brahianorrego/Talos-AI/04_VISOR_Y_MOTOR_GRAFICO/unreal/LICENCIAS.md

# Licencias de lo que se use en Unreal (el proyecto DronIA_Cancha NO está en el repositorio)

Todo contenido de Fab o de MetaHuman que se use se anota aquí con su licencia **leída en su ficha**, antes de usarlo.
Nada de eso se sube al repositorio público.

| Contenido | De dónde | Licencia (según su ficha) | Fecha |
|---|---|---|---|
| Formas básicas (cubo, cilindro, plano) | Motor Unreal 5.8 | Licencia del motor (EULA de Epic) | 2026-10-18 |
| Game Animation Sample Project | Fab (Epic Games) | _por anotar al bajarlo_ | |
| MetaHumans (ladrón y civil) | MetaHuman Creator de Unreal | _por anotar: términos de MetaHuman_ | |
| Roads 05 – Scanned Photogrammetry Materials (ScansMatter) | Fab | **CC BY 4.0** (dar crédito) | 2026-10-21 |
| Mobile Trees Pack 44 (Tree Master) | Fab | **CC BY 4.0** (dar crédito); respaldo, sin usar | 2026-10-21 |
| Megaplants: Black Alder y European Hornbeam, Uncut Grass (Quixel) | Fab / Megascans | Licencia estándar de Fab | 2026-10-21 |
| Pack Bonus Textures (Lord Enot Store), HighPoly Tree Model | Fab | por confirmar en la ficha; sin usar | 2026-10-21 |

Créditos listos para el documento: `docs/MATERIAL_PARA_DOCUMENTO/08_creditos_y_licencias_fab.md`.
