brahianorrego/Talos-AI/05_HARDWARE_Y_VARIANTES/VISTA_3D.html

# El pan-tilt de la variante H, casi real

Arrastra para girar, rueda para acercar, Mayús + arrastrar para mover. Las piezas impresas están diseñadas por nosotros (no se descargaron de ningún sitio) y aún no se han impreso. Los servos MG90D, la CSI IMX219 (medidas del dibujo oficial de Raspberry Pi) y el TF-Luna (ficha oficial) son ilustraciones: el cable flex dorado es solo una indicación. La base y su montaje en el dron dependen de medidas pendientes (ver piezas_3d/ESTADO_IMPRESION.md). El deslizador de cabeceo se detiene donde el pin de plástico choca con la ranura (−44° y +14°, regla dura 1) y el de giro donde la plataforma topa con los postes de la base (±89°).
