brahianorrego/Talos-AI/05_HARDWARE_Y_VARIANTES/COBERTURA.md

# Cobertura de las cámaras por variante

Análisis **geométrico** (sin simulación): qué ve cada variante a 3.30 m de altura, dónde queda ciega y qué pasa al mirar detrás de un panel de
2.25 m. Se regenera con `03_SIMULACION_RL\.venv\Scripts\python.exe analisis_cobertura.py` (lee los `config_sim/variante_*.json`). El campo
del IMX219 (62.2° × 48.8°) es **nominal, sin medir**; las alturas de cabeza (1.62 m) y torso (1.25 m) de una persona de 1.72 m son **estimadas**.

## Combinación de sensores a 1.7–2.6 m (21-oct; pedido de Brahian, `ORDENES_BRAHIAN_20OCT.md` §A y §E)

Dron a 1.7, 2.0, 2.6 y 3.30 m; persona de 1.72 m (torso a 1.25 m, estimado). Cámaras IMX219 62.2° × 48.8° (nominal); TF03 a −5° con haz de 0.5° (de memoria; alcance 30 m).

| Altura | Cámara del pan-tilt (tilt −45°): ciega bajo el dron hasta (suelo / torso) | CSI#2 **al piso**: huella en el suelo / a la altura del torso | CSI#2 **atrás −15°** (lado largo horizontal): ve el torso desde / el suelo desde | CSI#2 abajo-atrás −45°: torso entre / suelo entre | TF03 −5°: da en una persona de pie desde (cabeza / torso) y en un panel de 2.25 m desde |
|---|---|---|---|---|---|
| **1.7 m** | 0.64 m / 0.17 m | 2.1 × 1.5 m / 0.5 × 0.4 m | 0.55 m / 2.1 m | 0.1–1.8 m / 0.4–6.9 m | 0 m / 5.1 m · panel 0 m |
| **2.0 m** | 0.75 m / 0.28 m | 2.4 × 1.8 m / 0.9 × 0.7 m | 0.91 m / 2.4 m | 0.2–3.0 m / 0.5–8.1 m | 3.2 m / 8.6 m · panel 0 m |
| **2.6 m** | 0.98 m / 0.51 m | 3.1 × 2.4 m / 1.6 × 1.2 m | 1.6 m / 3.2 m | 0.3–5.5 m / 0.6–10.5 m | 10.1 m / 15.4 m · panel 4.0 m |
| **3.30 m** | 1.24 m / 0.77 m | 4.0 × 3.0 m / 2.5 × 1.9 m | 2.5 m / 4.0 m | 0.5–8.3 m / 0.8–13.3 m | 18.1 m / 23.4 m · panel 12 m |

- **Azimut:** el pan-tilt (±89° + 31.1°) cubre **240°** y deja **120°** atrás sin ver. Una CSI#2 **atrás** suma 62° y deja **57° ciegos** (dos cuñas de 29°, a ±150°); abajo-atrás o al piso no suman casi nada en azimut.
- **CSI#2 al piso sirve poco a esta altura:** a 2.0 m el torso solo cae en una huella de 0.9 × 0.7 m; solo protege lo que está justo debajo.
- **TF03 a −5° y 2.0 m no da en la persona hasta los 3.2 m** (antes el haz pasa sobre la cabeza); a 2.6 m, hasta los 10 m. Con paneles de 2.25 m **sí da** desde 0 m a 2.0 m. El frenado LiDAR (< 3 m) **no protege de personas** a 2.6 m: lo cubre la cámara y el árbitro.
- **TF-Luna** en el pan-tilt, siguiendo al ladrón a 4–6 m: con ropa clara (ρ≈0.5) ve hasta 6 m, **media** (ρ≈0.3) hasta 4.6 m, **oscura** (ρ≈0.1) solo hasta 2.7 m (interpolación mía sobre dos datos de hoja de datos). **No es fiable como única distancia**: la principal es la de la caja de YOLO + Kalman; el Luna confirma cuando hay retorno.

**Recomendación (una combinación):** **CSI#1 + TF-Luna en el pan-tilt; CSI#2 fija MIRANDO ATRÁS** (pitch −15°, lado largo horizontal, bajo la placa trasera); **TF03 frontal fijo a −5°**; volar a **2.0 m** de base (sube a 3.30 m solo con el ladrón cerca). Razones con números: cubre **302° de azimut** (contra 240°) con una cámara que a 2.0 m ve el torso desde 0.9 m; la del piso a 2.0 m ve 0.9 × 0.7 m y el pan-tilt ya cubre el suelo desde 0.75 m. El TF03 queda para paneles y obstáculos grandes (los ve desde 0 m a 2.0 m).
Posición provisional (sin medir) en `variante_H.json`: `CAM_TRASERA_ACTIVA`, `CAM_TRASERA_PITCH` (−15°), `CAM_TRASERA_AZIMUT` (180°), `CAM_TRASERA_PUERTO` (CAM1), `MONTAJE_CSI2_TRASERA_M` (−0.095, 0, −0.030 m); `CAM_PISO_ACTIVA` queda en `false`. **Riesgo:** una cámara que mira atrás ve patas, brazos y quizá hélices: probar el encuadre al montarla.

## Lo que dice, en sencillo (actualizado 2026-10-20, D-072)

**Hoy el dron es la variante G** (CSI fija a −5° + TF03 fijo, sin gimbal ni USB) **y la meta es la H** (pan-tilt con CSI + TF-Luna, TF03 fijo, segunda CSI al
piso). Las variantes A–F **quedaron descartadas** (usaban el gimbal o la USB) y se dejan solo como referencia.

**Actualización 2026-10-20 (pan libre):** la variante H mueve el **giro (pan) ±89°** y el cabeceo; el alabeo no existe. Cobertura horizontal y tiempo de apuntar:

| | **G (mínimo, fija)** | **H (plus, pan ±89°)** |
|---|---|---|
| Campo horizontal de la cámara (CSI) | 62.2° (nominal) | 62.2° |
| **Cobertura horizontal total** respecto a la nariz | ±31.1° = **62.2°** | ±(89 + 31.1)° = **±120.1° ≈ 240°** (queda ciega la parte de atrás, ≈ 120°) |
| Tiempo en apuntar a un objetivo a 90° de la nariz, **girando el dron** (`RATE_Y_MAX` = 120 °/s, `ATC_ACCEL_Y_MAX` = 180 °/s², de `control.py`) | ≈ 1.4 s (40° acelerando + 10° a velocidad + 40° frenando) | ≈ 1.4 s si solo gira el dron |
| Tiempo con **el pan** (servo ≈ 600 °/s, retardo 50–100 ms; est.) | — | **≈ 0.2–0.25 s**: unas 6 veces más rápido |

Lo que gana H al girar: puede **seguir a la persona sin girar el cuerpo del dron** (el dron puede seguir volando de frente o por su ruta) y **mirar de lado a los lados del panel** mientras avanza; el TF-Luna va con la cámara.
**Lo que no sabemos aún:** si las hélices, las antenas, las patas o la batería entran en el cuadro a pan grande (depende del montaje; ver `ESTADO_IMPRESION.md`), y el retardo real del servo. Con **pan 0° y tilt −5°** la cámara repite la orientación de G (el mínimo).

1. **G (hoy): anillo ciego.** Con la CSI fija a −5° (62.2° × 48.8° nominal), la cabeza de una persona de 1.72 m se ve **desde ~3.0 m** hacia afuera y el
   suelo **desde ~5.9 m**: una persona que se acerca a menos de 3 m sale del cuadro, y nada ve lo que hay debajo del dron.
2. **H (meta): sin anillo ciego.** La CSI en el pan-tilt baja hasta −45°: con el tilt libre ve la cabeza desde ~0.6 m hasta más de 15 m, y la segunda CSI al piso
   (−90°) cubre lo de justo debajo. Con el tilt fijo en −45° solo ve de 0 a 4.5 m: hay que ir cambiando el cabeceo según la distancia (para eso es el pan-tilt).
3. **Lo que sale del campo más ancho de la CSI** (62.2° × 48.8° contra 38.9° × 29.7° de la USB): se ve más de lado y más de arriba abajo, pero con menos
   píxeles por grado (el YOLO ve más chica a la persona lejana).
4. **Detrás del panel (2.25 m) desde 3.30 m:** de pie queda oculta de 2.4 a 3.0 m detrás, agachada de 4.4 a 5.5 m, gateando de 6.3 a 7.9 m (paneles a 4–5 m): lo
   decide la maniobra del dron, no las cámaras.

Las figuras `cobertura/cobertura_variante_G.png` y `_H.png` son las que importan; `_A` a `_F` son de las variantes descartadas.

Supuestos: dron a **3.3 m**; persona de pie de **1.72 m** (cabeza = centro a 1.62 m y torso = centro a 1.25 m: **estimados**); cámaras en el centro del dron; pitch táctico −45° donde el gimbal lo permite (A y B: −10°, el tope real de hoy); solo plano vertical (se ignora que el objetivo esté fuera del campo horizontal). Campos: USB HFOV 38.9° × VFOV 29.7° (medido); IMX219 62.2° × 48.8° (**nominal, sin medir**), con su lado largo a lo largo del vuelo.

### Tabla de cobertura vertical (distancias horizontales a las que alguna cámara ve el punto)

«Pitch fijo» = la cámara principal quieta en su pitch táctico. «Gimbal libre» = la cámara principal puede tomar cualquier pitch entre su tope bajo y +15° (lo que hace el seguimiento). La diferencia más importante entre variantes es **la distancia mínima**: con el tope bajo, A/B no ven la cabeza a menos de ~3.6 m y C-F sí desde ~1 m.

| Var. | Cámaras | Cabeza: pitch fijo | Cabeza: gimbal libre | Torso: gimbal libre | Suelo: ciego hasta |
|---|---|---|---|---|---|
| **A** | Principal USB (-10°) | 3.6–más de 15 m | 3.6–más de 15 m | 4.4–más de 15 m | 7.1 m |
| **B** | Principal USB (-10°) + Piso CSI (-90°) | 0.0–1.0 m; 3.6–más de 15 m | 0.0–1.0 m; 3.6–más de 15 m | 0.0–1.2 m; 4.4–más de 15 m | 0.0 m |
| **C** | Principal USB (-45°) + Piso CSI (-90°) | 0.0–2.9 m | 0.0–más de 15 m | 0.0–más de 15 m | 0.0 m |
| **D** | Principal USB (-45°) + Piso CSI (-90°) | 0.0–2.9 m | 0.0–más de 15 m | 0.0–más de 15 m | 0.0 m |
| **E** | Principal USB (-45°) + Piso CSI (-90°) | 0.0–2.9 m | 0.0–más de 15 m | 0.0–más de 15 m | 0.0 m |
| **F** | Principal USB (-45°) + Piso CSI (-90°) + Frontal ancha CSI (0°) | 0.0–2.9 m; 3.7–más de 15 m | 0.0–más de 15 m | 0.0–más de 15 m | 0.0 m |
| **G** | Principal CSI (-5°) | 3.0–más de 15 m | 3.0–más de 15 m | 3.6–más de 15 m | 5.9 m |
| **H** | Principal CSI (-45°) | 0.6–4.5 m | 0.6–más de 15 m | 0.8–más de 15 m | 1.2 m |

### Cámara al piso: huella a 3.30 m

- A la altura del suelo: ±1.99 m a lo largo del vuelo y ±1.50 m de lado (huella 3.98 × 2.99 m).
- A la altura del cabeza: ±1.01 m a lo largo del vuelo y ±0.76 m de lado (huella 2.03 × 1.52 m).
- A la altura del torso: ±1.24 m a lo largo del vuelo y ±0.93 m de lado (huella 2.47 × 1.86 m).

### Ancho lateral que ve la cámara principal (campo horizontal 38.9°)

- Pitch -45°, mirando al cabeza en el eje: distancia en línea recta 2.38 m → ancho 1.68 m.
- Pitch -45°, mirando al torso en el eje: distancia en línea recta 2.90 m → ancho 2.05 m.
- Pitch -10°, mirando al cabeza en el eje: distancia en línea recta 9.67 m → ancho 6.83 m.
- Pitch -10°, mirando al torso en el eje: distancia en línea recta 11.81 m → ancho 8.34 m.

### Mirar detrás de un panel de 2.25 m desde 3.30 m

Línea de vista desde la cámara que roza el borde de arriba del panel: hasta qué distancia DETRÁS del panel queda oculto cada punto.

| Postura (altura del punto) | Panel a 4 m | Panel a 5 m |
|---|---|---|
| De pie, cabeza (1.62 m) | 2.4 m | 3.0 m |
| De pie, torso (1.25 m) | 3.8 m | 4.8 m |
| Agachado (1.1 m) | 4.4 m | 5.5 m |
| Gateando (0.6 m) | 6.3 m | 7.9 m |

Para ver a alguien oculto hay que acercarse o subir; subir ya está permitido solo sin personas a menos de 8 m (altura segura 3.30 m).

## Panel de 2.25 m

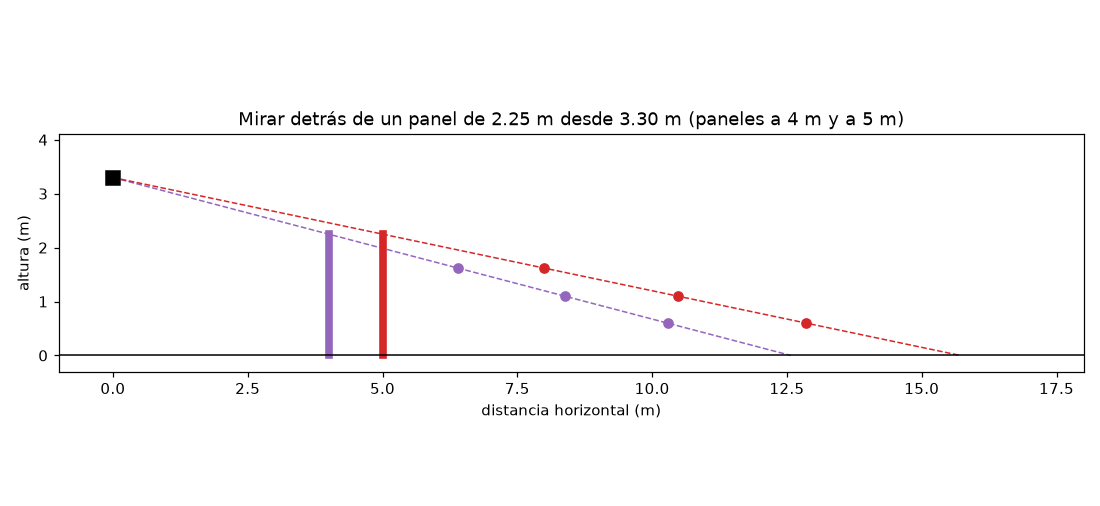
[picture p27: 05_HARDWARE_Y_VARIANTES/cobertura/panel_sombra.png]
Sombra del panel


## Figuras por variante

### Variante G

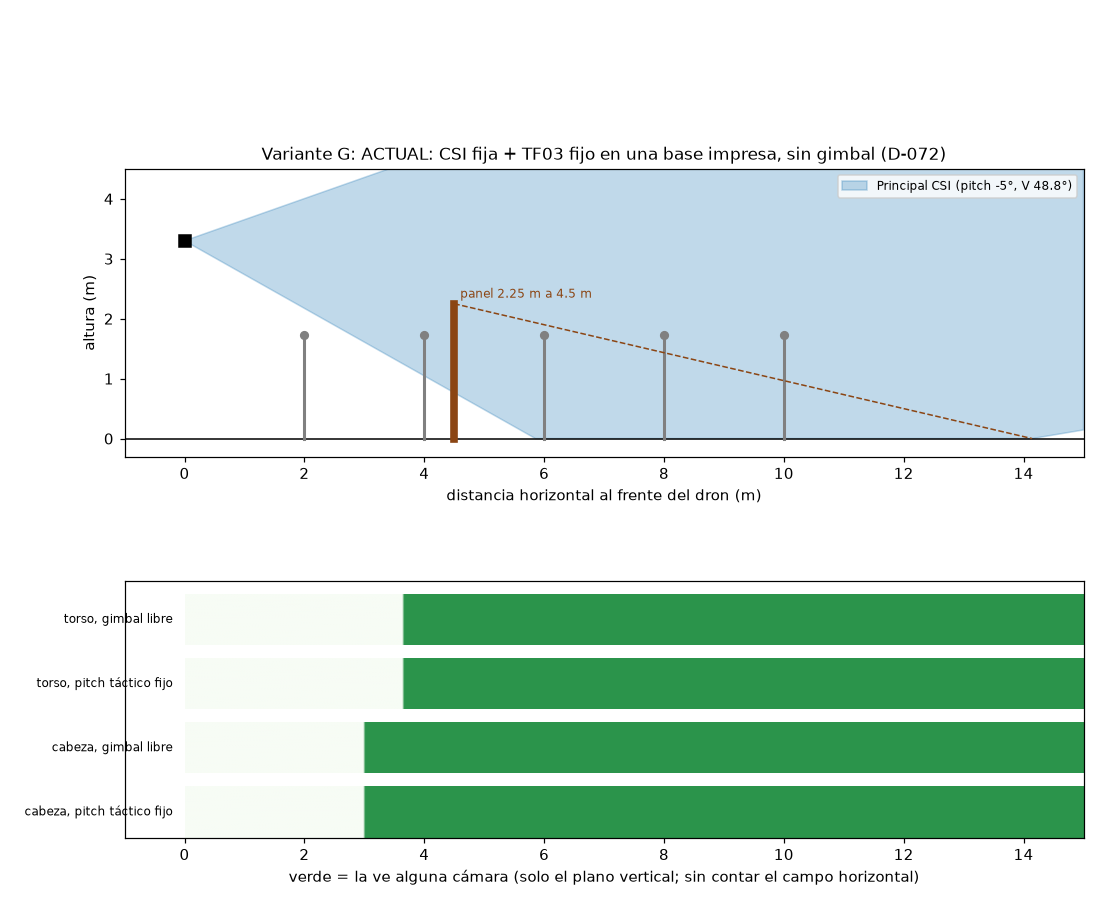
[picture p28: 05_HARDWARE_Y_VARIANTES/cobertura/cobertura_variante_G.png]
Variante G


### Variante H

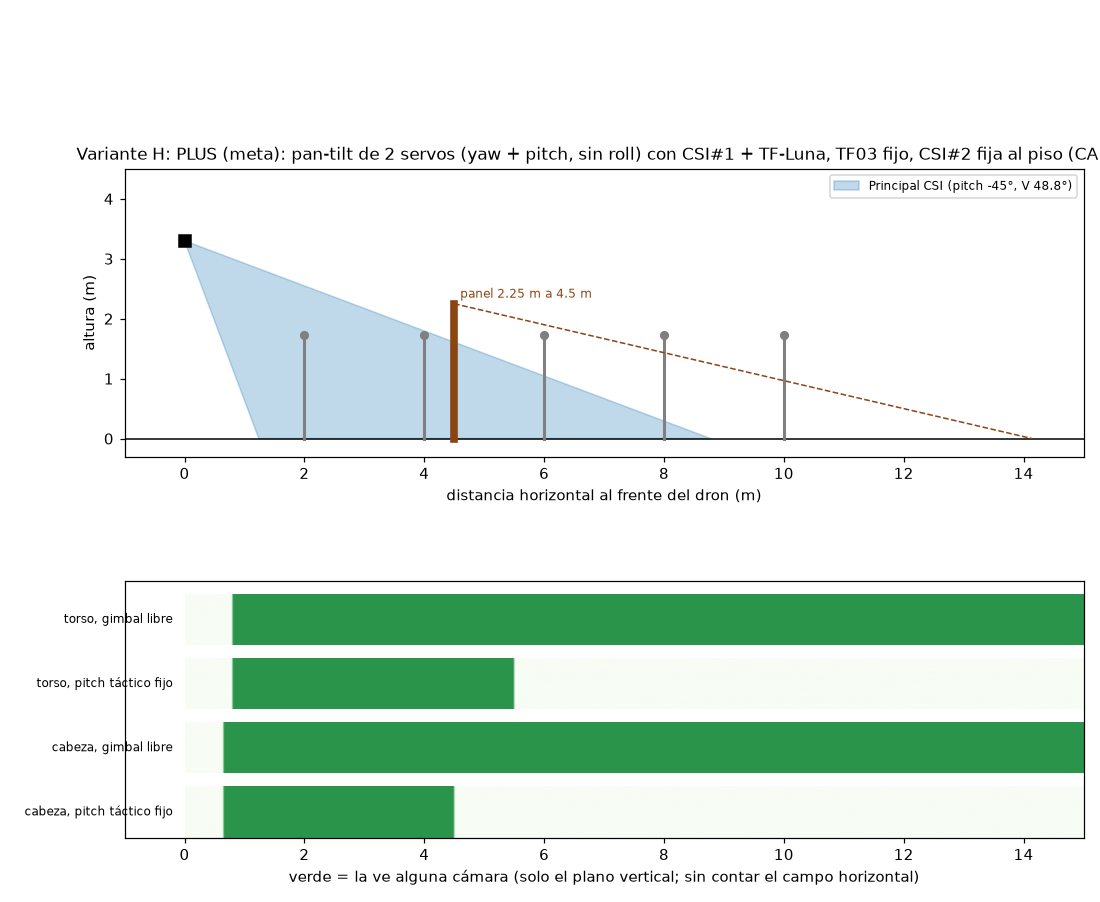
[picture p29: 05_HARDWARE_Y_VARIANTES/cobertura/cobertura_variante_H.png]
Variante H


### Variante A (descartada)

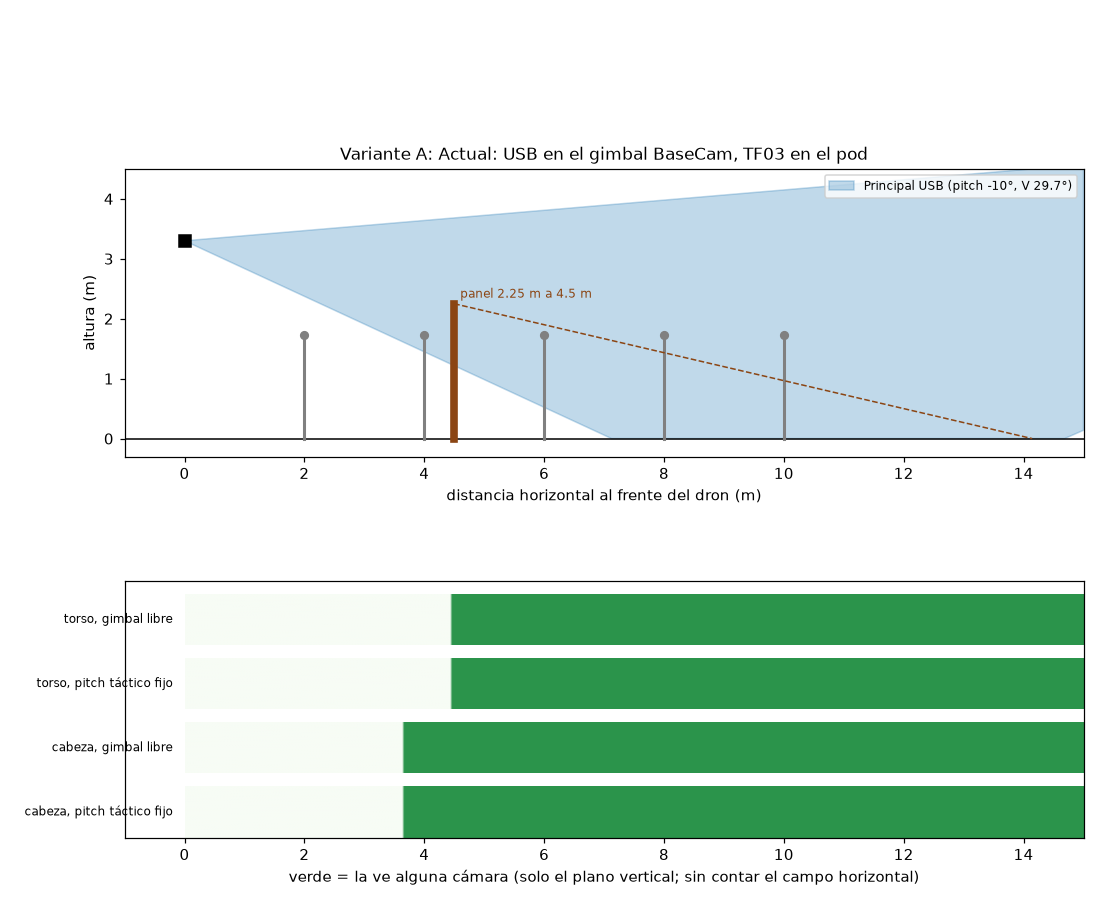
[picture p30: 05_HARDWARE_Y_VARIANTES/cobertura/cobertura_variante_A.png]
Variante A


### Variante B (descartada)

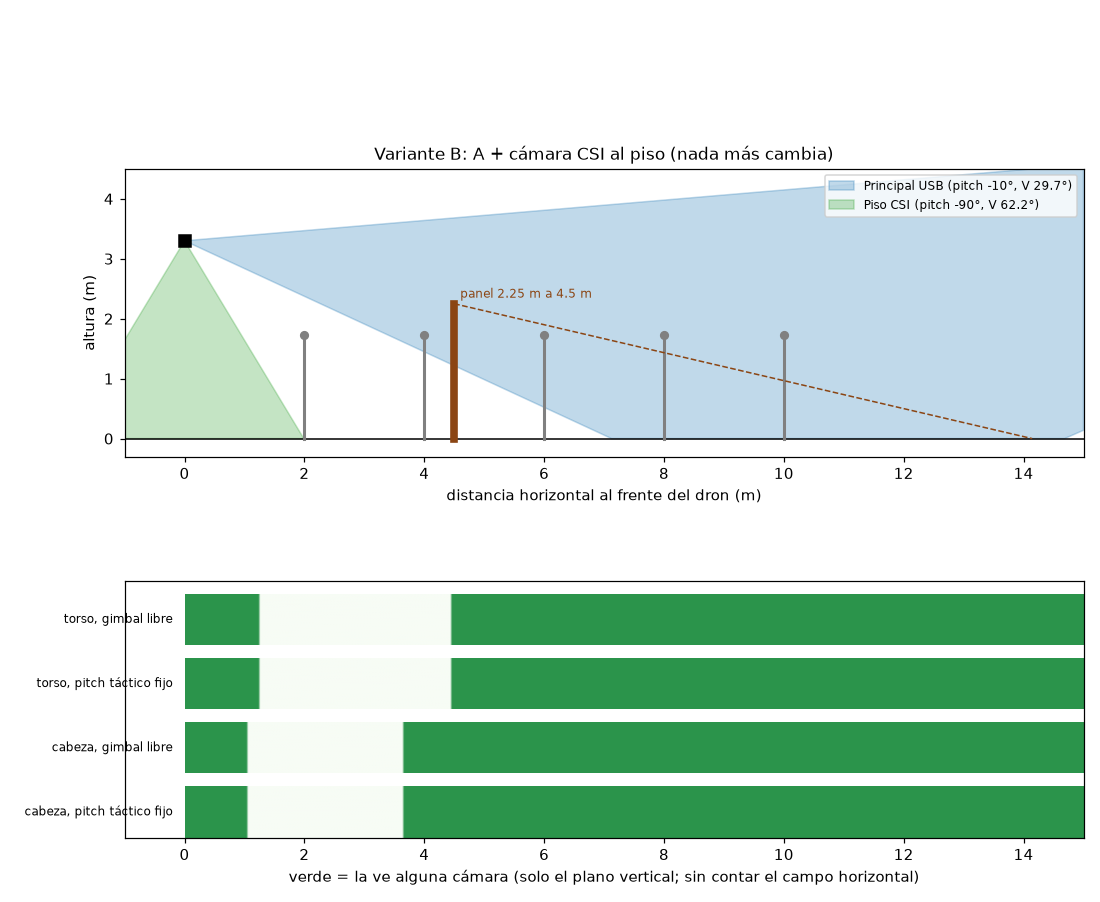
[picture p31: 05_HARDWARE_Y_VARIANTES/cobertura/cobertura_variante_B.png]
Variante B


### Variante C (descartada)

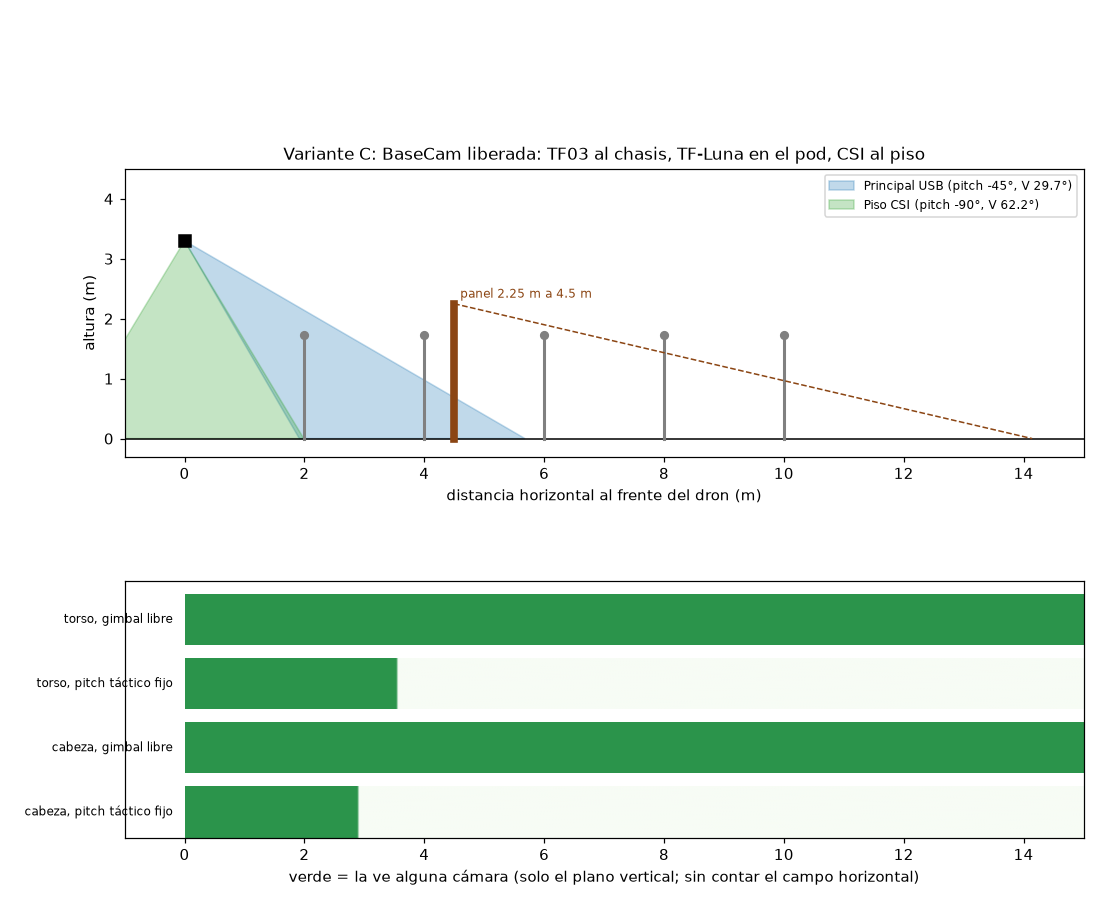
[picture p32: 05_HARDWARE_Y_VARIANTES/cobertura/cobertura_variante_C.png]
Variante C


### Variante D (descartada)

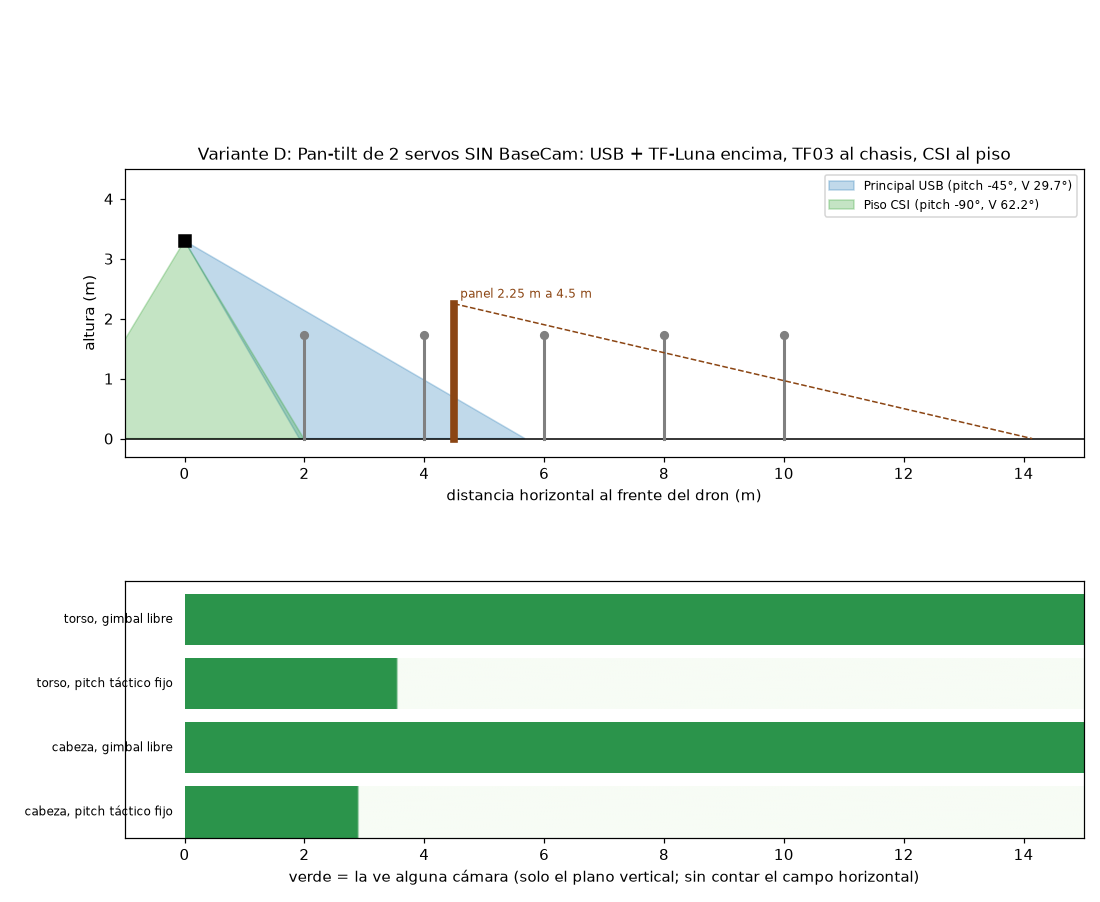
[picture p33: 05_HARDWARE_Y_VARIANTES/cobertura/cobertura_variante_D.png]
Variante D


### Variante E (descartada)

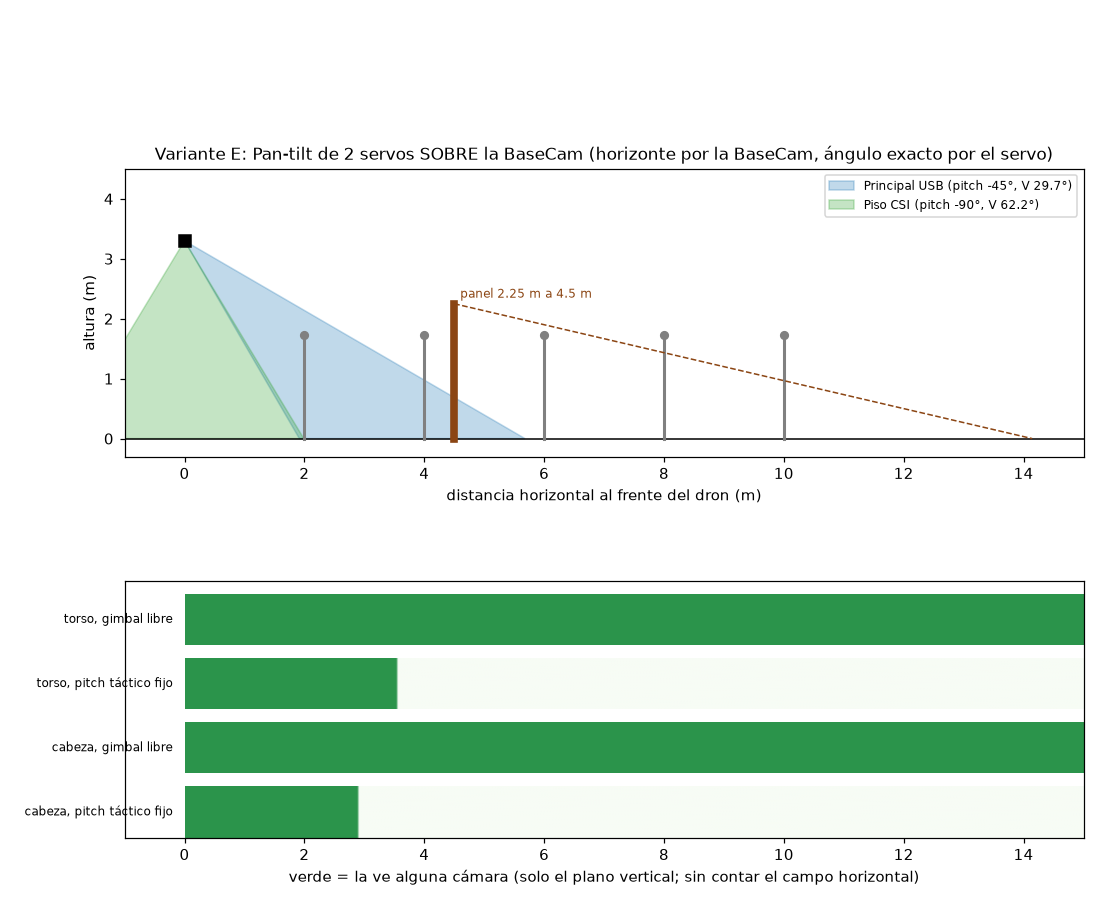
[picture p34: 05_HARDWARE_Y_VARIANTES/cobertura/cobertura_variante_E.png]
Variante E


### Variante F (descartada)

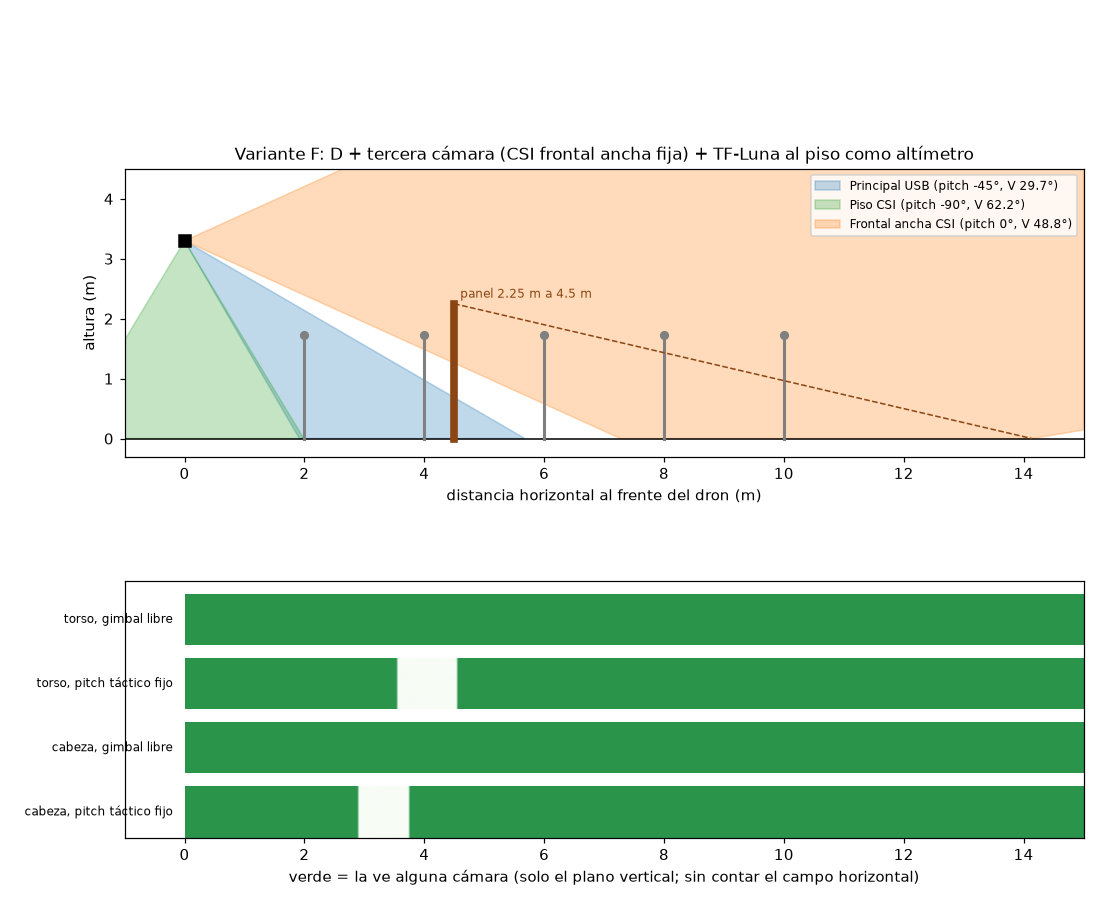
[picture p35: 05_HARDWARE_Y_VARIANTES/cobertura/cobertura_variante_F.png]
Variante F


## Lo que NO cubre este análisis

El campo horizontal, el desplazamiento de las cámaras respecto al centro del dron, el balanceo y el cabeceo del chasis, la oclusión por patas o hélices, el ruido y el desenfoque, ni el tiempo que tarda el pan-tilt en llegar al cabeceo (~600°/s el servo). Es el techo geométrico, no un resultado de vuelo.
