brahianorrego/Talos-AI/04_VISOR_Y_MOTOR_GRAFICO/_LEEME.md

# 04 · Visor y motor gráfico

**El visor que funciona hoy no está aquí:** es `03_SIMULACION_RL/index.html` (three.js) y se abre con
`03_SIMULACION_RL/ABRIR_VISOR.bat` en http://127.0.0.1:8765/. Se queda en la 03 porque lee
`salida/estado.json`, `salida/hitos/` y `minimo_tesis/replay/` por ruta relativa desde el mismo servidor.

| Qué | Dónde |
|---|---|
| **Plan del motor gráfico y de la interfaz de 3 modos** (Fase D1-D2) | `PLAN_MOTOR_GRAFICO.md` |
| Boceto de la estación de tierra | `boceto_interfaz.svg` (y `.png`) |
| Cuadros por segundo del visor V16 en el portátil, capturas y el script que mide | `mediciones/` |
| Visor V16 traído de las ramas `v16-visor` y `v16-simulacion` (en `main` desde el commit 3c38f66, aprobado por Brahian el 17-oct) | `v16/` (configuración `visor-v16` de `.claude/launch.json`, puerto 8766) |
| Visor vigente | `03_SIMULACION_RL/index.html` |
| Versiones anteriores (v4 a v19) | `_archivo_versiones/codigo/index_v*.html` |
| Visor de la cámara real (en la Jetson) | `02_JETSON_A_BORDO/visor_web.py` |
| Contrato de datos simulación → visor (`foto()`) | `docs/PLAN_V16_REALISMO.md` (fase A5) y `v16/docs/PROGRESO_V16.md` |

Para ver el V16 con la RTX: Chrome tiene que usar la gráfica NVIDIA (ver `PLAN_MOTOR_GRAFICO.md`, sección 2).

## Revisión de `v16/` para el repositorio público (2026-10-17)

Sin fotos de personas: las personas, el dron, los árboles y los escenarios se dibujan con código. No se carga nada de
internet (todo es local). Archivos que no son código:

| Archivo | Origen | Licencia |
|---|---|---|
| `recursos/three/` (three.js 0.185.1) | npm `three` | MIT (`recursos/three/LICENSE`) |
| `recursos/cielo/spruit_sunrise_1k.hdr`, `quarry_01_1k.hdr` | Poly Haven (Greg Zaal) | CC0 |
| `recursos/texturas/*.jpg` (12: concreto, pasto, tierra) | Generadas con ruido fractal por `herramientas/generar_texturas.py` | Propias (CC0) |
| `replays_prueba/*.json` | Repeticiones de prueba de la V16; llevan el nombre de Brahian como autor | Propias |

Fuente: `v16/simulacion/recursos/LICENCIAS.md`. El script que hizo las texturas está en `v16/simulacion/herramientas/generar_texturas.py`.

## Cancha V17 en el visor (D-057, 2026-10-17)

En `v16/`, escenario **"Vista previa · cancha V17, dos V de 90° (no entrenado)"** (`visor/previa.js`, `crearCancha`):
cancha de fútbol con líneas y arcos (90 × 60 m, **medidas por medir**), zona de IA de 30 × 30 m en el centro de la mitad
este (geocerca roja en la vista externa y en el mapa pequeño), dos V de 90° de paneles de exposición de 1.5 × 2.25 m (D-066; antes 1.0 × 2.0) con
bolsas de arena, vértices a 10 m (V1 abre al sur, V2 al norte) y árboles fuera de la cancha (≥ 10 m de la geocerca).
Escena de ejemplo: el ladrón agachado detrás de V1 se cambia a V2 y el civil cruza a 8 m. Fuente: `docs/PLAN_V17_REFUERZO.md`
§3.3 y D-051. Medido con la RTX: 144 cps y sin errores (`mediciones/medir_fps.mjs cancha`). Capturas:
`mediciones/capturas/v17_cancha_*.jpg`. Las fases de la misión (tránsito → CH7 → zona) y el estado "IA activada" esperan
los campos nuevos de `foto()` de la Simulación V17.

## Blender instalado (D-057, 2026-10-17)

- **Versión:** Blender 5.2.2 LTS (compilación d13f752e3b9c, 2026-09-15), Python 3.13.13 por dentro, importador FBX activo.
- **De dónde:** `download.blender.org/release/Blender5.2/blender-5.2.2-windows-x64.zip` (404 MB), versión portable
  (no pide administrador).
- **SHA256:** `3849d17a682cba006075aaa3f3597ecb5c9c30ec31035b2e092c53e40679b535`, igual al publicado en
  `blender-5.2.2.sha256` de la misma página.
- **Dónde quedó:** en la carpeta `Programas\Blender` del usuario (fuera del repositorio, 925 MB). Se abre con
  `blender.exe`; en consola: `blender.exe --background --version`.
- **Gráfica:** Cycles ve la RTX 3050 por OptiX y por CUDA (para renderizar el video con la tarjeta).

## Paquetes de Quaternius (CC0), bajados el 2026-10-17 con permiso de Brahian

Fuera del repositorio, en la carpeta `Programas\recursos_quaternius` del usuario (≈ 375 MB descomprimidos). Bajados de
la página oficial de cada paquete en `quaternius.itch.io` (versión gratis "Standard", sin cuenta). Cada uno trae su
licencia: **CC0 1.0** (dominio público). Se pueden usar y subir al repositorio, pero se dejan fuera por tamaño.

| Paquete | Qué trae (versión gratis) |
|---|---|
| Universal Base Characters | 2 cuerpos (hombre y mujer) con esqueleto de 65 huesos, 6 peinados, cejas; **sin ropa** (en ropa interior) |
| Universal Animation Library 1 | 43 animaciones: `Idle_Loop`, `Walk_Loop`, `Jog_Fwd_Loop`, `Sprint_Loop`, `Crouch_Idle_Loop`, `Crouch_Fwd_Loop`, `Jump_Start/Loop/Land`, `Roll`, `Interact`… |
| Universal Animation Library 2 | 43 más: `Idle_TalkingPhone_Loop`, `LayToIdle` (de acostado a de pie), `ClimbUp_1m`, `NinjaJump_*`, `Slide_*`, `Idle_FoldArms_Loop`, `Idle_Rail_Loop`… |
| Stylized Nature MegaKit | 68 modelos: árboles, arbustos, flores, piedras, pasto (glTF, FBX, OBJ) |

Todo usa el **mismo esqueleto**: las animaciones se ponen directo en los personajes (comprobado en Blender con
`blender/listar_anim.py`). Prueba de render con la RTX (Cycles + OptiX, 1280 × 720, 64 muestras, ~12 s en total):
`blender/prueba_render.py` → `mediciones/capturas/blender_prueba_quaternius.jpg`.

**Qué falta para las animaciones de la sección 4 de `PLAN_MOTOR_GRAFICO.md`:** gatear, recostarse contra el panel,
rendirse (manos arriba) y grabar con el celular no vienen en la versión gratis (hay parecidas: `LayToIdle`,
`Idle_Rail_Loop`, `Idle_TalkingPhone_Loop`); se arman con código sobre los mismos huesos. **Falta ropa:** sugerencia,
el paquete gratis CC0 "Ultimate Modular Characters" de Quaternius (personas vestidas); no se bajó porque no estaba en
lo autorizado.

### Personas vestidas: Ultimate Modular Characters (CC0, bajado el 2026-10-17 con permiso de Brahian)

- **De dónde:** carpeta pública de Google Drive que enlaza la página oficial `quaternius.com/packs/ultimatemodularcharacters.html`;
  licencia CC0 1.0 (`License.txt`). Se bajaron los 11 personajes en glTF (Adventurer, Beach, Casual_2, Casual_Hoodie,
  Farmer, King, Punk, Spacesuit, Suit, Swat, Worker; 35 MB) a `recursos_quaternius\ultimate-modular-characters\`.
- **Traen 24 animaciones propias** (Idle, Walk, Run, Roll, Wave, Interact…), pero **otro esqueleto** (62 huesos, piernas
  con IK) que no coincide con el de la Universal Animation Library (1 hueso en común).
- **Redirección:** `blender/redirigir_animaciones.py` pasa las animaciones de la librería a estos personajes (giro de cada
  hueso en el mundo × la diferencia entre las poses de referencia; IK apagado). Ya están pasadas **41**: 23 de la UAL1 en
  `recursos_quaternius\animaciones_UMC_UAL1.blend` y 18 de la UAL2 en `animaciones_UMC_UAL2.blend` (terminan en `_UMC`).
  Unos 10 s por librería.
- **Prueba:** `blender/prueba_vestidos.py` → `mediciones/capturas/blender_prueba_vestidos.jpg` (correr, agachado junto
  al panel, salto). Revisado a ojo en un cuadro; falta ver las animaciones en movimiento (pies que patinan, manos).

Nota: `descarga.zip` (15.9 MB), que apareció en la raíz del proyecto el 17-oct a las 9:04, era una copia repetida de la
Universal Animation Library [Standard]. La bajó el navegador interno cuando se probó el botón "Download" de itch.io. Se
movió a `recursos_quaternius\_duplicados\` (no se borró) y no entró a Git.

## V2 · Personas vestidas en el visor (2026-10-17)

- `v16/simulacion/visor/personas_gltf.js` (`FiguraGLTF`): misma interfaz que `Humano`, con los modelos y animaciones de
  `v16/simulacion/recursos/personas/` (4.4 MB, CC0; los exporta `blender/exportar_personas_glb.py`). El ladrón es
  `Casual_Hoodie`; los civiles, `Worker`, `Casual_2`, `Suit` y `Farmer` según su ID.
- Animación según la postura de `foto()`: de pie (quieto, caminar, trotar, correr, acelerando con la velocidad),
  agachado (quieto o avanzando), recostado (brazos cruzados), salto (impulso, aire, caída) y civil grabando (celular).
  **Gatear usa por ahora la marcha agachada** (no hay animación de gateo gratis).
- Para ver las figuras de antes (hechas con código): `http://127.0.0.1:8766/?personas=codigo`.
- Medido con la RTX en la cancha V17: 126 cps (con el render de Blender usando la misma tarjeta), sin errores; las cajas
  de YOLO se ajustan a las personas nuevas.

## V6 · Video de la cancha V17 en Blender (2026-10-17)

- `blender/video_cancha_v17.py` arma la escena (cancha, V de 90°, árboles, arbustos y matas de pasto de Quaternius,
  dron, ladrón y civil con la coreografía de la vista previa "cancha") y renderiza con Cycles en la RTX, cuadro por cuadro
  (si se corta, se relanza y sigue). `blender/unir_video.py` une los cuadros en MP4.
- Medido: ~28 s por cuadro a 1920 × 1080 con 32 muestras (el video completo de 80 s serían ~15 h). Se renderiza el
  tramo de 20 a 60 s a 1280 × 720 (~3-4 h), fuera del repositorio, en la carpeta `Videos\dron_ia` del usuario.

## V4 · Interfaz de 3 modos (2026-10-17)

Pestañas arriba a la derecha (o teclas **1**, **2** y **3**; la **I** abre y cierra ingeniería), y el modo elegido se
recuerda. Boceto: `boceto_interfaz.svg`. Capturas: `mediciones/capturas/v4_modo_*.jpg`.

| Modo | Qué muestra |
|---|---|
| **1 Dron** | Cámara del dron con YOLO, cámara al piso, espacio para la cámara USB (solo si la variante la lleva), **mapa de puntos del LiDAR** (impactos del TF03 en naranja y del TF-Luna en azul, acumulados; los viejos se apagan) y **órdenes de la Jetson**: quién manda, vx/vy/vz, giro, gimbal en grados y en PWM de AUX1, altura pedida, modo de ArduPilot y 10 s de historial (`visor/vista_dron.js`) |
| **2 Tierra** | La estación del operador, como antes: cámara grande con el clic de confirmación, vista externa, cámara al piso, mapa y telemetría |
| **3 Ingeniería** | Vista externa grande con el panel de estados, árbitro, personas, recompensa y bitácora |
| **clásico ↗** | Abre el visor de siempre (`03_SIMULACION_RL`, en el puerto 8765 con `ABRIR_VISOR.bat`) |

**Pendiente de la simulación:** las repeticiones no traen la nube de puntos ni las órdenes. La nube se arma acumulando
`lh`/`luna`, y las órdenes se **aproximan con la telemetría**, y así lo dice la pantalla. Cuando `foto()` traiga `cmd`
y `arb` (encargo a Simulación V17), `vista_dron.js` ya usa `cmd` sin más cambios. Medido con la RTX: 73-85 cps en la
partida `sim_v16_semilla3` a 4× (con el render de Blender en la misma tarjeta), sin errores.

## V3 · Árboles y pasto de verdad en el visor (2026-10-17)

- `v16/simulacion/visor/naturaleza.js`: los árboles hechos con código (misión, campo y cancha) se cambian por 4 árboles
  del "Stylized Nature MegaKit" de Quaternius (CC0) en las mismas posiciones, y se siembran 22 000 matas de pasto en
  60 × 60 m alrededor de la zona. Todo con instancias. Recursos: `v16/simulacion/recursos/naturaleza/` (2 MB).
- Para ver los árboles de antes: `?naturaleza=codigo`.
- **Medido con la RTX, sin tope de pantalla** (misión de prueba, 1540 × 788): alta 134 cps, media 184, baja 258; cancha
  V17 con tope: 128 cps. Meta ≥ 60: cumplida. Sin errores. Capturas: `mediciones/capturas/v3_*.jpg`.
- Se probó el arbusto `Bush_Common` y se quitó: su textura es de hojas rojas de otoño.
- Shortcut: los árboles nuevos no tapan a las personas en la prueba de visibilidad de la vista previa (sería muy lenta con
  hojas detalladas); si hiciera falta, usar cilindros simples para esa prueba.

## V5 · Simulación en vivo (2026-10-17)

- **Cómo verla:** doble clic en `ABRIR_EN_VIVO.bat` (abre la simulación, el visor y Chrome en `?r=vivo`). O a mano:
  `03_SIMULACION_RL\.venv\Scripts\python.exe 04_VISOR_Y_MOTOR_GRAFICO\en_vivo.py` y, en el visor, la repetición
  "Simulación en vivo".
- `en_vivo.py` corre una partida del entorno de `03_SIMULACION_RL` (solo lo importa, no lo cambia) a tiempo real y manda
  cada `foto()` al navegador apenas ocurre (Server-Sent Events, solo biblioteca estándar, puerto 8767). Al terminar
  una partida empieza otra con la semilla siguiente. Opciones: `--nivel` (por defecto el de la V17), `--semilla`,
  `--velocidad` y `--politica modelos/dron_politica.json` (si no, acción 0: deciden las reglas). Mientras no haya una
  política V17 entrenada, lo honesto es mostrar las reglas.
- En el visor (`datos.js` → `conectarVivo`, `principal.js`), la partida crece con cada cuadro y la imagen va un cuadro
  detrás del último. Probado: 126 cps con la RTX, sin errores; la pestaña "1 Dron" muestra `cmd` y `arb` reales.
  Captura: `mediciones/capturas/v5_en_vivo_dron.jpg`.

## Regla dura 4 en la pantalla (revisión del Arquitecto, punto 9; 2026-10-17)

Debajo de la caja de YOLO del candidato se lee quién decide: **"Esperando confirmación del operador"** (amarillo), **"¿Es
el sospechoso? clic aquí"** cuando la repetición espera el clic, y **"Confirmado por el operador"** (verde) después; si el
clic lo dio el operador simulado (modo automático o en vivo), dice **"(simulado)"**. La IA nunca aparece como quien
confirma. Captura: `mediciones/capturas/regla4_esperando_operador.jpg`.

## D-065 · El visor web vuelve al aspecto de la V16 (2026-10-17)

Brahian rechazó el aspecto de Quaternius. **Por defecto** el visor usa otra vez las personas, los árboles y el cielo de la
V16. Quaternius quedó como opción apagada, sin borrar nada: `?personas=quaternius` y `?naturaleza=quaternius`. El mundo
realista pasa a Unreal Engine 5 (`PLAN_UNREAL.md`).

## D-065 · Estación de tierra con paneles movibles (2026-10-17)

Es la interfaz que irá en la Jetson. **Se abre con `ABRIR_EN_VIVO.bat`**: arranca la simulación en vivo (8767), el
servidor de la estación (8768) y Chrome en http://127.0.0.1:8768/.

- **Base:** una copia del visor clásico (`03_SIMULACION_RL/index.html`, que no se tocó) en `estacion/index.html`, con
  todas sus pantallas: telemetría, estados de búsqueda, mapa SLAM, objetivo/tracker, decisión, árbitro, cámara FPV con
  HUD y YOLO, entrada de control, osciloscopio de entrenamiento, dominio táctico, estado, bitácora y reproductor.
- **Ventanas** (`estacion/ventanas.js` y `ventanas.css`): cada panel se mueve arrastrando su título, cambia de tamaño
  con la esquina de abajo a la derecha, se minimiza (–), se maximiza (□) y se cierra (×). Los cerrados se vuelven a abrir
  en **Paneles ▾**, que también tiene **Restablecer distribución**. La distribución se guarda en el navegador. La
  primera vez, los paneles que no caben en la pantalla arrancan minimizados.
- **Vistas** (botones arriba o teclas 1, 2 y 3): **Solo 3D** (el mundo y el reproductor), **Solo lo que ve el dron** (la
  cámara del dron con YOLO y su HUD en grande, sobre negro, como se verá en vuelo) y **Todo**.
- **En vivo:** la primera opción de la lista es "En vivo · en_vivo.py"; también se pueden ver las repeticiones del
  entrenamiento y del mínimo, como en el clásico (el servidor las lee de `03_SIMULACION_RL` sin tocarla).
- **Sin internet:** three.js 0.128, sus controles y las tipografías 3D están en `estacion/lib/` (MIT, ver `lib/LICENSE`).
  Se quitaron Google Fonts y Tailwind (usa las letras del sistema).
- Probado en Chrome con la RTX en vivo, sin errores. Capturas: ahora `mediciones/capturas/estacion_modo_*.jpg` (esta versión con ventanas fue reemplazada por los modos fijos).
- Textos: "estación de tierra · proyecto de grado" (el clásico decía "Tesis").

### Pedidos de Brahian para la estación (17-oct, noche)

1. **Solo la misión V17.** La lista tiene "En vivo · misión V17" y, de cada corrida `salida_v17_*` del entrenamiento, su
   última partida y sus hitos (el servidor las lista en `/corridas.json`, la más reciente primero). Se quitaron los
   niveles 0-4, la "misión completa" vieja, el mínimo y `salida/` de la V15. El osciloscopio de entrenamiento lee la
   corrida V17 más reciente. En la telemetría, "Currículo" y "Nivel" se cambiaron por "Fase de la misión".
2. **Paneles que se retraen, se minimizan y se guardan:** botón – o doble clic en el título; la distribución se recuerda.
3. **El mapa SLAM a la izquierda**, junto a la cámara y el control: arranca como recuadro sobre la vista del dron (abajo
   a la izquierda); la columna izquierda tiene la vista 3D y la entrada de control.
4. **Barra de arriba:** el nombre de Brahian una sola vez; **se quitó el "Dominio táctico" 32/68** (datos viejos de la
   V15) y en su lugar está el panel **"Custodia del ladrón"**: % del tiempo viéndolo en la partida, tiempo, racha actual
   y mejor racha.
5. **Cámaras cine, seguir, libre y cenital:** se conservan (en el reproductor).
6. **Vista principal intercambiable:** por defecto, **lo que ve el dron** en el centro, con el mapa SLAM superpuesto.
   El botón **⇱** de la cámara, del mapa o de la vista 3D la pone en la pantalla principal, y la que estaba ahí pasa a su
   recuadro. "Solo 3D" y "Solo lo que ve el dron" dejan la principal a pantalla completa.

Probado en Chrome con la RTX en vivo: 111-144 cps, sin errores. Capturas: reemplazadas por `estacion_modo_*.jpg` (modos fijos, abajo)

### Estación con modos fijos (pedido de Brahian, 17-oct, noche)

Brahian no quería ventanas sueltas ("puede empezar a cerrar pestañas y ya se cierran todas y qué hago"). Se cambiaron
`ventanas.js/css` por **`modos.js/css`**: cinco pantallas ya organizadas, con botones arriba (o teclas 1 a 5), que no se
pueden desordenar. Cada modo pone los paneles que necesita y guarda los demás; el modo elegido se recuerda.

| Modo | Qué se ve |
|---|---|
| **Cámara del dron** (por defecto) | La cámara con YOLO a pantalla completa; encima, en las esquinas de la imagen, la telemetría, la custodia del ladrón y el mapa SLAM |
| **Simulación 3D** | El mundo 3D con la cámara, el control y el mapa a la izquierda y el análisis a la derecha; **"Ocultar paneles"** deja solo la simulación y el reproductor |
| **Mapa** | El mapa SLAM grande e **interactivo**: rueda = acercar o alejar, arrastrar = mover, doble clic = centrar. La geocerca es la de la V17 (30 × 30 m) |
| **Ingeniería** | Estados de búsqueda, lógica de decisión, tracker, árbitro, custodia, telemetría y entrenamiento alrededor del 3D |
| **Vuelo real** | La pantalla del operador con el dron de verdad: cámara grande, **Conexión** (Jetson, Pixhawk, mando, batería; hoy dice "simulación"), telemetría, mando del piloto, árbitro y mapa |

- **Confirmación del operador:** cuando una repetición espera el clic (Operador · MANUAL), sale un aviso grande con el
  botón **"Confirmar sospechoso"**, que funciona en cualquier modo. Antes la pantalla parecía congelada.
- Capturas: `mediciones/capturas/estacion_modo_*.jpg`. Probado en vivo en Chrome con la RTX, sin errores.

## Unreal Engine 5.8 · fase 1 hecha (2026-10-18)

Unreal 5.8.3 instalado por Brahian. Claude creó el proyecto `DronIA_Cancha` (Blueprint, con Python, Sequencer, Movie Render
Queue, MetaHuman y Remote Control activados) sin abrir el editor, y escribió los scripts de `unreal/` (ver `unreal/_LEEME.md`):
la cancha con las V de 1.5 × 2.25 m, la conversión de cualquier repetición V17 en secuencia y el render a 1080p. Probado de
punta a punta: repetición → secuencia (721 cuadros) → 24 cuadros PNG → MP4. Captura: `mediciones/capturas/unreal_prueba_cuadro240.jpg`
(personas = cilindros, provisional). **A Brahian le quedan 4 pasos: `GUIA_BRAHIAN_UNREAL.md`.**

## El dron real en el modelo 3D (2026-10-18)

`modelo_dron/` tiene el dron de las fotos de Brahian (77 piezas, proporcionado, con sus medidas pendientes anotadas en
`modelo_dron/_LEEME.md`). Ya lo usan Unreal, el video de Blender y el visor V16. Pendiente: la estación de tierra.

## El campus de la universidad en un solo entorno (2026-10-18)

Pedido de Brahian con las fotos y mediciones de Google Earth (`08_EVIDENCIA_Y_DIAGRAMAS/privado/sitio_universidad/`, carpeta
privada): todo en un entorno, con la cancha de fútbol, la cancha cerrada y los alrededores, y una tecla para volar entre las dos.

- **Especificación única:** `entorno/entorno_u.py` → `entorno_u.json` (medidas, no fotos): cancha de fútbol de 67 × 102 m (6 822 m²,
  medida), cancha de tenis de 19.5 × 36 m (695 m², medida) y la múltiple, coliseo, laboratorio, parqueadero con 40 autos, 4 bloques
  de apartamentos al norte, 2 al este, 5 torres, vías, cercos de malla, un muro oscuro al este de la cancha, el motor de avión de
  la exhibición, 333 árboles y 8 cerros. El origen es el centro de la zona de IA (30 × 30 m, en la mitad norte de la cancha).
  **Las posiciones salen de las imágenes de satélite: son aproximaciones, por medir.**
- **Estación web** (`estacion/universidad.js`): lo construye con texturas dibujadas por código (césped con franjas de corte y
  líneas, ladrillo con ventanas, malla de cerco). **Tecla T** (o el botón "✈ Canchas (T)"): la cámara sube, cruza y baja entre la
  cancha de fútbol y las canchas cerradas en 7 s, y queda en cámara libre. Con `?entorno=arena` se ve la arena blanca de antes.
- **Pruebas** (`pruebas/test_entorno_u.py`): las áreas coinciden con Google Earth, la zona de IA cabe dentro de las líneas, ningún árbol
  a menos de 10 m de la zona (D-051) ni sobre canchas, edificios o la cancha, y las dos vistas del vuelo.
- Capturas: `mediciones/capturas/universidad_*.jpg`.
- **Qué falta:** mismo entorno en Unreal (`unreal/`, lee el mismo JSON), medir con cinta las canchas, y los detalles de los edificios
  reales (ventanas, colores, la cubierta del coliseo).

## Misión completa, vista del dron con tres cámaras y ruta de búsqueda (2026-10-19)

- **Misión completa de punta a punta** (`entorno/mision_completa.py` → `estacion/mision_completa.json`, fuera de Git; opción "Misión completa" del
  selector de la estación): despegue en el helipuerto del extremo sur de la cancha, **tránsito** con el piloto (3 m/s) y el mínimo vigilando,
  **activación** con el interruptor CH7 en la zona y **zona de IA** con una partida V17 completa (por omisión `salida_v17_2`; otra: pasar su
  ruta). En el tránsito hay un panel (el mínimo frena, sube a 3.30 m y el piloto lo pasa por arriba), un árbol (frena; el piloto lo rodea) y una
  persona que cruza (frena y espera); tras cada frenada el operador da REANUDAR. Las reglas y los números salen de
  `01_MINIMO_INDISPENSABLE/minimo_tesis/sistema.py` (solo lectura): es una versión cinemática y sin ruido de esa lógica, no una medida nueva.
  Letreros de fase en pantalla con las fichas "MÍNIMO" y "CH7". Pruebas: `pruebas/test_mision_completa.py`.
  En Unreal: `importar_repeticion.py ../estacion/mision_completa.json` (8 269 cuadros con maniquíes, árbol y helipuerto); los letreros salen de
  `estacion/mision_letreros.json` y se escriben sobre el video con `blender/unir_video.py <cuadros> <salida.mp4> 24 <letreros.json>`.
- **Vista del dron** (antes "Cámara del dron", tecla 1): tres cámaras como paneles que se encienden y se apagan (botones de arriba o las teclas
  U, F, G, L): USB principal (la de siempre), **CSI CAM1 frontal ancha** (0°, HFOV 62.2°) y **CSI CAM0 al piso** (−90°, HFOV 62.2°); es la variante
  F de `05_HARDWARE_Y_VARIANTES`; el HFOV de las IMX219 es nominal, sin medir. Las cajas de YOLO de las CSI son **simuladas** (persona dentro del
  campo, a menos de 30 m y sin panel en medio). Más el **LiDAR 360°**: mapa de puntos con el haz inclinado (−10° por omisión; se elige en el
  panel), calculado con la geometría de la escena; el TF03 real es de un solo haz, esto es lo que armaría uno que girara. Código: `estacion/camaras.js`.
- **Ruta de búsqueda de Brahian** (`docs/RUTA_BUSQUEDA_BRAHIAN.md`, D-071): `entorno/ruta_busqueda.py` la calcula sobre los paneles de la partida
  (entrada con giro de 360°, detrás de cada V a 4.5 m, cuadrado de 6.1 m, de frente a la boca con el vaivén de ±30°, a 3.30 m) y la estación la
  dibuja como línea, puntos de paso y abanico (botón "Ruta (R)"; los puntos se ponen verdes cuando el dron pasa a menos de 1.5 m); Unreal la dibuja
  igual (carpeta `Repeticion/Ruta`; `DRONIA_SIN_RUTA=1` la quita). Es el recorrido ideal que enseña el maestro B5: cuando Simulación grabe repeticiones
  con la ruta, se verá cómo la sigue. Pruebas: `pruebas/test_ruta_busqueda.py`.
- La estación normaliza la `fase` de la V17 (texto "zona") a los números 1 (piloto) y 2 (IA) que usa el visor.

## D-072 / D-073 · Dos drones: el mínimo (CSI fija) y el plus (pan-tilt) (2026-10-20)

- **Modelo 3D** (`modelo_dron/dron_real.py`): `minimo` (variante G: el dron de hoy, fotos 19 a 23: CSI fija arriba de la caja con su flex dorado en lazo, **TF03 fijo en el
  lado derecho** a la altura de las placas, estructura impresa volteada bajo el chasis sobre el frente de la batería), `plus` (variante H: **pan-tilt de 2 servos** con
  solo la CSI#1 y el TF-Luna encima, **CSI#2 fija al piso**, TF03 fijo donde está) y `gimbal` (el de antes, historia). `DRONIA_DRON=minimo|plus|gimbal` (Unreal: por omisión
  plus; Blender: minimo) o `?dron=` en la estación. **Las posiciones del pan-tilt, de la CSI del piso, del TF03 y de la batería (corrida 10 mm atrás) las lee `dron_real.py` de
  `05_HARDWARE_Y_VARIANTES/config_sim/variante_H.json` (campos `MONTAJE_*`, que Hardware marca PROVISIONALES: nadie ha medido el dron).** El **pan-tilt va ARRIBA por omisión** (opción 1 de Hardware, la recomendada: sobre la placa de arriba, delante de la caja de la Jetson, corrido 15 mm hacia adelante para no tocarla,
  con la plataforma "arriba" de `pan_tilt_servos.scad`); la opción 2, COLGADO bajo el chasis, se ve con `DRONIA_PAN_TILT=abajo` (Unreal y Blender) o `?pantilt=abajo` (estación). Rangos del plus: pan ±89°, tilt −44°…+14°.
- **Estación**: por omisión se ve el dron del **plus**; el botón "Dron: Plus / Mínimo" (arriba, junto a "Ruta") muestra el del mínimo. En el **tránsito** de la misión
  completa el pan-tilt está **parqueado en pan 0° / tilt −5°** (la cámara fija del mínimo; cartel "PARQUEADO 0° / −5° (TRÁNSITO)"); en la **zona de IA** la "Vista del dron" muestra
  la CSI#1 con "PAN ±x° · TILT ±y°" y la **CSI del piso**, y el modelo 3D mueve sus dos servos con la partida (`c.gmb` = tilt; `c.pan`, hoy 0: lo traerá `foto()` cuando Simulación
  implemente la H). En **Mínimo**: solo la CSI fija (HFOV 62.2° nominal, −5°) con el cartel "CÁMARA FIJA · SIN GIMBAL". Teclas P (principal), G (piso, solo plus) y L (LiDAR 360°).
  En Unreal, `importar_repeticion.py` mueve los actores `Dron_rep_pan` y `Dron_rep_tilt`. `?camara=gimbal` devuelve la cámara USB de antes.
  **Ojo:** la V17 todavía modela una cámara con gimbal y HFOV 38.9°; las cajas de YOLO de la principal siguen su campo angosto hasta que Simulación cambie el sensor.

## Estación del mínimo (21-oct)

`estacion/minimo.html` (+ `minimo.js`, `minimo.css`): la misma interfaz TALOS-AI (`operacion.css`) conectada a la **Jetson real** del mínimo: video MJPEG, LiDAR, YOLO, batería/Pixhawk, registro de eventos y el **control de tomas E0-E6** del panel de campo. El servidor de la estación (`estacion/servidor.py`) reenvía `/jetson/...` al panel de la Jetson (variable `DRONIA_JETSON`, por defecto `talos-jetson.local:8080`), así la página usa un solo origen. Se abre con `ABRIR_ESTACION_MINIMO.bat` (también hay una copia en el Escritorio). El panel de la Jetson (`http://talos-jetson.local:8080`) sigue funcionando igual y es el respaldo. Incluye mapa GPS (esquina, clic = grande; teselas con caché en `estacion/mapa/teselas`), inclinación, velocidades, GPS, sonido del portátil y un buscador de la Jetson en la red (`/jetson_buscar`). Los botones **Calibrar montaje** y **Alinear LiDAR** abren las páginas de la Jetson dentro de la estación (el servidor reenvía `/calibrar`, `/alinear`, `/video`, `/datos`, `/toma/...`).
