brahianorrego/Talos-AI/docs/DECISIONES.md

# Decisiones de diseño

Cada decisión lleva fecha, el motivo y las alternativas descartadas. Lo más reciente abajo.
Las marcadas **ABIERTA** esperan respuesta de Brahian.

| ID | Fecha | Decisión | Motivo / alternativas |
|---|---|---|---|
| D-001 | 10-05 | Yaw lo hace solo el dron; el gimbal tiene 2 ejes (roll estabiliza, pitch se comanda) | Motor de yaw desactivado. La entrada "ángulo de paneo" se reemplazó por el ángulo de la persona respecto a la nariz |
| D-002 | 10-06 | La cámara es USB, no MIPI-CSI | La CSI daba pantallas verdes y bloqueaba `nvargus-daemon` |
| D-003 | 10-07 | Pitch del gimbal por AUX1 de la Pixhawk con `DO_SET_SERVO` | Los pines PWM 32/33 de la Jetson no dieron señal. Descartado `MNT1_TYPE=1`: doble estabilización |
| D-004 | 10-07 | Enlace Jetson–Pixhawk por TELEM2 a 115200, sin 5 V | El USB retroalimentaba 5 V; a 460800 y 921600 la Pixhawk no entendía a la Jetson |
| D-005 | 10-07 | El proyecto es en exteriores (GPS, GUIDED) | Aclaración de Brahian. Se revirtió la configuración de interiores |
| D-006 | 10-07 | La IA #2 se entrena por refuerzo en simulación | Brahian no quiere etiquetar a mano; el RL no necesita etiquetas. Inspirado en Baker et al. 2020 |
| D-007 | 10-07 | El operador humano designa al sospechoso con un clic | YOLO solo detecta "persona"; ética y técnica. Nunca cambia de objetivo solo |
| D-008 | 10-07 | Árbitro de seguridad solo ante amenaza real (< 3 m o < 8 m acercándose) | Antes el dron se trababa 2.5 s esquivando a personas lejanas |
| D-009 | 10-07 | Misión en dos fases: piloto con bloqueo frontal, IA en la zona | Alcance aclarado por Brahian; el objetivo es mantener la vista, no solo salvar el dron |
| D-010 | 10-08 | Arquitectura híbrida: reglas deterministas + política PPO | Lo predecible y auditable va en reglas; la red decide solo con el objetivo fijado |
| D-011 | 10-08 | Mapa LiDAR propio, sin usar el plano del simulador | Para que la política dependa solo de lo que el dron real puede medir |
| D-012 | 10-08 | Autoría visible en el visor | Pedido de Brahian ("Fase de Autoría") |
| D-013 | 10-08 | Pasar a Stable-Baselines3 con transferencia desde la v9 | Congelar la capa inferior (lo aprendido en 300+ M pasos) y afinar lo nuevo |
| D-014 | 10-10 | Límite del gimbal ESTRICTO: -45°..+15° (el código se ajusta a la regla) | Brahian: la BaseCam física no pasa de -45° y forzarla quema los motores. Antes el código permitía -60° y se había documentado así; se revirtió el mismo día. Cambia `entorno.py` (MIN, NADIR, TACTICO) y `control.py`; copias previas en `*_v10.py` |
| D-015 | 10-10 | Búsqueda al perder el objetivo DETERMINISTA (`PERDIDA_IA = False`) en la rama `v11-hibrido` | Brahian: la meta de la rama es la máquina de estados determinista con SLAM para rodear muros. Verificado: con False se recorren PREDECIR, INVESTIGAR, ASOMO y VENTAJA_ALTURA. Los modelos de la V10 se entrenaron con IA y hay que reentrenarlos |
| D-016 | 10-10 | Los modelos `.zip`/`.pt` no van a Git | Pesan 1.1 GB; se respaldan en Google Drive o en un Release de GitHub |
| D-017 | 10-10 | La etiqueta se llama `v10-master-759M` | Brahian eligió el nombre que coincide con el estado real (759 M pasos); `350M` no lo reflejaba |
| D-018 | 10-10 | Ciclo de mejora con informes y dos agentes (`supervisor-rl`, `implementador`) y pruebas en `simulacion/tests/` | El supervisor diagnostica sin tocar código y propone máximo 3 cambios; Brahian aprueba; el implementador aplica con pruebas |
| D-019 | 10-10 | Respaldo de modelos: Release de GitHub con lo esencial (10 archivos, 12 MB) y copia completa en Google Drive | Release `v10-master-759M`: `ultimo.zip`, `base_v9.zip`, `ladron_congelado.pt` y un checkpoint cada 100 M. Los 761 checkpoints (1,1 GB) los copia Brahian a mano a Drive |
| D-020 | 10-10 | V12: fine-tuning ESTRICTO desde el checkpoint de 769.6 M de la V10: capa inferior del actor congelada entera; se afinan la capa táctica, la salida y el crítico (lr 1e-4) | Brahian: "la IA no debe reaprender a volar". La física (ArduPilot, gimbal) está en `control.py` y no es una red; la capa inferior es la lectura de sensores de 1 000+ M pasos. Descartado: congelar solo 36 columnas (V10) |
| D-021 | 10-10 | La multa de suavidad solo cobra los canales que comanda la red (cabeceo de un AVANZAR suyo, giro pedido por ella) | Diagnóstico V10 (C2): pagaba -19 por partida por el seguimiento automático. El jitter físico se sigue midiendo aparte (`info["du"]`) |
| D-022 | 10-10 | Bono de re-adquisición +8 y multa -8 por el mismo evento (objetivo oculto más de 1 s) | Brahian pidió un bono "masivo". Igual y opuesto para que perder a propósito no rinda; un parpadeo de menos de 1 s no se multa. Descartado: +8 con multa de -3 (se podía explotar) |
| D-023 | 10-10 | Reflejo de punto ciego: si el objetivo o su vector de escape cae a menos de d = h/tan(45°+VFOV/2)+1 m, retroceso con la velocidad del objetivo sumada; durante una evasión se suma al esquive | El gimbal no baja de -45° (D-014): debajo hay una zona que la cámara no ve. Límite conocido: no basta si el ladrón carga desde 3.5 m (escenario "debajo") |
| D-024 | 10-10 | Búsqueda determinista con memoria espacial: PÉRDIDA → FLANQUEO_PROFUNDO → GIRO_360 → SIGUIENTE_OBSTÁCULO → … → ALTURA_TÁCTICA → MISIÓN_PERDIDA (90 s), histéresis de 1 s y raycasting contra la nube del LiDAR | Pedido de Brahian; cumple la regla 3 (D-015). Reemplaza el final "agotado tras la altura" por el reloj de 90 s y otra ronda por los muros del mapa |
| D-025 | 10-10 | Visor: paneles "Búsqueda · estados" y "Mapa SLAM · LiDAR 1D"; la nube va en la clave `nube` de cada cuadro | La clave `lm` estaba repetida (nube y modo del ladrón) y la nube nunca llegaba al visor |
| D-026 | 10-10 | V13: currículo "Un Solo Muro" en el 30 % de las partidas, bajando al 10 % con el nivel | Pedido de Brahian (entrenamiento modular). El segundo panel se superpone al primero (no se manda fuera de la arena: el ladrón correría a esconderse a una esquina) |
| D-027 | 10-10 | **ABIERTA** · GIRO_360 a 3.0 m con el gimbal en -15° (pedido: 2.5 m y 0°) | Medido con la política V12: 2.5 m / 0° → alcanzado 48 % (dentro del salto del ladrón y de su ataque bajo 3 m; con la cámara horizontal no ve a nadie a menos de ~4 m). 3.0 m / 0° → el LiDAR pasa por encima de los muros de 2.6 m. 3.0 m / -15° → cumplida 67 %, alcanzado 18 %. Brahian puede volver al pedido con `Z_GIRO = 2.5`, `GIMBAL_GIRO = 0.0` |
| D-028 | 10-10 | Tope de guiñada `RATE_Y_MAX = 120°/s` en el autopiloto; el GIRO_360 va a 90°/s | Restricción real de la Pixhawk y desenfoque de YOLO; a 90°/s cada persona queda ~4 cuadros en el FOV |
| D-029 | 10-10 | Interrupción táctica: solo el ID designado interrumpe la búsqueda (sin esperar los 4 cuadros de ReID) | Pedido de Brahian. Los peatones nunca interrumpen: se respeta la regla 4 (humano en el lazo) |
| D-030 | 10-10 | Stand-off por FOV (b = 0.8 m detrás del muro, a = b/tan(HFOV/2 - 1°) = 2.4 m) y detección parcial con el 15 % del bounding box | Pedido de Brahian. Con detección parcial el desempeño no bajó; el despeje se amplió a 1.2 m porque tras una interrupción el dron bajaba sobre el muro |
| D-031 | 10-10 | V14: currículo progresivo de 4 niveles (Duelo abierto, Muro único, Ruido visual, Misión completa) | Pedido de Brahian ("gatear, caminar, correr, volar"). La V13 nunca entrenó: la V14 la incluye y parte de la V12 |
| D-032 | 10-10 | El nivel 0 NO es el duelo de cenit puro: es huida en zigzag con 30 % de partidas de cenit, que no cuentan para subir | Medido con la V12: cenit 0 % (perdido 71 %, alcanzado 26 %), huida 97 %. Con el cenit como requisito el currículo nunca saldría del nivel 0 |
| D-033 | 10-10 | Subir de nivel con éxito ≥ 85 % en 1000 partidas del nivel (no 100), mínimo 2 M pasos, paciencia 50 M | Con 512 entornos se juegan ~100 partidas por iteración: 100 sería una sola iteración (ruido). La paciencia evita que un nivel imposible trabe el entrenamiento |
| D-034 | 10-10 | 25 % de las partidas repasan niveles ya superados | Sin repaso la red olvida lo anterior (olvido catastrófico) |
| D-035 | 10-10 | Competencia: gana el dron si cumple; gana el ladrón si alcanza, si el dron lo pierde o si no lo encuentra; choques con muros/civiles y geocerca no cuentan para nadie | El ladrón está congelado (no aprende en SB3): la barra mide al dron contra un rival fijo |
| D-036 | 10-10 | Oclusión entre personas y civil distractor que respeta 3 m del dron | Sin oclusión el "ruido visual" no tapaba nada; sin respeto el civil chocaba con el dron en el 31 % de las partidas |
| D-037 | 10-10 | V15 según el plan `docs/PLAN_V15_CURRICULO.md` (D1-D7 del plan, aprobadas por Brahian): 5 niveles, rendición con contador continuo, predicción con Kalman y partículas, identidad con RECONFIRMAR, secuencia tras el muro | Ver los informes `evaluacion_v15-fase-A..E.md` |
| D-038 | 10-10 | 360° de búsqueda a −12° (el plan proponía −8°, comparado con −15°) | A −8° desde 3.3 m la cámara no ve a nadie a menos de 4.4 m (justo detrás del muro desde el punto de flanqueo); −12°: tras muro 100 % y 9.4 s; −15°: 10.9 s. Cierra D-027 |
| D-039 | 10-10 | Muro de canto a 8 m de la punta (el plan: 6 m) | Con perspectiva, a 6 m la punta cercana tapa ±0.19 m de la lejana y al ladrón le asoman ~3 cm de hombro; a 8 m, ~6 cm, y el cono sigue cubriendo 2 m a cada lado |
| D-040 | 10-10 | Guardas de geocerca (tipo FENCE + AVOID de ArduPilot) y de personas recordadas | Con partidas de 5 min la geocerca fallaba en el 21 % del nivel 0 y el civil chocaba en el 22 % del nivel 1; quedaron en 0 % y 3-4 % |
| D-041 | 10-10 | **ABIERTA** · Calibrar el cansancio del ladrón y la frecuencia del civil distractor antes de entrenar la V15 | Reserva al final 0.96-0.97: la rendición casi exige 2 min sin que se esconda (nivel 3: 5 %); ~16 reconfirmaciones por misión en el nivel 1 |
| D-042 | 10-10 | Las pruebas de reglas duras aceptan los estados nuevos RECONFIRMAR y MURO_DE_CANTO y endurecen el humano en el lazo (de RECONFIRMAR solo se vuelve a PERSECUCIÓN con la respuesta del operador y la persona correcta) | Para que Brahian lo revise: es una extensión de las reglas, no una relajación |
| D-043 | 10-10 | Altura nominal = altura segura (3.30 m) en todo vuelo cerca de personas, salvo el 360° de entrada bajo con su guarda | Decisión de Brahian vía el arquitecto. Con 2.3 m el dron iba dentro de la burbuja de 2.6 m de los peatones: los choques del nivel 3 (5-11 %) bajan a 0 % y "alcanzado" en la misión completa de 23 % a 5 %. Las observaciones conservan la referencia de 2.3 m (`Z_REF_OBS`) y el piloto de la misión vuela a 2.3 m (`Z_PILOTO`) |
| D-044 | 10-10 | Muro de canto a 6 m con desplazamiento lateral (centrado → 1 m al lado de la predicción → 1 m al otro, nariz a lo largo del muro, una pasada, 7 s). Reemplaza D-039 | Diseño del arquitecto. Ladrón justo detrás de la punta lejana: asoma ~40 % del cuerpo frente a ~23 % del barrido a 8 m (muros de 6-6.5 m). En simulación los dos lo re-fijan ~99 %; la ganancia es margen para el YOLO real. Informe `evaluacion_v15-ajustes-arquitecto.md` |
| D-045 | 10-10 | Pitch del 360° de búsqueda: −12° (confirmado por el arquitecto) | La fase D midió −12° como mejor que −8° (D-038) |
| D-046 | 10-10 | Nivel 4: contador en pausa 4 s al re-adquirir (C1), tope de 5 min terminal con R_TOPE −5 y éxito por tiempo restante (C2), métricas de custodia y de búsqueda por nivel (C3) | Brahian (vía el arquitecto) eligió 4 s, no 8. Medido sin reentrenar: rendición N4 35.5 → 39.1 % (no significativo; con 8 s sería 56.5 %); custodia ≥ 60 s ~89 %. Informe `evaluacion_v15-nivel4-C1-C3.md` |
| D-047 | 11-10 | Mínimo indispensable: decisor IA (MLP de scikit-learn) dentro de una envolvente que aplica la regla dura 5 como está escrita: el LiDAR < 3 m y la parada mandan; el árbitro AUTORIZA el ascenso, no obliga a intervenir; más una salvaguarda geométrica (persona seguida que va a pasar a < 2 m en < 1.5 s) | Con la persona < 3 m como obligación, la IA da lo mismo que las reglas. Con la envolvente literal: 0 choques y 0 riesgos omitidos en el protocolo; en mundos de prueba choques 39 → 28 y personas a < 2 m 420 → 218. Informe `minimo_tesis_decisor_ia.md` |
| D-048 | 11-10 | **ABIERTA** · ¿El ascenso vertical de protección del mínimo cuenta como "evasión" que el árbitro debe autorizar? | Con el veto, por encima de 4 m/s la IA + envolvente deja 173 vuelos con persona a < 2 m bajo 3.30 m; sin el veto, 100. Con LOIT_SPEED 4 m/s la diferencia es pequeña (45 vs 42). Decide Brahian |
| D-049 | 10-17 | Aprobada por Brahian (17-oct) · V17: con el objetivo fijado la red tiene 7 botones que sí cambian algo (QUEDARSE, RODEAR_IZQ, RODEAR_DER, ACERCARSE a 3.5 m, ALEJARSE a 6 m, SUBIR +0.5 m hasta 5.5 m, BAJAR −0.5 m nunca bajo 3.30 m con alguien a < 8 m); la maniobra de evasión la elige el árbitro por regla | Medido: la V15 (229 M) rinde igual que "siempre MANTENER" y que el azar (custodia ≥ 60 s 11.3 / 10.2 / 7.8 %, ±3.9; `informes/diagnostico_v17_ia_aporta.md`): con el ladrón a la vista 9 de los 10 botones hacen lo mismo. Descartado: seguir entrenando la V15. Plan `docs/PLAN_V17_REFUERZO.md` |
| D-050 | 10-17 | Aprobada por Brahian (17-oct) · Máscara de acciones con `MaskablePPO` (`sb3-contrib`, dependencia nueva): un solo botón en los pasos sin decisión y nunca botones prohibidos | La red decide en el 43 % de los pasos pero PPO aprende de todos (`ia_aporta_v15_probs.json`); el resto es ruido que, con el bono de entropía, sube la entropía. Descartado: decidir cada N pasos (no quita el ruido) |
| D-051 | 10-17 | Aprobada por Brahian (17-oct) · Cancha V17: dos conjuntos de paneles en V de 90° (alas de ~1.0 m, por medir; alto ~2.0 m, aleatorio 1.9-2.2 m en simulación), vértices a 10 m, bocas hacia lados contrarios, zona de IA 30 × 30 m en media cancha a ≥ 10 m de los árboles; 1 ladrón y 1 civil | Alto medido en la foto con referencia humana (plan, 3.2). 90° = mayor área de apoyo; 10 m = desde 4-5 m no se ven las dos V a la vez y el ladrón tarda ~3 s en cambiar. Dibujo `docs/v17_zona_ia.png` |
| D-052 | 10-17 | Aprobada por Brahian (17-oct) · "La IA aporta" = custodia ≥ 60 s de la política ≥ la de solo reglas (B0) y la del azar (B1) + 5 puntos con 512 partidas, sin empeorar re-adquisición, rendición ni seguridad; se reporta también contra la regla de posicionamiento B2. Regla de parada: si a los 50 M no supera a B0 por ≥ 3 puntos, se detiene | Para que el trabajo de refuerzo sea defendible ante el Ing. Harold y no se repita lo de la V15 (222 M pasos sin cambio) |
| D-053 | 10-17 | Aprobada por Brahian (17-oct) · Las partidas de entrenamiento empiezan cuando el piloto activa la IA (propuesta: interruptor CH7; CH8 sigue siendo la parada); el tránsito con el mínimo solo se muestra en la misión del visor | La red no decide en el tránsito; entrenarlo gasta pasos. El mínimo (`minimo_tesis/`) no se toca |
| D-054 | 10-17 | Aprobada por Brahian (17-oct) · La V17 parte del código de la V16 (rama `v16-simulacion` del repo viejo) traído a `03_SIMULACION_RL/` | Posturas, salto, civiles, cámara al piso, coberturas y sacudida ya están programados y probados (118 pruebas). La V16 nunca se entrenó |
| D-055 | 10-17 | Aprobada por Brahian (17-oct) · Hardware del plus: variante **C primero** (TF03 fijo al chasis, TF-Luna en el pod con la cámara, CSI al piso; BaseCam liberada) y **D como plan B** (pan-tilt de 2 servos) si sin el TF03 el pod no baja a −45°. La V17 entrena con `GIMBAL_TIPO = "mixto"` para que sirva a las dos. No se toca el dron hasta terminar los pasos 4-7 del mínimo; al hacerlo, hay que re-simular el mínimo | Sesión Hardware y variantes, `05_HARDWARE_Y_VARIANTES/VARIANTES.md` (matriz A-F; `validar_variantes.py` pasa en las 6, verificado por el Arquitecto). E y F descartadas: más peso y cables por poco beneficio. Con paneles de 2.0 m (D-051) el TF03 horizontal a 3.30 m pasa por encima: el que mapea los paneles en la zona de IA es el TF-Luna del pod |
| D-056 | 10-17 | Aprobada por Brahian (17-oct) · Pan del pan-tilt (solo variante D): **bloqueado** en el entrenamiento de la V17 (los 7 botones de D-049 no lo incluyen). Rango propuesto ±60° como parámetro, no como regla dura; si se construye D, se decide con topes mecánicos | Propuesta del Arquitecto. Agregar un eje nuevo a la red antes de comprobar que la V17 aporta mezclaría dos cambios en una sola medición |
| D-057 | 10-17 | Aprobada por Brahian (17-oct) · Motor gráfico: seguir con three.js (visor V16) para la estación de tierra, con personas y animaciones de paquete (Mixamo/Quaternius, licencias por verificar), y Blender para renderizar el video realista desde el JSON de `foto()`. Unreal 5 descartado | Sesión Visor, `04_VISOR_Y_MOTOR_GRAFICO/PLAN_MOTOR_GRAFICO.md`: el visor V16 da 144 cuadros/s con la RTX 3050 (24 con la Intel: Chrome debe usar la RTX, "Alto rendimiento" en la configuración de gráficos de Windows). Unreal con 16 GB y 6 GB de video no va cómodo y obliga a empezar de cero |
| D-058 | 10-17 | Aprobada por Brahian (17-oct, confirmada al Arquitecto) · El visor V16 (`04_VISOR_Y_MOTOR_GRAFICO/v16/`) entra a `main`, sin push | Commit 3c38f66. Revisión de licencias (commit 5e8cde3, `04_VISOR_Y_MOTOR_GRAFICO/_LEEME.md`): sin fotos de personas, three.js MIT, 2 HDR CC0 de Poly Haven, 12 texturas propias. Falta traer `herramientas/generar_texturas.py` de la rama `v16-visor` |
| D-059 | 10-17 | Aprobada por Brahian (17-oct): **opción A** · Métrica principal y recompensa de la V17. Opciones: **(A, elegida)** M1 = racha ≥ 30 s seguidos a la vista (60 s se sigue reportando), recompensa alineada con M1 (bono al cumplir 30 s seguidos y potencial por la racha en curso) y agregar **B3 = "siempre SUBIR"** como línea base que la IA debe superar; probar con una corrida de 10 M (~50 min). **(B)** Solo cambiar M1 a 30 s, sin tocar la recompensa: no cuesta nada, pero lo más probable es que la red vuelva a quedarse quieta. **(C)** Dejar que la red decida también los primeros 2-3 s tras perderlo, antes de la búsqueda determinista: más palanca, pero toca cómo se aplica la regla dura 3 y obliga a re-medir todo. Descartada: ablandar al ladrón para que la métrica dé | Línea base de 512 partidas (`03_SIMULACION_RL/informes/v17/`, `docs/PROGRESO_V17.md`): con 60 s seguidos B0/B1/B2 dan 1.2/0.6/1.0 % (no separa nada); con 30 s, 51.8/52.0/52.7 %. Botones fijos (`fijo_*.json`): solo SUBIR se separa (racha ≥ 30 s 61.9 %, rendición 24.4 % vs 15.6 %, re-adquisición ≤ 10 s 83 % vs 76 %); RODEAR, ACERCARSE, ALEJARSE y BAJAR quedan en el ruido. La red colapsa a QUEDARSE a los 2.6 M porque moverse solo cuesta multas de suavidad. La red ve al ladrón ~1 s por tramo antes de que se esconda |
| D-060 | 10-17 | Decidida por el Supervisor (delegación de Brahian, 17-oct; él la revisa en la noche) · Desde el 17-oct las decisiones del plus las toma el Supervisor con el Arquitecto, sin esperar a Brahian. Cada una queda aquí con su motivo y Brahian puede revertirla. Siguen fijos: reglas duras de `CLAUDE.md`, sin `git push`, no tocar `01_`, `02_`, `07_`, la Jetson ni el dron, máximo 2 sesiones a la vez | Brahian, en el chat del Supervisor: "Las decisiones las tomas tú… si ves que no funciona, devuélvete y hazlo por el otro método" |
| D-061 | 10-17 | Decidida por el Supervisor (delegación de Brahian) · Nombres de las versiones: **V17.0** = la base de la V17 con la recompensa de antes (corrida "todo" de 10 M del 17-oct, 9:05); **V17.1** = la V17 con D-059 A; V17.2, V17.3… para cada arreglo siguiente. Las carpetas pueden conservar sus nombres; en `PROGRESO_V17.md` se dice qué carpeta es qué versión | Brahian no entendía "V17 todo"; "todo" solo quería decir "con todas las reglas de recompensa" |
| D-062 | 10-17 | Decidida por el Supervisor (delegación de Brahian) · Entrenamiento: si la V17.1 a 10 M supera a B0 y a B3 ("siempre SUBIR") en M1 o va claramente en subida, lanzar 50 M con la regla de parada de D-052 sin esperar a Brahian. Si colapsa, probar en orden: (B) ajustes de la recompensa o de la entropía dentro de D-059; (C) un ladrón que se deje ver más. **No** se toca la regla dura 3 (búsqueda determinista): eso sí necesita a Brahian | La recompensa de antes colapsaba a QUEDARSE (`informes/v17/humo_2M.json`); los botones fijos muestran que SUBIR sí rinde más (racha ≥ 30 s 61.9 contra 51.8 %, `docs/PROGRESO_V17.md`) |
| D-063 | 10-17 | Decidida por el Supervisor (delegación de Brahian) · Seguridad de altura: Simulación V17 mide dos arreglos para que el dron no vuele **de verdad** por debajo de 3.30 m con alguien a < 8 m (hoy 14.1 % real contra 2.0 % pedido, por el error del barómetro): (1) margen sobre la altura segura según el error del barómetro, (2) altímetro por LiDAR al piso si la variante lo permite. Se queda el que baje el tiempo real bajo 3.30 m a ≤ 2 % sin empeorar M1 | `informes/v17_linea_base.json`. La altura segura es parte de la regla dura 5 (D-043) |
| D-064 | 10-17 | Decidida por el Supervisor (delegación de Brahian) · Hardware del plus: se mantiene **C primero, D de plan B** (D-055), y Brahian **imprime el pan-tilt de la variante D** desde ya (él lo pidió). La sesión de Hardware prepara las piezas para imprimir y una guía clara de qué va dónde. TF03 al chasis inclinado **−3°** en vez de +1° (duplica el mapeo de los paneles de 2 m, 25 → 52 %, `PROGRESO_V17.md`, paso 7): la simulación lo adopta; en el dron, solo después de los pasos 4-7 del mínimo | El montaje del TF03 en el chasis es nuevo de todos modos, así que inclinarlo no cuesta más |
| D-065 | 10-17 | Decidida por el Supervisor por pedido de Brahian (17-oct, noche) · Reemplaza la parte gráfica de D-057. El **mundo 3D realista** se hace en **Unreal Engine 5** (personas MetaHuman, luz Lumen, la cancha de la universidad), y lo alimenta la simulación de Python por red con el JSON de `foto()`. La **interfaz** (estación de tierra) sigue siendo web, porque es la que irá en la Jetson, ahora con paneles que se mueven, se agrandan, se minimizan y se guardan, y vistas "solo 3D", "solo lo que ve el dron" y "todo". Mientras se instala Unreal, el visor web vuelve a su aspecto anterior (personas y cielo de la V16); los paquetes de Quaternius quedan como opción apagada | Brahian vio el video de Blender con personas de Quaternius y lo rechazó: "parece hecho a punta de figuras geométricas", "se veía mejor antes"; pide "algo similar a GTA 5" aunque el computador vaya forzado. El PC tiene 283 GB libres, 16 GB de RAM y una RTX 3050 de 6 GB: Unreal corre, con calidad media. Instalarlo necesita a Brahian (cuenta de Epic y permiso de administrador) |
| D-066 | 10-17 | Decidida por el Supervisor (delegación de Brahian) · Paneles de la cancha con las **medidas reales de Brahian**: alas de **~1.5 m** y alto **2.2-2.3 m** (aleatorio en ese rango), en vez de 1.0 × 2.0 m (D-051). Entra en la **siguiente** versión de entrenamiento (no se cambia la V17.2, que ya corre) y en el visor; al cambiarla se vuelven a medir B0-B3 | Brahian dio las medidas al Visor el 17-oct en la noche. Un dato medido gana a uno estimado en una foto. No se cambia a mitad de una corrida para que sus resultados sigan siendo comparables |
| D-067 | 10-18 | Decidida por el Arquitecto (autorización de Brahian) · Plan tras la V17.2 a 50 M: (1) primero se mide **B4** (sube a 5.5 m si desde arriba ve claramente más zona de escape, baja a 3.30 m si no, con margen anti-vaivén) y **B4\*** (lo mismo con la posición verdadera del ladrón, solo como techo) contra B3 con los paneles reales; (2) **compuerta:** si ni B4\* le gana a B3 por más de 3 puntos, "subir siempre" ya es casi lo mejor y no se entrena más la altura; (3) si pasa la compuerta, V17.4 con los cambios del diagnóstico, de a uno y a 10 M: altura pedida y distancia ladrón-V en la observación; entropía en rampa 0.01→0.003; gamma 0.995 junto con `GAMMA_GUIA` 0.995 (deben valer lo mismo). La IA aporta si queda ≥ 5 puntos sobre el mejor entre B3 y B4. La palanca grande que quedaría, dejar que la red decida tras perderlo, toca la regla dura 3 y **la decide Brahian** | `03_SIMULACION_RL/informes/diagnostico_v17_2_50M.md` (agente `supervisor-rl`): retorno ordena igual que M1 (B3 23.35, IA 22.99, B0 18.40), la entropía no baja desde 25 M, la red no ve la altura que ya pidió ni la distancia a la V, y el vaivén de 16.8/min está inflado por la vuelta a 3.30 m de la búsqueda |
| D-068 | 10-19 | Decidida por el Arquitecto (autorización de Brahian) · Cierre de la V17 en altura: la compuerta de D-067 quedó cerrada (ni B4\* con la posición verdadera le gana a "siempre SUBIR"), así que **no se entrena más la altura**. Lo que sigue es solo **adaptar** la V17.2 a la cancha real: afinarla 10 M (V17.4) con los paneles reales y la suavidad vertical en 0.1, y medirla con 512 partidas contra B0-B3. Resultado honesto para el documento: "la IA aprendió sola lo que hace la mejor regla simple y supera a 'solo reglas'". Los 5 puntos sobre B3 de D-052 no son alcanzables con este reparto de la regla 3. **Pendiente de Brahian:** si deja que la red decida los primeros 2-3 s tras perder al ladrón (D-059 C), que toca la regla dura 3 | `docs/PROGRESO_V17.md` (compuerta B4): B3 24.6 %, B4 19.5 %, B4\* 22.5 % en la cancha real; V17.2 54.3 % contra B3 56.2 % en la cancha vieja. La V17.3 (suavidad vertical 0.5) colapsó a QUEDARSE |
| D-069 | 10-19 | Aprobada por Brahian, según el Coordinador (19-oct; no la leí en el chat de Brahian) · Probar D-059 C: que la red decida también el tramo tras perder al ladrón, de forma **reversible** con el interruptor `PERDIDA_IA` (la regla dura 3 de `CLAUDE.md` no se reescribe: queda en `False` por defecto y la prueba es una corrida aparte). La regla 3 es de Brahian y puede volver a fijarla. Se queda solo si M1 sube ≥ 5 puntos frente al mismo modelo sin ella, con la seguridad en 0 y la búsqueda determinista como control | Es la única palanca grande que queda tras cerrar la altura (D-068). Aviso del Coordinador; falta la confirmación de Brahian escrita aquí si se quiere dejar como política final |
| D-070 | 10-19 | Decidida por la sesión Simulación V17 (delegado) · D-069 se implementa con un interruptor **aparte**, `PERDIDA_RED_V17` (False por defecto): en la cancha la red decide con sus 7 botones solo durante la PÉRDIDA (PREDECIR, ~1-4 s) y después sigue la búsqueda determinista; `PERDIDA_IA` y su prueba de regla dura no cambian | `PERDIDA_IA = True` entrega 60 s de búsqueda a la red con los 10 botones de la V15 y sin búsqueda determinista: no es D-059 C y dejaría sin control. Pruebas en `03_SIMULACION_RL/tests/test_v17.py` (`TestPerdidaRed`); detalle en `docs/PROGRESO_V17.md` |
| D-071 | 10-19 | Decidida por el Arquitecto, por encargo del Coordinador (el número D-070 ya lo usó Simulación V17 para el interruptor de D-069) · **Ruta de búsqueda de Brahian como consejos, no como reglas duras.** En sus palabras, según el Coordinador: 360° de entrada y mapa de puntos de los paneles; ir siempre **detrás de cada panel** a 3.30 m y a buena distancia; recorrer la parte de atrás como un **cuadrado por las esquinas**; luego mirar **de frente con vaivén izquierda-derecha**; luego el **otro panel o V**; movimientos rápidos; **nunca quedarse quieto**; y que funcione también **sin poder subir**. La red la aprende de un maestro escrito (B5) por imitación y con bono de progreso y costo por quedarse quieto. Los consejos no reemplazan al árbitro, la geocerca, el humano en el lazo ni los límites del gimbal, y la regla 3 sigue como la dejó D-070. "La ruta enseñada cuenta como aporte de la IA" cuando la red (sin que el maestro la mande) supera a B3 y a B0 por ≥ 5 puntos de M1 o, si B5 resulta mejor que B3, queda a menos de 3 puntos de B5; criterio completo en `docs/RUTA_BUSQUEDA_BRAHIAN.md` | Es la pieza que faltaba tras cerrar la altura (D-068): una estrategia de recorrido que ni "siempre subir" ni la red de la V17.2 tienen. Las distancias del documento son valores de partida que se ajustan midiendo, no valores medidos |
| D-072 | 10-20 | Registrada por el Arquitecto (la cita la sesión Hardware; no estaba en este archivo) · Hardware del plus: hoy el dron es la **variante G** (CSI IMX219 fija a ~−5° + TF03 fijo, sin gimbal ni cámara USB) y la meta es la **H** (pan-tilt de 2 servos con CSI y TF-Luna, TF03 fijo y segunda CSI al piso). Las variantes A-F quedan descartadas. Reemplaza lo de D-055 sobre C y D | Brahian quitó el gimbal y la USB (el sensor se dañó con el sol), según `05_HARDWARE_Y_VARIANTES/VARIANTES.md` §0 y las fotos del 20-oct (`08_EVIDENCIA_Y_DIAGRAMAS/fotos/19-23`). Lo que se ve sin gimbal: ciego a menos de ~3.0 m (`COBERTURA.md`). Estado físico: `docs/ESTADO_FISICO_20OCT.md` |
| D-073 | 10-20 | **Por confirmar por Brahian** (me la pidió el Coordinador; no la leí en el chat de Brahian) · **Gimbal descartado definitivamente.** La regla dura 1 (gimbal −45°..+15°, `pwm = 1500 + θ·500/45`) pasaría a aplicar **solo al tilt del pan-tilt H**, como tope mecánico (−44°/+14°). No relaja ninguna otra regla. **No edité `CLAUDE.md`**. Ajuste del 20-oct (Coordinador): la regla 1 queda como **tope mecánico del tilt de H (−45°..+15°)** y se agrega un **tope de pan que fijará Hardware** (por ahora sin valor: ±60° era solo un parámetro). Texto propuesto: «1. Tilt del pan-tilt (variante H) entre −45° y +15° con topes mecánicos, y pan dentro del tope mecánico que fije Hardware; el dron del mínimo (variante G) no tiene gimbal y la cámara va fija a −5°. PWM del servo de tilt: `pwm = 1500 + θ·500/45`. Prohibido ampliar el mapeo.» | Cambiar una regla dura es de Brahian y `CLAUDE.md` es del proyecto: no lo modifico porque otra sesión me lo pida. Cuando Brahian lo confirme aquí o por escrito, se aplica el texto. Mientras tanto la simulación sigue acotando el gimbal a −45°..+15°, que es más estricto que sin gimbal |
| D-074 | 10-20 | Aprobada por Brahian el 20-oct, dicha directamente según el Coordinador (no la leí en su chat) · (1) **Mínimo = variante G:** CSI fija + TF03 fijo, sin gimbal; así queda físicamente. (2) **Plus = variante H:** base impresa con dos servos que mueven yaw (pan) y pitch (tilt), sin roll; CSI principal y TF-Luna juntos en el pan-tilt; 2.ª CSI fija al piso (CAM0/CAM1 por cable plano); TF03 fijo al chasis; el roll lo controla el dron. (3) **D-056 (pan bloqueado) queda REVOCADA: el plus tiene pan LIBRE**; D-072 se lee así: G es del mínimo y H es del plus, no "G actual, H meta" del mismo dron. (4) El plus se entrena en H; **G queda solo como configuración del mínimo y como línea de comparación** | Separa los dos dispositivos: el mínimo ya está montado sin gimbal y el plus es otro montaje con pan y tilt. Efecto en la simulación: las corridas V17.x se entrenaron con cámara USB y gimbal virtual y hay que repetirlas con H; el pan queda fuera de las 7 acciones de D-049 hasta que Simulación decida con mediciones. No cambia ninguna regla dura; la reescritura de la regla 1 en `CLAUDE.md` sigue **por confirmar** (D-073). Ver `docs/PLAN_V17_REFUERZO.md` §7.0 y `docs/ESTADO_FISICO_20OCT.md` |
| D-075 | 10-20 | Decidida por el Coordinador por encargo de Brahian (20-oct) · **Plus (H): TF03 fijo al frente + pan-tilt de 2 servos con CSI#1 y TF-Luna + CSI#2 fija al piso.** En H el LiDAR frontal de seguridad sigue siendo **fijo** y el TF-Luna sigue al pan-tilt | Razones del Coordinador: el TF03 es grande y de cable grueso (ya trabó el pitch del gimbal); la misión tiene dos fases en un mismo vuelo y con el pan-tilt en pan 0°/tilt −5° el plus equivale a la cámara fija del mínimo, mientras el TF03 fijo conserva el frenado de seguridad; el Luna mide lo que mira la cámara, sin sincronizar ángulos de servo con el TF03. Coincide con la variante H de `05_HARDWARE_Y_VARIANTES/` |
| D-076 | 10-20 | Registrada por el Arquitecto por encargo del Coordinador (órdenes de Brahian del 20-oct; el detalle está en `docs/ORDENES_BRAHIAN_20OCT.md`, que no copio aquí) · Dos LiDAR de 1 haz; paneles de 2.30 × 1.50 × 0.05 m con las V a 160° y giratorias; búsqueda "ir detrás del panel más cercano y de esquina en esquina"; altura base 2.0 m; escenario único; interfaz rehecha | Pedido directo de Brahian, según el Coordinador. Cambia D-051/D-066 (V de 90°, 1.5 × 2.25 m) y la altura base de 3.30 m: **la altura mínima de 3.30 m con personas a menos de 8 m (D-043) es regla dura y no queda relajada por esta fila**; si las órdenes la tocan, lo decide Brahian por escrito |
| D-077 | 10-20 | Registrada por la sesión física (Brahian, hechos medidos el 19-20 oct) · Correcciones y configuración real del mínimo: (1) **no ha volado con la Jetson** (un vuelo de prueba sin ella terminó en failsafe por batería); (2) la cámara USB **no se dañó**, se sobreexpone al sol (su driver no controla la exposición); (3) con JetPack 6.2.1 `nvargus` funciona: CSI ≈30 FPS, ≈25 con YOLO (22-25 ms); (4) **Pixhawk boca abajo**: `AHRS_ORIENTATION = 8`; motores espejados con giro invertido: `FRAME_TYPE = 18` (X_REV) y `SERVO1..4_FUNCTION = 36, 33, 34, 35`; (5) TF03 y CSI fijos, alineación provisional; (6) **altura del mínimo por decidir**: Brahian propone 2.0 m como máximo y ~3 m solo con peligro inminente, lo que contradice D-043 (3.30 m) | Detalle y fuentes en `docs/ESTADO_FISICO_20OCT.md` §0 y en `Proyecto-Grado-Minimo/docs/ESTADO.md`; diagramas 10 y 11 de `08_EVIDENCIA_Y_DIAGRAMAS/diagramas/`. La altura la decide Brahian por escrito (regla dura D-043) |
| D-078 | 10-20 | Registrada por la sesión física (medición de Brahian, 20-oct noche) · Ángulos medidos del mínimo (variante G): campo de visión de la CSI **68.3° × 54.0°**, inclinación de la cámara **−2.4°**, inclinación del TF03 **−6.7°**, desvío lateral −0.6°; las alturas de los ejes sobre la superficie de apoyo son 32.0 cm (cámara) y 27.5 cm (TF03) | Lo nominal (62.2° × 48.8°, ambos a −5°) no coincide con el dron real. **Hay que re-simular el mínimo con estos valores** (regla de `CLAUDE.md`) y revisar H, que usa la misma CSI. Fuente: `Proyecto-Grado-Minimo/docs/ESTADO.md` y `datos_campo/calibracion_2026-10-20/` |
| D-079 | 10-20 | Sesión física (re-simulación por orden de Brahian) · **Mínimo re-simulado con la geometría medida** (D-078): sin gimbal, CSI 68.3° × 54.0° a −2.4°, TF03 a −6.7°, ambos siguen el cabeceo del chasis, vuelo a 2.0 m (`MINIMO_Z_PILOTO`). Protocolo del comité: 13 escenarios, **100 %, 0 choques, 0 activaciones falsas**. **Velocidad segura frente al panel: 11 → 5 m/s** (el rayo a −6.7° toca el suelo a ~17 m, antes ~26 m con el gimbal). Decisor MLP **reentrenado** con datos nuevos (2.55 M cuadros): AUC 0.961 (antes 0.974); en 3840 vuelos de prueba, riesgos no evitados reglas 224 / IA+envolvente 148 (antes 181), choques 117 / 97, personas a < 2 m bajo 3.30 m 516 / 212; piloto ≤ 4 m/s: 11 riesgos contra 10 de las reglas (igual). **Corrección:** la primera corrida usó datos y clasificador guardados del 11-oct (geometría vieja); se apartaron y se repitió | Informes: `03_SIMULACION_RL/informes/minimo_tesis_protocolo.md` y `minimo_tesis_decisor_ia.md`; versiones previas en `informes/_antes_20oct/` y `minimo_tesis/_antes_20oct/`. `decision.pkl/json` listos para exportar a la Jetson (aún no hay `sistema_minimo.py`). Pendiente de Brahian: altura del mínimo por escrito (2.0 m contra 3.30 m de D-043) |
| D-080 | 10-20 | Brahian, en su chat del 20-oct (escrito), según el Coordinador (no lo leí) · **Altura del plus:** base **2.0 m** (se pueden probar 1.7 y 2.6 m como parámetro) y **subir a 3.30 m solo si una persona está a ~4 m o menos**; la altura no se entrena. Para el plus reemplaza a D-043, con el árbitro de seguridad intacto; **D-043 (3.30 m con personas a < 8 m) se mantiene para el mínimo** hasta que Brahian decida lo suyo por escrito. TF03 del plus: −6.7° (medida real) | Riesgo anotado: a 2.0 m un adulto con el brazo arriba puede alcanzar el dron (por eso la subida a 3.30 m). Esta fila responde al punto 3 de mi revisión del 20-oct: la altura de 3.30 m con gente a < 8 m ya no se cumple en el plus por una decisión escrita, no por descuido |

| D-081 | 10-20 | Brahian, en su chat del 20-oct (escrito) · **Altura del mínimo = 2.0 m** (cierra D-043 para el mínimo: a 2.0 m el TF03 a −6.7° alcanza a una persona de 1.70–1.72 m solo a más de ≈ 2.5 m; es la altura de medición de la calibración). Plus: D-080. Fotos de la zona real de vuelo (de noche) en `08_EVIDENCIA_Y_DIAGRAMAS/fotos/universidad_zona_vuelo_noche_20oct/` para parecer el mundo del visor. |
| D-082 | 10-21 | Sesión física (campo del 21-oct, parqueadero, dron sin hélices sobre un carro) · **Los ángulos de D-078 estaban medidos respecto al horizonte, no al chasis.** Con la Pixhawk registrando el cabeceo (+3.9° / +4.2°, alabeo −2.2° / −2.5°), el suelo a ~22.4 m con el eje del LiDAR a 1.83 m y personas a distancia conocida, el montaje respecto al **chasis** resulta **LiDAR ≈ −9.0° ± 0.3° y cámara ≈ −5.6°** (no −6.7° y −2.4°); con el dron plano el rayo toca el suelo a ~12 m, no a 17 m. Validación: el LiDAR coincide con la cinta (+0.02 a +0.08 m entre 4 y 15 m); YOLO detecta 82 % a 15 m, 94 % a 12 m, ≥ 96 % a ≤ 10 m; el rayo cae dentro de la persona 75-100 % (E1), ~80 % (E2/E3), ~9 % al cruzar (E4) | Informe: `Proyecto-Grado-Minimo/datos_campo/campo_2026-10-21/INFORME_CAMPO_21OCT.md` (copia en `docs/`). **Pendiente:** recalibrar el montaje definitivo el 22-oct (`docs/GUIA_CALIBRACION_22OCT.md`, ahora con la Pixhawk) y **re-simular el mínimo** con esos valores respecto al chasis (`sensores.py`: `LIDAR_PITCH_MONTAJE`, `CAM_PITCH_MONTAJE`); D-079 se calculó con −6.7° / −2.4°. Repetir E0, E4 trotando, E5, E6 y completar E2/E3 con el montaje definitivo |
