brahianorrego/Talos-AI/docs/HORAS_DE_TRABAJO.md

# Horas de trabajo con Claude (estimadas a partir de las conversaciones guardadas)

Generado el 2026-10-21 23:34 con `02_JETSON_MINIMO/herramientas/horas_de_trabajo.py` (umbral de pausa: 20 min). Es una **estimación del tiempo con actividad registrada**, no de cuánto tiempo estuvo la persona frente al computador ni de lo que se trabajó sin Claude (armar el dron, medir, salir al campo).

## Por carpeta de trabajo

| Carpeta | Sesiones | Desde | Hasta | Horas activas | Mensajes de Brahian | Respuestas | Llamadas a herramientas | Imágenes |
|---|---:|---|---|---:|---:|---:|---:|---:|
| Desktop-Claude | 60 | 06-Oct 12:03 | 21-Oct 23:34 | 97.6 | 918 | 13173 | 6300 | 578 |
| Dron-IA-Proyecto | 4 | 16-Oct 23:36 | 21-Oct 16:13 | 43.8 | 102 | 6153 | 3491 | 283 |
| **Total** | 64 | | | **141.4** | 1020 | 19326 | 9791 | 861 |

Si dos sesiones corrieron a la vez, la suma de arriba cuenta ese rato dos veces. **Horas de reloj con alguna sesión activa (sin repetir): 82.3.**

## Por día (hora de Colombia)

| Día | Horas activas |
|---|---:|
| 2026-10-06 | 10.0 |
| 2026-10-07 | 13.0 |
| 2026-10-08 | 5.5 |
| 2026-10-09 | 0.2 |
| 2026-10-10 | 12.9 |
| 2026-10-11 | 6.1 |
| 2026-10-12 | 0.7 |
| 2026-10-13 | 0.7 |
| 2026-10-15 | 0.2 |
| 2026-10-16 | 5.6 |
| 2026-10-17 | 15.5 |
| 2026-10-18 | 18.5 |
| 2026-10-19 | 15.1 |
| 2026-10-20 | 23.6 |
| 2026-10-21 | 13.8 |
