brahianorrego/Talos-AI/docs/INDICE_MAESTRO_PARA_EL_DOCUMENTO.md

# Índice maestro: todo lo que sirve para el documento del proyecto de grado

Reúne lo de las dos cuentas de Claude y lo de Brahian. Reglas del documento: se escribe "proyecto de grado" (no "tesis"); máximo 100 páginas con el código en anexos; no ha volado nada con la Jetson; las cifras llevan su archivo de origen.
Autorización de rostros de Brahian y Tatiana (21-oct): `05_EVIDENCIA_Y_DIAGRAMAS/rostros_autorizados/INDICE.md`. Placas, redes y el interior de la vivienda siguen difuminados o privados.

## Cómo se hizo y cuánto costó
| Qué | Dónde |
|---|---|
| Horas de trabajo con Claude (141 h de actividad sumada, ~82 h de reloj, 15 días) | `docs/HORAS_DE_TRABAJO.md` (se regenera con `02_JETSON_MINIMO/herramientas/horas_de_trabajo.py`) |
| Dificultades físicas y cómo se resolvieron | `docs/DIFICULTADES_Y_LECCIONES_FISICAS.md` |
| Historial de las pruebas físicas, día por día | `docs/HISTORIAL_PRUEBAS_FISICAS.md` |
| Procedimiento para repetir todo | `docs/PROCEDIMIENTO_REPLICABLE.md` |
| Guías de campo y de calibración | `docs/GUIA_CAMPO_21OCT.md`, `docs/guia_campo_21oct/GUIA_CAMPO_21OCT.pdf`, `docs/GUIA_CALIBRACION_22OCT.md` |
| Estado actual y decisiones | `docs/ESTADO.md`, `Dron-IA-Proyecto/docs/DECISIONES.md` (D-077 a D-082) |
| Lo de la cuenta de simulación (cronología, errores, métodos, anexos, conversación) | `Dron-IA-Proyecto/docs/MATERIAL_PARA_DOCUMENTO/` |

## Datos y resultados
| Qué | Dónde |
|---|---|
| Tomas del campo del 21-oct y su análisis | `datos_campo/campo_2026-10-21/INFORME_CAMPO_21OCT.md` (+ `analisis_tomas.md`, `geometria_desde_campo.md`, `resumen_E1_por_marca.md`) |
| Tomas del 19-oct, calibración del 20-oct | `datos_campo/campo_2026-10-19/`, `datos_campo/calibracion_2026-10-20/` |
| Simulación del mínimo con la geometría medida | `Dron-IA-Proyecto/03_SIMULACION_RL/informes/minimo_tesis_protocolo.md`, `minimo_tesis_decisor_ia.md` |

## Evidencia gráfica
| Qué | Dónde |
|---|---|
| Fotos del dron, diagramas (motores, componentes, calibración) | `05_EVIDENCIA_Y_DIAGRAMAS/fotos/`, `diagramas/` |
| Anexo de imágenes históricas (133 imágenes de las conversaciones, por tema) | `05_EVIDENCIA_Y_DIAGRAMAS/anexo_historial_octubre_2026/INDICE.md` |
| Campo del 21-oct: fotos, cuadros y GIF | `05_EVIDENCIA_Y_DIAGRAMAS/campo_2026-10-21/INDICE.md` |
| Fotos con rostros autorizados (copias para el documento) | `05_EVIDENCIA_Y_DIAGRAMAS/rostros_autorizados/INDICE.md` |
| Capturas de la estación de tierra y del panel | `05_EVIDENCIA_Y_DIAGRAMAS/capturas/`, `privado/estacion_minimo_2026-10-21_*.png` |
| Imágenes de la cuenta de simulación (visor, Unreal, estación) | `Dron-IA-Proyecto/docs/MATERIAL_PARA_DOCUMENTO/04_indice_de_imagenes.md` |
