brahianorrego/Talos-AI/04_VISOR_Y_MOTOR_GRAFICO/unreal/_LEEME.md

# Unreal Engine 5.8 · la cancha realista (fase 1 de PLAN_UNREAL.md)

El proyecto **DronIA_Cancha** vive en `Documentos\Unreal Projects\DronIA_Cancha\` (fuera del repositorio: pesa mucho).
Aquí están sus scripts de Python y una copia de su `.uproject` (`proyecto/`). **Guía para Brahian: `../GUIA_BRAHIAN_UNREAL.md`.**

| Archivo | Qué hace |
|---|---|
| `dronia_ue.py` | Funciones comunes: de la simulación (m, y al norte) a Unreal (cm, y a la derecha), materiales, cancha, V de paneles (1.5 × 2.25 m, D-066), dron, cielo y luz |
| `crear_cancha.py` | Arma el nivel `/Game/DronIA/Mapas/Cancha_V17`. Si ya existe, no lo toca (ahí van los árboles y MetaHumans de Brahian) |
| `importar_repeticion.py` | Convierte una repetición `foto()` (JSON) en una Level Sequence: dron, personas, paneles de esa partida y cámara de cine |
| `renderizar.py` | Renderiza una secuencia a PNG de 1080p con Movie Render Queue |
| `ejecutar_en_unreal.bat` | Abre el editor con el proyecto, corre un script y espera a que termine (`.bat` porque Windows tiene desactivados los `.ps1`) |
| `init_unreal.py` | Lo corre Unreal al arrancar; si hay una orden en `DRONIA_ORDEN`, la ejecuta ya con el editor cargado |

**Configuración del proyecto que no está en el repositorio** (en `Config\DefaultEngine.ini` de DronIA_Cancha): mapa por defecto
`/Game/DronIA/Mapas/Cancha_V17` y, en `[/Script/PythonScriptPlugin.PythonScriptPluginSettings]`, `+AdditionalPaths` con la ruta
de esta carpeta `unreal/` (así Unreal encuentra `init_unreal.py` y los módulos). Si se mueve el repositorio, se cambia esa ruta.

## Lo aprendido al probarlo (para no repetirlo)

- `-ExecutePythonScript` **cierra el editor al terminar el script** y corta el render ("PIE Ended while Movie Pipeline was still
  active"). Por eso se usa `init_unreal.py` + `DRONIA_ORDEN`.
- La variable del ejecutor de renderizado tiene que ser **global**; si no, Python la borra y se corta.
- Sequencer escribe escala 1 en lo que mueve: si la pieza raíz de un actor con hijos tiene otra escala, los hijos salen
  deformados (el dron salía gigante). La raíz del dron no tiene forma ni escala.
- El callback de "render terminado" recibe exactamente 2 argumentos.
- Desde Git Bash los argumentos que empiezan con `/Game/...` se convierten en rutas de Windows (`MSYS_NO_PATHCONV=1`).

## Medido (Unreal 5.8.3, RTX 3050 de 6 GB)

Abrir el editor y renderizar: ≈ 35-70 s por corrida (arranque incluido). Un cuadro de 1920 × 1080 con 4 muestras temporales:
unos 3-4 s. Secuencia de 30 s (721 cuadros a 24 cps): ≈ 40-50 min **estimados** (no se renderizó completa). El primer arranque
del proyecto compila shaders (varios minutos).

## Estado

Listo: cancha, V, dron provisional, personas **provisionales (cilindros)**, secuencia desde cualquier repetición V17, render y
MP4 (probado con 24 cuadros). Falta: MetaHumans con sus animaciones (guía, pasos 3-4), árboles y pasto de Fab, modelo del dron
real, la fase 2 en vivo (`puente_unreal.py`) y la fase 3 (Pixel Streaming).

## El campus de la universidad en Unreal (2026-10-18)

`crear_cancha.py` ahora construye el campus completo con `entorno_u_ue.py`, que lee `entorno/entorno_u.json` (la misma especificación de la
estación web): césped con franjas de corte, líneas y arcos de la cancha de fútbol (67 × 102 m, medida), tenis y múltiple con cerco, aros y
red, coliseo, laboratorio, parqueadero con autos, 6 bloques de ladrillo, 5 torres, vías, 333 árboles (mallas de bajo detalle del
complemento PCG Biome Sample de Epic), 8 cerros, el motor de avión de la exhibición, cielo y nubes. Las fachadas son texturas que genera
`entorno/fachadas.py` (una por pared, con ventanas; el nivel las importa solo). Antes: `entorno/entorno_u.py` y `entorno/fachadas.py`.

- `vuelo_canchas.py`: la secuencia `Vuelo_entre_canchas` (18 s): la cámara parte de la cancha de fútbol, sube, cruza y baja a las canchas
  cerradas, y vuelve (la misma curva que la tecla T de la estación web).
- Medido: la secuencia del vuelo (432 cuadros, 1080p) se renderiza en 2 min 24 s; armar el nivel, 71 s.
- Video: `04_VISOR_Y_MOTOR_GRAFICO/videos/vuelo_entre_canchas_unreal.mp4` (fuera de Git).
- `vegetacion.py` se borró: los árboles ahora los pone `entorno_u_ue.py` (las plántulas de Epic se veían como cartulina y se descartaron).

## Personas: maniquíes Manny y Quinn de la plantilla de Unreal (2026-10-19)

Las personas ya no son cilindros: son **Manny (ladrón, rojo)** y **Quinn (civil, azul)**, los maniquíes que el motor trae en
`Templates/TemplateResources/High/Characters/Content/Mannequins` (sin cuentas ni descargas). Se copiaron `Meshes`, `Rigs`,
`Materials`, `Textures` y `Anims/Unarmed` a `Content/Characters/Mannequins/` del proyecto (ESA ruta exacta: los archivos se
refieren entre sí con `/Game/Characters/Mannequins/...`). El Python de Unreal no trae NumPy, así que el trabajo se parte en dos:

| Archivo | Dónde corre | Qué hace |
|---|---|---|
| `maniquies_volcar.py` | Unreal (una vez) | Vuelca a `_cache/maniquies.json` los 161 huesos, su pose y las claves de reposo, caminar, trotar, salto, caída y aterrizaje |
| `maniquies_fk.py`, `maniquies_posturas.py`, `maniquies_ver.py` | Python del proyecto | Cuaternios, cinemática directa, las poses a mano (agachado, recostado, gateo) y dibujos de palitos para revisarlas sin abrir Unreal |
| `maniquies_animar.py`, `maniquies_replay.py` | Python del proyecto | La animación de cada persona a partir de foto(): velocidad, `pos0`/`pos`/`pt`, salto y rumbo |
| `maniquies_preparar.py` | Python del proyecto (lo llama `importar_repeticion.py`) | Escribe `_cache/preparado/` (animación en float32 y trayectoria por persona) |
| `maniquies_unreal.py` | Unreal | Crea el AnimSequence, el actor con el maniquí a la estatura de la persona y la pista de animación |
| `galeria_posturas.py` | Python del proyecto | Repetición sintética con todas las posturas, para revisar |

Lo aprendido: `AnimSequence.data_model` es `None` en los archivos de la plantilla (vienen sin datos de edición): las poses se
leen con `get_anim_pose_at_time` + `AnimPoseExtensions`; `AnimationLibrary.find_bone_path_to_root` tira el editor; un
AnimSequence nuevo solo acepta 30 cps (o múltiplo/factor de 30): se hornea a 30 y Sequencer lo reproduce por tiempo; la
velocidad real de la plantilla es 3 m/s al caminar y 6 m/s al trotar (movimiento de raíz) y el paso se ajusta con amplitud
y ritmo; el indicador `run` de foto() parpadea y no se usa. Alturas medidas con los huesos: de pie 1.00, agachado 0.67,
gateando 0.36 de la estatura (pruebas en `pruebas/test_maniquies.py`).
