brahianorrego/Talos-AI/01_MINIMO_INDISPENSABLE/informes/minimo_tesis_decisor_ia.csv

bloque | condicion | decisor | escenario | v | vuelo | exito | choque | activado | necesaria | innecesaria | omitida | t_detenido_s | parada_operador | riesgo_a_comando_s | dist_min_m
protocolo | Nominal | reglas | a_panel_1 |  | 0 | 1 | 0 | 1 | 1 | 0 | 0 | 10.1 | 0 | 0.1 | 1.728
protocolo | Nominal | reglas | a_panel_1 |  | 1 | 1 | 0 | 1 | 1 | 0 | 0 | 10.2 | 0 | 0.1 | 1.653
protocolo | Nominal | reglas | a_panel_1 |  | 2 | 1 | 0 | 1 | 1 | 0 | 0 | 10.1 | 0 | 0.1 | 1.336
protocolo | Nominal | reglas | a_panel_1 |  | 3 | 1 | 0 | 1 | 1 | 0 | 0 | 10.0 | 0 | 0.1 | 1.749
protocolo | Nominal | reglas | a_panel_1 |  | 4 | 1 | 0 | 1 | 1 | 0 | 0 | 10.3 | 0 | 0.1 | 1.688
protocolo | Nominal | reglas | a_panel_1 |  | 5 | 1 | 0 | 1 | 1 | 0 | 0 | 10.2 | 0 | 0.1 | 1.773
protocolo | Nominal | reglas | a_panel_1 |  | 6 | 1 | 0 | 1 | 1 | 0 | 0 | 10.3 | 0 | 0.0 | 1.63
protocolo | Nominal | reglas | a_panel_1 |  | 7 | 1 | 0 | 1 | 1 | 0 | 0 | 10.3 | 0 | 0.2 | 1.747
protocolo | Nominal | reglas | a_panel_1 |  | 8 | 1 | 0 | 1 | 1 | 0 | 0 | 9.9 | 0 | 0.1 | 1.656
protocolo | Nominal | reglas | a_panel_1 |  | 9 | 1 | 0 | 1 | 1 | 0 | 0 | 10.3 | 0 | 0.0 | 1.961
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
