brahianorrego/Talos-AI/01_MINIMO_INDISPENSABLE/informes/minimo_tesis_degradadas.csv

tipo | condicion | escenario | v | n | exito | exito_sin_operador | choques | act_falsas | paradas_operador
escenario | Nominal | a_panel_1 | 1.0 | 100 | 100 | 100 | 0 | 0 | 0
escenario | Nominal | a_panel_2 | 2.0 | 100 | 100 | 100 | 0 | 0 | 0
escenario | Nominal | a_panel_3 | 3.0 | 100 | 100 | 100 | 0 | 0 | 0
escenario | Nominal | a_panel_4 | 4.0 | 100 | 100 | 100 | 0 | 0 | 0
escenario | Nominal | b_quieta_1.5 | 1.5 | 100 | 100 | 100 | 0 | 0 | 0
escenario | Nominal | b_quieta_3.0 | 3.0 | 100 | 100 | 100 | 0 | 0 | 0
escenario | Nominal | c_frente_camina | 1.0 | 100 | 100 | 100 | 0 | 0 | 0
escenario | Nominal | c_frente_corre | 1.0 | 100 | 100 | 72 | 0 | 0 | 28
escenario | Nominal | d_cruza_camina | 1.0 | 100 | 100 | 100 | 0 | 0 | 0
escenario | Nominal | d_cruza_corre | 1.0 | 100 | 100 | 100 | 0 | 0 | 0
escenario | Nominal | e_estatico_camina | 0.0 | 100 | 100 | 100 | 0 | 0 | 0
escenario | Nominal | e_estatico_corre | 0.0 | 100 | 100 | 100 | 0 | 0 | 0
escenario | Nominal | e_estatico_lado | 0.0 | 100 | 100 | 100 | 0 | 0 | 0
barrido | Nominal | a_panel_1 | 1.0 | 100 | 100 | 100 | 0 | 0 | 0
barrido | Nominal | a_panel_1 | 2.0 | 100 | 100 | 100 | 0 | 0 | 0
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
