brahianorrego/Talos-AI/01_MINIMO_INDISPENSABLE/informes/minimo_tesis_protocolo.csv

escenario | grupo | vuelo | semilla | debe_activar | exito | activado | act_verdadera | act_falsa | riesgo_real | eventos_riesgo | choque | parada_operador | lat_riesgo_comando_s | lat_comando_frenado_s | lat_comando_fuera_alcance_s | dist_min_m | z_final_m | seguro_sin_sistema | choque_sin_sistema | parada_sin_sistema
a_panel_1 | a | 0 | 2026 | 1 | 1 | 1 | 1 | 0 | 1 | 1 | 0 | 0 | 0.1 | 0.6 | 0.4 | 1.728 | 3.538 | 0 | 0 | 1
a_panel_1 | a | 1 | 2026 | 1 | 1 | 1 | 1 | 0 | 1 | 1 | 0 | 0 | 0.1 | 0.6 | 0.4 | 1.653 | 3.538 | 0 | 0 | 1
a_panel_1 | a | 2 | 2026 | 1 | 1 | 1 | 1 | 0 | 1 | 1 | 0 | 0 | 0.1 | 0.6 | 0.4 | 1.336 | 3.538 | 0 | 0 | 1
a_panel_1 | a | 3 | 2026 | 1 | 1 | 1 | 1 | 0 | 1 | 1 | 0 | 0 | 0.1 | 0.6 | 0.4 | 1.749 | 3.538 | 0 | 0 | 1
a_panel_1 | a | 4 | 2026 | 1 | 1 | 1 | 1 | 0 | 1 | 1 | 0 | 0 | 0.1 | 0.6 | 0.4 | 1.688 | 3.539 | 0 | 0 | 1
a_panel_1 | a | 5 | 2026 | 1 | 1 | 1 | 1 | 0 | 1 | 1 | 0 | 0 | 0.1 | 0.6 | 0.4 | 1.773 | 3.538 | 0 | 0 | 1
a_panel_1 | a | 6 | 2026 | 1 | 1 | 1 | 1 | 0 | 1 | 1 | 0 | 0 | 0.0 | 0.6 | 0.4 | 1.63 | 3.539 | 0 | 0 | 1
a_panel_1 | a | 7 | 2026 | 1 | 1 | 1 | 1 | 0 | 1 | 1 | 0 | 0 | 0.2 | 0.6 | 0.4 | 1.747 | 3.539 | 0 | 0 | 1
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
