brahianorrego/Talos-AI/04_VISOR_Y_MOTOR_GRAFICO/arboles/abedul.fbm/corteza.png

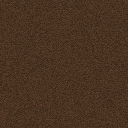
04_VISOR_Y_MOTOR_GRAFICO/arboles/abedul.fbm/corteza.png
