brahianorrego/Talos-AI/04_VISOR_Y_MOTOR_GRAFICO/arboles/tex/hoja_abeto.png

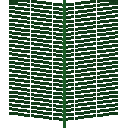
04_VISOR_Y_MOTOR_GRAFICO/arboles/tex/hoja_abeto.png
