brahianorrego/Talos-AI/04_VISOR_Y_MOTOR_GRAFICO/arboles/tex/hoja_alamo.png

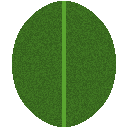
04_VISOR_Y_MOTOR_GRAFICO/arboles/tex/hoja_alamo.png
