brahianorrego/Talos-AI/04_VISOR_Y_MOTOR_GRAFICO/boceto_interfaz.png

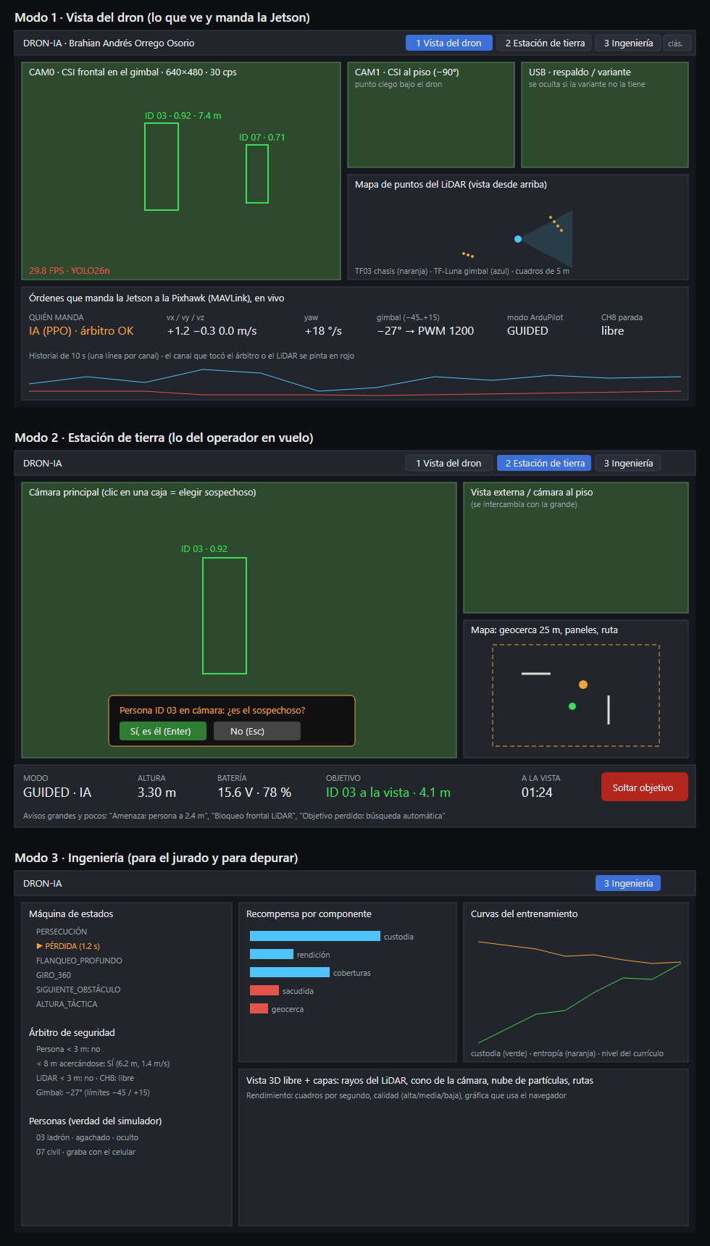
04_VISOR_Y_MOTOR_GRAFICO/boceto_interfaz.png
