brahianorrego/Talos-AI/04_VISOR_Y_MOTOR_GRAFICO/mediciones/capturas/campus_nuevo_4.png

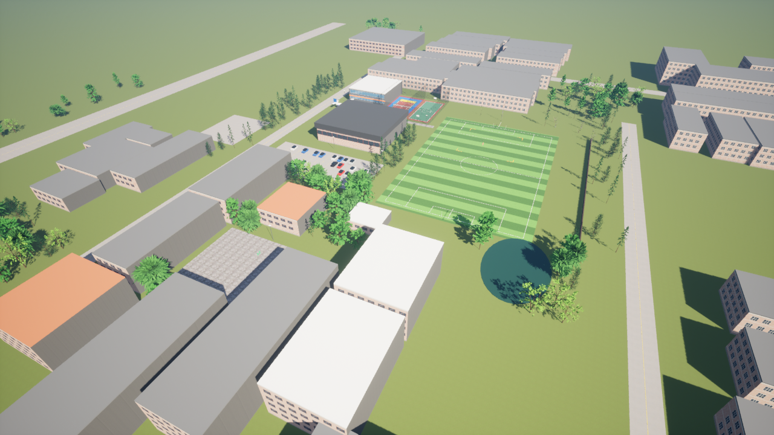
04_VISOR_Y_MOTOR_GRAFICO/mediciones/capturas/campus_nuevo_4.png
