brahianorrego/Talos-AI/04_VISOR_Y_MOTOR_GRAFICO/mediciones/capturas/cesped_2a3m_final.jpg

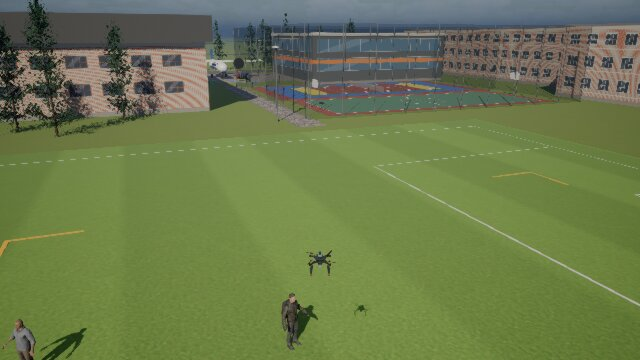
04_VISOR_Y_MOTOR_GRAFICO/mediciones/capturas/cesped_2a3m_final.jpg
