brahianorrego/Talos-AI/04_VISOR_Y_MOTOR_GRAFICO/mediciones/capturas/cesped_aerea_final.jpg

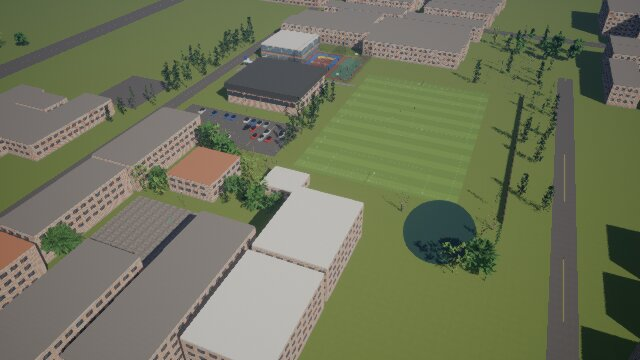
04_VISOR_Y_MOTOR_GRAFICO/mediciones/capturas/cesped_aerea_final.jpg
