brahianorrego/Talos-AI/04_VISOR_Y_MOTOR_GRAFICO/mediciones/capturas/cesped_cam0_final.jpg

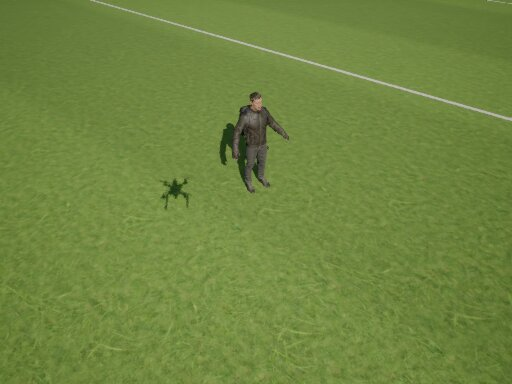
04_VISOR_Y_MOTOR_GRAFICO/mediciones/capturas/cesped_cam0_final.jpg
