brahianorrego/Talos-AI/04_VISOR_Y_MOTOR_GRAFICO/mediciones/capturas/csi2_cuadricula.png

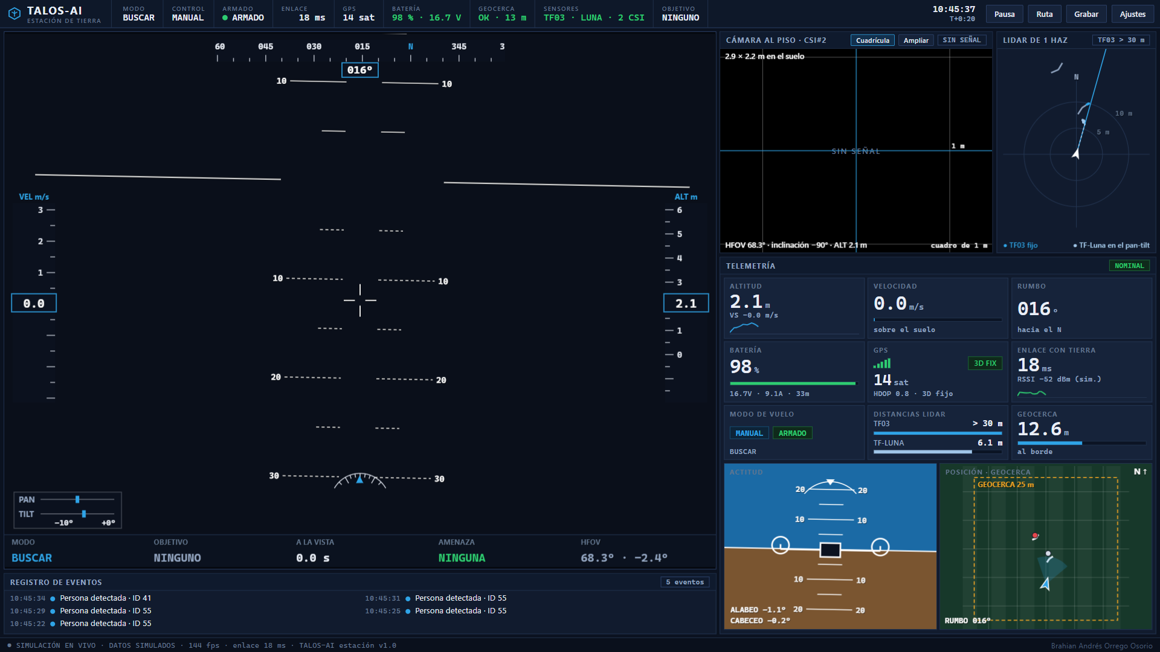
04_VISOR_Y_MOTOR_GRAFICO/mediciones/capturas/csi2_cuadricula.png
