brahianorrego/Talos-AI/04_VISOR_Y_MOTOR_GRAFICO/mediciones/capturas/csi2_grande.png

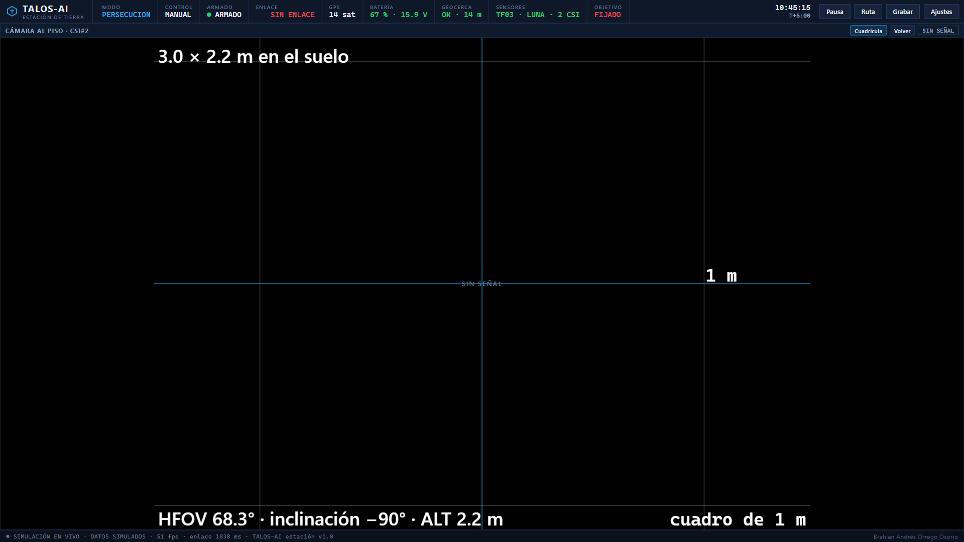
04_VISOR_Y_MOTOR_GRAFICO/mediciones/capturas/csi2_grande.png
