brahianorrego/Talos-AI/04_VISOR_Y_MOTOR_GRAFICO/mediciones/capturas/dron_real_en_visor.jpg

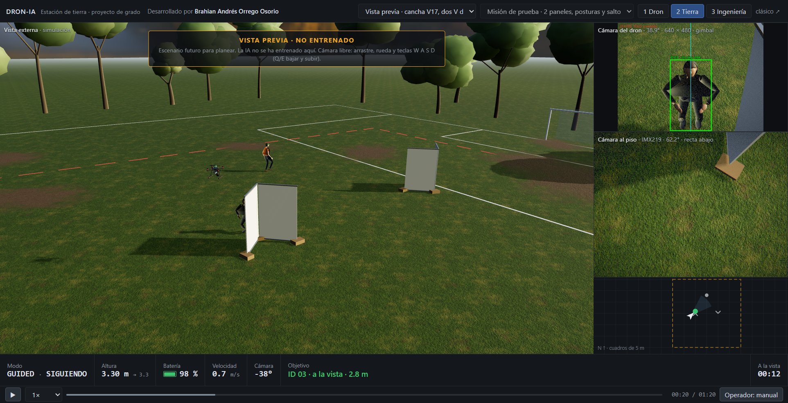
04_VISOR_Y_MOTOR_GRAFICO/mediciones/capturas/dron_real_en_visor.jpg
