brahianorrego/Talos-AI/04_VISOR_Y_MOTOR_GRAFICO/mediciones/capturas/estacion_camara_csi_fija.jpg

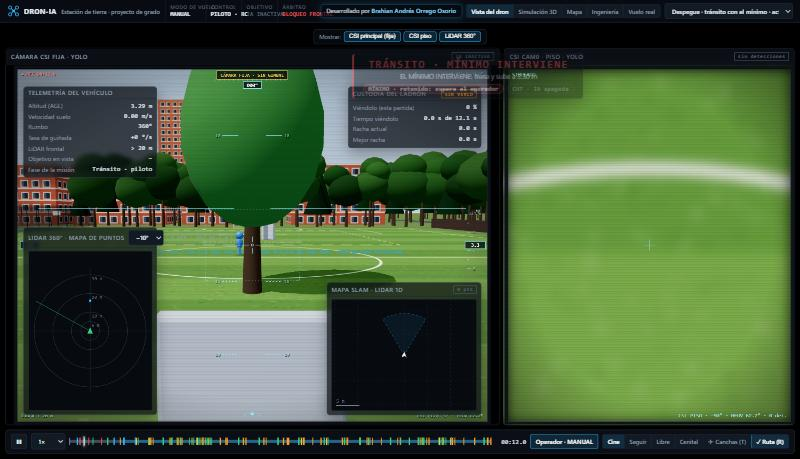
04_VISOR_Y_MOTOR_GRAFICO/mediciones/capturas/estacion_camara_csi_fija.jpg
