brahianorrego/Talos-AI/04_VISOR_Y_MOTOR_GRAFICO/mediciones/capturas/estacion_dron_plus_pantilt.jpg

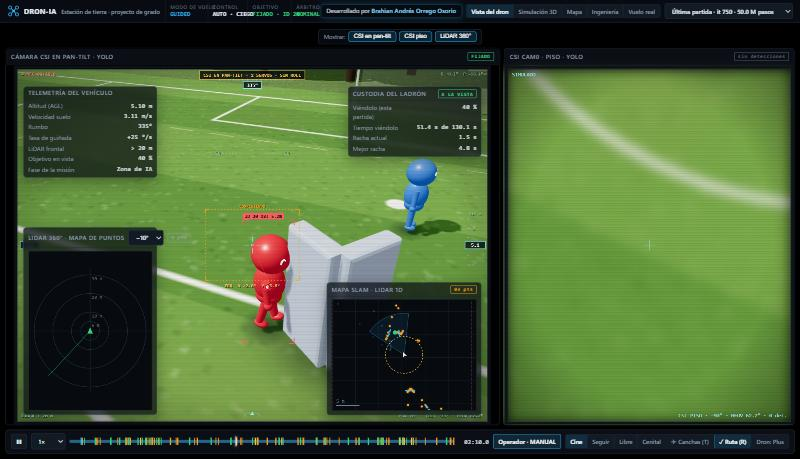
04_VISOR_Y_MOTOR_GRAFICO/mediciones/capturas/estacion_dron_plus_pantilt.jpg
