brahianorrego/Talos-AI/04_VISOR_Y_MOTOR_GRAFICO/mediciones/capturas/estacion_ensenar_mapa.png

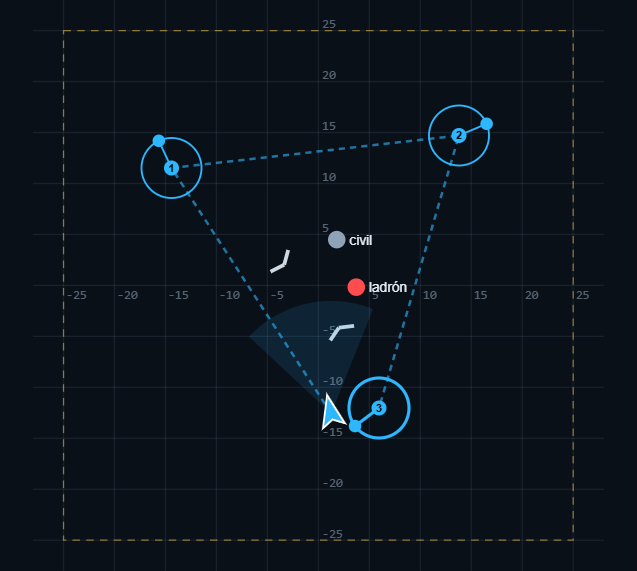
04_VISOR_Y_MOTOR_GRAFICO/mediciones/capturas/estacion_ensenar_mapa.png
