brahianorrego/Talos-AI/04_VISOR_Y_MOTOR_GRAFICO/mediciones/capturas/estacion_modo_mapa_zoom.jpg

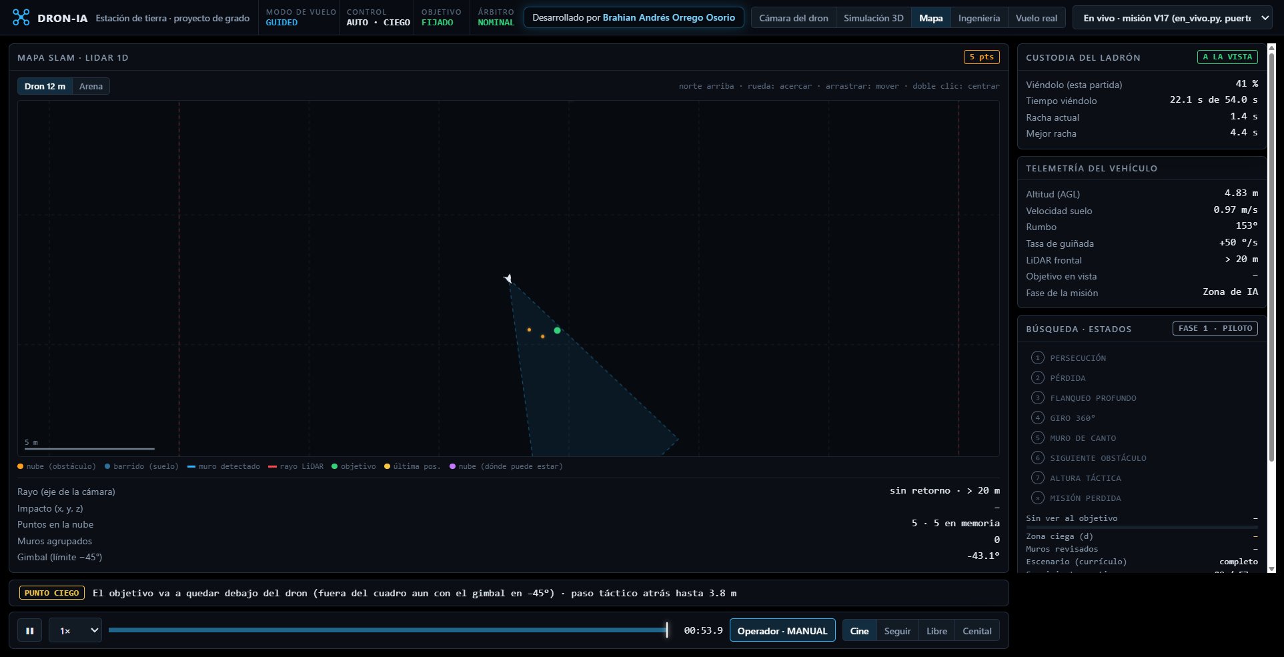
04_VISOR_Y_MOTOR_GRAFICO/mediciones/capturas/estacion_modo_mapa_zoom.jpg
