brahianorrego/Talos-AI/04_VISOR_Y_MOTOR_GRAFICO/mediciones/capturas/estacion_modo_vuelo.jpg

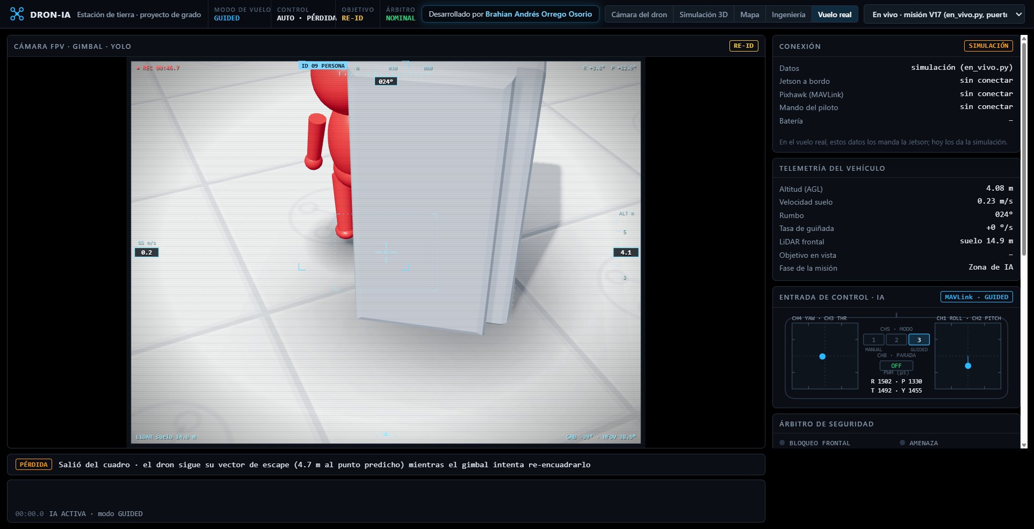
04_VISOR_Y_MOTOR_GRAFICO/mediciones/capturas/estacion_modo_vuelo.jpg
