brahianorrego/Talos-AI/04_VISOR_Y_MOTOR_GRAFICO/mediciones/capturas/estacion_mundo_personas.png

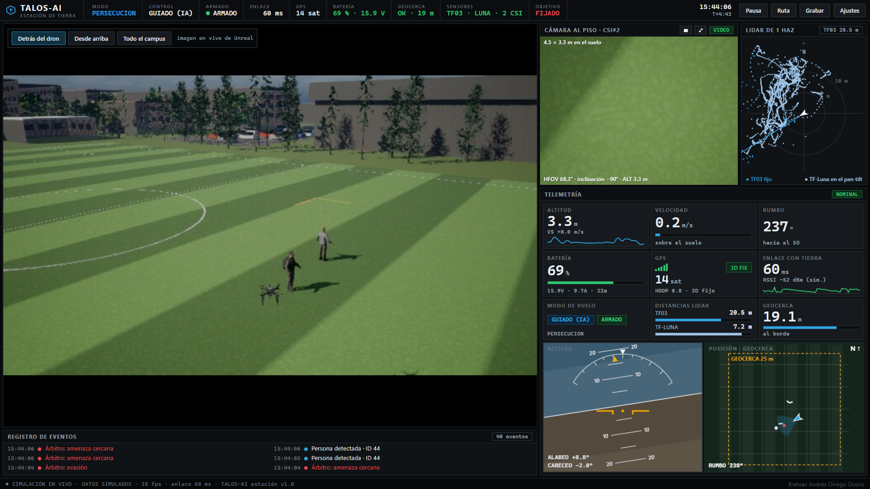
04_VISOR_Y_MOTOR_GRAFICO/mediciones/capturas/estacion_mundo_personas.png
