brahianorrego/Talos-AI/04_VISOR_Y_MOTOR_GRAFICO/mediciones/capturas/estacion_personas_dron.png

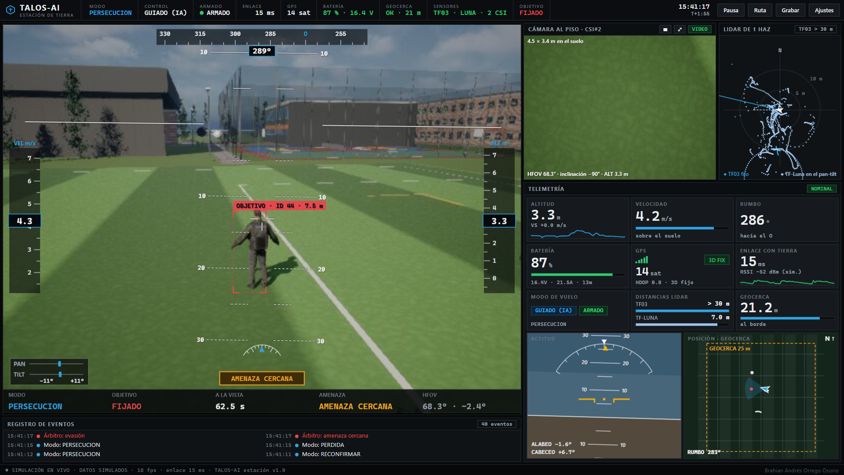
04_VISOR_Y_MOTOR_GRAFICO/mediciones/capturas/estacion_personas_dron.png
