brahianorrego/Talos-AI/04_VISOR_Y_MOTOR_GRAFICO/mediciones/capturas/estacion_plus_repeticion_h_ruta.jpg

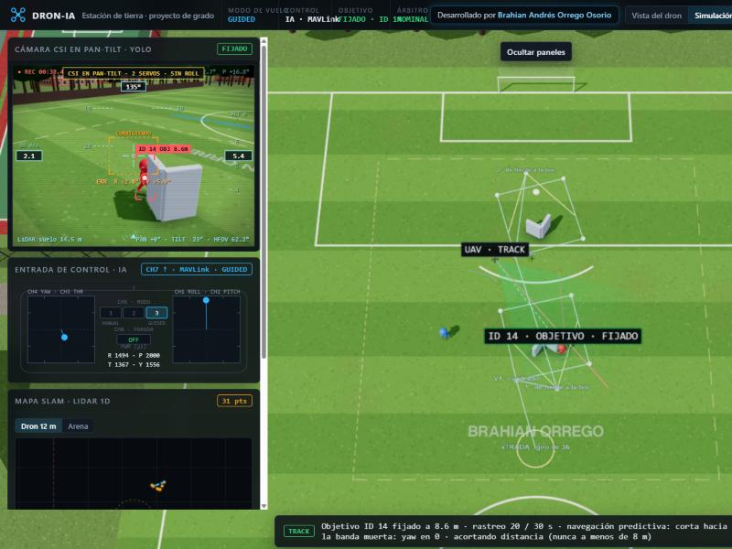
04_VISOR_Y_MOTOR_GRAFICO/mediciones/capturas/estacion_plus_repeticion_h_ruta.jpg
