brahianorrego/Talos-AI/04_VISOR_Y_MOTOR_GRAFICO/mediciones/capturas/estacion_ruta_de_busqueda.jpg

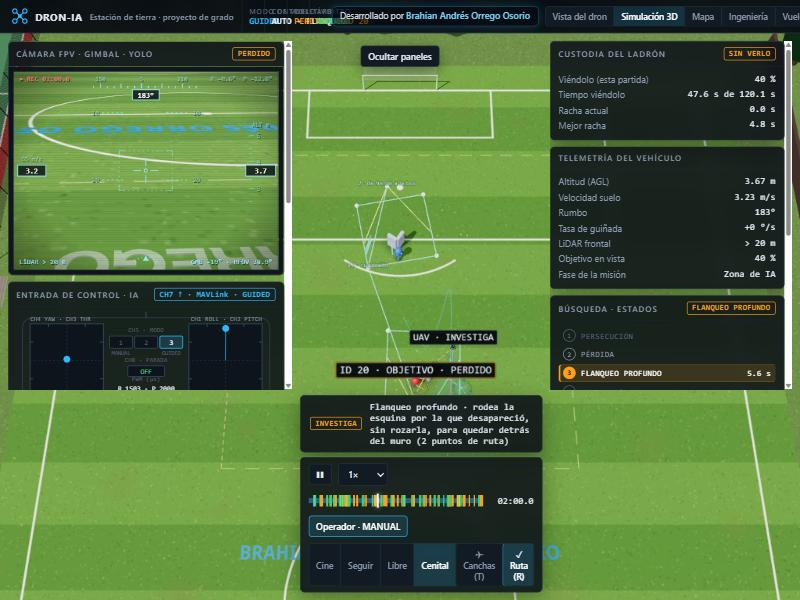
04_VISOR_Y_MOTOR_GRAFICO/mediciones/capturas/estacion_ruta_de_busqueda.jpg
