brahianorrego/Talos-AI/04_VISOR_Y_MOTOR_GRAFICO/mediciones/capturas/estacion_vista_dron_tres_camaras.jpg

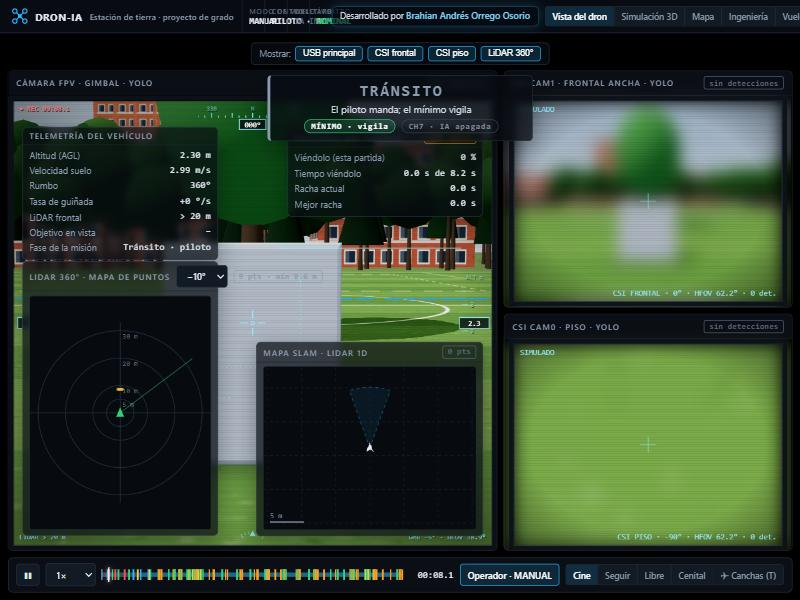
04_VISOR_Y_MOTOR_GRAFICO/mediciones/capturas/estacion_vista_dron_tres_camaras.jpg
