brahianorrego/Talos-AI/04_VISOR_Y_MOTOR_GRAFICO/mediciones/capturas/mapa_satelital_1920x1080.png

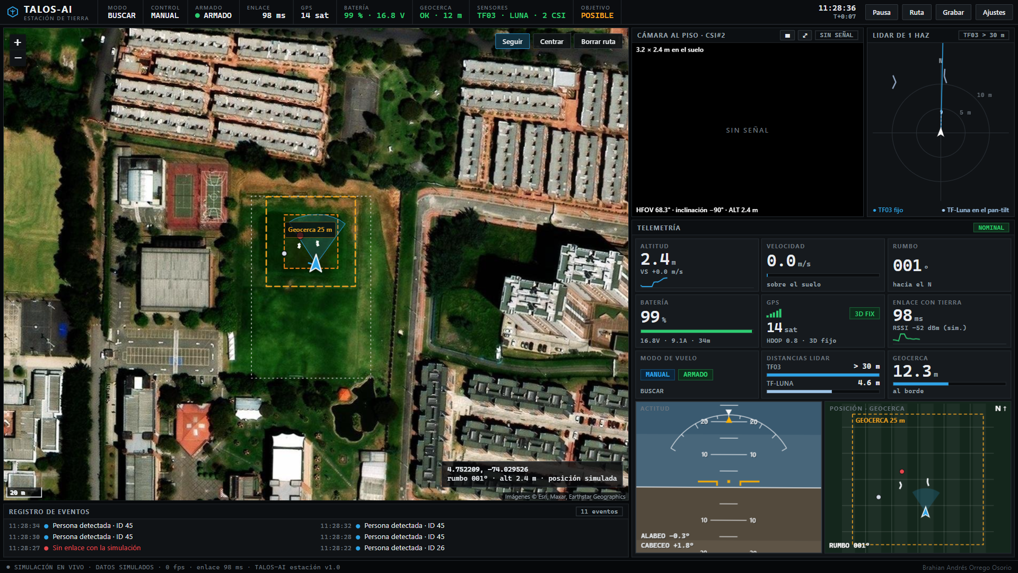
04_VISOR_Y_MOTOR_GRAFICO/mediciones/capturas/mapa_satelital_1920x1080.png
