brahianorrego/Talos-AI/04_VISOR_Y_MOTOR_GRAFICO/mediciones/capturas/menu_ayuda_1920x1080.png

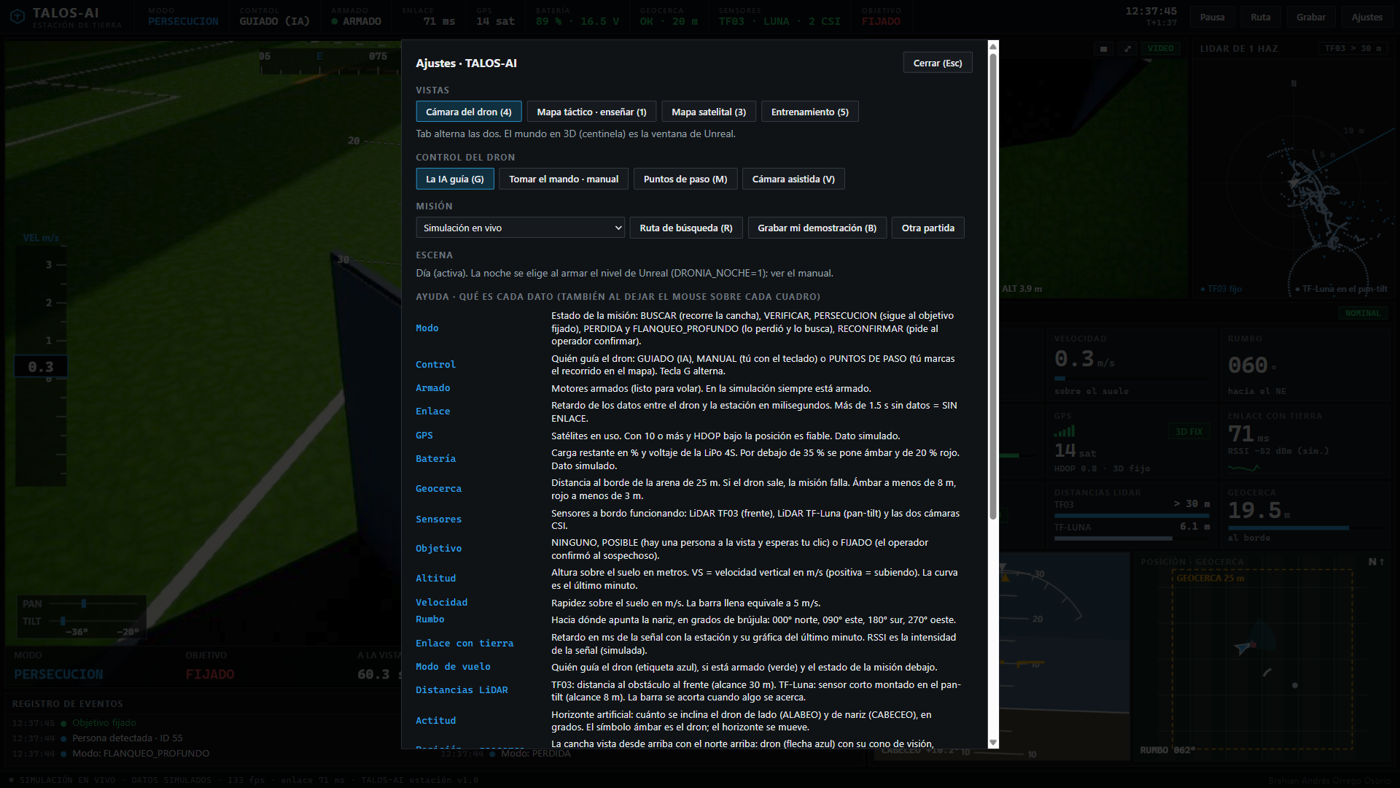
04_VISOR_Y_MOTOR_GRAFICO/mediciones/capturas/menu_ayuda_1920x1080.png
