brahianorrego/Talos-AI/04_VISOR_Y_MOTOR_GRAFICO/mediciones/capturas/mundo3d_estacion_1920x1080.png

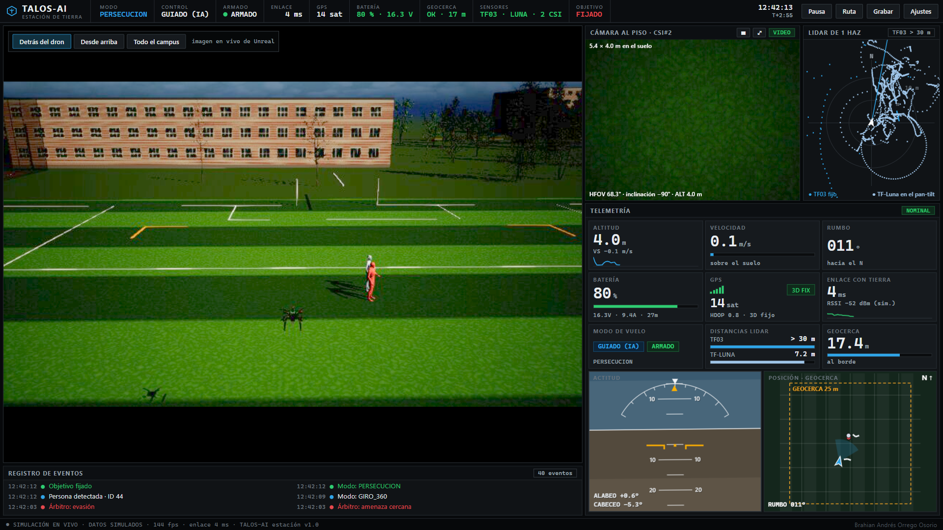
04_VISOR_Y_MOTOR_GRAFICO/mediciones/capturas/mundo3d_estacion_1920x1080.png
