brahianorrego/Talos-AI/04_VISOR_Y_MOTOR_GRAFICO/mediciones/capturas/personas_cerca_2.png

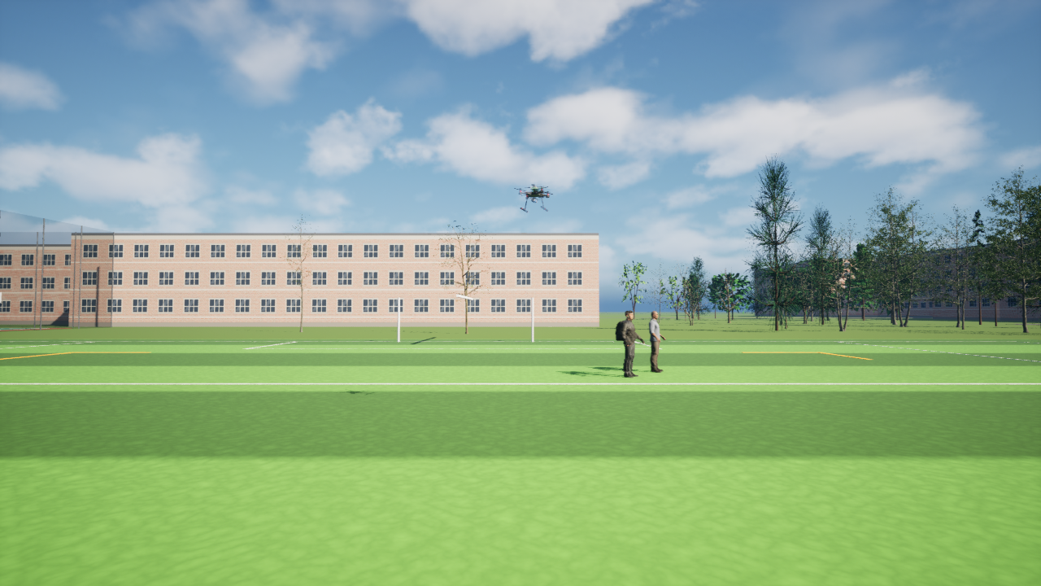
04_VISOR_Y_MOTOR_GRAFICO/mediciones/capturas/personas_cerca_2.png
