brahianorrego/Talos-AI/04_VISOR_Y_MOTOR_GRAFICO/mediciones/capturas/regla4_esperando_operador.jpg

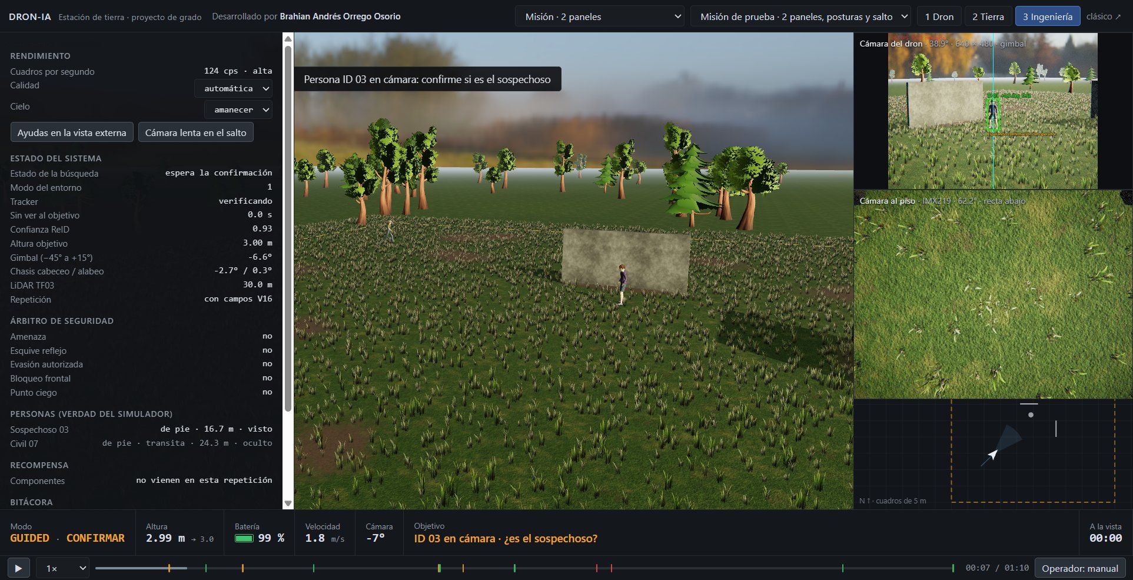
04_VISOR_Y_MOTOR_GRAFICO/mediciones/capturas/regla4_esperando_operador.jpg
