brahianorrego/Talos-AI/04_VISOR_Y_MOTOR_GRAFICO/mediciones/capturas/una_pantalla_juntas.png

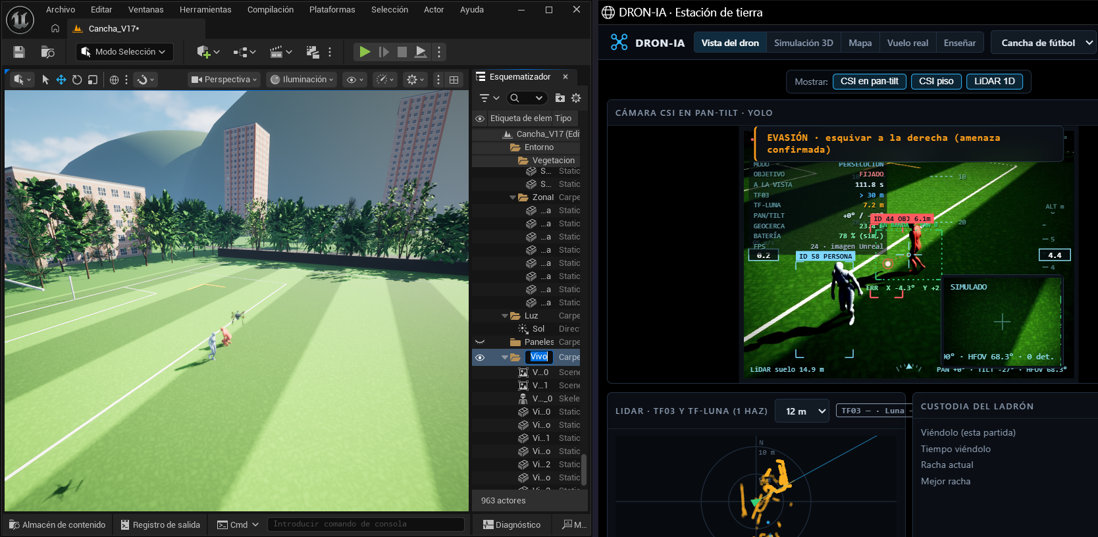
04_VISOR_Y_MOTOR_GRAFICO/mediciones/capturas/una_pantalla_juntas.png
