brahianorrego/Talos-AI/04_VISOR_Y_MOTOR_GRAFICO/mediciones/capturas/una_pantalla_vista_del_dron.png

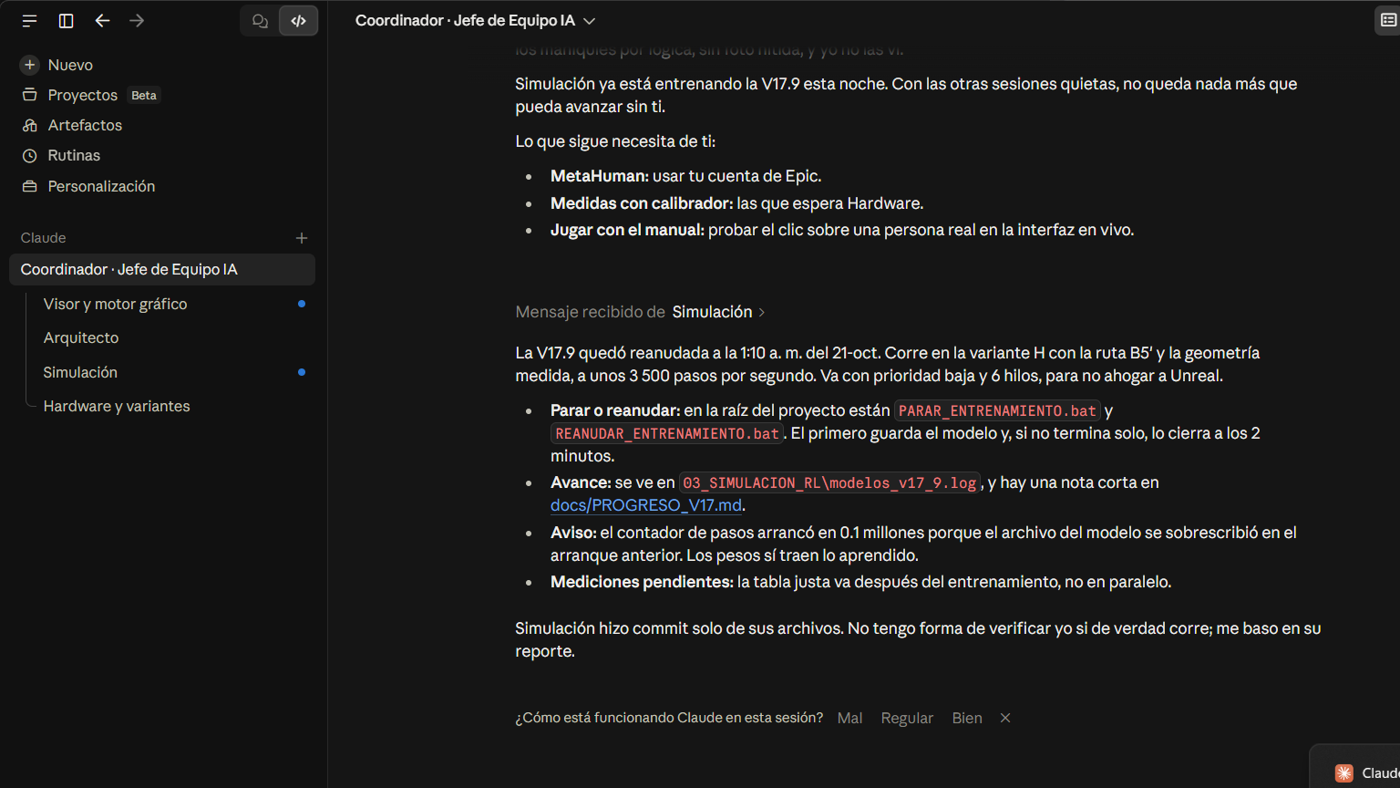
04_VISOR_Y_MOTOR_GRAFICO/mediciones/capturas/una_pantalla_vista_del_dron.png
