brahianorrego/Talos-AI/04_VISOR_Y_MOTOR_GRAFICO/mediciones/capturas/universidad_canchas_cerradas.jpg

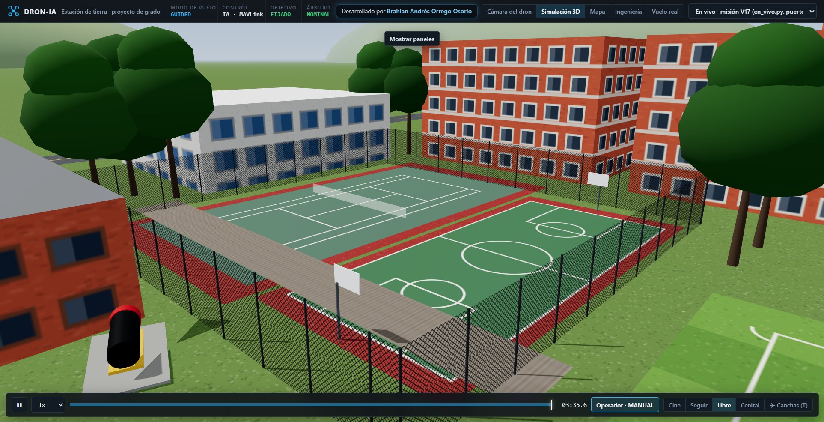
04_VISOR_Y_MOTOR_GRAFICO/mediciones/capturas/universidad_canchas_cerradas.jpg
