brahianorrego/Talos-AI/04_VISOR_Y_MOTOR_GRAFICO/mediciones/capturas/universidad_desde_campo.jpg

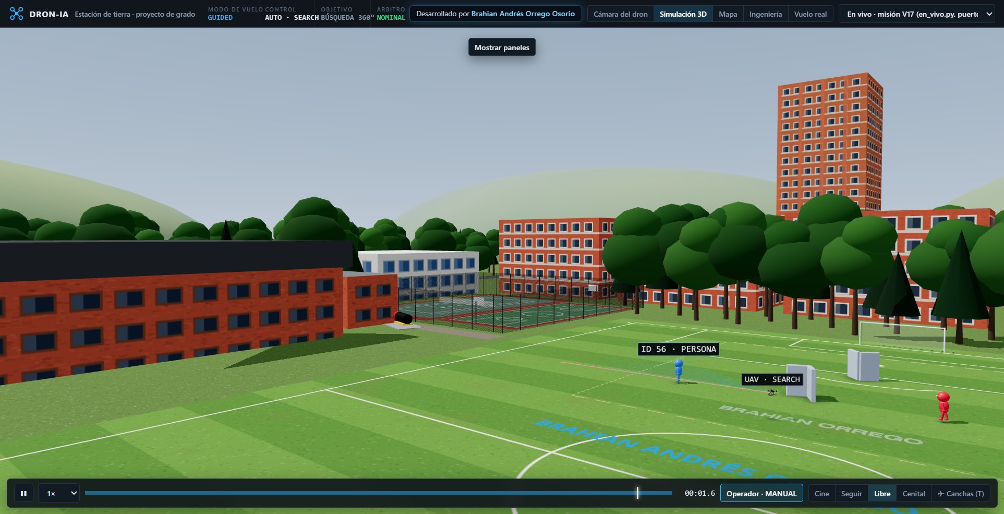
04_VISOR_Y_MOTOR_GRAFICO/mediciones/capturas/universidad_desde_campo.jpg
