brahianorrego/Talos-AI/04_VISOR_Y_MOTOR_GRAFICO/mediciones/capturas/unreal_campus_halos_0.png

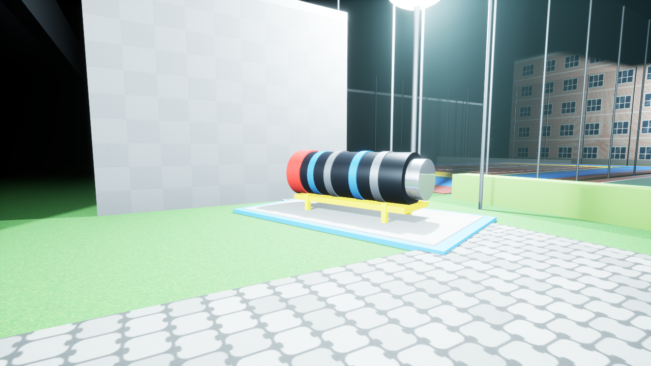
04_VISOR_Y_MOTOR_GRAFICO/mediciones/capturas/unreal_campus_halos_0.png
