brahianorrego/Talos-AI/04_VISOR_Y_MOTOR_GRAFICO/mediciones/capturas/unreal_clip_plus_pan_tilt.jpg

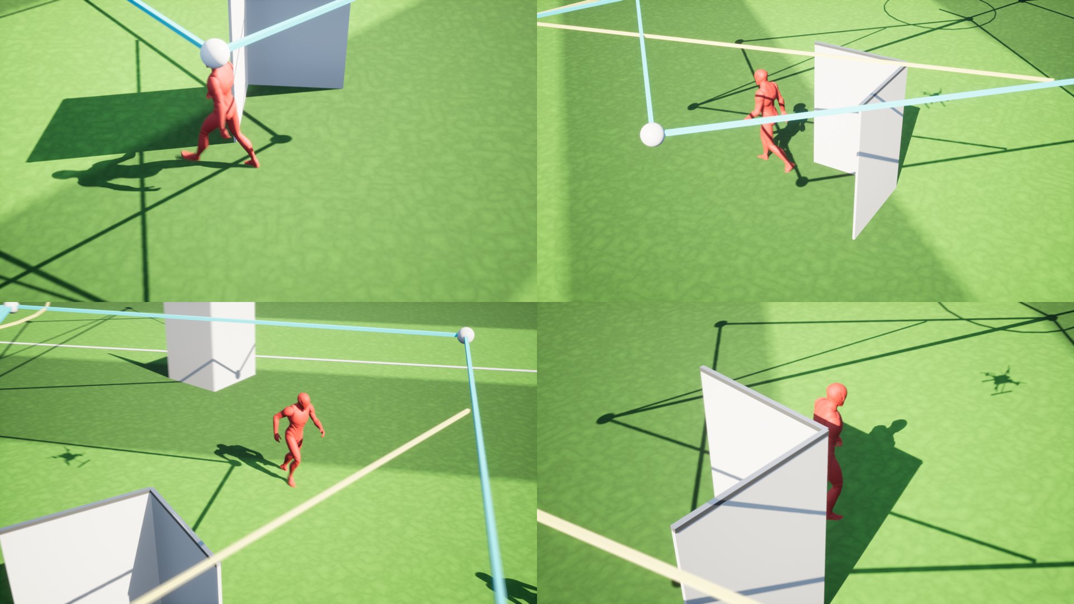
04_VISOR_Y_MOTOR_GRAFICO/mediciones/capturas/unreal_clip_plus_pan_tilt.jpg
