brahianorrego/Talos-AI/04_VISOR_Y_MOTOR_GRAFICO/mediciones/capturas/unreal_dron_real.jpg

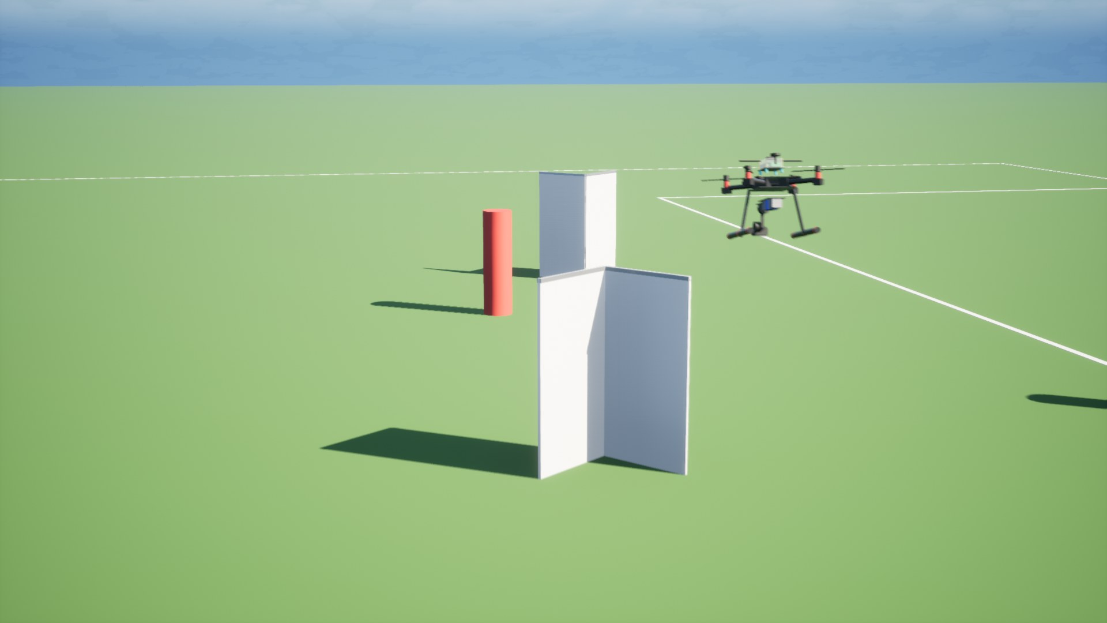
04_VISOR_Y_MOTOR_GRAFICO/mediciones/capturas/unreal_dron_real.jpg
