brahianorrego/Talos-AI/04_VISOR_Y_MOTOR_GRAFICO/mediciones/capturas/unreal_en_vivo_dron_cerca.png

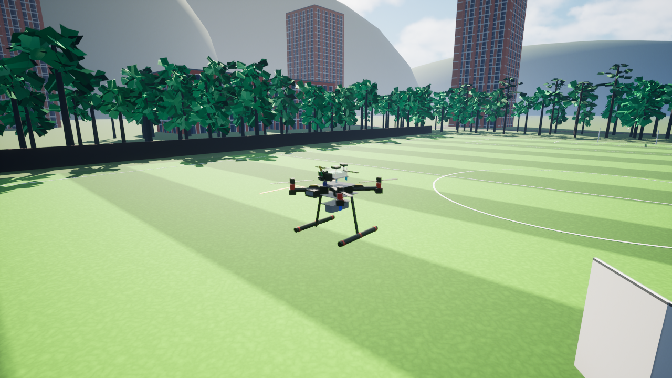
04_VISOR_Y_MOTOR_GRAFICO/mediciones/capturas/unreal_en_vivo_dron_cerca.png
