brahianorrego/Talos-AI/04_VISOR_Y_MOTOR_GRAFICO/mediciones/capturas/unreal_juego_en_vivo.png

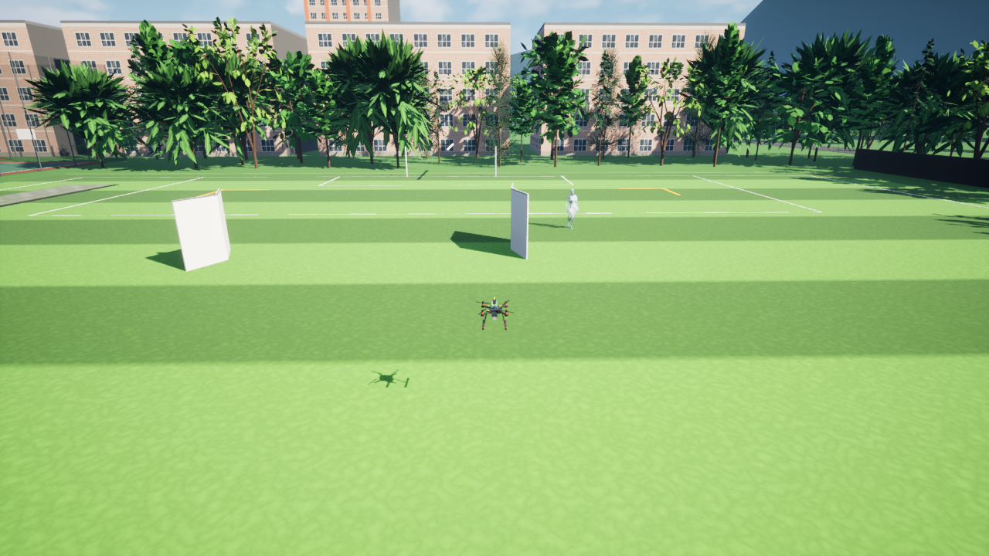
04_VISOR_Y_MOTOR_GRAFICO/mediciones/capturas/unreal_juego_en_vivo.png
