brahianorrego/Talos-AI/04_VISOR_Y_MOTOR_GRAFICO/mediciones/capturas/unreal_maniquies_agachado.jpg

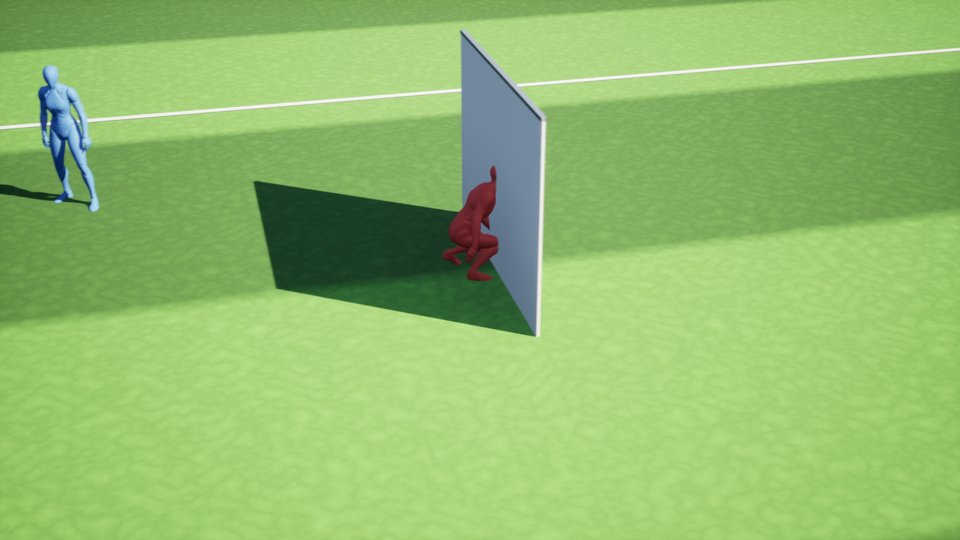
04_VISOR_Y_MOTOR_GRAFICO/mediciones/capturas/unreal_maniquies_agachado.jpg
