brahianorrego/Talos-AI/04_VISOR_Y_MOTOR_GRAFICO/mediciones/capturas/unreal_maniquies_gateo.jpg

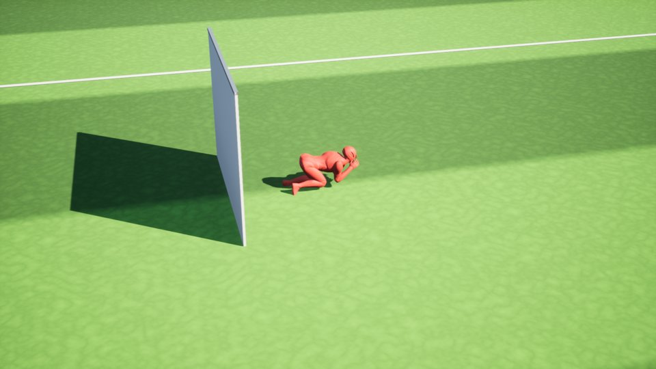
04_VISOR_Y_MOTOR_GRAFICO/mediciones/capturas/unreal_maniquies_gateo.jpg
