brahianorrego/Talos-AI/04_VISOR_Y_MOTOR_GRAFICO/mediciones/capturas/unreal_maniquies_vivo_posturas.png

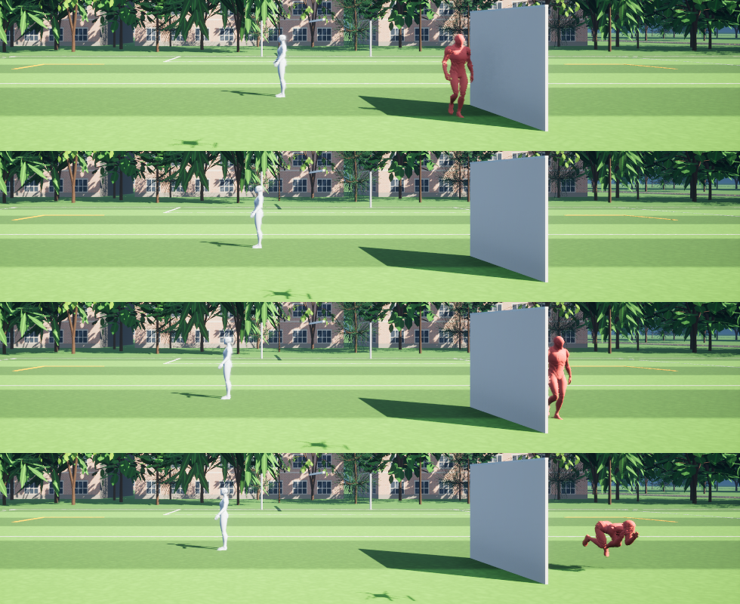
04_VISOR_Y_MOTOR_GRAFICO/mediciones/capturas/unreal_maniquies_vivo_posturas.png
