brahianorrego/Talos-AI/04_VISOR_Y_MOTOR_GRAFICO/mediciones/capturas/unreal_mision_panel.jpg

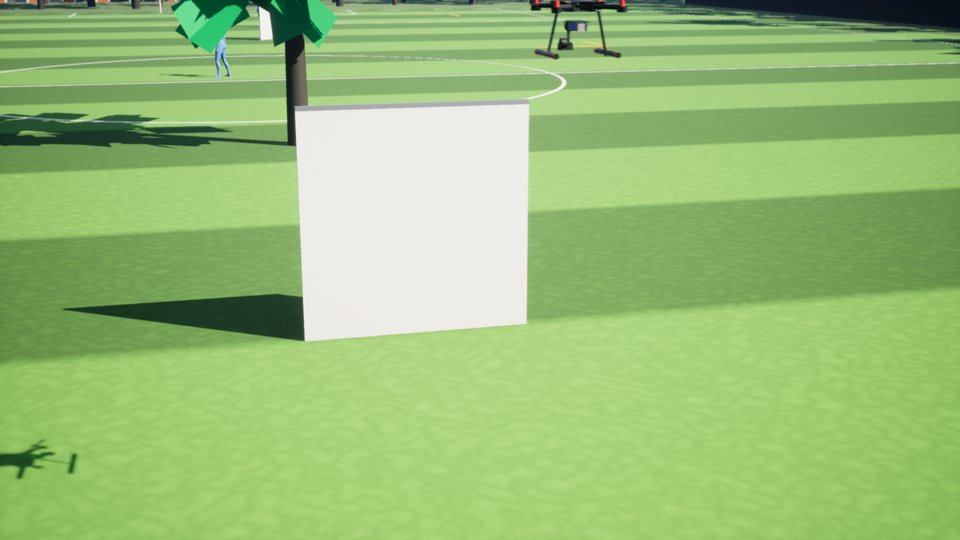
04_VISOR_Y_MOTOR_GRAFICO/mediciones/capturas/unreal_mision_panel.jpg
