brahianorrego/Talos-AI/04_VISOR_Y_MOTOR_GRAFICO/mediciones/capturas/unreal_mision_persona.jpg

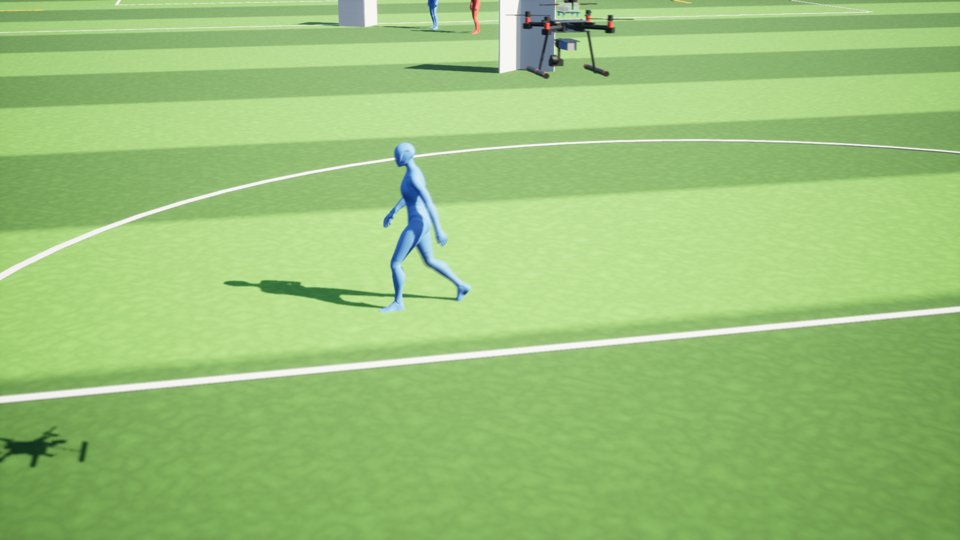
04_VISOR_Y_MOTOR_GRAFICO/mediciones/capturas/unreal_mision_persona.jpg
