brahianorrego/Talos-AI/04_VISOR_Y_MOTOR_GRAFICO/mediciones/capturas/unreal_partida_0500.jpg

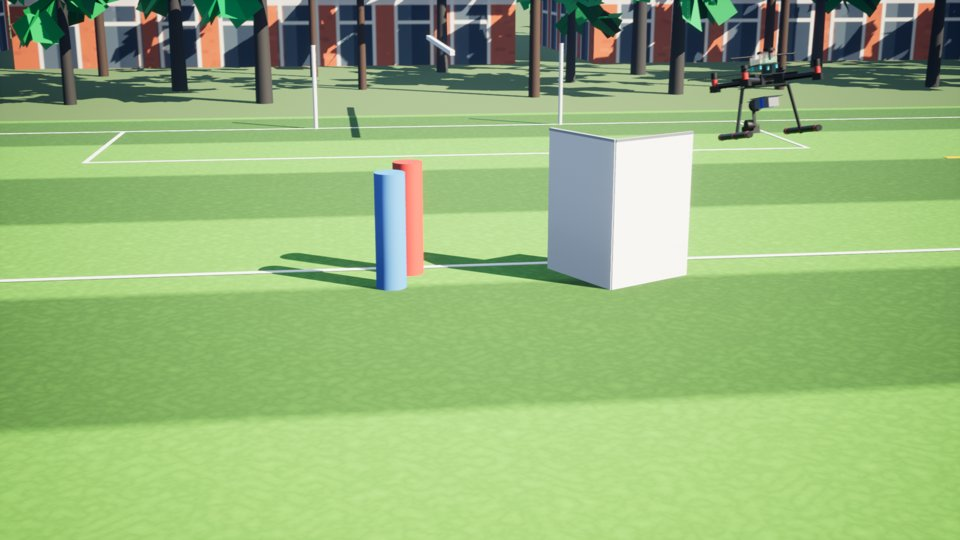
04_VISOR_Y_MOTOR_GRAFICO/mediciones/capturas/unreal_partida_0500.jpg
