brahianorrego/Talos-AI/04_VISOR_Y_MOTOR_GRAFICO/mediciones/capturas/unreal_partida_5500.jpg

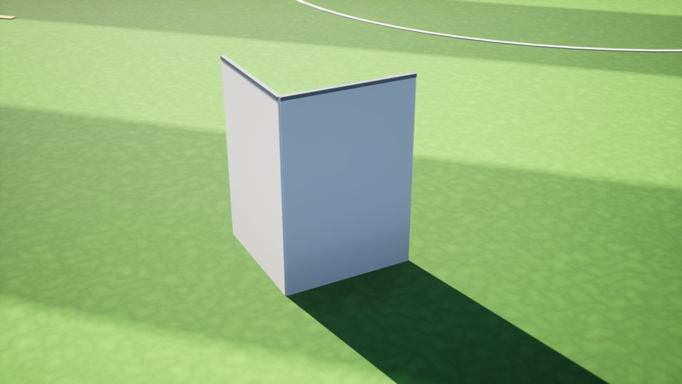
04_VISOR_Y_MOTOR_GRAFICO/mediciones/capturas/unreal_partida_5500.jpg
