brahianorrego/Talos-AI/04_VISOR_Y_MOTOR_GRAFICO/mediciones/capturas/unreal_vuelo_inicio.jpg

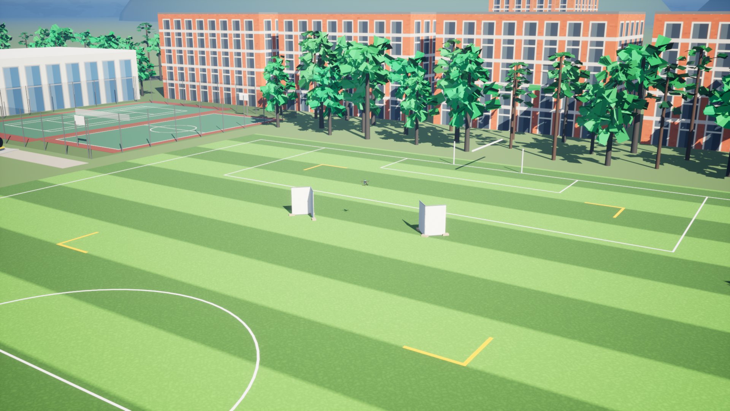
04_VISOR_Y_MOTOR_GRAFICO/mediciones/capturas/unreal_vuelo_inicio.jpg
