brahianorrego/Talos-AI/04_VISOR_Y_MOTOR_GRAFICO/mediciones/capturas/unreal_vuelo_llegada.jpg

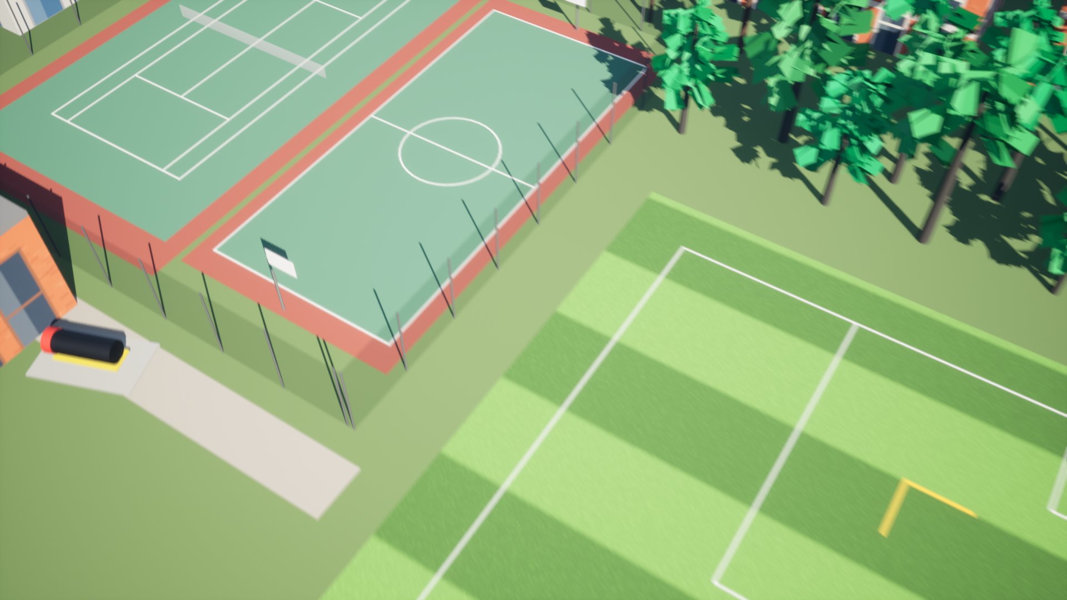
04_VISOR_Y_MOTOR_GRAFICO/mediciones/capturas/unreal_vuelo_llegada.jpg
