brahianorrego/Talos-AI/04_VISOR_Y_MOTOR_GRAFICO/mediciones/capturas/unreal_vuelo_subiendo.jpg

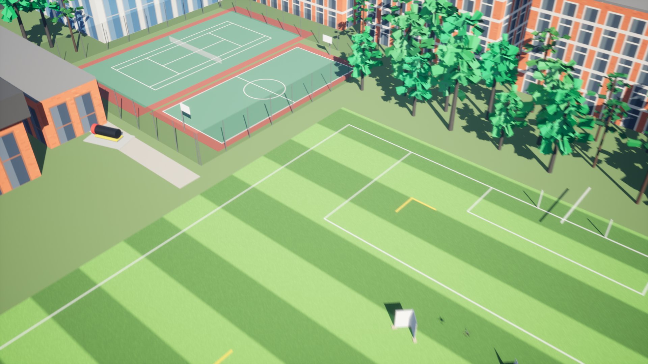
04_VISOR_Y_MOTOR_GRAFICO/mediciones/capturas/unreal_vuelo_subiendo.jpg
