brahianorrego/Talos-AI/04_VISOR_Y_MOTOR_GRAFICO/mediciones/capturas/v2_personas_visor.jpg

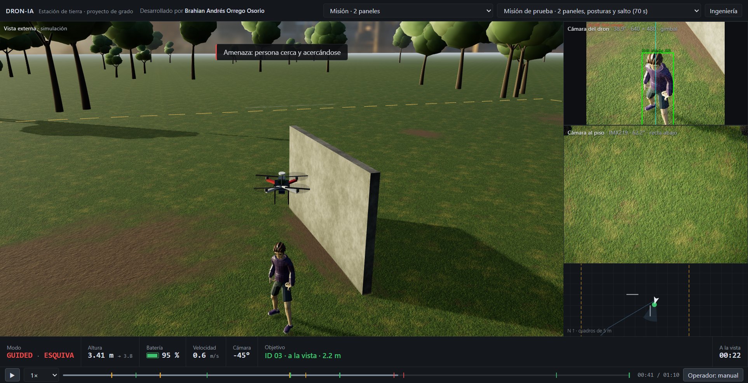
04_VISOR_Y_MOTOR_GRAFICO/mediciones/capturas/v2_personas_visor.jpg
