brahianorrego/Talos-AI/04_VISOR_Y_MOTOR_GRAFICO/mediciones/capturas/v3_cancha_naturaleza.jpg

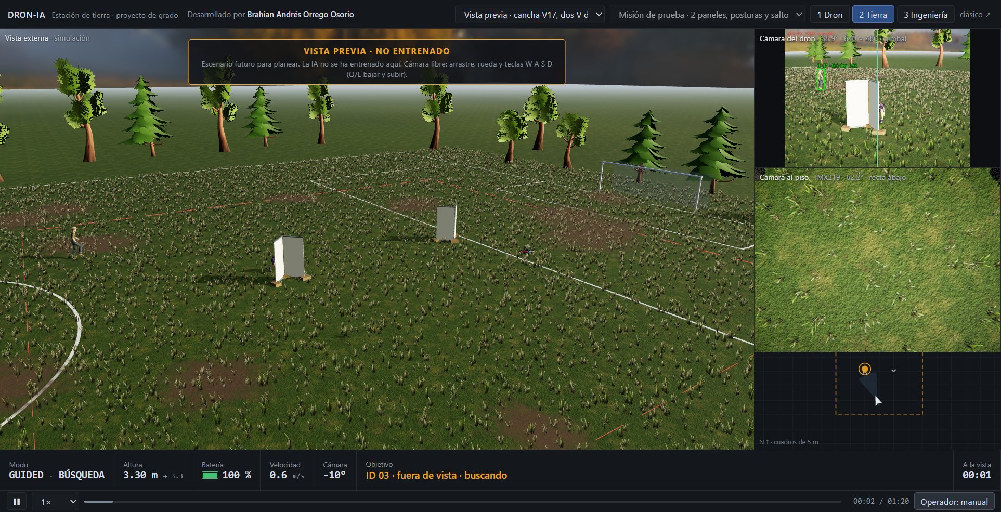
04_VISOR_Y_MOTOR_GRAFICO/mediciones/capturas/v3_cancha_naturaleza.jpg
