brahianorrego/Talos-AI/04_VISOR_Y_MOTOR_GRAFICO/mediciones/capturas/v4_modo_dron.jpg

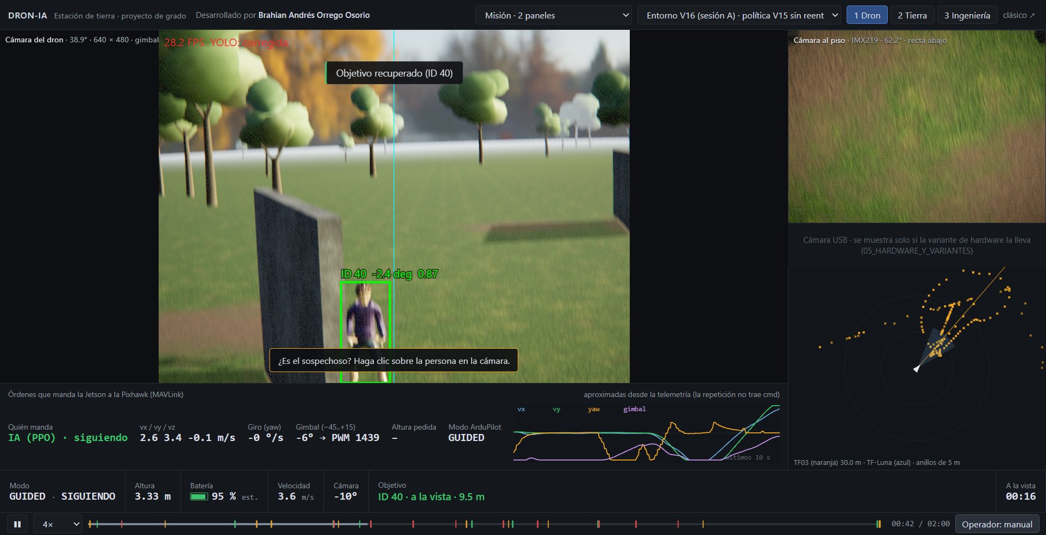
04_VISOR_Y_MOTOR_GRAFICO/mediciones/capturas/v4_modo_dron.jpg
