brahianorrego/Talos-AI/04_VISOR_Y_MOTOR_GRAFICO/mediciones/capturas/v5_en_vivo_dron.jpg

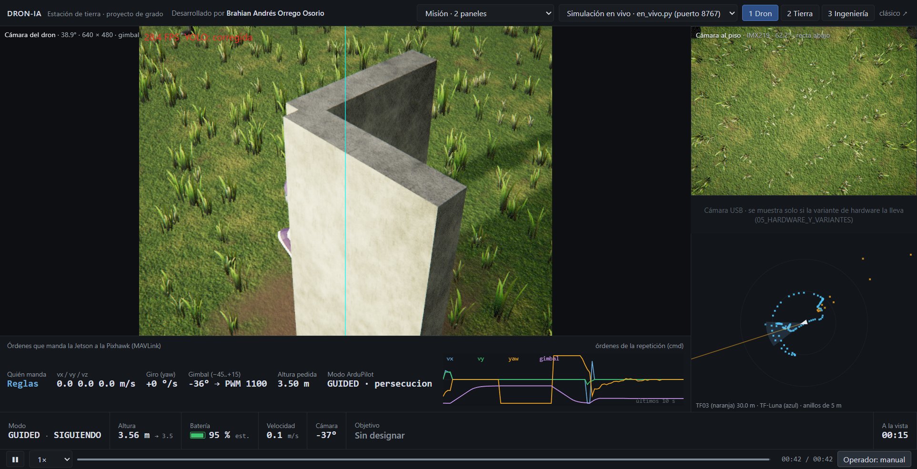
04_VISOR_Y_MOTOR_GRAFICO/mediciones/capturas/v5_en_vivo_dron.jpg
