brahianorrego/Talos-AI/04_VISOR_Y_MOTOR_GRAFICO/mediciones/capturas/v16_camara_yolo.jpg

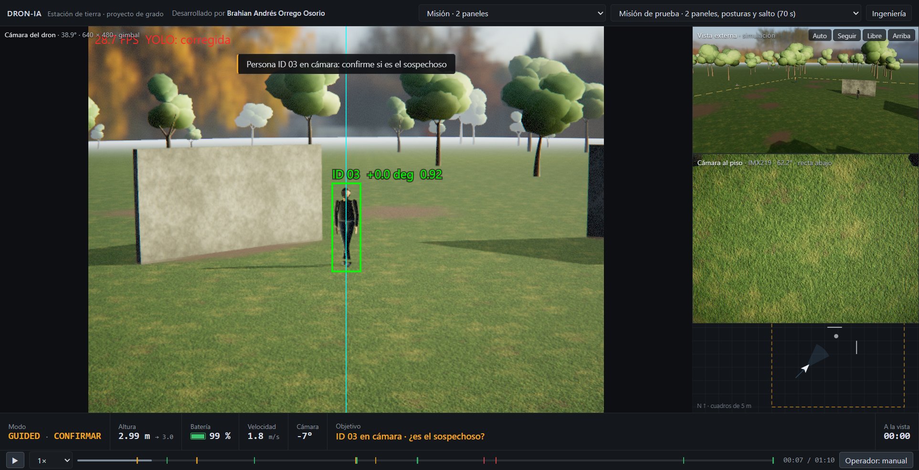
04_VISOR_Y_MOTOR_GRAFICO/mediciones/capturas/v16_camara_yolo.jpg
