brahianorrego/Talos-AI/04_VISOR_Y_MOTOR_GRAFICO/mediciones/capturas/v16_previa_hangar.jpg

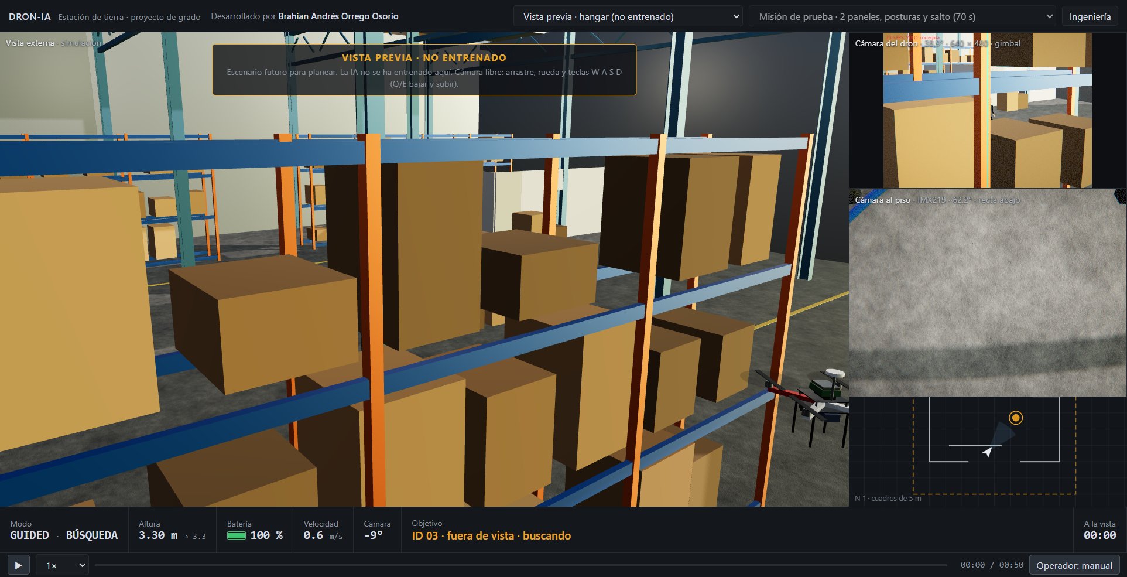
04_VISOR_Y_MOTOR_GRAFICO/mediciones/capturas/v16_previa_hangar.jpg
