brahianorrego/Talos-AI/04_VISOR_Y_MOTOR_GRAFICO/mediciones/capturas/v16_rtx_alta.jpg

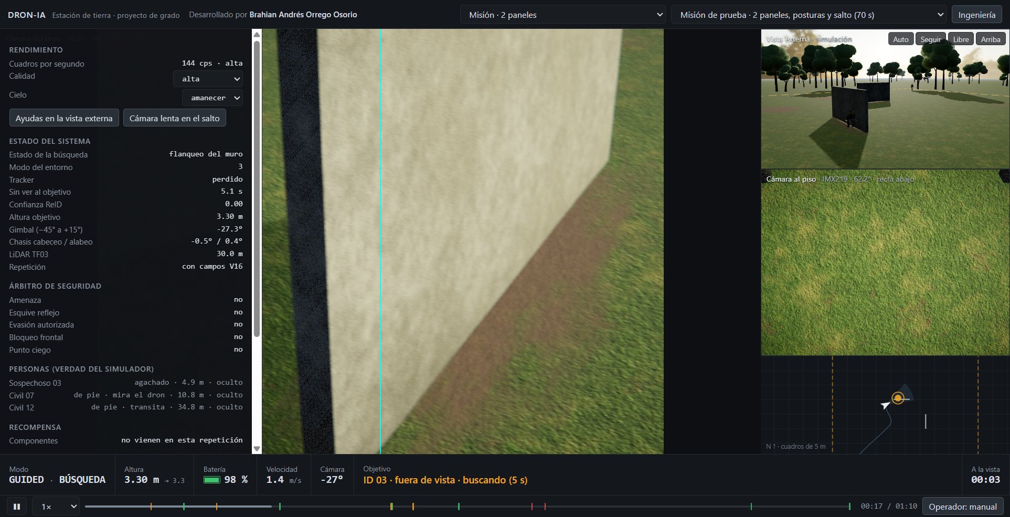
04_VISOR_Y_MOTOR_GRAFICO/mediciones/capturas/v16_rtx_alta.jpg
