brahianorrego/Talos-AI/04_VISOR_Y_MOTOR_GRAFICO/mediciones/capturas/v17_cancha_seguir.jpg

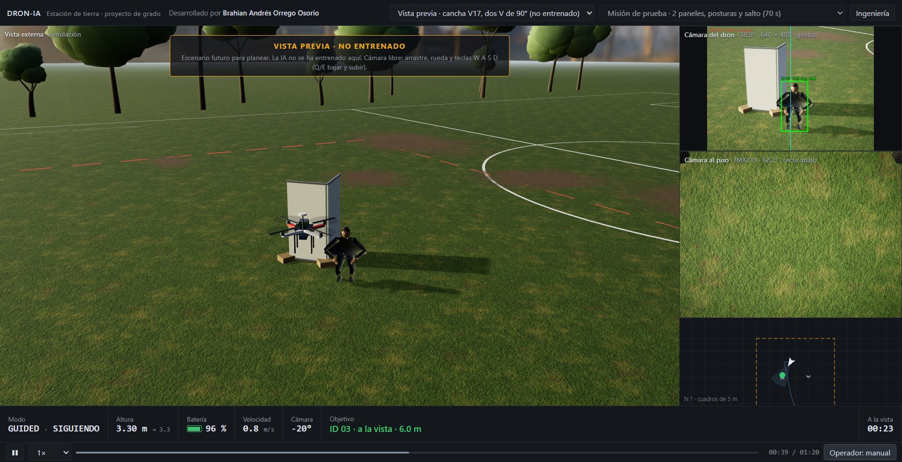
04_VISOR_Y_MOTOR_GRAFICO/mediciones/capturas/v17_cancha_seguir.jpg
