brahianorrego/Talos-AI/04_VISOR_Y_MOTOR_GRAFICO/mediciones/capturas/vista_del_dron_final.png

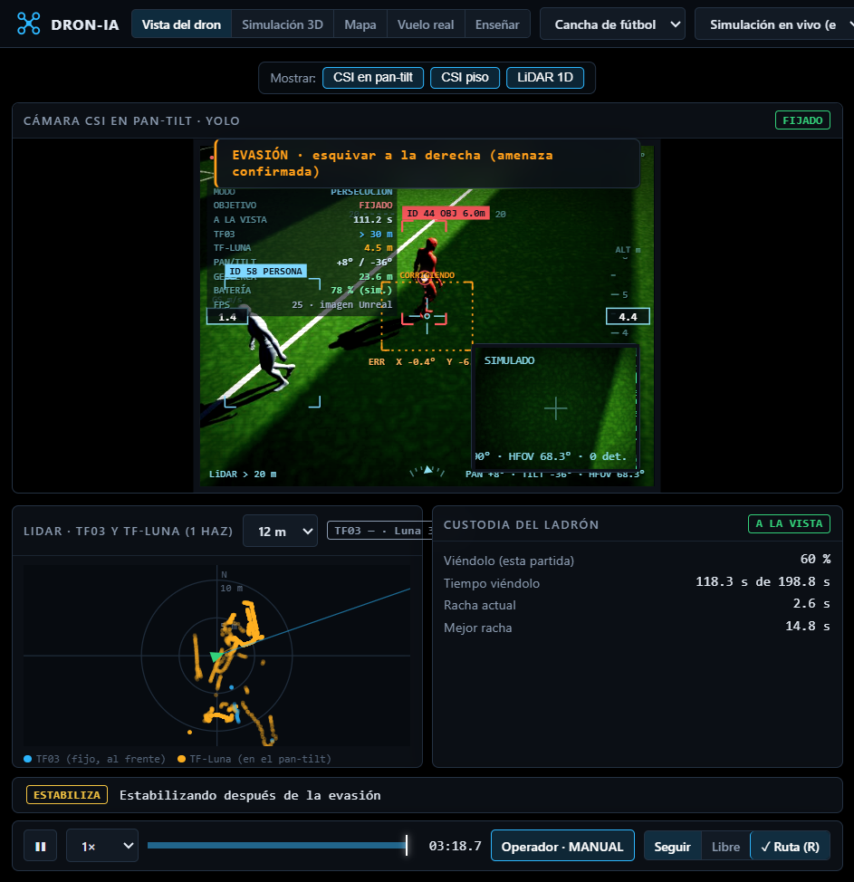
04_VISOR_Y_MOTOR_GRAFICO/mediciones/capturas/vista_del_dron_final.png
