brahianorrego/Talos-AI/05_HARDWARE_Y_VARIANTES/piezas_3d/vistas/pan_tilt_cuna_1.png

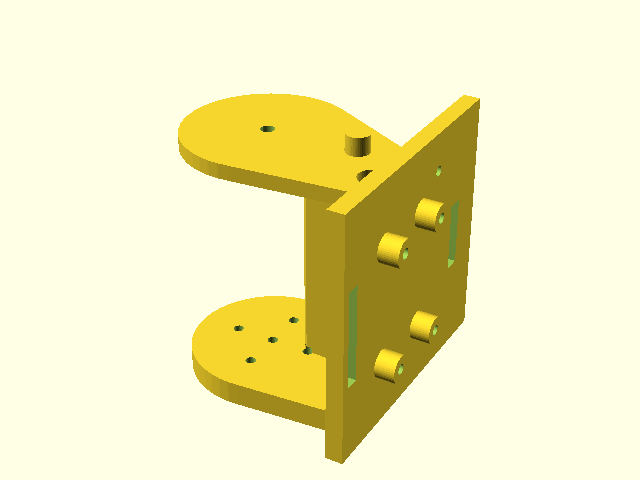
05_HARDWARE_Y_VARIANTES/piezas_3d/vistas/pan_tilt_cuna_1.png
