brahianorrego/Talos-AI/05_HARDWARE_Y_VARIANTES/piezas_3d/vistas/soporte_camara_piso_3.png

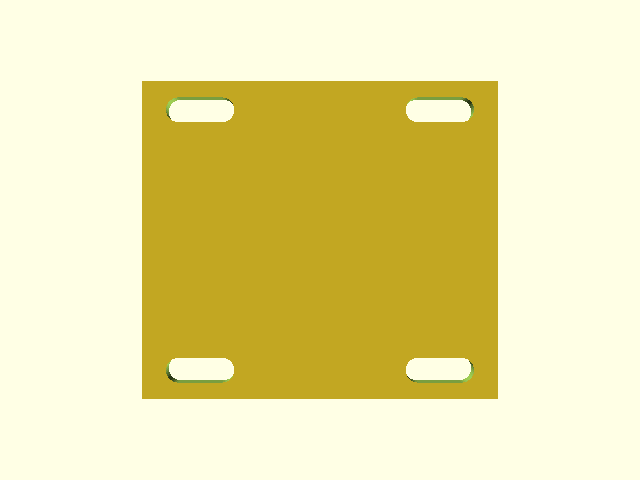
05_HARDWARE_Y_VARIANTES/piezas_3d/vistas/soporte_camara_piso_3.png
