brahianorrego/Talos-AI/05_HARDWARE_Y_VARIANTES/piezas_3d/vistas/soporte_luna_pantilt_2.png

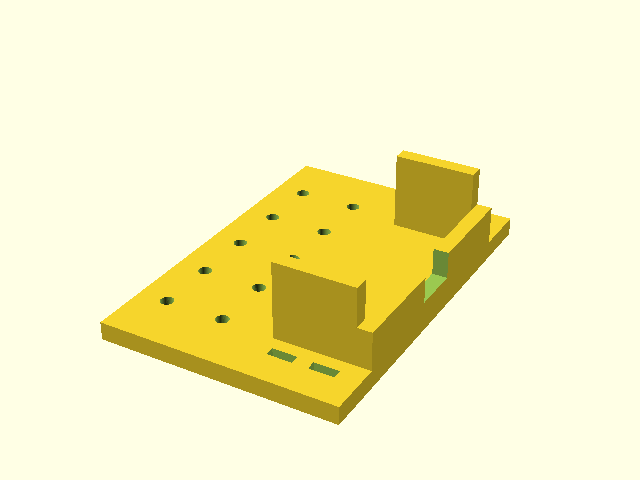
05_HARDWARE_Y_VARIANTES/piezas_3d/vistas/soporte_luna_pantilt_2.png
