brahianorrego/Talos-AI/05_HARDWARE_Y_VARIANTES/piezas_3d/vistas/soporte_luna_pod_3.png

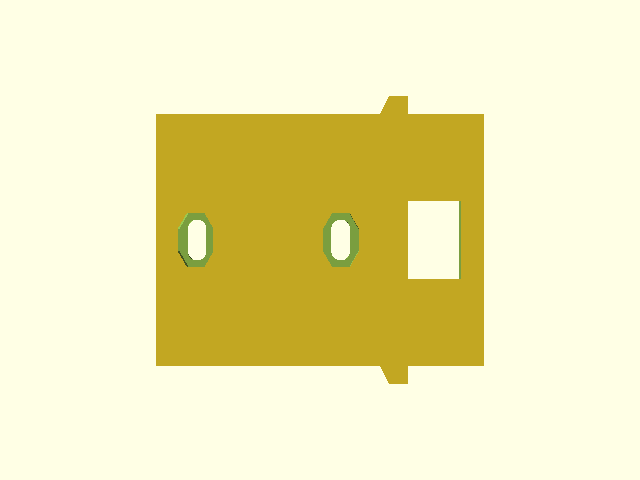
05_HARDWARE_Y_VARIANTES/piezas_3d/vistas/soporte_luna_pod_3.png
