brahianorrego/Talos-AI/08_EVIDENCIA_Y_DIAGRAMAS/capturas/unreal_vuelo_cruce.jpg

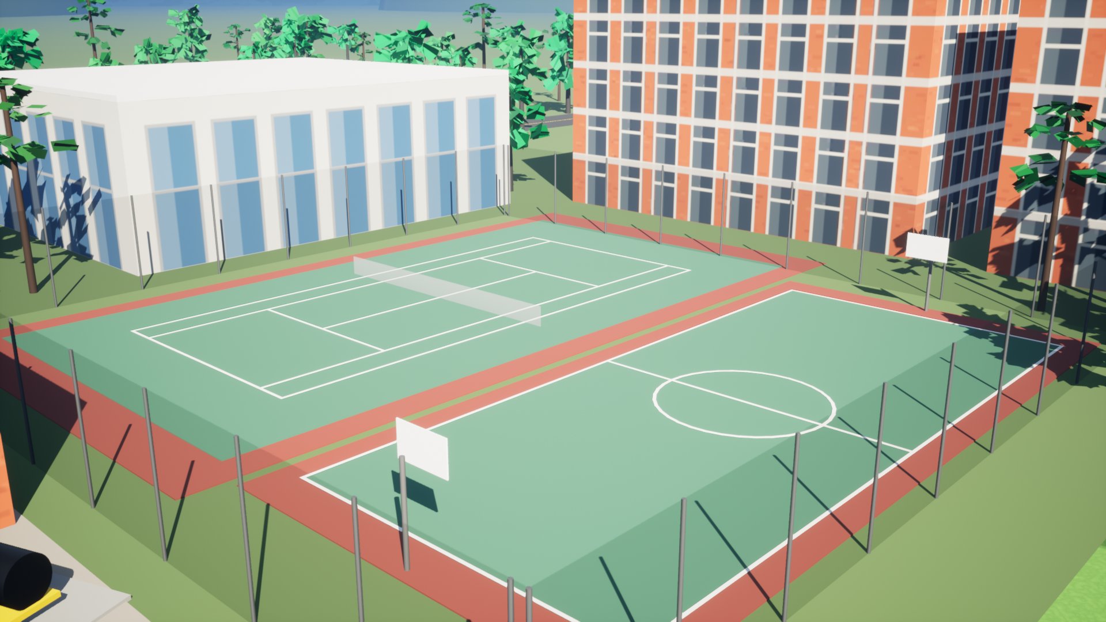
08_EVIDENCIA_Y_DIAGRAMAS/capturas/unreal_vuelo_cruce.jpg
