brahianorrego/Talos-AI/08_EVIDENCIA_Y_DIAGRAMAS/capturas/v17_cancha_arriba.jpg

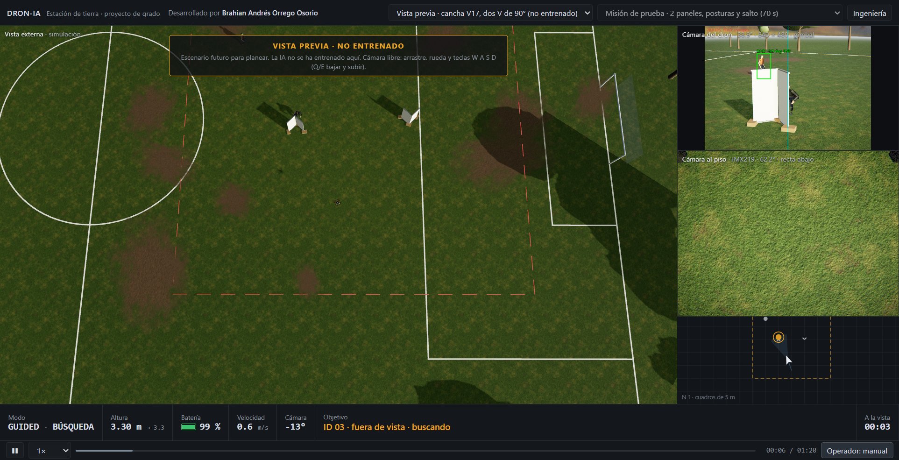
08_EVIDENCIA_Y_DIAGRAMAS/capturas/v17_cancha_arriba.jpg
