brahianorrego/Talos-AI/08_EVIDENCIA_Y_DIAGRAMAS/diagramas/07_caja_transparente.png

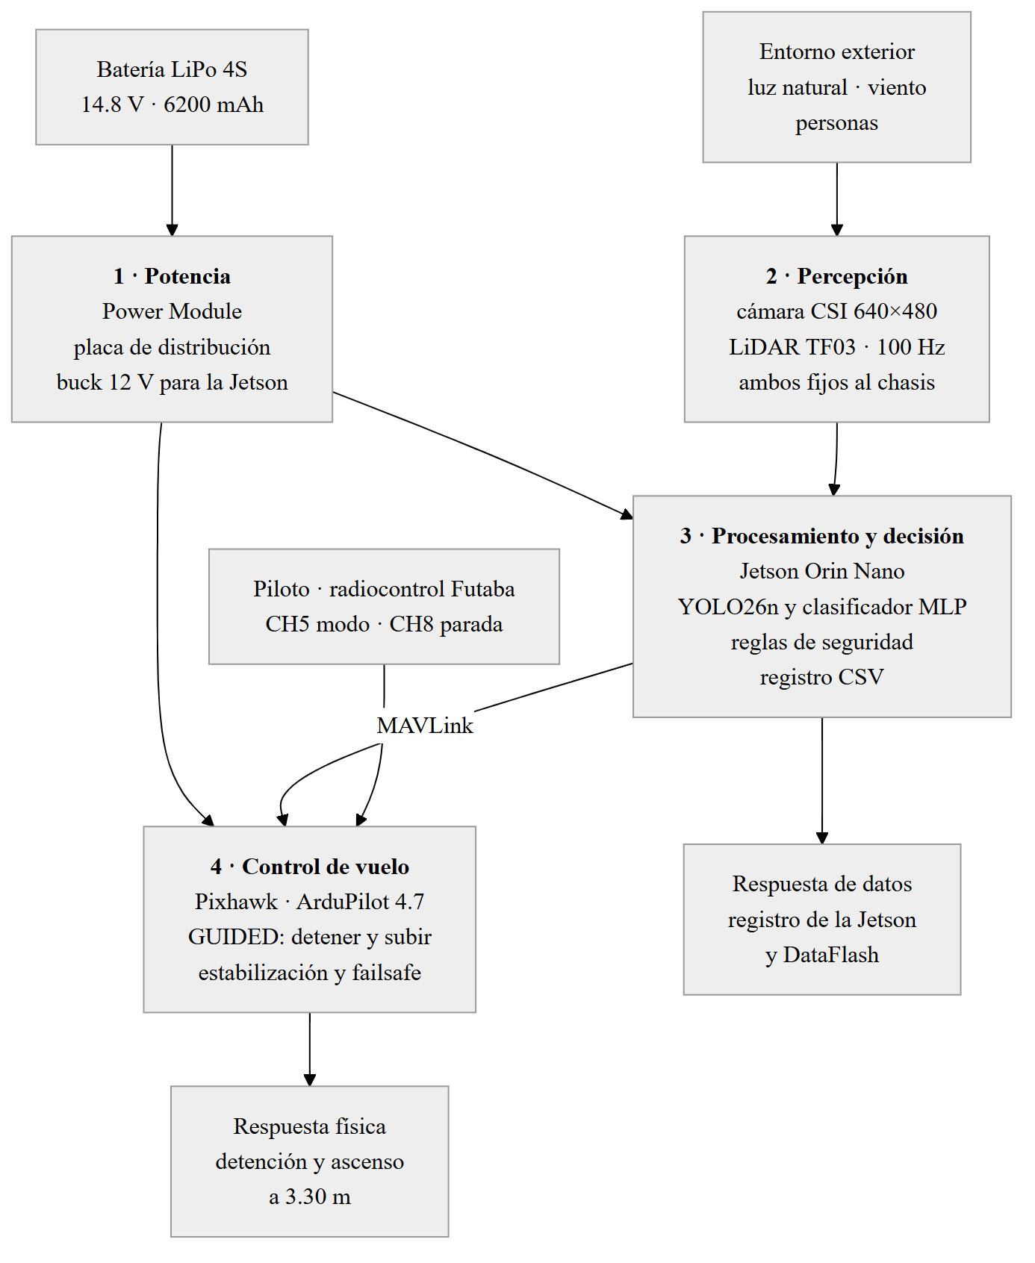
08_EVIDENCIA_Y_DIAGRAMAS/diagramas/07_caja_transparente.png
