brahianorrego/Talos-AI/08_EVIDENCIA_Y_DIAGRAMAS/diagramas/10_motores_vista_superior.png

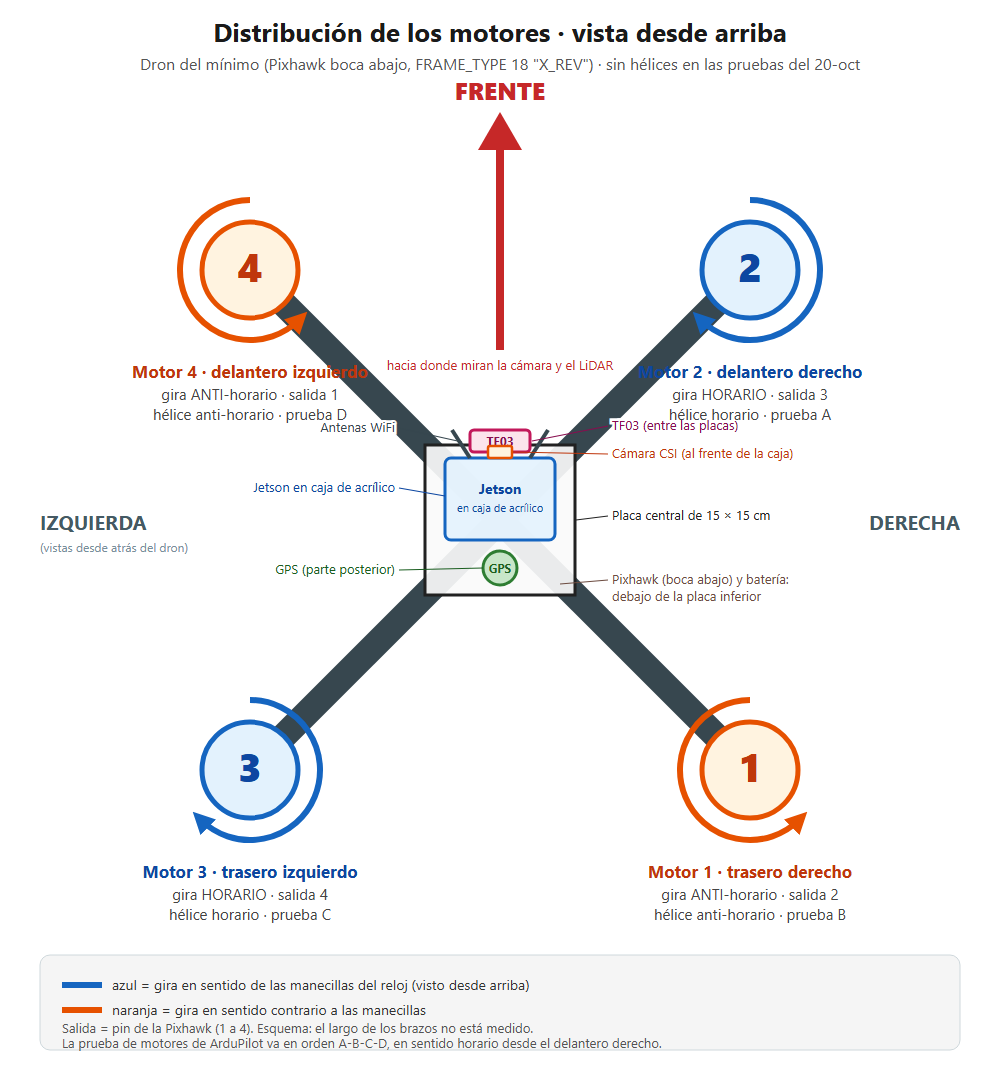
08_EVIDENCIA_Y_DIAGRAMAS/diagramas/10_motores_vista_superior.png
