brahianorrego/Talos-AI/08_EVIDENCIA_Y_DIAGRAMAS/fichas_tecnicas/TF03_dimensiones.png

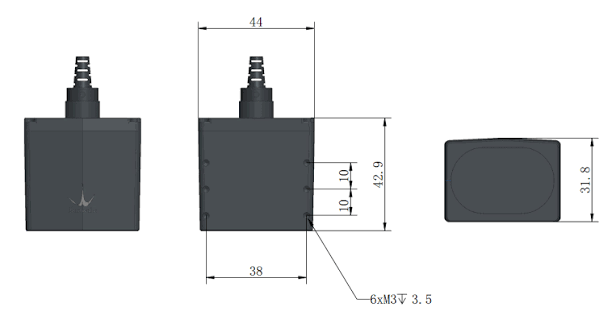
08_EVIDENCIA_Y_DIAGRAMAS/fichas_tecnicas/TF03_dimensiones.png
