brahianorrego/Talos-AI/08_EVIDENCIA_Y_DIAGRAMAS/fotos/09_dron_completo_arriba.webp

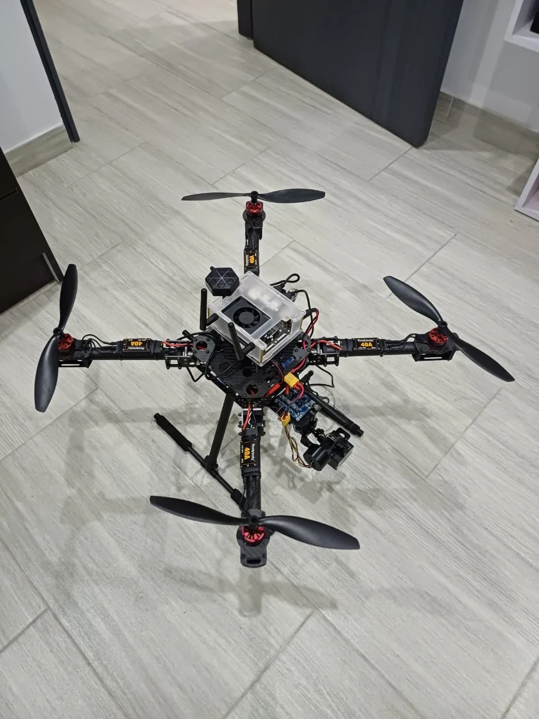
08_EVIDENCIA_Y_DIAGRAMAS/fotos/09_dron_completo_arriba.webp
