brahianorrego/Talos-AI/08_EVIDENCIA_Y_DIAGRAMAS/fotos/12_peso_bascula.webp

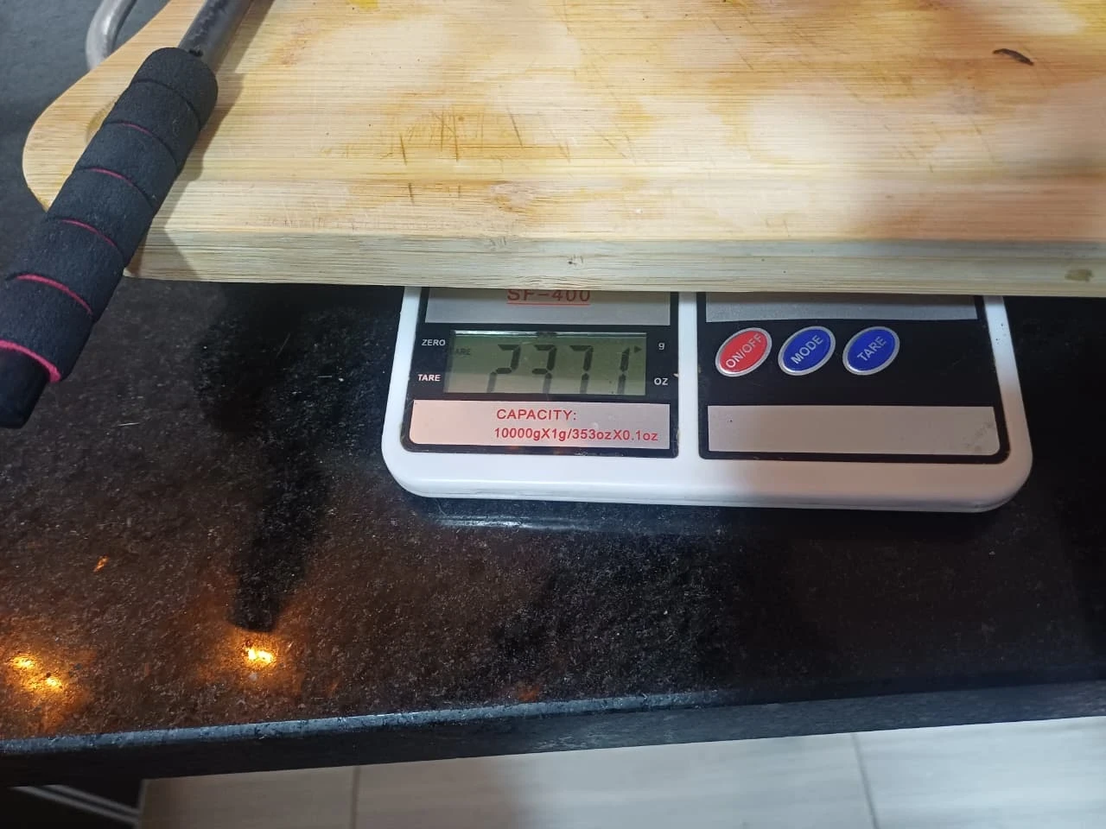
08_EVIDENCIA_Y_DIAGRAMAS/fotos/12_peso_bascula.webp
