brahianorrego/Talos-AI/08_EVIDENCIA_Y_DIAGRAMAS/fotos/14_dron_actual_lado_completo.webp

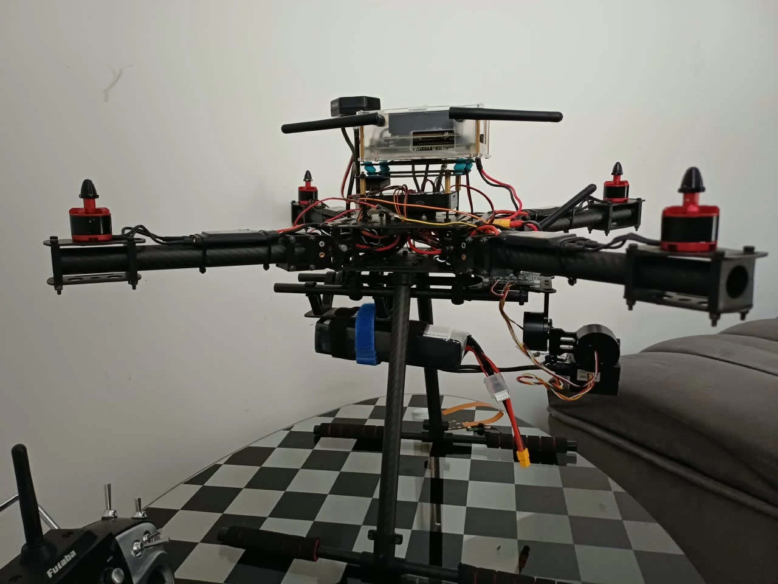
08_EVIDENCIA_Y_DIAGRAMAS/fotos/14_dron_actual_lado_completo.webp
