brahianorrego/Talos-AI/08_EVIDENCIA_Y_DIAGRAMAS/fotos/15_gimbal_tf03_camara_lado.webp

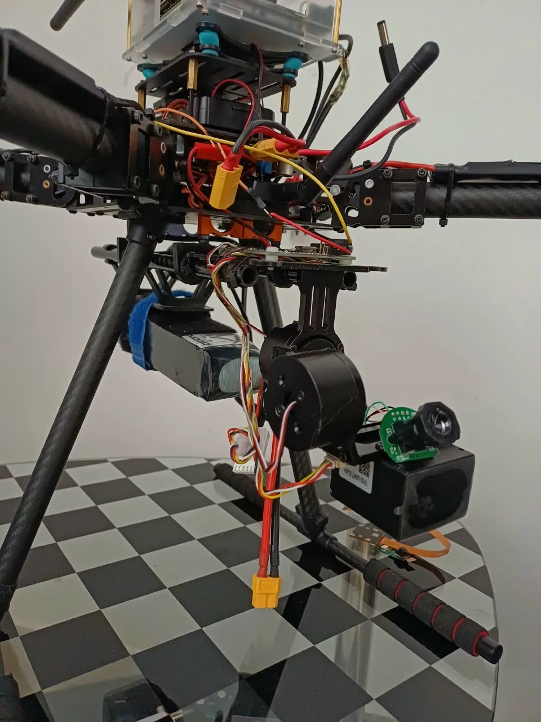
08_EVIDENCIA_Y_DIAGRAMAS/fotos/15_gimbal_tf03_camara_lado.webp
