brahianorrego/Talos-AI/08_EVIDENCIA_Y_DIAGRAMAS/fotos/16_camara_usb_en_mano_sobre_tf03.webp

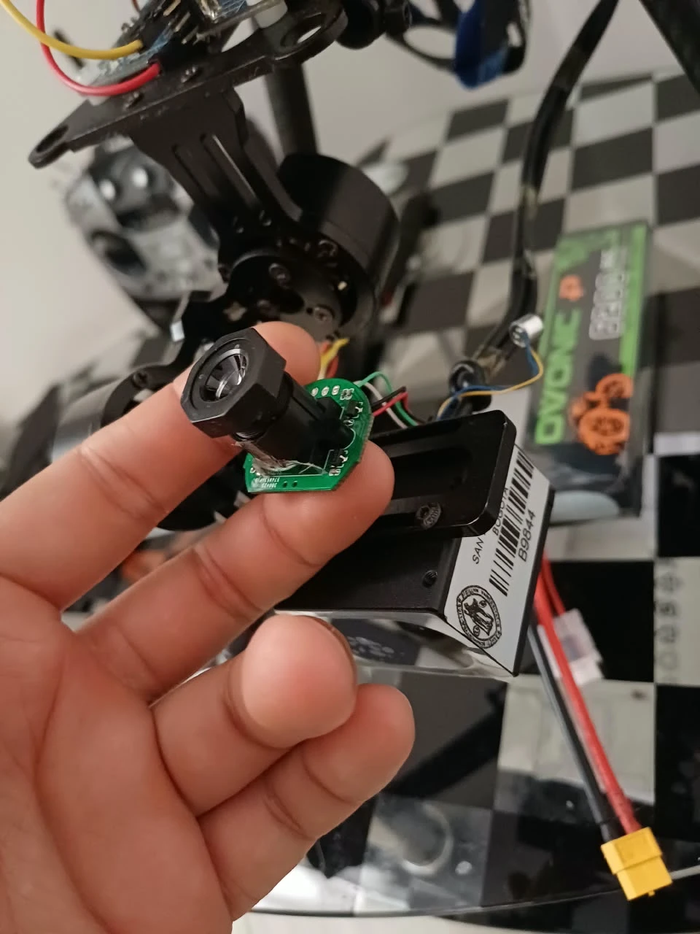
08_EVIDENCIA_Y_DIAGRAMAS/fotos/16_camara_usb_en_mano_sobre_tf03.webp
