brahianorrego/Talos-AI/08_EVIDENCIA_Y_DIAGRAMAS/fotos/17_tf03_camara_vista_frontal.webp

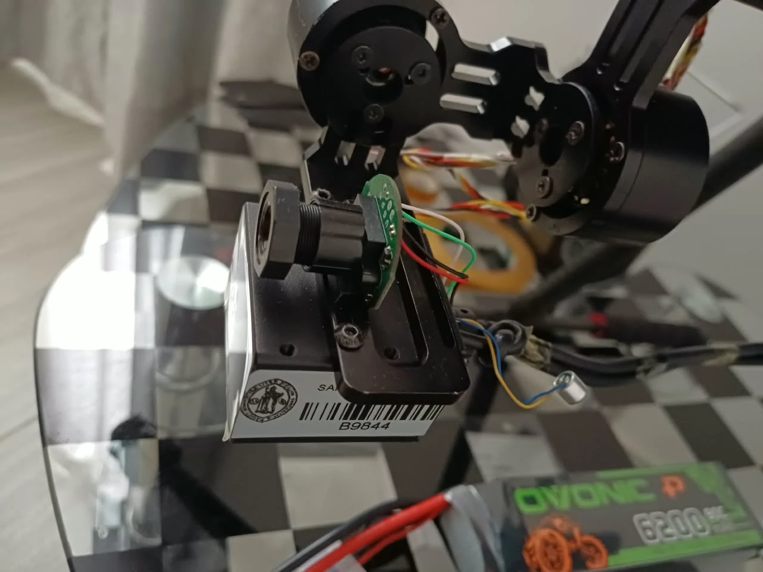
08_EVIDENCIA_Y_DIAGRAMAS/fotos/17_tf03_camara_vista_frontal.webp
