brahianorrego/Talos-AI/08_EVIDENCIA_Y_DIAGRAMAS/fotos/18_tf03_camara_vista_superior.webp

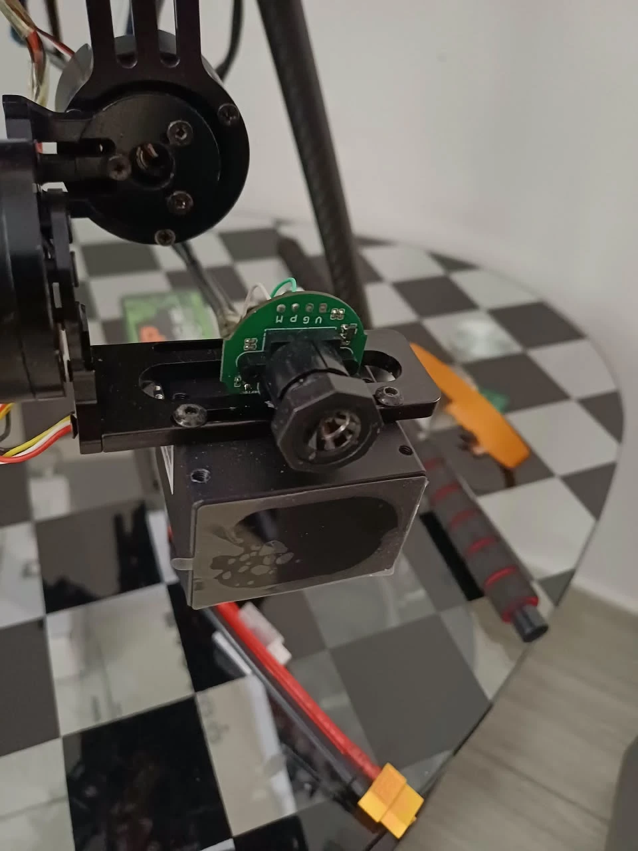
08_EVIDENCIA_Y_DIAGRAMAS/fotos/18_tf03_camara_vista_superior.webp
