brahianorrego/Talos-AI/08_EVIDENCIA_Y_DIAGRAMAS/fotos/19_camara_csi_imx219_J8IM228_en_cam0.jpg

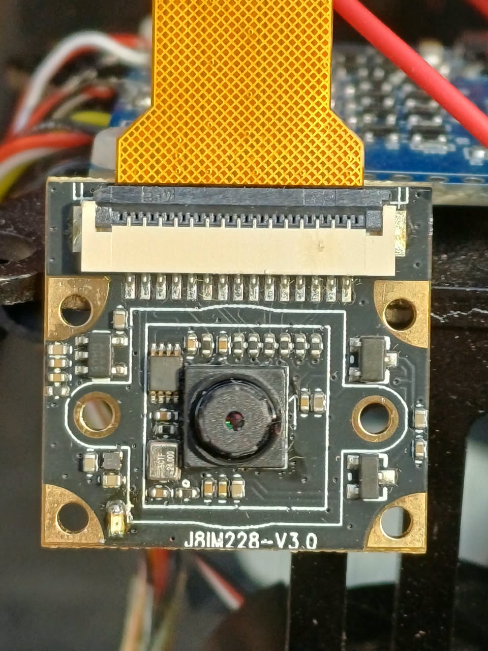
08_EVIDENCIA_Y_DIAGRAMAS/fotos/19_camara_csi_imx219_J8IM228_en_cam0.jpg
