brahianorrego/Talos-AI/08_EVIDENCIA_Y_DIAGRAMAS/fotos/19_dron_sin_gimbal_lado_antenas_csi.webp

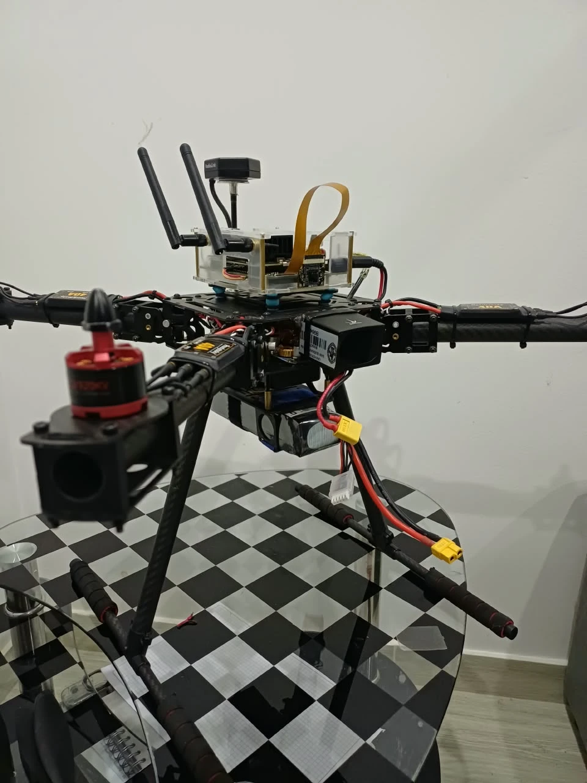
08_EVIDENCIA_Y_DIAGRAMAS/fotos/19_dron_sin_gimbal_lado_antenas_csi.webp
