brahianorrego/Talos-AI/08_EVIDENCIA_Y_DIAGRAMAS/fotos/20_dron_sin_gimbal_frente_bateria_abajo.webp

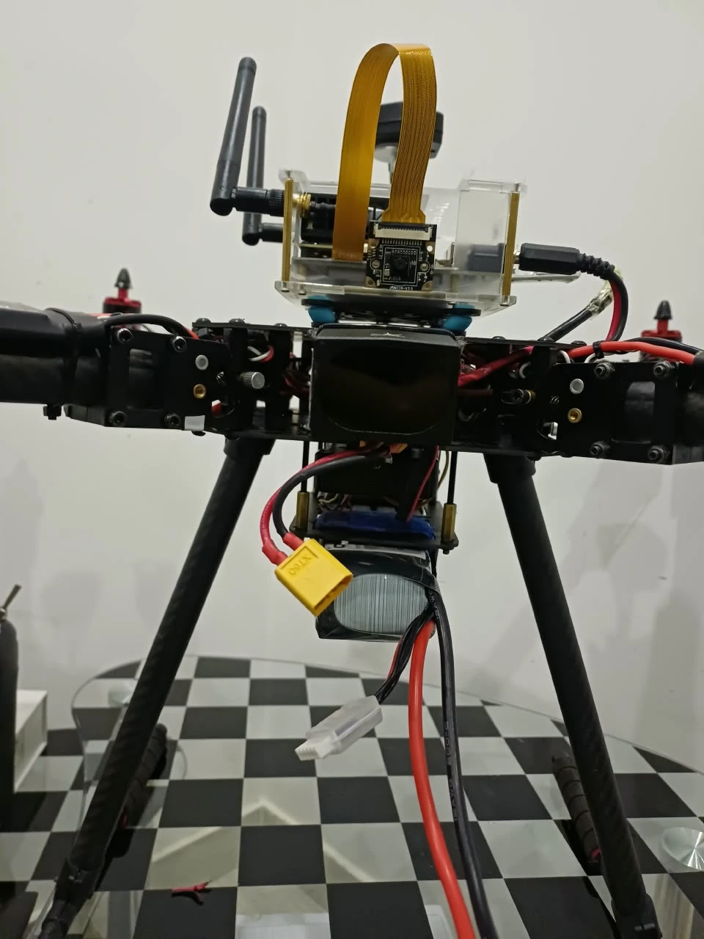
08_EVIDENCIA_Y_DIAGRAMAS/fotos/20_dron_sin_gimbal_frente_bateria_abajo.webp
