brahianorrego/Talos-AI/08_EVIDENCIA_Y_DIAGRAMAS/fotos/21_dron_sin_gimbal_vista_inferior_bateria_estructura.webp

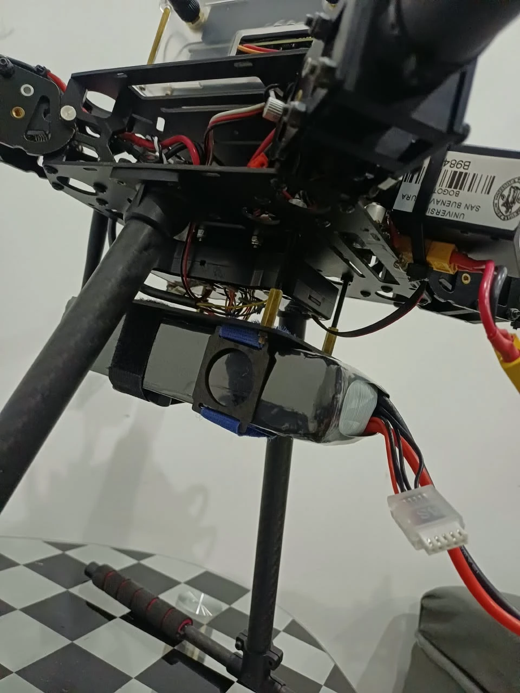
08_EVIDENCIA_Y_DIAGRAMAS/fotos/21_dron_sin_gimbal_vista_inferior_bateria_estructura.webp
