brahianorrego/Talos-AI/08_EVIDENCIA_Y_DIAGRAMAS/fotos/22_dron_sin_gimbal_lado_bateria_abajo.webp

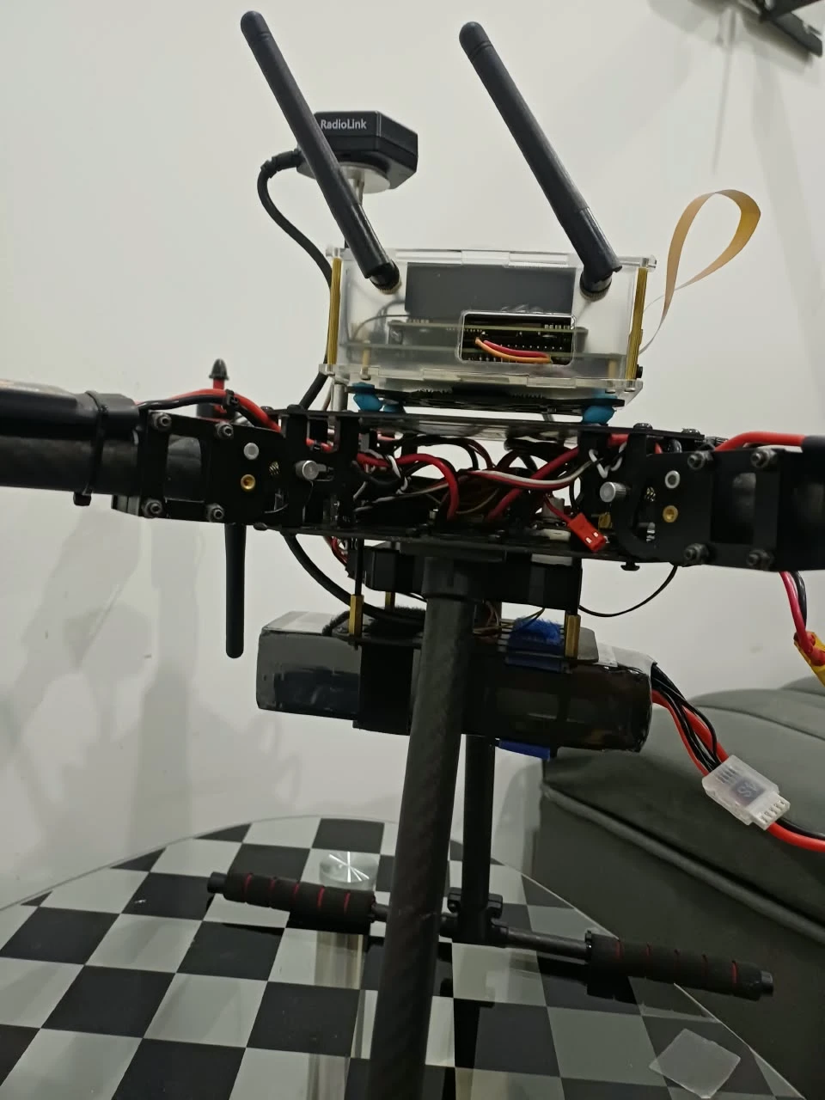
08_EVIDENCIA_Y_DIAGRAMAS/fotos/22_dron_sin_gimbal_lado_bateria_abajo.webp
