brahianorrego/Talos-AI/08_EVIDENCIA_Y_DIAGRAMAS/fotos/23_dron_sin_gimbal_csi_jetson_tf03.webp

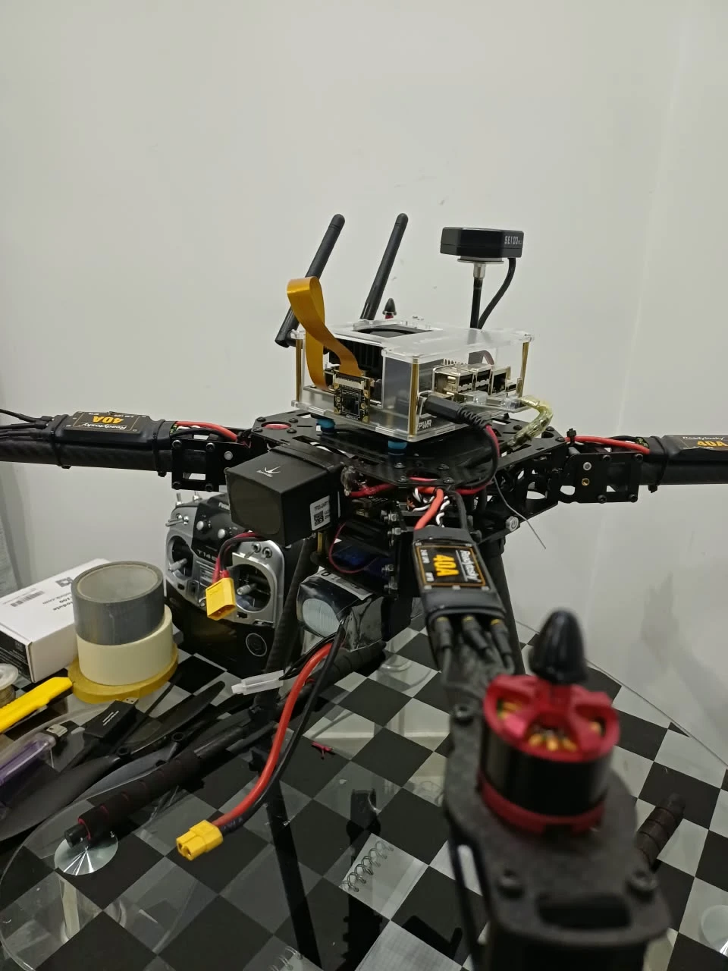
08_EVIDENCIA_Y_DIAGRAMAS/fotos/23_dron_sin_gimbal_csi_jetson_tf03.webp
