brahianorrego/Talos-AI/08_EVIDENCIA_Y_DIAGRAMAS/fotos/24_dron_frente_jetson_csi_tf03_20oct.webp

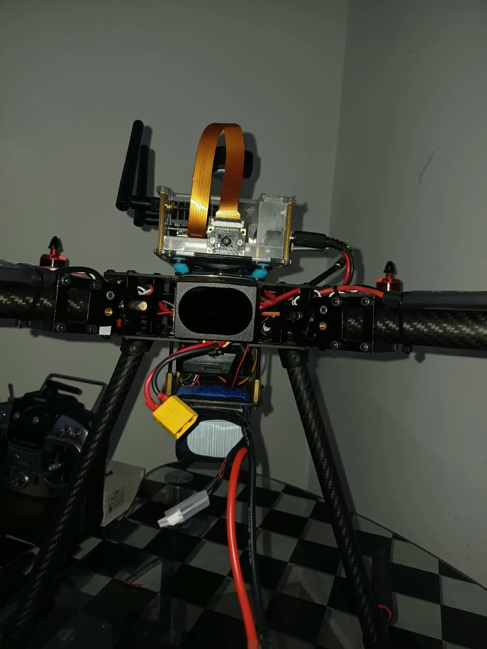
08_EVIDENCIA_Y_DIAGRAMAS/fotos/24_dron_frente_jetson_csi_tf03_20oct.webp
