brahianorrego/Talos-AI/08_EVIDENCIA_Y_DIAGRAMAS/fotos/25_dron_atras_gps_antenas_bateria_20oct.webp

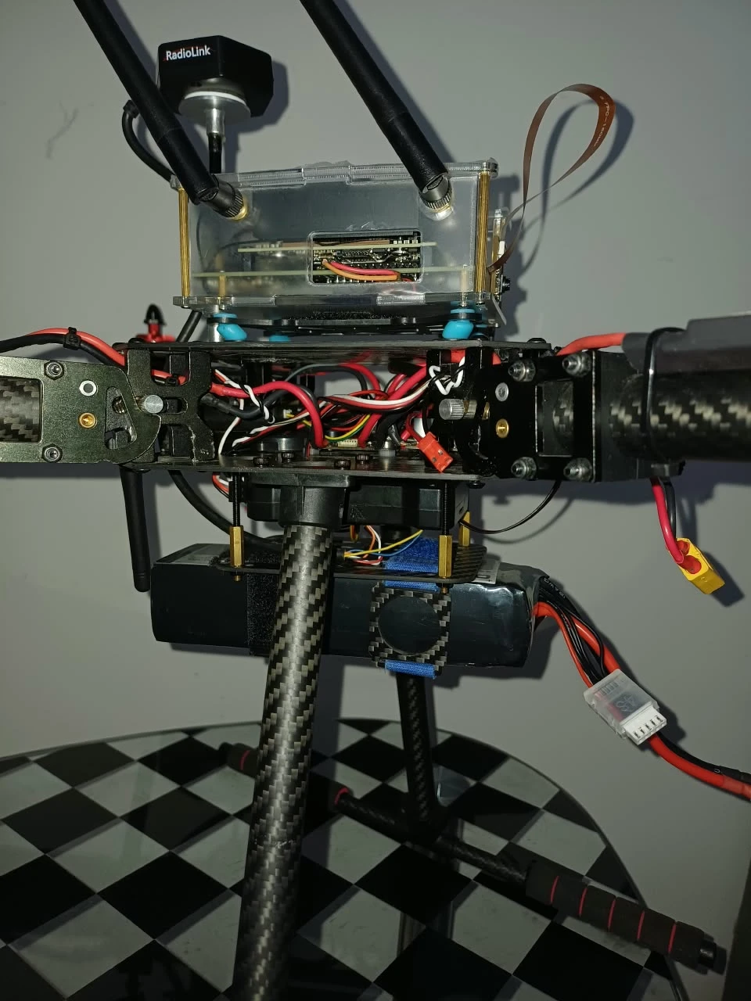
08_EVIDENCIA_Y_DIAGRAMAS/fotos/25_dron_atras_gps_antenas_bateria_20oct.webp
