brahianorrego/Talos-AI/08_EVIDENCIA_Y_DIAGRAMAS/fotos/26_dron_inferior_bateria_y_placa_20oct.webp

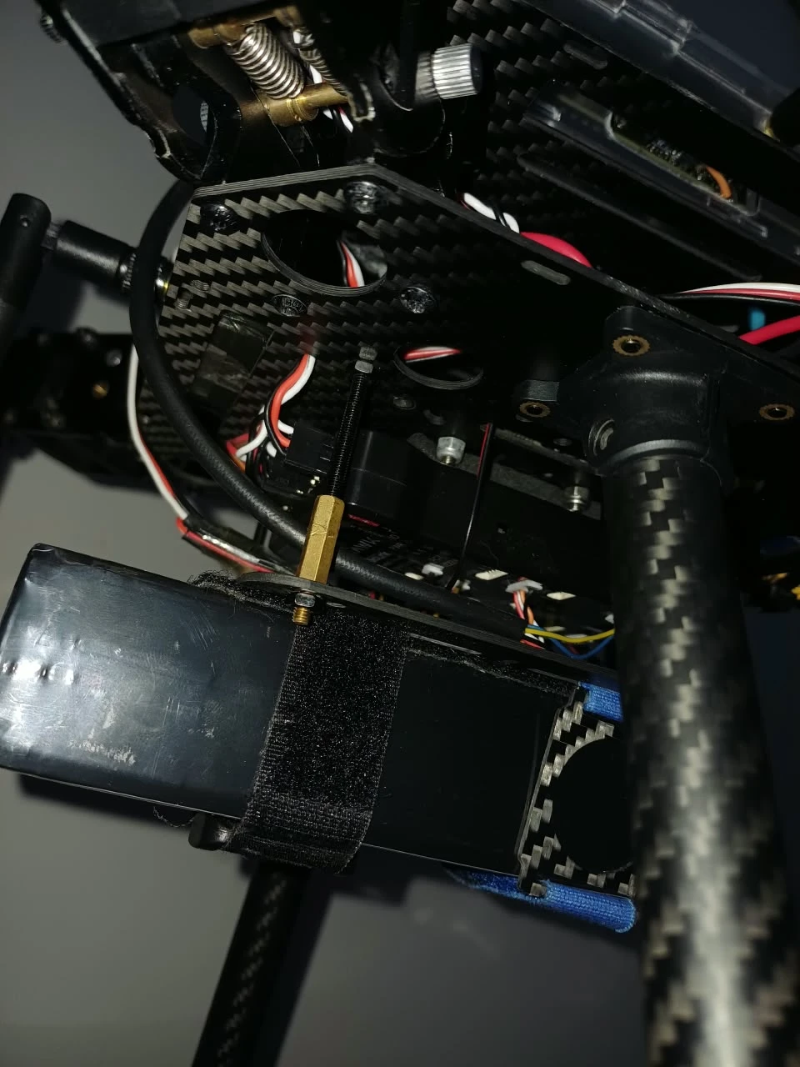
08_EVIDENCIA_Y_DIAGRAMAS/fotos/26_dron_inferior_bateria_y_placa_20oct.webp
