brahianorrego/Talos-AI/08_EVIDENCIA_Y_DIAGRAMAS/fotos/27_dron_pixhawk_bajo_la_placa_20oct.webp

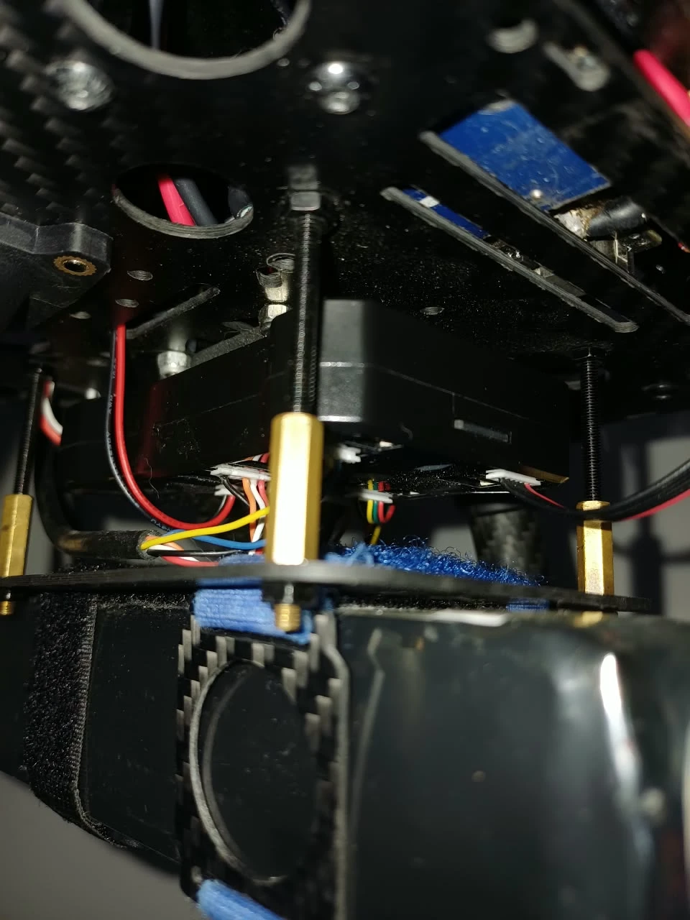
08_EVIDENCIA_Y_DIAGRAMAS/fotos/27_dron_pixhawk_bajo_la_placa_20oct.webp
