brahianorrego/Talos-AI/08_EVIDENCIA_Y_DIAGRAMAS/redes/ppo_actor_pesos.png

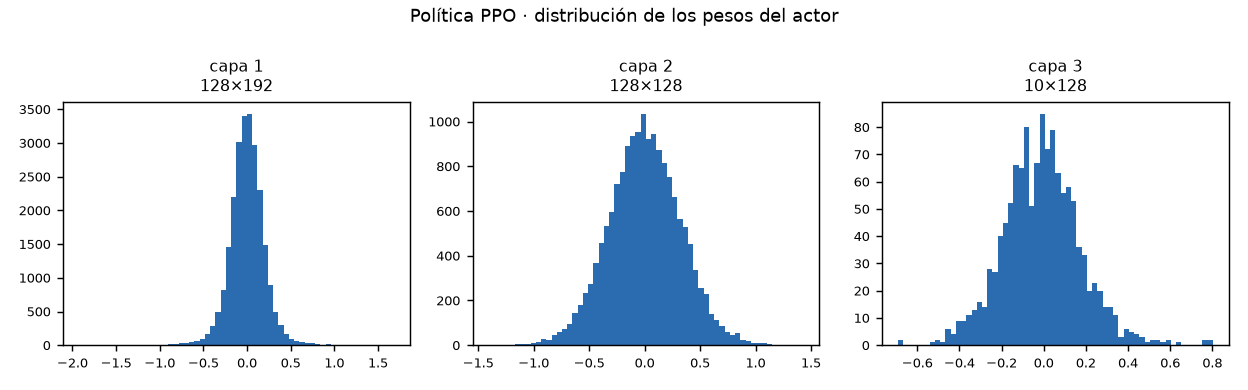
08_EVIDENCIA_Y_DIAGRAMAS/redes/ppo_actor_pesos.png
