brahianorrego/Talos-AI/08_EVIDENCIA_Y_DIAGRAMAS/redes/ppo_probabilidades.png

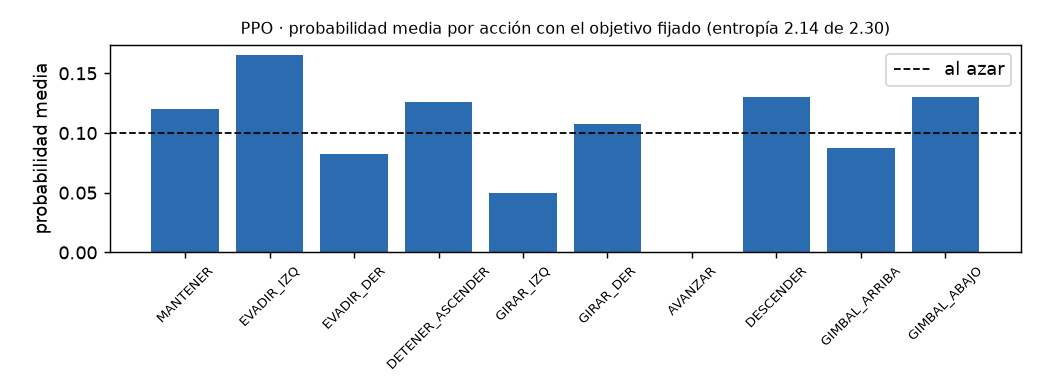
08_EVIDENCIA_Y_DIAGRAMAS/redes/ppo_probabilidades.png
