brahianorrego/Talos-AI/docs/MATERIAL_PARA_DOCUMENTO/08_creditos_y_licencias_fab.md

# Créditos y licencias del contenido de Fab usado en el motor gráfico (para la sección de créditos)

Contenido bajado por Brahian desde Fab (21-oct-2026) al proyecto de Unreal DronIA_Cancha. El proyecto de Unreal **no está en el repositorio**
(solo se publican los scripts), así que estos archivos no se redistribuyen; aun así las licencias Creative Commons exigen dar crédito.
Tipo de licencia según lo informado por Brahian al descargarlos; **verificar en la ficha de Fab antes de imprimir la versión final**.

## Con atribución obligatoria (CC BY 4.0)

| Contenido | Autor | Licencia | Uso en el proyecto de grado |
|---|---|---|---|
| Roads 05 – Scanned Photogrammetry Materials | ScansMatter | CC BY 4.0 | Asfalto de las vías y el parqueadero, adoquín de la plaza y de los caminos, losas del camino peatonal |
| Mobile Trees Pack 44 | Tree Master | CC BY 4.0 | Descargado como respaldo de árboles; solo se usará si los Megaplants no sirven (no está en el nivel a la fecha) |

Texto sugerido para la sección de créditos:

> Materiales de calles y pavimentos: «Roads 05 – Scanned Photogrammetry Materials» de ScansMatter (Fab), licencia CC BY 4.0
> (https://creativecommons.org/licenses/by/4.0/). Se usaron sin modificar las texturas; se les ajustó la repetición sobre las superficies.
> Árboles de respaldo: «Mobile Trees Pack 44» de Tree Master (Fab), licencia CC BY 4.0.

## Con licencia de Fab / Quixel (sin atribución obligatoria, se agradece citarlos)

| Contenido | Autor | Uso |
|---|---|---|
| Megaplants: Black Alder y Megaplants: European Hornbeam | Quixel (Epic Games) | Árboles frondosos alrededor de la zona de vuelo |
| Uncut Grass (superficie Megascans `oilpt20`) | Quixel Megascans | Pasto del terreno |
| Pack Bonus Textures | Lord Enot Store | Descargado (pasto, piedra, losa); a la fecha no se usa en el nivel |
| HighPoly Tree Model | _autor por confirmar en la ficha_ | Descargado por Brahian; a la fecha no se usa |
| Survival Character (chaqueta, jeans, botas, guantes, mochila) | _autor y licencia por confirmar en la ficha de Fab_ | El ladrón |
| Quantum Modular Character (muestra gratuita) | _autor y licencia por confirmar en la ficha de Fab_ | Los civiles |
| Free Shrubs Pack (GV_FreeShrubsPack) | _por confirmar_ | Descargado; sin usar a la fecha |

Los materiales de Quixel y de Fab con licencia estándar se pueden usar en proyectos propios; no se pueden revender ni redistribuir como activos.

## Qué se cambia si algo no se usa al final
Actualizar esta tabla con lo que de verdad quede en el nivel. Misma información en `04_VISOR_Y_MOTOR_GRAFICO/unreal/LICENCIAS.md`.
