brahianorrego/Talos-AI/docs/MATERIAL_PARA_DOCUMENTO/00_LEEME.md

# Material para el documento del proyecto de grado

Para que la cuenta de Tania redacte el Word. Son notas cortas, no el documento. **Cada cifra lleva el archivo de donde sale** (rutas desde la raíz
del repositorio `Dron-IA-Proyecto`). Lo que no tiene fuente o no se verificó está marcado así. No hay IPs, usuarios, claves ni redes WiFi aquí.

| Archivo | Qué trae |
|---|---|
| `01_cronologia.md` | Qué se hizo y cuándo (16 al 20-oct), desde `git log` y `docs/DECISIONES.md` |
| `02_errores_y_lecciones.md` | Fallos, causa y arreglo: Brahian quiere que se cuenten |
| `03_procedimiento_y_metodos.md` | Cómo se midió y cómo se repite |
| `04_indice_de_imagenes.md` | Cada foto, captura y diagrama con su ruta y qué demuestra |
| `05_motor_grafico_y_juego.md` | Estación de tierra, Unreal, controles y cuadros por segundo |
| `06_anexos_sugeridos.md` | Qué código y tablas van en anexos (máximo 100 páginas) |
| `07_conversacion_y_decisiones_de_brahian.md` | Lo que pidió y corrigió Brahian, con fechas, y lo que frenó el trabajo |

Escribir "proyecto de grado", nunca "tesis". Todo el plus es simulación: no ha volado. El mínimo tampoco ha volado con la Jetson
(`docs/HISTORIAL_PRUEBAS_FISICAS.md`, "Pendiente a esta fecha").
