brahianorrego/Talos-AI/docs/MATERIAL_PARA_DOCUMENTO/04_indice_de_imagenes.md

# 04 · Índice de imágenes

Rutas desde la raíz del repositorio. Para el detalle de cada foto de hardware existe `08_EVIDENCIA_Y_DIAGRAMAS/INDICE_FOTOS.md` (revisadas una por una el 18-oct).
Marcado **no publicar** lo que tiene personas reales o datos privados. Lo que no se pudo confirmar se dice así.

| Grupo | Ruta | Fecha | Qué demuestra |
|---|---|---|---|
| Fotos del hardware 01-18 | `08_EVIDENCIA_Y_DIAGRAMAS/fotos/01_...` a `18_...` | 5 al 19-oct | Armazón, Pixhawk, motores, potencia, gimbal con TF03 y cámara USB, peso con báscula (2371 g con gimbal: fuente `INDICE_FOTOS.md`, marcado "verificar") |
| Dron sin gimbal | `08_EVIDENCIA_Y_DIAGRAMAS/fotos/19_...` a `27_...` (los de "20oct") | 20-oct | CSI y TF03 fijos, batería bajo el chasis, Pixhawk bajo la placa, Jetson en caja acrílica |
| Cámara CSI IMX219 | `08_EVIDENCIA_Y_DIAGRAMAS/fotos/19_camara_csi_imx219_J8IM228_en_cam0.jpg` | 19/20-oct | La cámara que reemplaza a la USB |
| Zona de vuelo de noche | `08_EVIDENCIA_Y_DIAGRAMAS/fotos/universidad_zona_vuelo_noche_20oct/` (10 imágenes, `zona_40.webp` a `zona_49.webp`) | 20-oct, **de noche** | Solo **referencia de la distribución y las formas** de las canchas (orden de Brahian, D-081: la simulación es de día). **Revisar antes de publicar** (lugar real) |
| Diagramas | `08_EVIDENCIA_Y_DIAGRAMAS/diagramas/01_...` a `12_...` (`.png`, `.svg`, `.mmd`) | 16 al 20-oct | Arquitectura, estados, experimento, "por qué IA", caja negra y transparente, conexiones, motores, ubicación de componentes y calibración |
| Redes neuronales | `08_EVIDENCIA_Y_DIAGRAMAS/redes/` (5) | 16-oct | Probabilidades y pesos de la política (`06_REDES_NEURONALES_Y_MODELOS/ver_redes.py`) |
| Calibración de ángulos | `08_EVIDENCIA_Y_DIAGRAMAS/calibracion_angulos_2026-10-20/` (7) | 20-oct | Cómo se midieron el campo de visión y las inclinaciones |
| Reinstalación de la Jetson | `08_EVIDENCIA_Y_DIAGRAMAS/reinstalacion_jetson/` (8) | 18-oct | Los errores de arranque y su arreglo |
| Mission Planner | `08_EVIDENCIA_Y_DIAGRAMAS/mission_planner/` (3) | 11-oct | Configuración de la batería y parámetros |
| Fichas técnicas | `08_EVIDENCIA_Y_DIAGRAMAS/fichas_tecnicas/` (2) | — | Medidas oficiales usadas en las piezas 3D |
| Capturas del README | `08_EVIDENCIA_Y_DIAGRAMAS/capturas/` (16) | 18-oct en adelante | Estación de tierra, mundo en Unreal, modelo 3D del dron, panel de campo |
| Capturas de las sesiones | `04_VISOR_Y_MOTOR_GRAFICO/mediciones/capturas/` (66) | 17 al 20-oct | Visor V16, estación (5 modos), campus y partidas en Unreal, maniquíes, árboles, modelo 3D del dron |
| Zona de IA V17 | `docs/v17_zona_ia.png` | 17/19-oct | Disposición de las dos V (dibujo del Arquitecto; medidas anteriores a D-066/D-076: actualizar) |
| Paneles de la universidad | `08_EVIDENCIA_Y_DIAGRAMAS/paneles_de_exposicion_universidad.png` | 16-oct | Foto con personas reales: **no publicar** |
| Pan-tilt | `08_EVIDENCIA_Y_DIAGRAMAS/pan_tilt_servos.png` | 16-oct | Referencia de diseño del pan-tilt del plus |
| Cobertura de las variantes | `05_HARDWARE_Y_VARIANTES/cobertura/*.png` | 20-oct | Qué ve cada variante a 3.30 m (zona ciega de G de ~3 m) |
| Privado | `08_EVIDENCIA_Y_DIAGRAMAS/privado/` | — | **No publicar** (personas, universidad, datos de red) |

Las capturas de Unreal y de la estación muestran maniquíes y personajes 3D, no personas reales (revisadas en miniatura, `docs/PLAN_GITHUB_NUEVO.md` §7).
