brahianorrego/Talos-AI/08_EVIDENCIA_Y_DIAGRAMAS/diagramas/11_ubicacion_componentes_vista_lateral.png

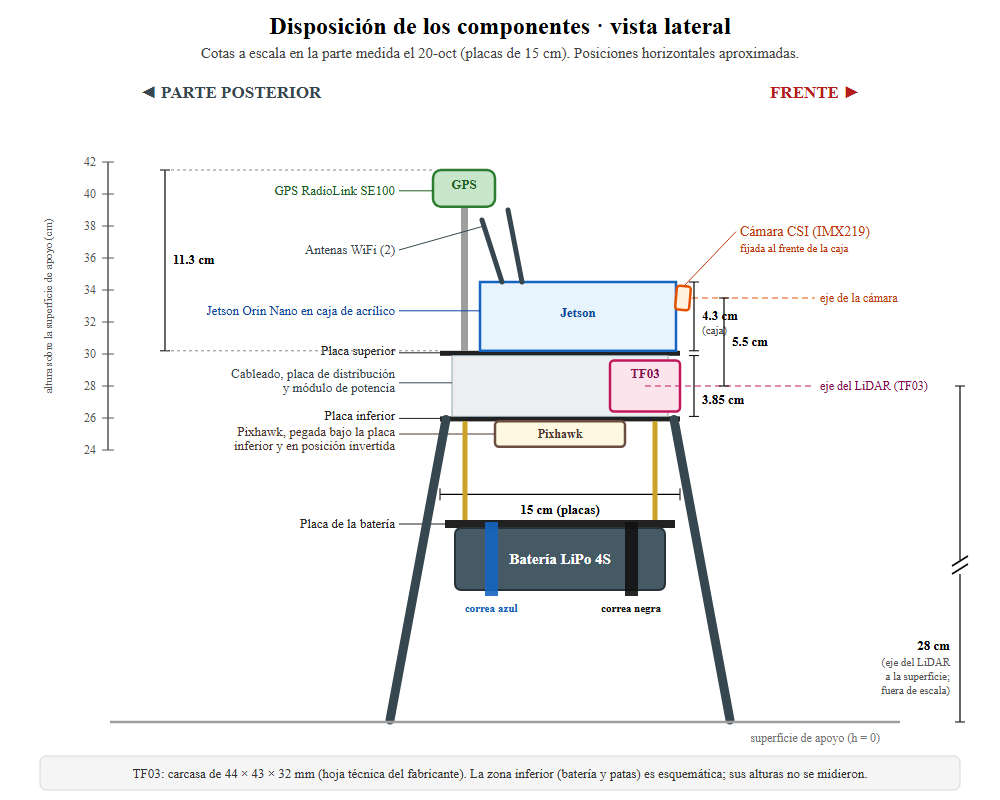
08_EVIDENCIA_Y_DIAGRAMAS/diagramas/11_ubicacion_componentes_vista_lateral.png
