brahianorrego/Talos-AI/05_HARDWARE_Y_VARIANTES/piezas_3d/stl/asm_plataforma_arriba.stl

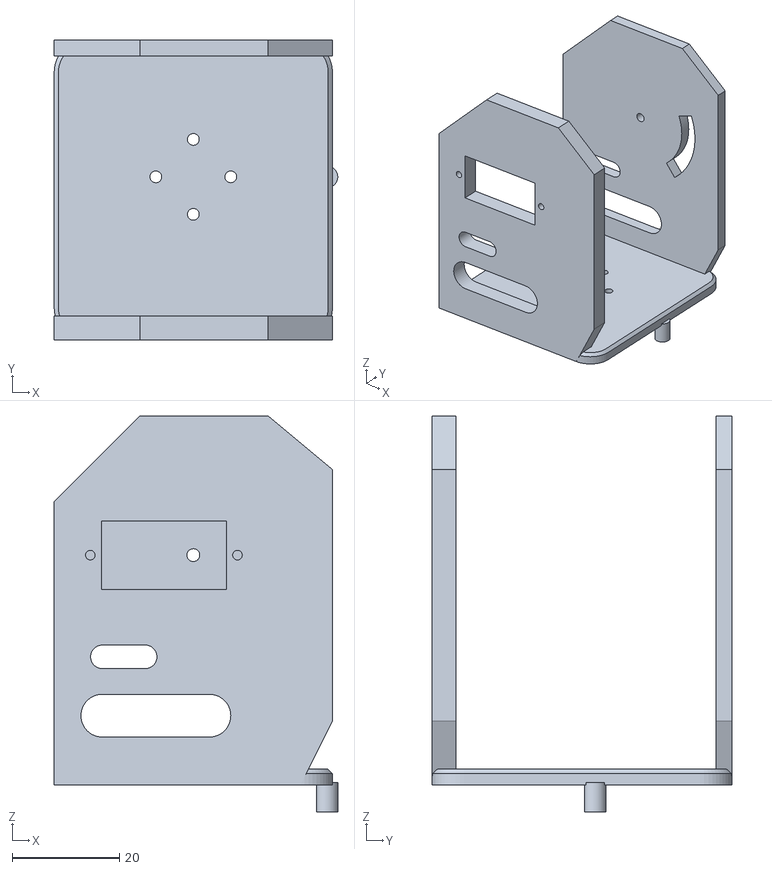
[picture p188: CAD file, 2026-10-20]
05_HARDWARE_Y_VARIANTES/piezas_3d/stl/asm_plataforma_arriba.stl
53.0 x 56.1 x 74.0
