brahianorrego/Talos-AI/05_HARDWARE_Y_VARIANTES/piezas_3d/stl/asm_cuna.stl

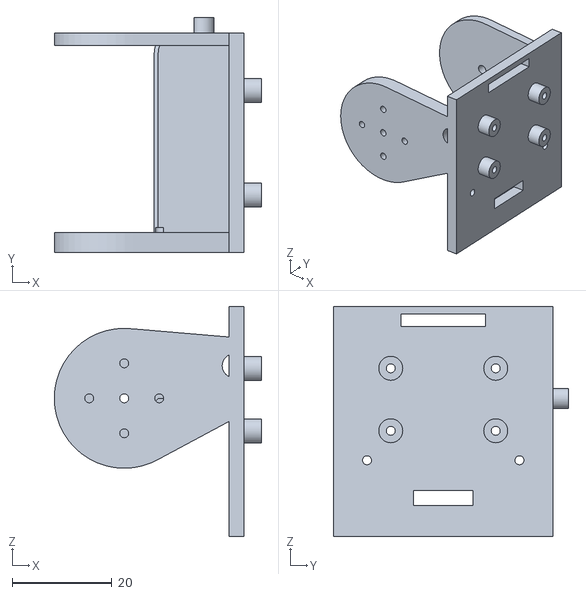
[picture p189: CAD file, 2026-10-20]
05_HARDWARE_Y_VARIANTES/piezas_3d/stl/asm_cuna.stl
41.5 x 47.1 x 46.0
