brahianorrego/Talos-AI/05_HARDWARE_Y_VARIANTES/piezas_3d/stl/asm_base.stl

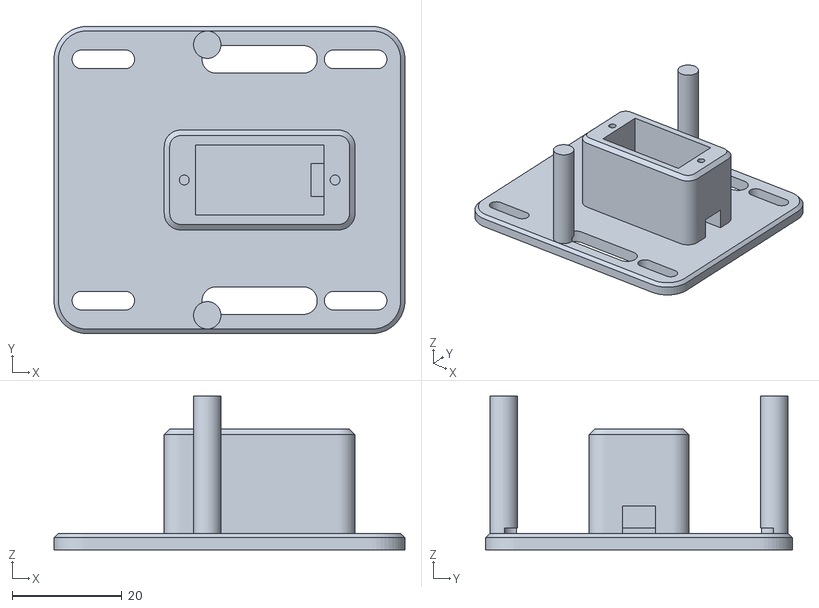
[picture p190: CAD file, 2026-10-20]
05_HARDWARE_Y_VARIANTES/piezas_3d/stl/asm_base.stl
64.0 x 56.0 x 28.0
