brahianorrego/Talos-AI/05_HARDWARE_Y_VARIANTES/piezas_3d/stl/asm_plataforma.stl

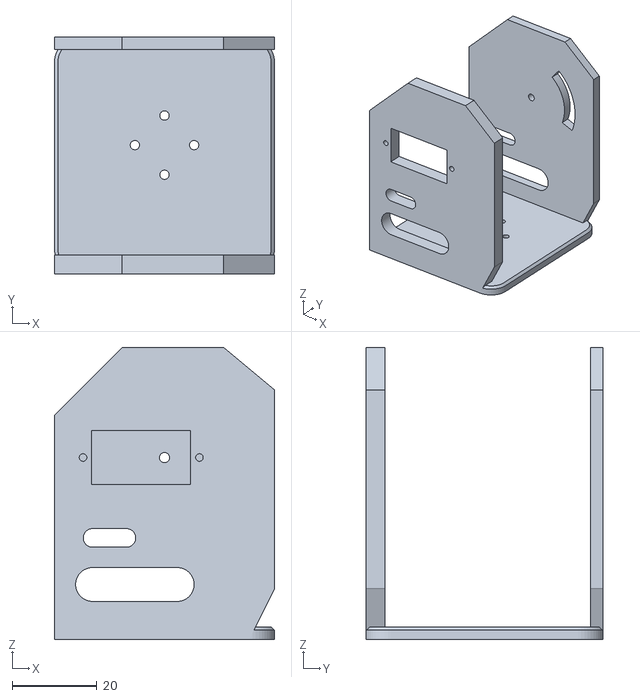
[picture p191: CAD file, 2026-10-20]
05_HARDWARE_Y_VARIANTES/piezas_3d/stl/asm_plataforma.stl
52.0 x 56.1 x 69.0
