brahianorrego/Talos-AI/05_HARDWARE_Y_VARIANTES/piezas_3d/stl/soporte_csi_doble.stl

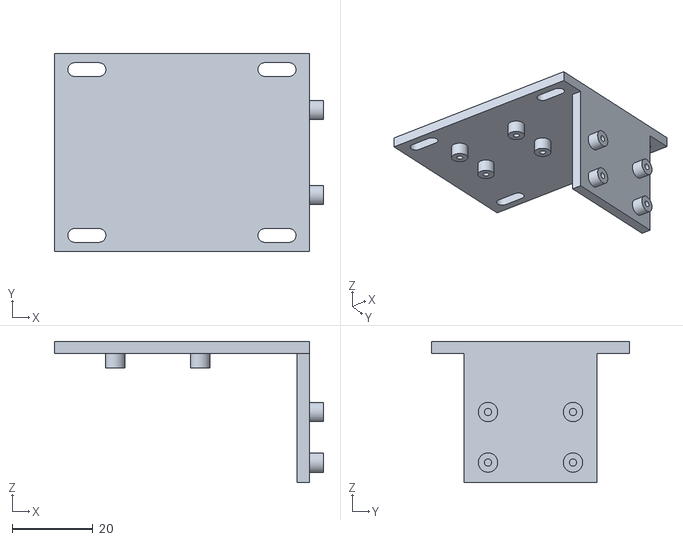
[picture p192: CAD file, 2026-10-19]
05_HARDWARE_Y_VARIANTES/piezas_3d/stl/soporte_csi_doble.stl
66.5 x 49.0 x 34.9
