brahianorrego/Talos-AI/05_HARDWARE_Y_VARIANTES/piezas_3d/stl/soporte_camara_frente.stl

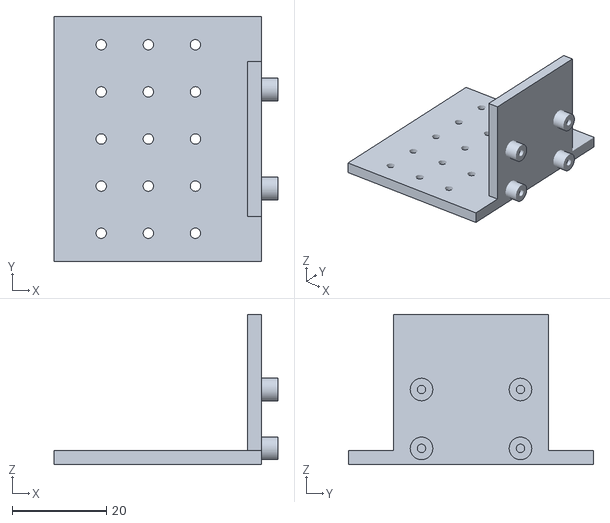
[picture p193: CAD file, 2026-10-19]
05_HARDWARE_Y_VARIANTES/piezas_3d/stl/soporte_camara_frente.stl
47.5 x 52.0 x 31.9
