brahianorrego/Talos-AI/05_HARDWARE_Y_VARIANTES/piezas_3d/stl/soporte_camara_abajo.stl

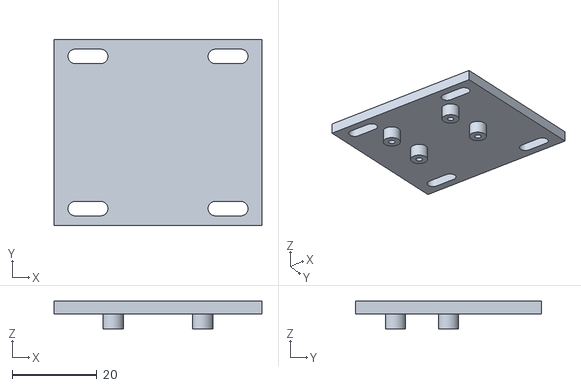
[picture p194: CAD file, 2026-10-19]
05_HARDWARE_Y_VARIANTES/piezas_3d/stl/soporte_camara_abajo.stl
49.0 x 43.9 x 6.50
