brahianorrego/Talos-AI/05_HARDWARE_Y_VARIANTES/piezas_3d/stl/soporte_tf03_colgante.stl

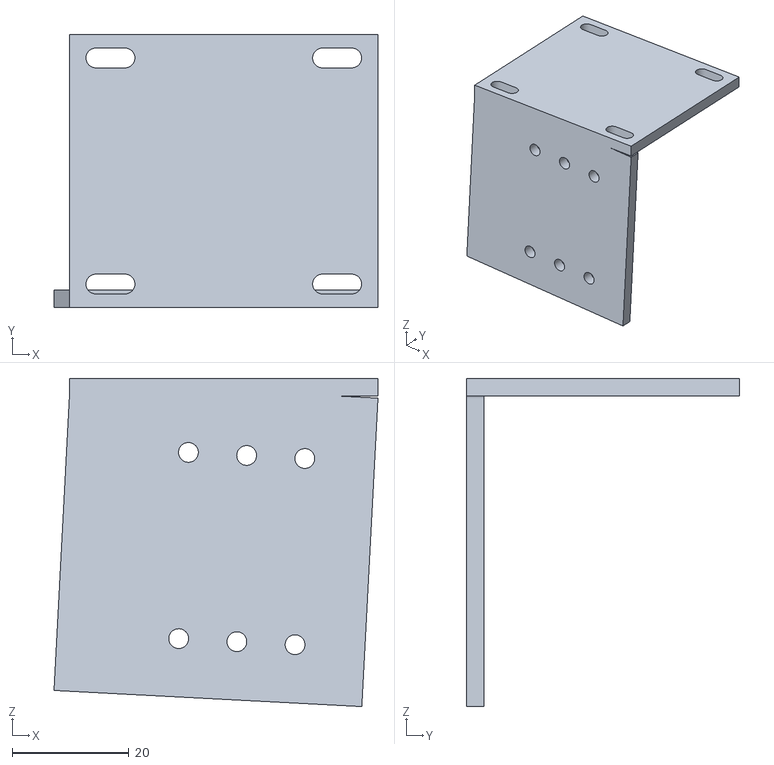
[picture p195: CAD file, 2026-10-18]
05_HARDWARE_Y_VARIANTES/piezas_3d/stl/soporte_tf03_colgante.stl
55.6 x 46.8 x 56.3
