brahianorrego/Talos-AI/05_HARDWARE_Y_VARIANTES/piezas_3d/stl/soporte_lidar_luna_pantilt.stl

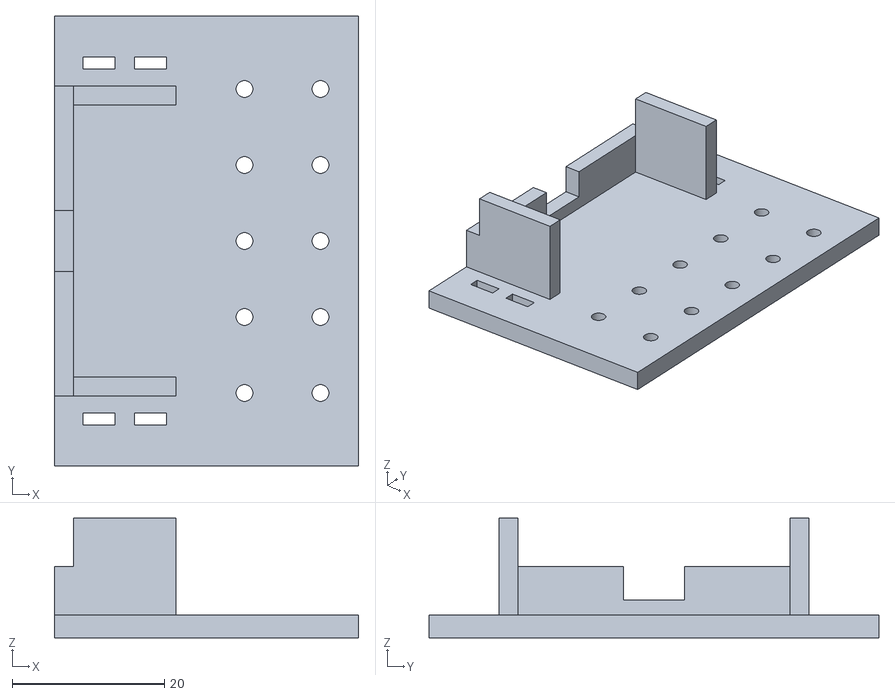
[picture p196: CAD file, 2026-10-18]
05_HARDWARE_Y_VARIANTES/piezas_3d/stl/soporte_lidar_luna_pantilt.stl
40.0 x 59.2 x 15.8
