brahianorrego/Talos-AI/05_HARDWARE_Y_VARIANTES/piezas_3d/stl/soporte_luna_pod.stl

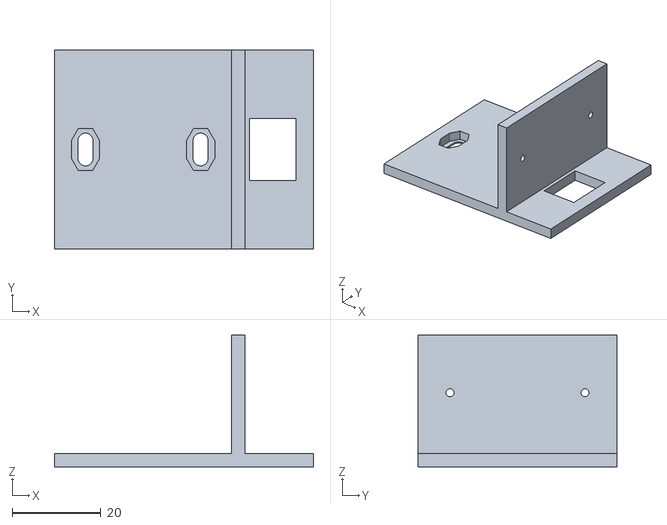
[picture p197: CAD file, 2026-10-18]
05_HARDWARE_Y_VARIANTES/piezas_3d/stl/soporte_luna_pod.stl
58.5 x 45.0 x 29.8
