brahianorrego/Talos-AI/(list of files, cad)

Other CAD files:
05_HARDWARE_Y_VARIANTES/piezas_3d/stl/asm_plataforma_colgado.stl
05_HARDWARE_Y_VARIANTES/piezas_3d/stl/pan_tilt_cuna.stl
05_HARDWARE_Y_VARIANTES/piezas_3d/stl/pan_tilt_plataforma_ARRIBA.stl
05_HARDWARE_Y_VARIANTES/piezas_3d/stl/pan_tilt_base.stl
05_HARDWARE_Y_VARIANTES/piezas_3d/stl/pan_tilt_plataforma_COLGADO.stl
05_HARDWARE_Y_VARIANTES/piezas_3d/stl/pan_tilt_plataforma_ancho_NO_APROBADA.stl
05_HARDWARE_Y_VARIANTES/piezas_3d/stl/pan_tilt_plataforma.stl
05_HARDWARE_Y_VARIANTES/piezas_3d/_v1/pan_tilt_servos_v1.scad
05_HARDWARE_Y_VARIANTES/piezas_3d/_v1/pan_tilt_servos_v2_recto.scad
05_HARDWARE_Y_VARIANTES/piezas_3d/_v1/pan_tilt_servos_v3_usb.scad
05_HARDWARE_Y_VARIANTES/piezas_3d/_v1/pan_tilt_servos_v4_solo_tilt.scad
05_HARDWARE_Y_VARIANTES/piezas_3d/_v1/soporte_camara_v1.scad
