brahianorrego/Talos-AI/02_JETSON_A_BORDO/minimo_sin_gimbal/calibrar.html

# Medir los ángulos de la cámara y del LiDAR · volver · alinear con un cartón

cámara

Los clics se hacen sobre la imagen. «Izquierda» y «derecha» son las de la imagen, no las del dron. Toca el título de un paso para pasar a él.

### Cómo funciona

- Con dos marcas de separación conocida a una distancia conocida se saca el campo de visión (horizontal y vertical).
- Con la altura de las marcas se saca la inclinación de la cámara (arriba/abajo).
- Con tu dedo (o un lápiz delgado) delante del LiDAR se ve a dónde apunta el LiDAR: el número se pone verde cuando el rayo le pega al dedo.
- Con una línea vertical de verdad (esquina de la habitación, marco de la puerta, un hilo con peso) se saca el giro de la cámara sobre su propio eje.

Todas las medidas con el metro. El resultado se guarda en la Jetson (~/calibracion_angulos.json) y el punto del LiDAR queda dibujado en el video.

LiDAR TF03 · frente

### Inclinación del dron (Pixhawk)

– cabeceo · – alabeo

Los pasos 2 y 3 miden respecto al horizonte; con el cabeceo de la Pixhawk se pasan al chasis (lo que usa la simulación). Con la batería conectada, el dron quieto mientras haces los clics. + = nariz arriba.

### Datos del dron

Altura de la superficie de apoyo sobre el suelo (cm)
Eje de la cámara sobre la superficie (cm)
Eje del LiDAR sobre la superficie (cm)
La cámara está ___ cm detrás del frente del LiDAR
Distancia del frente del LiDAR a la pared (m)
usar la del LiDAR

Pasa el mouse sobre la imagen: abajo a la derecha aparece una lupa para ver las marcas chicas. El dron debe estar quieto, de frente a la pared y con el LiDAR leyendo la pared (no una puerta abierta ni una marca). Si mediste la distancia con el metro, escribe esa en lugar de la del LiDAR.

### Paso 1 · Campo de visión horizontal

Pega dos marcas en la pared (papeles de color), una a cada lado, separadas por:

cm

Haz clic en la marca izquierda y luego en la derecha de la imagen.

Repetir

### Paso 2 · Campo vertical e inclinación de la cámara

Pega dos marcas en la pared, una arriba y otra abajo, medidas desde el suelo:

la de abajo
cmla de arriba
cm

Haz clic en la marca de abajo y luego en la de arriba.

Repetir

### Paso 3 · Dónde apunta el LiDAR

Pon el dedo (o un lápiz delgado) delante del dron, a esta distancia del LiDAR:

m

Muévelo despacio hasta que el número de arriba se ponga verde con esa distancia: ahí el rayo le pega. Haz clic en la punta del dedo. Repite 3 veces o más, y cambia la distancia si puedes.

Quitar últimoRepetir todo

### Paso 4 · Giro de la cámara sobre su eje

Busca una línea vertical de verdad que se vea en la imagen: la esquina de la habitación, el marco de una puerta o un hilo con un peso colgado. Haz 2 clics en la misma línea, uno arriba y otro abajo, lo más separados posible. Si puedes, haz otra línea en otro lugar de la imagen (así también se comprueba la inclinación).

Quitar última líneaRepetir todo

### Paso 5 · Cámara con una persona (sirve en el parqueadero)

Una persona se para de frente, entera en la imagen y con los pies a la vista, sobre una marca medida con la cinta desde el frente del LiDAR (5 a 10 m va bien). Mide el suelo plano.

Altura del lente sobre el suelo (m)
Distancia de la persona (m)

Medir 3 sQuitar

### Paso 6 · LiDAR contra el suelo (sirve en el parqueadero)

Sin nadie delante y con el suelo plano y limpio: el rayo toca el piso a una distancia que depende de su inclinación. Con la altura del eje del LiDAR se calcula el ángulo del rayo.

Altura del eje del LiDAR sobre el suelo (m)

Medir el suelo 3 sQuitar

### Resultado

Aún sin datos.

Guardar calibraciónEmpezar de nuevo

### Clics del LiDAR

# | LiDAR | inclinación | desvío
