brahianorrego/Talos-AI/04_VISOR_Y_MOTOR_GRAFICO/mediciones/capturas/anim_prueba_1.png

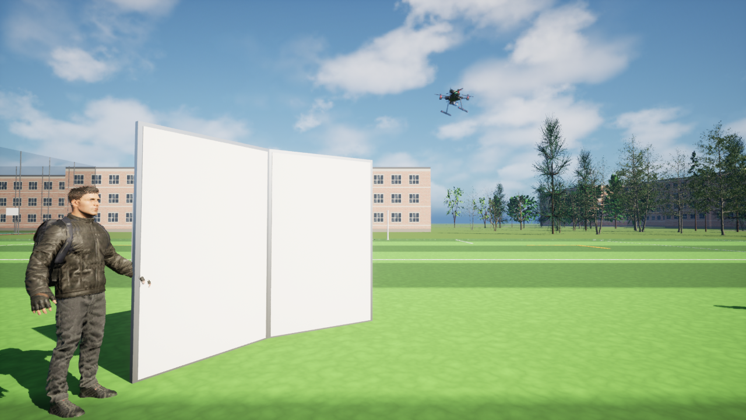
04_VISOR_Y_MOTOR_GRAFICO/mediciones/capturas/anim_prueba_1.png
