brahianorrego/Talos-AI/04_VISOR_Y_MOTOR_GRAFICO/mediciones/capturas/blender_prueba_quaternius.jpg

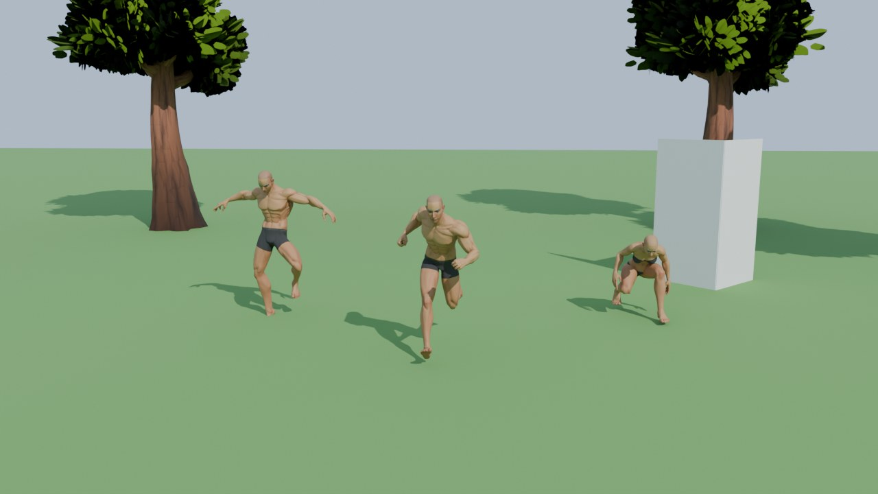
04_VISOR_Y_MOTOR_GRAFICO/mediciones/capturas/blender_prueba_quaternius.jpg
