brahianorrego/Talos-AI/04_VISOR_Y_MOTOR_GRAFICO/mediciones/capturas/prueba_personajes_3.png

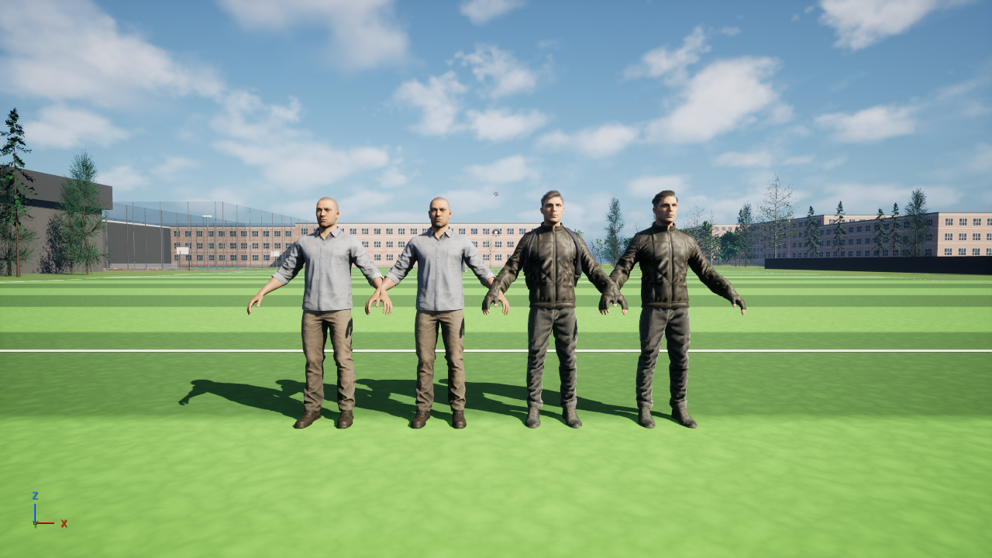
04_VISOR_Y_MOTOR_GRAFICO/mediciones/capturas/prueba_personajes_3.png
