brahianorrego/Talos-AI/04_VISOR_Y_MOTOR_GRAFICO/mediciones/capturas/unreal_prueba_cuadro240.jpg

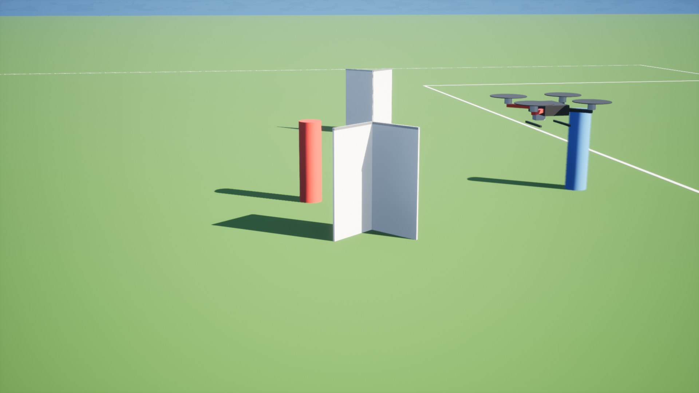
04_VISOR_Y_MOTOR_GRAFICO/mediciones/capturas/unreal_prueba_cuadro240.jpg
