brahianorrego/Talos-AI/08_EVIDENCIA_Y_DIAGRAMAS/diagramas/12_calibracion_disposicion.png

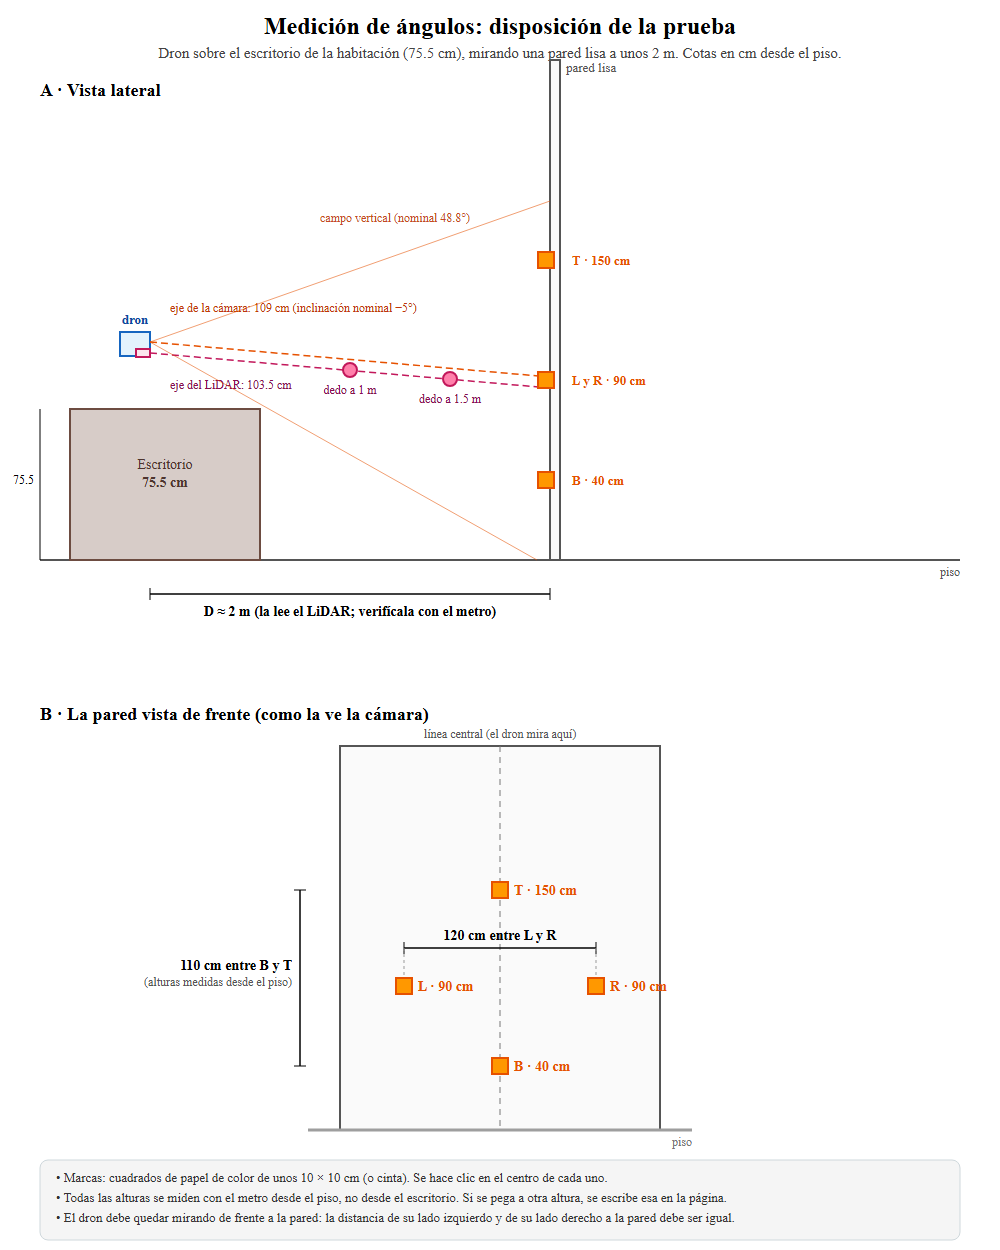
08_EVIDENCIA_Y_DIAGRAMAS/diagramas/12_calibracion_disposicion.png
