brahianorrego/Talos-AI/03_SIMULACION_RL/entorno.py

# -*- coding: utf-8 -*-
"""
Fase 2 de la misión (IA activada en la zona), vectorizada en NumPy · V16 (plan docs/PLAN_V16_REALISMO.md, avance en
docs/PROGRESO_V16.md) sobre la V15 (plan docs/PLAN_V15_CURRICULO.md).

V16 · FASE A1 (escenario y alturas): una sola partida, la misión completa con 2 paneles (NIVEL_V16, fuera del currículo
de la V15, que se conserva para comparar), 0-2 civiles que atraviesan la zona y siempre el ladrón táctico. ALTURAS
VARIABLES (decisión 3): 2.5 m en el 360° de entrada, 3.0 m en tránsito y 2.0 m al inspeccionar detrás de un muro, SOLO
sin personas conocidas a menos de R_GENTE (8 m: la que ve, la que vio y pudo seguir cerca, o el objetivo designado
mientras pudiera estar a menos de 8 m); si no, nunca por debajo de la altura segura Z_SEGURA (3.30 m, D-043). La altura
objetivo va en rampa (sin escalones).
V16 · FASE A2 (posturas humanas en la física): de pie, agachado, recostado contra la pared y gateando cambian el alto del
cuerpo, el ancho y la confianza de YOLO, la oclusión, la rapidez y el alcance; transiciones de 0.5-1 s. El ladrón táctico
elige la postura y se corre gateando detrás del muro. SALTO en fases (impulso, vuelo balístico, aterrizaje) con la MANO
hacia el dron: alcanzado si la mano entra en el cilindro del dron. CIVILES con máquina de estados (transitan, miran el dron,
lo graban, lo esquivan, se alejan o salen de la zona; nunca pasan por debajo a propósito).
V16 · FASE A3 (sensores): CÁMARA AL PISO (IMX219 fija al chasis, recta hacia abajo) para el punto ciego; TF03 FIJO AL
CHASIS mirando al frente (descarta el suelo con la actitud) y TF-LUNA en el gimbal (distancia a lo que la cámara centra,
2.5-8 m); DESENFOQUE POR MOVIMIENTO (guiñada, gimbal y movimiento relativo); gimbal BaseCam o SERVO MG90D por partida
(control.GimbalMixto); deriva del GPS/EKF (el mundo recordado se corre) y error del BARÓMETRO (la Pixhawk sostiene la altura
que ella cree). El clic del operador amarra el tracker 1 s; un "no es él" no puede re-fijar con la detección vieja.

V15 · FASE A (sensores y mundo): LiDAR TF03 a 30 m con 10 rayos por paso (100 Hz); 360° de entrada BAJO (2.5 m, cámara
-3°, con guarda) y 360° de búsqueda ALTO (altura segura); cansancio del ladrón (velocidad crítica + reserva D' + pulso);
cuerpo de las personas con estadística colombiana y altura segura del dron sacada del alcance saltando; muros con grosor;
detección parcial probabilística por alto y ancho del cuerpo.
V15 · FASE B (predicción): filtro de KALMAN (posición, velocidad y aceleración) con el ladrón a la vista; FILTRO DE
PARTÍCULAS (NP_PF hipótesis con la cinemática humana, que no atraviesan muros) sin verlo, con INFORMACIÓN NEGATIVA (las
que la cámara ve vacías se borran): lo que sobrevive es "detrás del muro", "debajo de mí" o "siguió por allá". La búsqueda
usa la nube (muro, esquina y sentido del giro); REFLEJO ANTI-CENIT predictivo (gira hacia el punto de salida) y
DISTANCIA ADAPTATIVA (si el ladrón se acerca rápido, la separación sube a la que permite frenar sin que se meta debajo).
V15 · FASE C (identidad): cuando el objetivo y otra persona se superponen en la imagen, el tracker puede CAMBIARSE de
persona (más si visten parecido y se mueven parecido). La percepción del dron sigue a quien el tracker cree que es el
objetivo (columna 0 = la persona seguida), así que un cambio no detectado lo hace seguir a otro. Tras un cruce, si la
apariencia no cuadra, si se cruzó con alguien parecido o si el Kalman rechaza mediciones, pasa a RECONFIRMAR: hover con
el objetivo en cuadro y pregunta al operador (humano en el lazo: decide él, nunca la IA).
V15 · FASE D (secuencia tras el muro, D2): 1) detrás del muro por el lado por donde se proyectó que se escondió, con un
barrido de GIRO_LADO hacia ese lado; 2) si no está, al OTRO extremo del muro y lo mismo; 3) si no está, MURO DE CANTO: en
la prolongación del muro, a A_CANTO de una punta, mirando a lo largo (de canto el muro es un palito y se ven las dos
caras), 1 m al lado de la predicción y 1 m al otro en una pasada; 4) si no, 360° de búsqueda y lo de siempre. En cualquier paso, si lo ve,
PERSECUCIÓN (interrupción táctica).
V15 · FASE E: la misión se cumple cuando el ladrón SE RINDE: un CONTADOR CONTINUO suma mientras lo sigue a la vista, se
pausa en parpadeos, memoria del tracker, PÉRDIDA y RECONFIRMAR, y vuelve a cero al pasar a la búsqueda (flanqueo, giros,
siguiente obstáculo, altura, canto). Se rinde a los T_rinde = 20 s + 100 s x reserva. Tope de 5 minutos: sin rendición
pierde el dron. Currículo de 5 niveles: 0 duelo abierto, 1 duelo con civil, 2 muro, 3 muro y civil, 4 misión completa
(3-4 muros). En los niveles 0 y 1 el ladrón solo huye y se esconde; ataca desde el 2.

V14 · CURRÍCULO PROGRESIVO: cada partida se genera en un NIVEL (current_level lo sube el entrenamiento cuando el dron
domina el actual; una fracción p_repaso de partidas repasa niveles ya superados para que no los olvide):
  0 DUELO ABIERTO     sin muros ni civiles; el ladrón huye en zigzag y a veces se mete debajo del dron (cenit)
  1 MURO ÚNICO        un muro central; el ladrón táctico se esconde detrás cruzando por sus bordes
  2 RUIDO VISUAL      un muro y un civil que se cruza una y otra vez en la línea de vista dron-ladrón
  3 MISIÓN COMPLETA   el escenario de siempre (2 muros, 0-2 peatones, ladrón táctico o aprendido, intensidad variable)

V13 · sobre la V12: (1) CURRÍCULO: una fracción de las partidas es el escenario simplificado "Un Solo Muro"; (2) GIRO_360
a 2.5 m con el gimbal en 0° (el LiDAR y la cámara barren el horizonte) a 90°/s, con el tope RATE_Y_MAX = 120°/s de la
Pixhawk; (3) INTERRUPCIÓN TÁCTICA: si YOLO detecta al ID designado en cualquier estado de búsqueda, se pasa a PERSECUCIÓN
en ese mismo cuadro; (4) STAND-OFF trigonométrico: el punto de flanqueo se calcula con el FOV para que el cono de la
cámara cubra la franja oculta detrás del muro; (5) DETECCIÓN PARCIAL: basta que asome el 15 % del bounding box.

V12 · CONTROL JERÁRQUICO HÍBRIDO (sobre la base v8-v11 que se describe más abajo):
  · Capa física (no aprende): PID de ArduPilot y del gimbal BaseCam (control.py). La red no estabiliza nada.
  · Capa táctica (aprende): la política PPO decide SOLO con el objetivo fijado (PERSECUCIÓN) y solo se le cobra el
    jitter de lo que ella misma comanda (avance, giro pedido); lo que mueve el seguimiento automático no es su culpa.
  · Capa determinista (reglas auditables): REFLEJO DE PUNTO CIEGO (si el objetivo va a quedar debajo del dron, fuera del
    cuadro con el gimbal en su tope de -45°, retrocede d = h / tan(45° + VFOV/2) + margen) y la BÚSQUEDA CON MEMORIA
    ESPACIAL: PERSECUCIÓN -> PÉRDIDA -> FLANQUEO_PROFUNDO -> GIRO_360 -> SIGUIENTE_OBSTÁCULO -> ... -> ALTURA_TÁCTICA ->
    MISIÓN_PERDIDA (T_MISION_PERDIDA s), usando la nube de puntos del LiDAR (raycasting) para elegir muros y rutas.

EL JUEGO ES EL DRON CONTRA EL LADRÓN (como el escondite de OpenAI, Baker et al. 2020), con el flujo
de trabajo real entre el dron y el operador policial (humano en el lazo):

  1. BUSCAR (SEARCH): al entrar a la zona el dron gira 360° sobre su eje buscando personas con YOLO y,
     a la vez, MAPEA LOS OBSTÁCULOS CON EL LIDAR (cada impacto del rayo frontal se guarda como un punto;
     los puntos se agrupan en segmentos = paneles). Si la vuelta no encuentra a nadie, hace BÚSQUEDA
     ACTIVA: vuela (por encima de los paneles) a un punto de separación en diagonal a la esquina de cada
     panel detectado, mira hacia su parte trasera y barre 360°, uno por uno. No usa el plano del simulador.
     Los giros son continuos: solo los pausa alguien que rompa el perímetro de colisión (D_PERIMETRO).
  2. VERIFICAR: al detectar a una persona no descartada, el dron queda en hover, la centra y lanza una
     alerta en la estación de tierra. El operador confirma con un CLIC sobre la persona:
       · clic sobre el sospechoso -> lock-on (TARGET_LOCKED).
       · sin clic en T_ESPERA_CLIC -> ese ID queda descartado y la búsqueda sigue donde iba.
  3. FIJADO (TARGET_LOCKED): la política aprendida (PPO) toma el control para mantener ESE ID en la
     vista. Seguimiento horizontal con el yaw (con banda muerta: no corrige mientras el objetivo esté en
     el 20% central del FOV) y vertical con el pitch del gimbal (el dron no sube ni baja para centrarlo).
  4. PROTOCOLO DE PÉRDIDA (determinista): si el tracker suelta el ID (más de T_TRACKER sin verlo),
     INVESTIGAR = si se perdió junto a un panel, FLANQUEO PROFUNDO: rodea la esquina por la que desapareció (sin
     rozarla) y queda DETRÁS del plano del muro, en la zona que estaba oculta; en campo abierto, se detiene
     D_STANDOFF antes de su última posición -> ASOMO (mira hacia allí y hace un paneo dirigido
     de 360° que empieza hacia el interior de la zona oculta, por donde se fue el ladrón) -> VENTAJA DE ALTURA (último recurso) (en vez de rodear el panel, sube rápido a Z_TACTICO
     sobre la zona de pérdida y barre 360° con la cámara inclinada hacia abajo: desde ahí un panel de 2.6 m
     ya no tapa a nadie). Si en cualquier paso YOLO reconfirma el ID (ReID), la IA retoma.
     Al sobrevolar un panel detectado, el gimbal baja a nadir (-85°) para ver su base y luego vuelve.

  5. INTERCEPCIÓN PREDICTIVA: si el objetivo sale del cuadro corriendo (por ejemplo, pasa por debajo del dron), antes
     del protocolo el dron sigue su trayectoria extrapolada T_PREDICCION s con la nariz y el gimbal hacia el punto
     predicho. El protocolo de pérdida usa su último vector de movimiento: el punto de separación queda en la
     esquina por la que escapó y el paneo empieza hacia ese lado.

  PERSECUCIÓN: navegación predictiva (apunta el empuje al punto donde estará el ladrón dentro de T_LEAD s, no a su
  posición actual) con distancia óptima de seguimiento de 3.5 a 5 m (si está a menos de 3.5 m frena; a menos de
  2.5 m retrocede). El dron (VEL_PERSEGUIR) es más rápido en línea recta que el ladrón (VEL_CORRER).
  CINEMÁTICA: las personas tienen aceleración y frenado limitados y no giran en seco: un giro de más de 45° las
  obliga a frenar. El dron se inclina al acelerar (cabeceo = atan(a/g)); el gimbal tarda TAU_ESTAB en compensarlo,
  así que acelerar y frenar a golpes mueve la imagen y puede sacar al objetivo del encuadre.

  LIDAR: un solo rayo rígidamente acoplado al eje de la cámara (yaw del dron + pitch del gimbal). Mide la distancia
  a lo que esté en el centro de la imagen: un panel, una persona o el suelo. Es obstáculo si pega antes de donde
  debería tocar el suelo (la Jetson lo calcula con la altura y el pitch). Si la cámara mira abajo, no hay protección
  frontal. El mapa de paneles se arma solo con impactos de obstáculo que no sean personas.

  MISIÓN CUMPLIDA: mantener el rastreo T_RASTREO s desde el lock-on (con las recuperaciones que hagan falta).
  MISIÓN FALLIDA:  agotar el protocolo de pérdida sin recuperarlo, no fijar al sospechoso antes de
                   T_BUSQUEDA_MAX, chocar con alguien o con un obstáculo, o salir de la geocerca.
  Sobrevivir y esquivar es obligatorio, pero no basta: el objetivo es el rastreo.

ÁRBITRO DE SEGURIDAD: solo se esquiva ante una amenaza real (persona a < D_CRITICA, o a < D_AMENAZA
acercándose). La guiñada es independiente de la evasión y tiene rampa de aceleración (como
ATC_ACCEL_Y_MAX de ArduPilot). Un giro iniciado (búsqueda o pedido por la IA) no se corta ni se
invierte antes de T_GIRO_MIN, y ninguna detección de peatones lo interrumpe salvo el perímetro.

LADRÓN: táctico (se cubre detrás de los paneles del lado opuesto al dron, sigue la sombra del panel
si el dron se mueve, se asoma de vez en cuando, cambia de cubierta y a veces carga contra el dron) o,
en una fracción de las partidas de entrenamiento, la política aprendida por autojuego.
PEATONES: 0 a 2 en la zona, guionados (casi siempre deambulando). Todos existen desde el reinicio.

El dron NO ve el mundo: ve lo mismo que el dron real (cámara de 38.9°, YOLO con ruido y pérdidas,
LiDAR frontal, 100 ms de retraso) más lo que la Pixhawk sabe (posición GPS, rumbo, altura).

Convenciones: plano XY en metros, z hacia arriba. Rumbo psi antihorario desde +X. Ángulo de una
persona respecto a la nariz: positivo = a la DERECHA. Guiñada en °/s: positiva = hacia la derecha.
La fase 1 (vuelo del piloto con bloqueo frontal) está en mision.py.
"""
import numpy as np

from control import AutopilotoArduPilot, GimbalBaseCam, GimbalMixto

# ----------------------------------------------------------------------------- sensores
DT = 0.1
HFOV = 38.9
VFOV = 29.7
ALTO_IMG = 480.0
ALTURA_PERSONA = 1.72            # V15: estatura que SUPONE la Jetson para estimar la distancia por el bbox (la media)
# V15 · CUERPO DE UNA PERSONA COLOMBIANA (D7): estatura de cada persona ~ N(1.72, 0.07) m entre 1.58 y 1.88 (NCD-RisC
# 2019: hombres 171.9 cm). Alcance de pie (brazo arriba) = 1.33 x estatura; salto de un adulto no entrenado 0.30-0.50 m;
# hombros 0.45 m. La ALTURA SEGURA del dron sale del alcance saltando del percentil 99 + 0.3 m de margen.
ESTATURA_MEDIA, ESTATURA_SD, ESTATURA_MIN, ESTATURA_MAX = 1.72, 0.07, 1.58, 1.88
K_ALCANCE_PIE = 1.33
SALTO_ADULTO = (0.30, 0.50)
ANCHO_HOMBROS = 0.45
Z_SEGURA = round(max(3.0, K_ALCANCE_PIE * min(ESTATURA_MEDIA + 2.326 * ESTATURA_SD, ESTATURA_MAX) + SALTO_ADULTO[1] + 0.3), 2)
RADIO_PERSONA = 0.25

# ----------------------------------------------------------------------------- dron
N_CONFIRMACION = 3
DURACION_EVASION = 1.5
ENFRIAMIENTO = 1.0
VEL_LATERAL = 1.5
VEL_ASCENSO = 0.7
TAU_DRON = 0.35
ACC_MAX_DRON = 4.0
J_MAX_DRON = 5.0               # m/s³: limitador de jerk del autopiloto (como PSC_JERK_XY de ArduPilot, 5 por defecto)
TAU_ACTITUD = 0.15             # s que tarda el chasis en inclinarse a la actitud que pide la aceleración
TAU_ESTAB = 0.15               # s que tarda el gimbal en compensar un cambio de cabeceo del chasis
GIMBAL_REL_MIN, GIMBAL_REL_MAX = -100.0, 25.0   # límites mecánicos del gimbal respecto al chasis
G = 9.81
YAW_KP, YAW_MAX, YAW_ZONA = 2.0, 60.0, 2.0
BANDA_MUERTA = 0.10 * HFOV     # ±3.9°: el 20% central del FOV horizontal; ahí el yaw no corrige
BANDA_RECENTRA = 0.04 * HFOV   # si corrige, recentra hasta ±1.6° y se detiene (histéresis, sin vaivén)
YAW_GIRO_IA = 60.0             # giro pedido por la IA con el objetivo perdido
YAW_BUSQUEDA = 40.0            # giro de 360° del modo BUSCAR
YAW_ULTIMO = 30.0              # sin giro pedido: la nariz vuelve al último rumbo conocido del objetivo
ACEL_YAW = 180.0               # °/s²: rampa de la guiñada (rotación continua, sin saltos)
T_GIRO_MIN = 1.5               # un giro iniciado no se corta ni se invierte antes de esto
D_PERIMETRO = 2.0              # solo alguien a menos de esto pausa un giro de búsqueda
VEL_AVANCE = 1.5               # avance a ciegas (objetivo fuera de vista)
VEL_PERSEGUIR = 4.5            # persecución: más rápido que el ladrón corriendo en línea recta
T_LEAD = 1.0                   # navegación predictiva: apunta adonde estará el ladrón dentro de este tiempo
K_RANGO = 1.2
R_OPT_MIN, R_OPT_MAX = 3.5, 5.0  # distancia óptima de seguimiento (el ladrón queda bien encuadrado)
R_RETROCEDE = 2.5              # más cerca que esto, retrocede despacio para no sobrevolarlo
D_PEATON_FRENTE = 4.0          # no persigue si hay un peatón cerca al frente
DIST_PROTECCION_FRONTAL = 3.0  # el LiDAR bloquea el avance si hay algo a menos de esto al frente
D_CRITICA, D_AMENAZA, V_ACERCA = 3.0, 8.0, 0.4
Z_NOMINAL, Z_MIN, Z_MAX = Z_SEGURA, 1.8, 7.0   # V15: la altura nominal (seguir, verificar) es la segura (3.30 m)
Z_REF_OBS = 2.3                # referencia de altura en las observaciones (la de la V14: las redes ya entrenadas la usan)
Z_PILOTO = 2.3                 # altura del vuelo manual del piloto en la fase 1 de la misión (antes de fijar)
# gimbal (pitch de la cámara; BaseCam por PWM desde AUX1, ±45°): hace el seguimiento VERTICAL
# LÍMITE FÍSICO DURO del pitch de la cámara (v9): nunca por debajo de -45° ni por encima de +15°, pase lo que pase
# (comando, filtro, cabeceo del chasis). En el dron real: pwm = 1500 + θ·500/45 con el mismo recorte (la BaseCam física solo cubre ±45°).
GIMBAL_MIN, GIMBAL_MAX = -45.0, 15.0
GIMBAL_NADIR = -45.0           # al sobrevolar un panel (recortado al límite duro)
GIMBAL_TACTICO = -45.0         # barrido desde la altura táctica (recortado al límite duro)
D_NADIR = 2.5                  # a menos de esto (horizontal) de un panel detectado, sobrevolando, se mira en nadir
GIMBAL_VEL, GIMBAL_KP = 30.0, 4.0   # v9: los motores brushless del gimbal giran a lo sumo 30°/s
# filtro físico del gimbal: EMA en la salida del actuador (el ángulo que se manda por PWM). Cada paso de 0.1 s la
# cámara recorre solo ALPHA_GIMBAL de lo que le falta (constante de tiempo ~0.45 s): no puede saltar de un cuadro al
# siguiente, elija lo que elija la política. El comando no se adelanta más de G_ADELANTO al ángulo físico (anti-windup).
ALPHA_GIMBAL = 0.2
G_ADELANTO = 15.0
GIMBAL_VEL_FISICA = 30.0       # °/s máximos del ángulo físico a la salida del EMA (aunque el comando sea extremo)
GIMBAL_BANDA = 0.10 * VFOV     # banda muerta vertical (20% central del FOV vertical)
GIMBAL_RECENTRA = 0.04 * VFOV
D_REPOSO = 8.0                 # sin nadie a quien seguir, la cámara mira al suelo a esta distancia
VEL_REGRESO_Z = 0.3

# ----------------------------------------------------------------------------- misión
BUSCAR, VERIFICAR, FIJADO, INVESTIGAR, ASOMO, VENTAJA_ALTURA, PREDECIR = 0, 1, 2, 3, 4, 5, 6
BUSQUEDA_IA = 7                # pérdida del objetivo con la política al mando (aprendizaje end-to-end)
# PÉRDIDA POR APRENDIZAJE: al perder el objetivo la política conserva el control de motores y gimbal (BUSQUEDA_IA) en
# vez del protocolo determinista (PREDECIR -> INVESTIGAR/flanqueo profundo -> ASOMO -> VENTAJA_ALTURA). Ve la última
# posición conocida, el tiempo sin verlo y el mapa del LiDAR, y aprende a buscar por el bono de re-adquisición.
# v11-hibrido: PERDIDA_IA = False (decisión D-015). Con True la política busca por aprendizaje y se compara con el protocolo.
PERDIDA_IA = False
# V12 · BÚSQUEDA DETERMINISTA CON MEMORIA ESPACIAL (SLAM). Estados en orden, con histéresis (tiempo mínimo en cada uno y
# ReID de N_REID cuadros para volver), así no oscila entre estados:
#   PERSECUCIÓN (FIJADO: la IA al mando) -> PÉRDIDA (PREDECIR: no se ve hace T_PRED_INI si corría o T_TRACKER si iba
#   lento; sigue su vector de escape) -> FLANQUEO_PROFUNDO (INVESTIGAR: detrás del muro donde se lo vio por última vez)
#   -> GIRO_360 (ASOMO: barrido que además completa el mapa del LiDAR) -> SIGUIENTE_OBSTÁCULO (el siguiente panel de la
#   memoria, sin revisar) -> GIRO_360 -> ... -> ALTURA_TÁCTICA (VENTAJA_ALTURA, gimbal en -45°) -> otra ronda con el
#   mapa ampliado -> MISIÓN_PERDIDA a los T_MISION_PERDIDA s sin recuperarlo.
SIGUIENTE_OBSTACULO = 8
RECONFIRMAR = 9                # V15 · fase C: duda de identidad, el operador confirma
MURO_CANTO = 10                # V15 · fase D: mirar el muro de canto corriéndose 1 m a cada lado (D-044)
NOMBRE_ESTADO = ["BUSCAR", "VERIFICAR", "PERSECUCION", "FLANQUEO_PROFUNDO", "GIRO_360", "ALTURA_TACTICA", "PERDIDA",
                 "BUSQUEDA_IA", "SIGUIENTE_OBSTACULO", "RECONFIRMAR", "MURO_DE_CANTO"]
BUSQUEDA_ESTADOS = (PREDECIR, INVESTIGAR, ASOMO, SIGUIENTE_OBSTACULO, VENTAJA_ALTURA, MURO_CANTO, RECONFIRMAR)   # C3
T_PERDIDA_LENTO = 1.0          # objetivo lento: s en PÉRDIDA (siguiendo su vector) antes del flanqueo
T_HISTERESIS = 1.0             # s mínimos en un estado de búsqueda antes de pasar al siguiente
T_MISION_PERDIDA = 90.0        # s sin recuperarlo desde que se perdió -> MISIÓN PERDIDA
K_OFFSET = (1.0, 1.5, 2.0)
# V13 · CURRÍCULO (entrenamiento modular): fracción de partidas con UN SOLO MURO (el segundo panel se superpone al
# primero). Baja del 30 % (nivel 0) al 10 % (nivel 1) a medida que el dron domina el flanqueo básico.
P_UN_MURO = (0.30, 0.10)          # (V13; en la V14 lo reemplazan los niveles del currículo)
# V14 · NIVELES DEL CURRÍCULO
NIVELES = ["Duelo abierto", "Duelo con civil", "Muro", "Muro y civil", "Misión completa"]     # V15 (D1)
NIVEL_ATAQUE = 2               # V15 (D6): desde este nivel el ladrón ataca (en 0 y 1 solo huye y se esconde)
MUROS_N4 = (3, 4)              # muros de la misión completa
# V15 · fase E: guardas de velocidad para partidas largas
MARGEN_CERCA = 1.5
A_CERCA, T_LAG_CERCA = 1.5, 0.5   # frenado efectivo del dron (cascada con jerk limitado) y su retardo, medidos             # geocerca tipo ArduPilot (FENCE + AVOID): frena para no pasar de ARENA - esto
R_PERSONA_MEM, T_PERSONA_MEM = 2.5, 3.0   # no se mueve hacia alguien visto hace menos de T_PERSONA_MEM s a menos de esto
N_NIVELES = len(NIVELES)
P_CENIT_N0 = 0.3               # nivel 0: partidas en que el ladrón intenta meterse debajo del dron (el resto huye)
L_GUION_TACTICO, L_GUION_HUIDA, L_GUION_CENIT = 0, 1, 2
P_REVERSA = 0.25               # huida: probabilidad de que el siguiente cambio de rumbo sea un giro de 180° (cambio brusco)
T_RUMBO_HUIDA = (2.5, 5.0)     # s entre cambios de rumbo de la huida en zigzag
ANCHO_DISTRACTOR = 3.0         # m a cada lado de la línea de vista que recorre el civil distractor (nivel 2)
F_CRUCE_DISTRACTOR = 0.65      # cruza la línea de vista a este tanto del camino dron -> ladrón (más cerca del ladrón)
D_RESPETO_CIVIL = 3.0          # un civil real no camina hacia un dron: su recorrido queda a más de esto del dron
LEJOS_PANEL = 60.0             # nivel 0: los paneles quedan fuera de la arena (el LiDAR no llega)
# V13 · GIRO_360 óptimo: altura y pitch FIJOS durante todo el giro; gira a YAW_GIRO_360 (9°/cuadro a 10 Hz: cada persona
# queda ~4 cuadros en el FOV horizontal de 38.9°, sin desenfoque), nunca más rápido que RATE_Y_MAX (control.py).
# Pedido original: 2.5 m y gimbal en 0°. Medido con la política de la V12 (192 entornos x 150 s, misma semilla):
#     2.5 m / 0°   -> cumplida 39 %, ALCANZADO 48 %  (dentro del salto del ladrón, 2.5-2.7 m, y por debajo de Z_ATAQUE;
#                                                     con la cámara horizontal no ve a nadie a menos de ~4 m)
#     3.0 m / 0°   -> cumplida 56 %, alcanzado 17 %  (el rayo del LiDAR pasa por encima de los muros de 2.6 m: no mapea)
#     3.0 m / -15° -> cumplida 67 %, alcanzado 18 %, panel 3 %  (el borde superior de la imagen queda en el horizonte; el
#                                                     LiDAR toca los muros entre 1.5 y 11 m; ve personas desde 2.7 m)
# Se dejan los valores de la última fila. Para el pedido original exacto: Z_GIRO = 2.5 y GIMBAL_GIRO = 0.0.
Z_GIRO = 3.0
GIMBAL_GIRO = -15.0
# V15 (D5): el 360° de BÚSQUEDA va a la altura segura. Cámara a -12° (fase D): con -8° (fase A) no ve a nadie a menos de
# ~4.4 m, justo donde queda el ladrón escondido detrás de un muro visto desde el punto de flanqueo; a -12° mapea muros de
# 3.3 a 15.5 m (los lejanos ya los mapeó la vuelta de entrada) y ve cabezas desde 3.6 m. Comparado en
# informes/evaluacion_v15-fase-A.md (-8 vs -15 en los niveles: igual) y evaluacion_v15-fase-D.md (-8/-12/-15 tras el muro)
Z_GIRO = Z_SEGURA
GIMBAL_GIRO = -12.0
YAW_GIRO_360 = 90.0
T_ESPERA_GIRO = 2.0
R_DESPEJE = 1.2                # V13: a menos de esto (horizontal) de un muro o de un punto de la nube no baja de Z_TRANSITO            # si no puede bajar a Z_GIRO (alguien cerca, despeje), empieza a girar igual a los 2 s
# V13 · INTERRUPCIÓN TÁCTICA: en cualquier estado de búsqueda, la detección de YOLO del ID designado cancela la búsqueda
INTERRUPCION = True
# V13 · STAND-OFF TRIGONOMÉTRICO: detrás del muro hay una franja oculta de D_ZONA_OCULTA de fondo (donde se agacha
# alguien pegado a la pared). Para que el cono horizontal de la cámara la cubra entera mirando a lo largo del muro desde
# su esquina, el punto queda a b = D_ZONA_OCULTA/2 detrás del plano del muro y a a = b / tan(HFOV/2 - margen) por fuera
# de la esquina: ~2.4 m y 0.8 m (2.5 m en diagonal).
D_ZONA_OCULTA = 1.6
MARGEN_FOV = 1.0               # ° que se quitan al semiángulo del FOV (el borde de la imagen detecta peor)     # offset táctico en la esquina: se prueban separaciones crecientes antes de volar por encima
T_BUSQUEDA_IA = 60.0           # s buscando sin re-adquirirlo -> misión fallida (v9: 20 -> 60 s, margen para revisar
                               # varios muros como un operador real; perderlo ya no termina la misión)
VEL_IA_AVANCE, VEL_IA_LATERAL = 3.0, 1.5     # m/s de las consignas de avance y desplazamiento lateral
PASO_Z_IA, PASO_GIMBAL_IA = 0.15, 3.0        # por paso (0.1 s): 1.5 m/s de subida/bajada y 30°/s del gimbal
N_SECT, R_SECT = 8, 8.0        # mapa local del LiDAR para la IA: 8 sectores alrededor del dron, hasta 8 m
# MAPA DESCUBIERTO (nube de puntos persistente, SLAM básico): los impactos del LiDAR en coordenadas absolutas (X, Y) se
# guardan toda la misión (giro de 360° incluido) y entran a la red como una grilla de ocupación de GRID_N x GRID_N celdas
# de GRID_CELDA m alrededor del dron, alineada con su rumbo (filas: atrás -> adelante; columnas: derecha -> izquierda)
GRID_N, GRID_CELDA = 12, 1.5
D_DEDUP_LIDAR = 0.3            # un impacto a menos de esto de uno ya guardado no se repite (el mapa no se satura)
B_GIRO, B_TRANSITO, B_INSPECCION = 0, 1, 2      # subfases de BUSCAR (giro, vuelo a un panel, barrido detrás de él)
T_OPERADOR = (1.0, 2.0)        # s que tarda el operador en responder SÍ / NO
T_VER_MIN = 0.5                # s de video que necesita el operador para decidir (aunque la persona se esconda después)
T_ESPERA_CLIC = 3.0            # sin clic del operador en este tiempo, ese ID queda descartado
T_BUSQUEDA_MAX = 60.0          # sin lock-on en este tiempo: misión fallida (no encontrado)
T_RASTREO = 30.0               # (hasta la V14: rastreo acumulado para cumplir; la V15 usa la rendición)
# V15 · FASE E · RENDICIÓN (D3): el contador continuo llega a T_RINDE_BASE + T_RINDE_RESERVA x reserva del ladrón
T_RINDE_BASE, T_RINDE_RESERVA = 20.0, 100.0
# D-041 (arquitecto; idea de Brahian: "que el dron sea tan lógico que el ladrón se dé por vencido"): MORAL del ladrón.
# Cada vez que el dron lo vuelve a encontrar tras esconderse (el mismo evento que cobra R_DESCUBRE) su moral baja
# x K_MORAL (mínimo MORAL_MIN); T_rinde = T_RINDE_BASE + T_RINDE_RESERVA x reserva x moral.
K_MORAL, MORAL_MIN = 0.8, 0.3
# C1 (diagnóstico del nivel 4; Brahian eligió 4 s, no 8: más tiempo premiaría que el ladrón se muestre por error): si el dron
# lo re-adquiere a lo sumo T_PAUSA_REID s después de perderlo, el contador continuo se PAUSA aunque haya pasado a un estado
# de búsqueda; pasado ese tiempo vuelve a cero como antes
T_PAUSA_REID = 4.0
# C3: custodia (caso policial: no perderlo hasta que llegue la patrulla): vista acumulada en la partida de 5 min de al
# menos estos segundos, o el ladrón se rindió
CUSTODIA_S = (60.0, 90.0)
T_TRACKER = 1.0                # s que el tracker conserva el ID sin verlo
N_REID = 4                     # cuadros confirmando la apariencia para re-adquirirlo
# V13 · DETECCIÓN PARCIAL: YOLO detecta a una persona aunque solo asome la cabeza. Se muestrea su cuerpo en N_MUESTRAS
# alturas; si al menos FRAC_DET_MIN de su bounding box queda dentro de la imagen y sin tapar por un muro, cuenta
N_MUESTRAS_PERSONA = 8         # V15: 8 alturas x 3 anchos (antes 12 alturas): misma resolución, menos cómputo
FRAC_DET_MIN = 0.15
Z_TRANSITO = max(3.2, Z_SEGURA)  # vuelos de inspección e investigación por encima de los paneles (V15: y del salto)
Z_TACTICO = 5.5                # ventaja de altura (último recurso): desde aquí un panel de 2.6 m tapa mucho menos
VEL_SUBIDA_RAPIDA = 2.5        # m/s de subida (WPNAV_SPEED_UP por defecto de ArduPilot)
# intercepción predictiva
T_PRED_INI = 0.3               # s sin verlo para empezar a predecir (si iba rápido)
V_PRED_MIN = 0.8               # m/s: más lento que esto no se extrapola (se escondió caminando)
T_PREDICCION = 2.0             # s siguiendo la trayectoria extrapolada
VEL_PRED_MAX = 4.0
YAW_MAX_PRED = 120.0           # °/s de guiñada para re-encuadrarlo
D_APROX = 10.0                 # al fijarlo, si está más lejos que esto, el dron va hacia él de inmediato
YAW_DIRECCIONAL = 60.0         # °/s del paneo dirigido del asomo
# árbitro: esquive reflejo cuando alguien corre hacia el dron
D_REFLEJO = 5.0
V_ATAQUE = 1.5                 # m/s de acercamiento que se considera un ataque
VEL_ESQUIVE_Z = 1.2
TASA_ATAQUE = 0.06             # ataques espontáneos del ladrón por segundo (con el dron cerca y al alcance)
# v9: ATAQUE DEL LADRÓN ACORRALADO Y SALTO. Si el dron baja de Z_ATAQUE y el ladrón está acorralado (el dron cerca y su
# huida bloqueada por un muro o el borde a menos de 2 m), corre hacia el dron (TASA_ACORRALADO por s) y, a menos de
# D_SALTO, salta: alcance de pie ALCANCE_PIE (brazo arriba) y en el salto entre 2.5 y 2.7 m durante T_SALTO.
Z_ATAQUE = Z_SEGURA            # V15: por debajo de la altura segura el ladrón puede intentar alcanzarlo
TASA_ACORRALADO = 0.8
D_ACORRALADO = 8.0
D_SALTO = 1.4
ALCANCE_PIE = 2.2
ALCANCE_SALTO = (2.5, 2.7)
T_SALTO, T_RECARGA_SALTO = 0.5, 1.5
# V12 · REFLEJO DE PUNTO CIEGO. Con el gimbal en su tope físico (-45°) el borde inferior de la imagen mira a
# -(45° + VFOV/2) = -59.9°: a una altura h, todo lo que esté a menos de d = h / tan(45° + VFOV/2) en horizontal queda
# DEBAJO del cuadro. Si el objetivo (su posición o su vector de escape) entra en esa zona, el dron da un paso táctico hacia
# atrás hasta d + MARGEN_CIEGO y gira hacia él si salió del cuadro. Histéresis: se apaga a d + MARGEN_CIEGO + HIST_CIEGO.
MARGEN_CIEGO = 1.0
HIST_CIEGO = 0.5
VEL_CIEGO = 4.5                # m/s máximos del reflejo (retroceso + la velocidad del objetivo; = VEL_PERSEGUIR)
T_CIEGO_EXTRA = 2.0            # la PÉRDIDA se alarga hasta esto mientras el reflejo siga apartando al dron
K_CIEGO = 1.5
LIDAR_MAX = 30.0               # V15: TF03-100, 30 m con objetivo oscuro (10 %) a pleno sol (antes 20 m)
RAYOS_POR_PASO = 10            # V15: el TF03 mide a 100 Hz: 10 rayos en cada paso de 0.1 s, repartidos en el giro
# V15 · MUROS CON GROSOR (antes eran líneas): tapan la vista y chocan como una caja de este grosor
GROSOR_MURO = 0.2
# V15 · DETECCIÓN PARCIAL PROBABILÍSTICA: el cuerpo se muestrea en alto (N_MUESTRAS_PERSONA) y ancho (OFFS_ANCHO); la
# probabilidad de detección sube de 0 (P_FRAC[0] visible) a la de la persona entera (P_FRAC[1] visible)
OFFS_ANCHO = (-1.0, -0.55, 0.0, 0.55, 1.0)      # columnas, en fracciones del medio ancho del cuerpo a cada altura


def medio_ancho(fh):
    """Medio ancho del cuerpo según la fracción de la estatura: piernas juntas (~0.26 m), torso con los hombros
    (ANCHO_HOMBROS = 0.45 m) y cabeza (~0.18 m)."""
    return np.where(fh < 0.5, 0.13, np.where(fh < 0.85, ANCHO_HOMBROS / 2, 0.09))
P_FRAC = (0.05, 0.35)
# V15 · CANSANCIO DEL LADRÓN (velocidad crítica de Monod y Scherrer; balance de la reserva W' de Skiba et al. 2012):
# por encima de VC gasta la reserva D'; por debajo la recupera despacio. Con la reserva baja ya no esprinta (trota), se
# esconde más y ataca menos. El PULSO es para el visor y la narrativa: el dron no lo observa.
# D-041 (arquitecto): adulto no entrenado y bajo tensión. VC 3.0 -> 2.5 m/s, D' 150 -> 120 m; la tensión de huir gasta
# reserva (K_TENSION m/s equivalentes mientras está alerta y moviéndose) y, expuesto a la cámara mientras cambia de
# cubierta, ESPRINTA a V_SPRINT (ráfagas limitadas por la stamina de 2 s), como alguien que huye de verdad.
VC_LADRON = 2.5                # m/s
D_PRIMA = 120.0                # m
K_TENSION = 0.12               # m/s de gasto extra por la tensión (alerta y moviéndose)
V_SPRINT = (4.2, 5.0)          # m/s del esprint (por partida); solo con reserva > 0.25
TAU_RECUPERA = 400.0           # s de la recuperación exponencial de la reserva
V_TROTE = 2.5                  # m/s: sin reserva solo trota
PULSO_REPOSO, PULSO_ESTRES, PULSO_MAX, TAU_PULSO = 70.0, 30.0, 190.0, 30.0
# V15 · 360° (D5): el de ENTRADA (el primero, al llegar a la zona) BAJO para mapear todos los muros de 0 a 30 m; si
# alguien entra a menos de R_GUARDA_ENTRADA o se acerca rápido, sube a la altura segura y termina la vuelta arriba
Z_ENTRADA, GIMBAL_ENTRADA, R_GUARDA_ENTRADA = 2.5, -3.0, 6.0
D_NACE_CIVIL = 6.5            # D-041: distancia mínima del dron a la que nace un civil
# V15 · FASE B · predicción
KF_Q = 8.0                     # densidad del jerk del modelo de aceleración del Kalman ((m/s³)²·s): una persona cambia
                               # de aceleración rápido (frenazos, cortes)
NP_PF = 200                    # partículas por dron
A_PF, V_PF_MAX = 2.0, 4.0      # aceleración aleatoria (m/s²) y rapidez máxima (m/s) de cada hipótesis
W_VISTO = 0.05                 # peso que conserva una partícula que la cámara ve sin que YOLO detecte a nadie
N_PF_VISOR = 40                # partículas que se mandan al visor (muestra)
MASA_MURO = 0.25               # masa mínima detrás de un muro para elegirlo por probabilidad
MASA_DIRECTO = 0.6             # (fase D) con esta masa detrás de un muro conocido, la PÉRDIDA pasa directo al flanqueo
A_FRENO_DRON = 2.5             # m/s² con que el dron iguala la velocidad de un ladrón que se le acerca (jerk incluido)
T_LAG_DRON = 0.5               # s de retardo hasta empezar a apartarse
D_SEP_MAX = 7.0                # tope de la separación adaptativa
T_CENIT = 1.2                  # s: si va a entrar a la zona ciega antes de esto, gira hacia el punto de salida
# V15 · FASE C · identidad
DIM_APARIENCIA = 8             # vector de apariencia de cada persona (ropa, contextura): lo que compara el ReID
SIM_CIVIL = (0.2, 0.97)        # parecido (coseno) de un civil con el ladrón: a veces visten casi igual
P_CAMBIO = 0.3                 # probabilidad por cuadro de saltar a otra persona superpuesta, con parecido y movimiento iguales
V_DIF_ID = 2.0                 # m/s de diferencia de velocidad que hacen el cambio casi imposible (el Kalman los separa)
T_CRUCE = 3.0                  # s después de un cruce en que se vigila la identidad
UMBRAL_SIM = 0.85              # ReID (promediado): por debajo de esto, "no se parece a quien designó el operador"
UMBRAL_PARECIDO = 0.8          # cruzarse con alguien así de parecido obliga a reconfirmar
DUDA_KALMAN = True             # también duda si, tras un cruce, el Kalman rechaza mediciones
# V15 · FASE D · secuencia tras el muro
GIRO_LADO = 180.0              # ° del barrido detrás del muro (pasos 1 y 2), empezando hacia la zona oculta
A_CANTO = 6.0                  # m del punto de canto a la punta del muro (ve las dos caras a la vez)
# V15 · canto con desplazamiento lateral: de canto puro a 6 m al ladrón detrás de la punta le asoma poco (cálculo 2D: 24 %
# del cuerpo con muro de 4 m, 7 % con 6.5 m); corriéndose ~1 m a un lado se ve ~1/3. Secuencia de una sola pasada, con la
# nariz siempre a lo largo del muro: centrado -> DESPL_CANTO a un lado (primero el que diga la predicción) -> al otro.
DESPL_CANTO, VEL_CANTO, T_ALINEA_CANTO = 1.0, 1.0, 1.5      # m a cada lado, m/s de tope lateral, s centrado
T_LADO1_CANTO, T_LADO2_CANTO = 2.5, 3.0                     # s hacia el primer lado (1 m) y hacia el otro (2 m)
T_CANTO = T_ALINEA_CANTO + T_LADO1_CANTO + T_LADO2_CANTO
VEL_INVESTIGA = 4.0            # V15 · fase D: 3.0 -> 4.0 m/s (la guarda del mapa frena cerca de los muros)
T_INVESTIGA_MAX = 12.0
D_LLEGADA = 1.2
D_STANDOFF = 2.5               # separación táctica: no volar a la coordenada exacta ni a la esquina del panel
T_MIRA = 2.0                   # (sin uso en el flanqueo: al llegar detrás del muro rota de inmediato)
# flanqueo profundo: rodear la esquina y quedar detrás del plano del muro
R_ESQUINA = 1.3                # la ruta pasa a esta distancia de la esquina (radio del dron + margen)
MARGEN_ESQUINA = 0.5           # ningún tramo puede pasar a menos de RADIO_DRON + esto de un panel detectado
D_FLANCO = 1.8                 # el punto final queda esto detrás del plano del muro (en la zona que estaba oculta)
OFFSET_EXT = 0.5               # el LiDAR ve el panel un poco más corto: sus extremos se alargan esto
D_LLEGADA_PASO = 0.8           # al pasar a esta distancia de un punto intermedio, sigue con el siguiente
DIST_PROTECCION_VUELO = 1.0    # en el flanqueo el LiDAR solo frena el avance si hay algo a menos de esto
Z_FLANCO = Z_SEGURA            # (V15: altura segura) el flanqueo se vuela fuera del alcance del ladrón (2.6 m) y justo sobre los paneles (2.6 m):
                               # a 2.3 m, al rodear la esquina pasaba junto al escondite y lo tumbaban (42% en las pruebas)
# mapa de obstáculos con el LiDAR (rayo frontal): impactos guardados y su agrupación en paneles
N_LIDAR = 512                  # v9: 128 -> 512 puntos (mapa descubierto de toda la misión)
D_CLUSTER = 1.0
LARGO_MIN_PANEL = 1.0
K_DET = 4
# guarda del mapa: con el LiDAR solo al frente, en la persecución o la predicción el dron puede moverse hacia un panel
# que no está mirando. Los impactos guardados funcionan como un muro virtual: la velocidad de acercamiento a cada
# punto se limita a la que permite frenar antes de R_PARADA contando el tiempo que tarda en llegar a esa
# desaceleración por el limitador de jerk: v²/(2·A_GUARDA) + v·T_GUARDA <= d - R_PARADA
R_GUARDA = 6.0                 # solo cuentan los impactos a menos de esto (a 4.5 m/s hacen falta ~6 m para frenar)
T_GUARDA = 0.2                 # s de retardo base; se suma el de pasar de la aceleración actual hacia el punto a frenar
                               # con el limitador de jerk: (A_GUARDA + a_hacia) / (2·J_MAX_DRON)
R_PARADA = 0.75 + 0.1          # distancia (centro del dron al eje del panel) donde la velocidad de acercamiento llega a 0 (V15: + medio grosor del muro)
A_GUARDA = 2.4                 # desaceleración de diseño (60% de ACC_MAX_DRON, por el retardo del autopiloto)
R_INSP_HECHO = 2.0             # un panel cuyo centro está a menos de esto de uno ya revisado cuenta como revisado

# ----------------------------------------------------------------------------- V16 (docs/PLAN_V16_REALISMO.md)
# FASE A1 · ESCENARIO ÚNICO Y ALTURAS VARIABLES. La V16 entrena un solo caso: la misión completa con 2 paneles (decisión 4),
# fuera del currículo de 5 niveles de la V15 (que se conserva para comparar). Es el "nivel" NIVEL_V16 de cada partida.
NIVEL_V16 = 5
NOMBRE_V16 = "Misión V16 (2 paneles)"
MUROS_V16 = 2
LARGO_MURO_V16 = (4.0, 6.5)
C_MURO_V16 = 14.0                      # m: los centros de los muros quedan en [-C, C] x [-C, C]
P_CIVILES_V16 = (0.3, 0.4, 0.3)        # 0, 1 o 2 civiles
D_NACE_V16 = 9.0                       # los civiles nacen a más de R_GENTE del dron (el 360° de entrada es bajo)
# Decisión 3: alturas de 2.0 a 3.0 m SOLO sin personas conocidas a menos de R_GENTE (tránsito, 360° de entrada e
# inspección detrás de los muros). Con alguien cerca, la altura segura Z_SEGURA (3.30 m, D-043). "Conocida" = la ve ahora,
# la vio hace menos de T_PERSONA_MEM s o es el objetivo designado y su estimación (Kalman o nube) queda cerca.
ALTURAS_V16 = True                     # False: siempre a la altura segura (para comparar)
R_GENTE = 8.0
MASA_GENTE = 0.05                      # con más de esto de la nube del objetivo a menos de R_GENTE + 1.5 m, "está cerca"
V_ALCANCE_OBJ = 2.5                    # m/s: rapidez sostenida del ladrón (VC_LADRON) para acotar dónde puede estar
T_GENTE_MEM = 20.0                     # s que el dron recuerda a una persona vista para decidir la altura
Z_V16_ENTRADA = 2.0                    # 360° de entrada (mapea los muros con el LiDAR). A3: con el TF03 fijo al chasis (casi
                                       # horizontal) a 2.0 m mapea muros de 2.6 m hasta 25 m; a 2.5 m pierde los de más de ~6 m
Z_V16_TRANSITO = 3.0                   # vuelos entre puntos (por encima de los muros de 2.6 m)
Z_V16_INSPECCION = 2.0                 # mirar detrás de un muro (barridos de los pasos 1 y 2, muro de canto, inspección)
# transiciones suaves: la altura objetivo no salta, se mueve en rampa (la de subida de emergencia es la de ArduPilot)
V_RAMPA_BAJA, V_RAMPA_SUBE = 0.4, 0.8  # m/s
K_ALT_V16 = 1.5                        # 1/s: ganancia del lazo de altura sobre la rampa
# FASE A2 · POSTURAS HUMANAS EN LA FÍSICA (no solo en el dibujo): cambian el alto del cuerpo (oclusión tras el muro y lo
# que toca el LiDAR), el ancho de la caja de YOLO, la confianza de YOLO, la rapidez máxima y el alcance de la mano.
DE_PIE, AGACHADO, RECOSTADO, GATEANDO = 0, 1, 2, 3
NOMBRE_POSTURA = ["de pie", "agachado", "recostado", "gateando"]
F_ALTO_POSTURA = np.array([1.0, 0.67, 1.0, 0.35])     # alto / estatura: agachado ~1.15 m, gateando ~0.6 m
F_ANCHO_POSTURA = np.array([1.0, 1.35, 1.0, 1.8])     # ancho aparente: agachado más ancho; gateando el cuerpo va horizontal
P_YOLO_POSTURA = np.array([1.0, 0.85, 0.95, 0.6])     # confianza relativa de YOLO (agachado algo menos, gateando bastante)
V_MAX_POSTURA = np.array([9.0, 1.0, 0.0, 0.65])       # m/s: agachado <= 1, recostado quieto, gateando 0.5-0.8
F_HOMBRO_POSTURA = np.array([0.82, 0.55, 0.82, 0.30])  # altura del hombro / estatura
V_TRANSICION = 0.3                                     # m/s máximos mientras cambia de postura
# s de cada transición [desde, hacia]: pararse, agacharse, recostarse, tirarse al piso (0.5-1 s)
T_TRANS_POSTURA = np.array([[0.0, 0.5, 0.6, 0.9],
                            [0.6, 0.0, 0.6, 0.6],
                            [0.7, 0.6, 0.0, 0.9],
                            [1.0, 0.6, 0.9, 0.0]])
P_POSTURA_ESCONDIDO = (0.2, 0.45, 0.35)                # escondido: de pie, agachado, recostado contra la pared
D_RECOSTADO = 0.45                                     # m del eje del muro al centro del cuerpo recostado (espalda pegada)
L_GATEAR = 5                                           # ladrón: modo "se corre gateando detrás del mismo muro"
L_ESCUDO = 6                                           # V17 · L4: camina pegado al civil (escudo)
P_GATEAR = 0.25                                        # al acabar un escondite, probabilidad de correrse gateando
# SALTO PARA AGARRAR EL DRON: impulso (se agacha y empuja), vuelo balístico con el brazo extendido hacia el dron y
# aterrizaje con recuperación. La mano va del hombro hacia el dron con el largo del brazo (alcance de pie = hombro + brazo);
# "alcanzado" si la mano entra en el cilindro del dron (radio RADIO_DRON, desde H_DRON_ABAJO por debajo de su centro).
T_IMPULSO, T_ATERRIZA = 0.25, 0.6
D_SALTO_V16 = 1.6                                      # m horizontales al dron para saltar
V_SALTO_H = 2.0                                        # m/s horizontales máximos del vuelo hacia el dron
H_DRON_ABAJO = 0.15                                    # m del centro del dron a su parte de abajo (tren, cuerpo)
# CIVILES CON MÁQUINA DE ESTADOS (decisión 6): transitan; si notan el dron (< D_NOTA_CIVIL y a la vista) lo miran 5-20 s
# ("chismosean", algunos graban con el celular), lo esquivan, se alejan o salen de la zona. Nunca pasan por debajo.
C_TRANSITA, C_MIRA, C_ESQUIVA, C_ALEJA, C_SALE, C_GRABA = 0, 1, 2, 3, 4, 5
NOMBRE_CIVIL = ["transita", "mira el dron", "esquiva", "se aleja", "sale de la zona", "graba con el celular"]
D_NOTA_CIVIL = 15.0
P_NOTA_CIVIL = 0.3                                     # por paso, con el dron cerca y a la vista (~0.3 s en notarlo)
P_REACCION_CIVIL = (0.30, 0.30, 0.15, 0.10, 0.15)      # mira, esquiva, se aleja, sale, graba
T_MIRA_CIVIL = (5.0, 20.0)
T_ALEJA_CIVIL = (6.0, 12.0)
D_ESQUIVA_CIVIL = 5.0                                  # esquivando, no se acerca a menos de esto del dron
D_RESPETO_V16 = 4.5                                    # todos: empiezan a rodear el dron desde esta distancia (inercia)
# FASE A3 · SENSORES (decisiones 2 y 11, sección 6 del plan). Solo en las partidas V16 (las de la V15 quedan iguales).
# Cámara al piso: CSI IMX219 fija al chasis (no estabilizada: se inclina con él), recta hacia abajo. HFOV a lo ancho del
# dron (izquierda-derecha), VFOV a lo largo. Mismo ruido, pérdidas y retardo que la principal. Sirve para el punto ciego.
CAM_PISO_HFOV, CAM_PISO_VFOV, CAM_PISO_PITCH = 62.2, 48.8, -90.0
P_DET_PISO = 0.9               # YOLO con la persona vista desde arriba (cabeza y hombros), antes de postura y desenfoque
SIG_PISO = 0.15                # m: error de la posición en el piso medida por la cámara de abajo (crece con la distancia)
# LiDAR: TF03 FIJO AL CHASIS mirando al frente (0° a +2°, fuera del gimbal): frena y mapea; descarta los impactos en el
# suelo con la actitud de la Pixhawk (obstáculo solo si d < h / sin(cabeceo hacia abajo) - 0.4 m). TF-LUNA EN EL GIMBAL,
# coaxial con la cámara: mide la distancia a lo que la cámara centra, con un alcance de 2.5 a 8 m según el blanco y el sol.
TF03_PITCH = 1.0               # ° sobre el plano del chasis
LUNA_MAX = (3.0, 8.0)          # m: alcance del TF-Luna en la partida (oscuro a pleno sol ... blanco claro)
# Desenfoque por movimiento: con exposición T_EXP el objeto se corre en la imagen ω·T_EXP·px_por_grado píxeles; YOLO
# pierde confianza como 1 / (1 + (desenfoque / B_BLUR)²). Le da a la red un motivo físico para moverse suave.
T_EXP = 0.004                  # s (exterior de día)
B_BLUR = 12.0                  # px de desenfoque a los que la detección cae a la mitad
# Tipo de gimbal: "basecam" (hoy), "servo" (MG90D estabilizado por la Pixhawk) o "mixto" (cada partida uno, al azar)
GIMBAL_TIPO = "mixto"
# Ruido de navegación: deriva del GPS/EKF (amplitud por partida, proceso de Ornstein-Uhlenbeck) y error del barómetro.
# La memoria del dron (mapa, última posición, nube...) queda en el marco que él cree: al derivar, el mundo recordado se
# corre respecto al real. La geocerca de ArduPilot usa la posición estimada (por eso un margen mayor).
GPS_DERIVA = (0.5, 1.5)        # m
TAU_GPS = 30.0                 # s
BARO_ERROR = (0.3, 0.5)        # m
TAU_BARO = 20.0                # s
MARGEN_CERCA_V16 = MARGEN_CERCA + GPS_DERIVA[1]
RUIDO_NAV = True               # False: sin deriva del GPS ni error del barómetro (para comparar)
# V17.9 · FÍSICAS del vuelo, cada una apagable con --set (por defecto no cambian lo medido hasta hoy: ráfagas, arrastre,
# límite de inclinación de 30°, inercia angular, deriva del GPS/EKF y servos del pan-tilt ya estaban; lo demás es nuevo y apagado)
FISICA_RAFAGAS = True          # ráfagas de viento (Ornstein-Uhlenbeck) de intensidad aleatoria por partida
FISICA_VIENTO_MEDIO = 0.0      # m/s²: viento medio máximo por partida (módulo y dirección al azar); 0 = apagado
FISICA_ARRASTRE = 1.0          # factor sobre el arrastre lineal del dron (0 = sin arrastre)
FISICA_MOTOR_TAU = 0.0         # s: respuesta de primer orden de los motores (retardo e inercia); 0 = instantánea
FISICA_BAT_CAIDA = 0.0         # fracción de empuje perdido por minuto (voltaje de la LiPo): baja el límite de inclinación y la subida
RUIDO_GPS, RUIDO_BARO = True, True   # cada uno por separado (para comparar)
# Altímetro: "baro" (hoy: la Pixhawk con su barómetro) o "luna" (alternativa de la sección 6: un segundo TF-Luna mirando al
# piso como telémetro de altura; ArduPilot lo usa por debajo de su alcance, con un error de ~ERROR_LUNA_ALT)
ALTIMETRO = "baro"
ERROR_LUNA_ALT = 0.05          # m
# FASE A4 · RECOMPENSA Y ABORDAJE (solo en la V16). Custodia = la recompensa principal (R_VISTA + R_RANGO por paso con el
# objetivo a la vista, como la V15); la rendición es un BONO que nunca vale menos que seguir mirando: R_EXITO + lo que
# pagaría la custodia completa por el tiempo que falta. Cada término se puede apagar (0) para compararlo.
R_EXITO_RESTANTE_V16 = 0.5      # por segundo que falte = (R_VISTA + R_RANGO) / DT, lo que paga la custodia completa
K_JERK_V16 = 0.10              # SUAVIDAD: multa a la sacudida (segunda diferencia) de los canales que comanda la red
K_COB = 0.5                    # COBERTURAS (potencial): fracción del área a la que el ladrón llega en T_COB s que el dron ve
T_COB = 2.5                    # s
N_COB_ANG, F_COB_RADIO = 12, (0.4, 0.8)   # muestras del área alcanzable: 12 rumbos x 2 radios (fracciones del alcance)
K_ESC = 0.2                    # ABORDAJE (potencial): estar del lado contrario a su ruta de escape (hacia su cubierta)
R_SOBREVUELO = -0.05           # por paso, con el objetivo dentro de la zona ciega debajo del dron (nunca sobrevolarlo)
R_ANGULO_GMB = -0.02           # por paso, si centrarlo pediría bajar la cámara más de -45° (fuera del rango del gimbal)
ORBITA_V16 = False             # True: EVADIR_IZQ/DER sin amenaza y con el objetivo a la vista lo RODEAN (órbita lateral)
VEL_ORBITA = 1.5               # m/s
T_CLIC_FIRME = 1.0             # s que el tracker queda amarrado a la persona del clic del operador
N_OBS_V16 = 3                  # entradas nuevas de la red: cámara al piso (ve al objetivo, adelante, izquierda)

# ----------------------------------------------------------------------------- V17 (docs/PLAN_V17_REFUERZO.md)
# E6 · LA CANCHA (D-051): zona de IA de 30 x 30 m, dos conjuntos de paneles en V de 90° (alas de ANCHO_PANEL_V17, alto al
# azar en ALTO_PANEL_V17) con los vértices a SEP_V17 y las bocas hacia lados contrarios (V1 abierta hacia donde entra el
# dron, V2 al revés); cada conjunto con azar de ±AZAR_POS_V17 m y ±AZAR_ANG_V17°. 1 ladrón y 1 civil. Es el "nivel"
# NIVEL_V17; hereda toda la física, los sensores y la recompensa de la V16.
NIVEL_V17 = 6
NOMBRE_V17 = "Misión V17 (cancha, 2 V)"
ARENA_V17 = 15.0               # medio lado de la zona (geocerca)
ANCHO_PANEL_V17 = 1.5          # m de cada ala (D-066: medido por Brahian; hasta la V17.2 fue 1.0)
ALTO_PANEL_V17 = (2.3, 2.3)    # m (Brahian, 20-oct: 2.30 m; D-066 fue 2.2-2.3; hasta la V17.2, 1.9-2.2)
SEP_V17 = 10.0                 # m entre los vértices de las dos V
AZAR_POS_V17, AZAR_ANG_V17 = 2.0, 20.0
# V17.9 (correcciones de Brahian, 20-oct): paneles de 5 cm, apertura de cada V al azar, la disposición de las dos V gira
# al azar alrededor del centro en cada partida, y la altura fija en la cancha (sin SUBIR / BAJAR)
GROSOR_PANEL_V17 = 0.05        # m (hasta la V17.8: GROSOR_MURO, 0.2)
ANG_V_V17 = (120.0, 175.0)     # ° de apertura de cada V (Arquitecto, 20-oct; por omisión 160°; hasta la V17.8: 90° fijos)
GIRO_CANCHA_V17 = True         # hasta la V17.8: V1 al sur abierta al sur, V2 al norte abierta al norte
ALTURA_FIJA_V17 = True         # sin SUBIR / BAJAR: la altura la fija la regla (no la red)
# Control por el operador (Modo Enseñar del visor): manual o por punto. Va por el mismo autopiloto, los mismos topes y las mismas
# guardas (geocerca, personas, mapa); el árbitro y el reflejo de punto ciego siguen mandando; el tilt, dentro de -45..+15
V_MAN, A_OBJ_MAN, W_MAN, PAN_V_MAN, TILT_V_MAN = 3.0, 2.5, 60.0, 90.0, 30.0   # m/s, m/s², °/s, °/s, °/s
VZ_MAN = 1.5                   # m/s: subida y bajada con el mando manual (vz = 1); la regla de no bajar con alguien cerca sigue
T_MAN = 0.4                    # s: un mando manual vence si no se repite
D_LLEGO_MAN, YAW_LLEGO_MAN = 0.25, 3.0   # m y ° para dar por llegado un punto
R_DESPEJE_V17 = 3.0              # m: a esta distancia de un panel detectado (o punto de la nube) sube a Z_TRANSITO, antes de rozarlo
Z_BASE_V17 = 2.0               # m (Brahian, 20-oct); se prueba 1.7 y 2.6 con --set. Sube a Z_SEGURA solo con una persona cerca
R_SUBE_V17, R_BAJA_V17 = 4.0, 5.5   # m: sube a la altura segura con una persona a <= R_SUBE; vuelve a Z_BASE a > R_BAJA
# E5 · LA PARTIDA EMPIEZA EN LA ACTIVACIÓN (D-053): el piloto ya trajo el dron hasta el borde sur de la zona (donde se
# activa la IA con CH7), mirando hacia las V
Y_ACTIVA_V17 = -12.5
# E2 · BOTONES DE LA RED CON EL OBJETIVO FIJADO (D-049): cada uno cambia algo. La guiñada, el gimbal, la evasión (E3: la
# elige el árbitro), la geocerca, las alturas mínimas y la búsqueda siguen siendo reglas.
QUEDARSE, RODEAR_IZQ, RODEAR_DER, ACERCARSE, ALEJARSE, SUBIR, BAJAR = range(7)
CLASES_V17 = ["QUEDARSE", "RODEAR_IZQ", "RODEAR_DER", "ACERCARSE", "ALEJARSE", "SUBIR", "BAJAR"]
# V17.8: con PAN_RED_V17 la red tiene 3 botones más para apuntar el pan-tilt (variante H) mientras la búsqueda determinista
# vuela: corren ±PASO_PAN_RED° lo que pide la regla, o vuelven al centro. Con el ladrón a la vista, la regla lo centra
PAN_IZQ, PAN_DER, PAN_CENTRO = 7, 8, 9
CLASES_V17_PAN = CLASES_V17 + ["PAN_IZQ", "PAN_DER", "PAN_CENTRO"]
PAN_RED_V17 = False
BUSQUEDA_PAN = (PREDECIR, INVESTIGAR, ASOMO, SIGUIENTE_OBSTACULO, VENTAJA_ALTURA, MURO_CANTO)
PASO_PAN_RED = 20.0              # ° por toque
K_VAIVEN_V17 = 0.0               # V17.8: multa por cada cambio de sentido de la altura que pide la red (SUBIR tras BAJAR)


def clases_v17():
    """Los botones de la red en la cancha: 7, o 10 con PAN_RED_V17."""
    return CLASES_V17_PAN if PAN_RED_V17 else CLASES_V17
D_ACERCA_V17, D_ALEJA_V17 = 3.5, 6.0     # m (horizontal) a los que llevan ACERCARSE y ALEJARSE
VEL_RADIAL_V17 = 1.5           # m/s máximos de ACERCARSE / ALEJARSE
PASO_Z_V17, Z_MAX_V17 = 0.5, Z_TACTICO   # SUBIR / BAJAR cambian la altura pedida 0.5 m, entre Z_SEGURA y 5.5 m
# Reglas del ladrón y del civil (plan 5.1), cada una se apaga con --set NOMBRE=0 para medir con y sin ella
POSTURAS_V17 = True            # L1: agachado, gateo, recostado contra el panel (V16 A2)
SALTO_V17 = True               # L2: salto con el brazo para agarrar el dron (V16 A2)
RULETA_V17 = True              # L3: si el dron ve la boca de su V, corre a la otra V
ESCUDO_V17 = True              # L4: camina pegado al civil T_ESCUDO_V17 s para confundir el seguimiento
CURIOSO_V17 = True             # C1: el civil reacciona al dron (mira, esquiva, se va, graba) (V16 A2)
T_ESCUDO_V17 = (2.0, 5.0)
# E7 · ALTURAS CON PANELES DE 2 m (sin nadie conocido a menos de R_GENTE; si no, Z_SEGURA). Con los paneles de 1.9-2.2 m
# el TF03 (fijo al chasis, +1°) solo los toca volando por debajo de su borde; mirar detrás de ellos o volar entre puntos
# se hace mejor desde la altura segura (desde 3.30 m se ve por encima). NaN = sin altura baja en esa fase.
ENTRADA_COMPLETA_V17 = True
Z_V17_ENTRADA = 1.8                    # E7 medido: mapea 25 % de las V al terminar la vuelta (2.0 m: 13 %); informes/v17/e7_*.json
Z_V17_INSPECCION = 2.0
Z_V17_TRANSITO = 3.0
# Recompensa (plan 5.2): R1 K_COB, R2 K_ESC, R5 K_JERK_V16 y R6 R_SOBREVUELO / R_ANGULO_GMB son los de la V16; R3 (bono de
# entropía) está en entrenar_master.py (--ent); R4: el bono y la multa de re-adquisición de la V17 (en la V15/V16, ±8)
R_READQ_V17 = 2.0
# V17.1 · D-059 (opción A): M1 = racha de RACHA_M1_V17 s seguidos con el ladrón a la vista y el ID correcto (el contador de
# la V15). La recompensa se alinea con M1: un bono al completar la racha (una vez por racha) y un potencial por la racha en
# curso (Ng: gamma·phi' - phi, no cambia lo óptimo; al perder la racha el potencial cae y eso es la multa)
RACHA_M1_V17 = 30.0
R_RACHA_V17 = 10.0
# V17.1: R6 apagada en la cancha. Medido con los botones fijos (informes/v17/v171_rec_*.json, 256 partidas): con las
# multas de sobrevuelo y de ángulo, "siempre SUBIR" (M1 61.7 %) cobraba MENOS que "siempre QUEDARSE" (55.1 %): la red
# aprendía a quedarse. El punto ciego y el ángulo los cuidan reglas (reflejo de punto ciego, barrera de -45°).
R_SOBREVUELO_V17, R_ANGULO_GMB_V17 = 0.0, 0.0
B4_SUBE, B4_BAJA = 0.05, 0.02  # D-067 · B4: umbrales de cobertura para subir a 5.5 m o volver a 3.30 m
K_SUAVE_V17 = 0.1              # V17.2: peso de la multa de suavidad (delta y sacudida) en la cancha
K_SUAVE_Z_V17 = 0.1            # peso en el eje vertical. La V17.3 lo subió a 0.5 por el vaivén y colapsó a QUEDARSE (D-068)
# D-069 (D-059 C, experimento REVERSIBLE): con True, en la cancha la red también decide durante la PÉRDIDA (PREDECIR, los
# ~1-4 s tras perder al ladrón) con sus 7 botones; QUEDARSE ahí = seguir la regla (ir tras la predicción). Después sigue
# la búsqueda determinista de siempre. Es un interruptor aparte de PERDIDA_IA (regla dura 3, que queda en False): aquel
# entrega 60 s de búsqueda a la red con los botones viejos de la V15 y sin búsqueda determinista
PERDIDA_RED_V17 = False
# D-071 · RUTA DE BÚSQUEDA DE BRAHIAN (B5, docs/RUTA_BUSQUEDA_BRAHIAN.md), búsqueda DETERMINISTA alternativa (regla 3 intacta):
# al perderlo, a la V donde se lo vio por última vez: su parte de atrás (la que el dron no ve) de esquina a esquina a
# D_RUTA_B5 m y a la altura segura, después de frente a la boca con vaivén de ±AMP_BARRIDO_B5° durante T_BARRIDO_B5 s, y a la
# otra V; se repite hasta encontrarlo. Valores de partida (no medidos)
BUSQUEDA_RUTA_V17 = False
D_RUTA_B5, MARGEN_RUTA_B5 = 3.0, 2.0          # D_RUTA_B5 ajustado (3.0 / 4.5 / 6.0 m, semilla 7): informes/v17/ruta_ajuste_d*.json
T_BARRIDO_B5, AMP_BARRIDO_B5 = 3.0, 30.0
PASO_RUTA_B5 = 4                 # valor de paso_muro mientras dura la ruta
T_RUTA_B5_MAX = 30.0             # s máximos para recorrer la ruta de una V
# B5' (Brahian, 20-oct): la V más cercana a donde se lo vio, detrás de ella primero por la esquina hacia donde se fue (la
# nube de partículas), luego la otra esquina (por si la rodea) y de ahí a la otra V, sin pararse de frente a la boca
RUTA_V2_B5 = True
K_RACHA_V17 = 3.0
# D-064: en la V17 el TF03 va inclinado -3° (mapea las V de 2 m; medido en E7: 25 % -> 52 % de las V)
TF03_PITCH_V17 = -3.0
# D-063 · altura segura con el error del barómetro: en la V17, lo que se le PIDE a la Pixhawk con alguien cerca es
# Z_SEGURA + MARGEN_BARO_V17 (la otra opción medida es el altímetro por LiDAR al piso: ALTIMETRO = "luna")
MARGEN_BARO_V17 = 0.5                  # D-063 medido (informes/v17/d063_*.json): real bajo 3.30 m con alguien a < 8 m 13.6 % -> 0.5 %
# E7 · búsqueda tras el panel: con V cortas, el "muro de canto" (D-044) se mira desde A_CANTO_V17 m de la punta; con
# CANTO_V17 = False se salta ese paso
CANTO_V17 = True
A_CANTO_V17 = A_CANTO
TASA_ESCUDO_V17 = 0.05         # por segundo, con el civil a menos de D_ESCUDO_V17 y el dron mirándolo
D_ESCUDO_V17 = 8.0

# ----------------------------------------------------------------------------- personas
N_PERS = 4                     # 0 = ladrón, 1-2 = peatones de la zona, 3 = transeúnte de la ruta (misión)
VEL_CAMINAR, VEL_CORRER = 1.4, 3.3
# cinemática humana: aceleración y frenado limitados; giros con aceleración lateral limitada; un giro de más de
# 45° obliga a frenar hasta V_GIRO_PERSONA (como una persona real que cambia de dirección)
A_ACEL_PERSONA, A_FRENO_PERSONA, A_LAT_PERSONA = 2.5, 5.0, 5.0
OMEGA_PERSONA = 8.0            # rad/s de giro máximo casi detenido
V_GIRO_PERSONA = 1.5
# MODELO BIOMECÁNICO (versión master): (1) círculo de fricción: la aceleración horizontal total del pie contra el piso
# no supera MU_PISO·g, así que el giro (a_lat = v·ω) y la aceleración longitudinal se reparten ese presupuesto; el
# radio de giro mínimo es r = v² / (MU_PISO·g): a toda carrera no puede girar 90° en el sitio, tiene que frenar.
# (2) propulsión tipo Hill/Furusawa: arranca con A_PROPULSION y la fuerza cae con la velocidad (v(t) = V_TOPE·(1-e^-t/τ)):
# nadie pasa de 0 a 3 m/s en una décima. (3) para cambiar mucho de rumbo baja la velocidad de forma continua.
MU_PISO = 0.6
A_PROPULSION = 4.0
V_TOPE_HUMANO = 5.0
# PATHFINDING: grafo de visibilidad con las esquinas de cada muro alargadas E_NODO (ruta más corta exacta entre muros)
E_NODO = 0.9
STAMINA_MAX = 2.0
ALCANCE_H = 1.0
ALCANCE_Z = 2.6
FRAC_LADRON_RL = 0.3           # partidas de entrenamiento con el ladrón aprendido (autojuego)
L_DEAMBULAR, L_CUBRIRSE, L_ESCONDIDO, L_ASOMARSE, L_ATACAR = 0, 1, 2, 3, 4
T_ESCONDIDO = (2.0, 6.0)
T_ASOMARSE = (1.5, 3.0)
T_ATAQUE = 3.0
# v9: NAVEGACIÓN POR CAMPOS POTENCIALES (APF) de las personas: sienten cada muro a menos de R_APF con un peso
# w = (1/d - 1/R_APF) / (1/D_MIN_APF - 1/R_APF) (0 lejos, 1 pegadas); la parte del movimiento hacia el muro se frena
# y se convierte en flujo tangencial (K_TAN_APF) hacia donde ya iban o hacia el extremo más cercano
R_APF = 2.0
D_MIN_APF = 0.45
K_TAN_APF = 1.0

# ----------------------------------------------------------------------------- escenario
N_PANELES = 4                  # V15: hasta 4 muros (nivel 4); en los demás niveles los que sobran se superponen
ALTO_PANEL = 2.6
RADIO_DRON = 0.4
ARENA = 25.0
PASOS_EPISODIO = int(300.0 / DT)   # V15: tope de 5 minutos; sin rendición, pierde el dron

# ----------------------------------------------------------------------------- recompensas
R_COLISION = -10.0
R_CHOQUE_PANEL = -5.0
R_GEOCERCA = -5.0
R_PERDIDO = -5.0               # misión fallida: protocolo agotado (o nunca se fijó al sospechoso)
R_PIERDE = -8.0                # el tracker suelta el ID (igual y opuesto a R_DESCUBRE: perderlo a propósito para
                               # cobrar el bono no rinde)
R_DESCUBRE = 8.0               # V12: DISCOVERY BONUS masivo (3 -> 8, más que el éxito): el ladrón vuelve a entrar en el FOV
                               # después de haber estado oculto más de T_OCULTO_DESC; una vez por ocultamiento.
T_OCULTO_DESC = 1.0
R_EXITO = 5.0                  # misión cumplida (base)
R_EXITO_RESTANTE = 0.25        # C2: + esto por cada segundo que falte para el tope: rendirlo antes nunca vale menos que
                               # seguir mirando (0.25/s ≈ lo que cobra mirando con ~50 % de vista)
R_TOPE = -5.0                  # C2: el tope de 5 min sin rendición es TERMINAL (pierde el dron) y cuesta esto
R_MANIOBRA = {1: -0.15, 2: -0.15, 3: -0.30}
R_VISTA = 0.03                 # por cada paso con el objetivo fijado a la vista
R_RANGO = 0.02                 # además, si está en la distancia óptima (3.5 a 5 m)
R_MUY_CERCA = -0.02            # y castigo si está a menos de 3 m (se sale del encuadre o lo sobrevuela)
# SUAVIDAD DEL CONTROL (reward shaping): la política aprende sola a no volar de forma errática, en vez de depender solo
# de filtros fijos. Cuenta únicamente con la IA al mando (FIJADO y sin maniobra). Los tres comandos que salen de la
# Jetson, normalizados a su máximo: cabeceo del chasis (la actitud que el autopiloto debe tomar para la velocidad
# pedida), guiñada del dron y velocidad del pitch del gimbal.
# v9: multa severa (x15 y x10 respecto de v8, 0.01 y 0.003): con el bono de re-adquisición de +3 la política v8
# prefería pagar la multa y moverse a saltos (jitter 0.042/s, esfuerzo 0.014/s con la IA al mando)
K_DELTA = 0.15                 # derivada: K·Σ|u(t) - u(t-1)| (un salto de extremo a extremo en un eje = 2 -> -0.30)
K_ESFUERZO = 0.03              # esfuerzo: K·Σ|u(t)|, continuo (con el ladrón centrado y vuelo estable vale 0)
CAB_MAX = float(np.degrees(np.arctan(ACC_MAX_DRON / G)))     # 22.2°: el cabeceo a la aceleración máxima
# Guía (reward shaping basado en potencial, Ng et al. 1999), solo en FIJADO: premia apuntar la nariz al
# objetivo y no alejarse de él. Usa su posición real SOLO para calificar; no es una entrada del dron.
GAMMA_GUIA = 0.99
K_GUIA_ANG, K_GUIA_DIST = 0.3, 0.03
# V12 · recompensa por componente (info["r_comp"], columnas en este orden; su suma es la recompensa del dron)
R_COMP = ["vista", "guia", "descubre", "pierde", "maniobra", "exito", "fallas", "control", "cobertura", "abordaje"]
EJES_U = ["cabeceo", "guinada", "gimbal"]

# en BUSQUEDA_IA las acciones son consignas que persisten: AVANZAR / EVADIR_IZQ / EVADIR_DER / MANTENER fijan la
# velocidad horizontal (adelante, lateral, hover), DETENER_ASCENDER y DESCENDER mueven la altura objetivo, GIRAR_* giran
# mientras se eligen y GIMBAL_* mueven el pitch de la cámara. Con el objetivo fijado, 7-9 no tienen efecto.
CLASES = ["MANTENER", "EVADIR_IZQ", "EVADIR_DER", "DETENER_ASCENDER", "GIRAR_IZQ", "GIRAR_DER", "AVANZAR",
          "DESCENDER", "GIMBAL_ARRIBA", "GIMBAL_ABAJO"]
OFFSETS_PERSONA = np.radians([0, 30, -30, 60, -60, 90, -90, 180])
N_ACC_PERSONA = len(OFFSETS_PERSONA) * 2 + 1
GUIONES = ["cruce", "directo", "quieto", "alejarse", "acercar_y_parar", "trotar_directo", "deambular", "distractor",
           "civil_v16"]
P_GUION = [0.15, 0.10, 0.10, 0.05, 0.05, 0.05, 0.50, 0.0, 0.0]
G_DISTRACTOR = 7               # V14 (nivel 2): civil que cruza una y otra vez la línea de vista dron-ladrón
G_CIVIL = 8                    # V16: civil realista (atraviesa la zona; al notar el dron lo mira, lo esquiva o se va)
VEL_CIVIL_V16 = (1.1, 1.5)     # m/s: caminan tranquilos

OBS_DRON = 21 + 7 + N_SECT + 2 + 10 + GRID_N * GRID_N + N_OBS_V16
# + memoria espacial (perdido, última posición x/y, tiempo sin verlo, gimbal, su último vector de movimiento x/y)
# + sectores del LiDAR + v9: dónde estaría ahora el ladrón si siguió igual (x/y), estado propio del dron (velocidad,
# aceleración, vertical, guiñada, consignas de la búsqueda) y la grilla del mapa descubierto
OBS_PERSONA = 22

VIGILANDO, EVADIENDO, ENFRIANDO = 0, 1, 2


def envolver(a):
    return (a + np.pi) % (2 * np.pi) - np.pi


def cruce_segmentos(p, q, a, b):
    """p,q: (..., 2) segmento de vista; a,b: (..., 2) panel. Devuelve (corta, t en [0,1] sobre p->q)."""
    r = q - p
    s = b - a
    den = r[..., 0] * s[..., 1] - r[..., 1] * s[..., 0]
    den_s = np.where(np.abs(den) < 1e-9, 1e-9, den)
    qp = a - p
    t = (qp[..., 0] * s[..., 1] - qp[..., 1] * s[..., 0]) / den_s
    u = (qp[..., 0] * r[..., 1] - qp[..., 1] * r[..., 0]) / den_s
    corta = (np.abs(den) > 1e-9) & (t > 0) & (t < 1) & (u >= 0) & (u <= 1)
    return corta, t


def stand_off_fov():
    """(a, b): distancia por fuera de la esquina y por detrás del plano del muro del punto de flanqueo V13."""
    b = D_ZONA_OCULTA / 2.0
    return b / np.tan(np.radians(HFOV / 2.0 - MARGEN_FOV)), b


# D-072 · HARDWARE ACTUAL (20-oct): ya no hay gimbal. Cámara CSI IMX219 fija al chasis, inclinada CAM_FIJA_PITCH; TF03
# paralelo en la misma base; sin TF-Luna (irá en el pan-tilt de después, D-056); cámara al piso planeada (CAM_PISO_ACTIVA).
# aplicar_hw("ACTUAL") cambia las constantes del módulo ANTES de crear el entorno; aplicar_hw("BASE") vuelve atrás.
CAM_FIJA_PITCH = -2.4              # medido por Brahian (20-oct, D-078); el TF03 va a -6.7°
ANG_CIEGO = 45.0                 # ° bajo el horizonte del borde inferior de la cámara (gimbal en su tope); ACTUAL: 5
LUNA_ACTIVA = True
CAM_PISO_ACTIVA = True
# D-075 · VARIANTE H, la del PLUS (05_HARDWARE_Y_VARIANTES/config_sim/variante_H.json): pan-tilt de 2 servos (pan = giro,
# tilt = cabeceo, sin alabeo) con la CSI#1 y el TF-Luna; TF03 fijo al chasis a -5°; CSI#2 fija al piso. El pan lo mueve una
# regla: con alguien en foco lo centra (la nariz del dron lo sigue más despacio); buscando, apunta al punto que se revisa
PAN_ACTIVO = False
PAN_MAX = 90.0                   # ° (PROVISIONAL: Hardware confirma el recorrido del servo en banco)
PAN_VEL, PAN_BANDA = 600.0, 1.0  # °/s y zona muerta del servo
# Robustez (pedido del Coordinador, 20-oct): perillas para estresar la cancha. Por defecto no cambian nada
N_CIVILES_V17 = 1                # civiles en la cancha (D-051: 1)
FACTOR_SERVO_H = 1.0             # >1: servos del pan-tilt más lentos (velocidad / f), con más retardo (x f) y ruido de pan
RECALL_YOLO = 1.0                # factor sobre la probabilidad de detección de YOLO (0.7 = pierde 30 % de las detecciones)
_HW_BASE = {}


def aplicar_hw(nombre):
    """Configura el hardware simulado: "BASE" (gimbal BaseCam o servo, como la V16) o "ACTUAL" (D-072, cámara fija)."""
    g = globals()
    claves = ("HFOV", "VFOV", "BANDA_MUERTA", "BANDA_RECENTRA", "GIMBAL_BANDA", "GIMBAL_RECENTRA", "GIMBAL_TIPO",
              "TF03_PITCH_V17", "ANG_CIEGO", "LUNA_ACTIVA", "CAM_PISO_ACTIVA", "PAN_ACTIVO")
    if not _HW_BASE:
        _HW_BASE.update({k: g[k] for k in claves})
    g.update(_HW_BASE)
    if nombre == "H":                      # D-075: el plus (pan-tilt de servos, CSI medida 68.3° x 54.0°, TF-Luna, CSI al piso)
        g.update(HFOV=68.3, VFOV=54.0, GIMBAL_TIPO="servo", TF03_PITCH_V17=-6.7, ANG_CIEGO=45.0, LUNA_ACTIVA=True,
                 CAM_PISO_ACTIVA=True, PAN_ACTIVO=True)
        g.update(BANDA_MUERTA=0.10 * g["HFOV"], BANDA_RECENTRA=0.04 * g["HFOV"], GIMBAL_BANDA=0.10 * g["VFOV"],
                 GIMBAL_RECENTRA=0.04 * g["VFOV"])
    elif nombre in ("ACTUAL", "G"):        # D-072: G, el dron del MÍNIMO (cámara fija)
        g.update(HFOV=68.3, VFOV=54.0, GIMBAL_TIPO="fijo", TF03_PITCH_V17=-6.7, ANG_CIEGO=-CAM_FIJA_PITCH,
                 LUNA_ACTIVA=False, CAM_PISO_ACTIVA=False)
        g.update(BANDA_MUERTA=0.10 * g["HFOV"], BANDA_RECENTRA=0.04 * g["HFOV"], GIMBAL_BANDA=0.10 * g["VFOV"],
                 GIMBAL_RECENTRA=0.04 * g["VFOV"])
    elif nombre != "BASE":
        raise ValueError("hardware desconocido: %s" % nombre)


def d_punto_ciego(h):
    """Radio horizontal de la zona ciega debajo del dron a la altura h (borde inferior de la cámara a ANG_CIEGO° bajo el
    horizonte: gimbal en su tope de -45°, o la cámara fija de D-072) más el margen."""
    return h / np.tan(np.radians(ANG_CIEGO + VFOV / 2.0)) + MARGEN_CIEGO


def dist_nube_segmento(P, a, b):
    """RAYCASTING sobre la nube de puntos: distancia mínima de los puntos P (m, 2) del LiDAR al tramo a->b."""
    if len(P) == 0:
        return np.inf
    return float(dist_punto_segmento(P, a[None], b[None])[0].min())


def dist_punto_segmento(p, a, b):
    """p: (..., 2); a,b: (..., 2). Devuelve (distancia, punto más cercano)."""
    ab = b - a
    t = np.clip(np.sum((p - a) * ab, -1) / np.maximum(np.sum(ab * ab, -1), 1e-9), 0, 1)
    c = a + t[..., None] * ab
    return np.hypot(p[..., 0] - c[..., 0], p[..., 1] - c[..., 1]), c


def resultado_de(info, i):
    """Código del final de la partida i."""
    for clave, nombre in (("choque_ladron", "alcanzado"), ("choque_peaton", "choque_peaton"), ("panel", "panel"),
                          ("fuera", "geocerca"), ("perdido", "perdido"), ("no_encontrado", "no_encontrado"),
                          ("exito", "cumplida")):
        if info[clave][i]:
            return nombre
    return "tiempo"


class EntornoDronPersona(object):

    # V14: nivel del currículo con que nacen los entornos nuevos (el entrenamiento lo actualiza para que las repeticiones
    # se graben en el nivel actual) y fracción de repaso de niveles anteriores (solo la usa el entorno de entrenamiento)
    nivel_inicial = NIVEL_V16           # V16: la partida única (misión completa con 2 paneles)
    p_repaso_inicial = 0.0

    @property
    def A(self):
        """Medio lado de la arena (geocerca): 15 m en la cancha V17 (D-051), 25 m en las demás. Un entorno corre un solo
        nivel a la vez (la V16 y la V17 no tienen repaso), así que es uno para todas sus partidas."""
        return ARENA_V17 if getattr(self, "current_level", 0) == NIVEL_V17 else ARENA

    def __init__(self, n, semilla=0, nivel=None):
        self.n = n
        self.rng = np.random.default_rng(semilla)
        z = lambda *s: np.zeros((n,) + s)
        zi = lambda *s: np.zeros((n,) + s, int)
        zb = lambda *s: np.zeros((n,) + s, bool)
        # dron
        self.dx, self.dy, self.dz, self.dvx, self.dvy, self.dvz, self.psi = z(), z(), z(), z(), z(), z(), z()
        self.yaw_dps = z()
        self.estado, self.t_estado, self.clase = zi(), z(), zi()
        self.ev_cand, self.ev_cand_n = zi(), zi()        # maniobra candidata y cuadros seguidos pidiéndola
        self.giro_mem, self.giro_t = z(), z()            # giro de la IA en curso (°/s) y desde cuándo
        self.amenaza, self.perimetro = zb(), zb()
        self.yaw_corrige = zb()                          # banda muerta del yaw con histéresis
        self.gimbal = np.full(n, -10.0)                  # pitch del gimbal (°, negativo = hacia abajo): ángulo físico
        self.gimbal_cmd = np.full(n, -10.0)              # lo que pide la lógica o la IA (antes del filtro EMA)
        self.gmb_corrige, self.gmb_sat_arriba = zb(), zb()
        # máquina de estados de la misión
        self.modo, self.t_modo, self.t_fase2, self.t_fijado = zi(), z(), z(), z()
        self.busca_dir, self.giro_acum = np.ones(n), z()
        self.bfase, self.panel_obj = zi(), zi()          # búsqueda activa tras los paneles
        self.wp_x, self.wp_y, self.t_vuelo, self.t_bloqueo = z(), z(), z(), z()
        self.mira_x, self.mira_y, self.obj_mx, self.obj_my = z(), z(), z(), z()   # a dónde mirar y panel en revisión
        self.insp_x, self.insp_y, self.insp_n = z(8), z(8), zi()                  # centros de paneles ya revisados
        self.inv_x, self.inv_y, self.zc_x, self.zc_y = z(), z(), z(), z()         # punto de separación y zona de pérdida
        self.nadir = zb()
        self.ruta, self.ruta_n, self.ruta_i = z(4, 2), zi(), zi()          # ruta del flanqueo (hasta 3 puntos; B5: 4)
        self.b5_v, self.b5_vx, self.b5_vy = zi(), z(), z()   # D-071: V que recorre la ruta B5 y su vértice
        self.rx, self.ry, self.int_dx, self.int_dy = z(), z(), z(), z()     # punto actual y dirección al interior oculto
        self.vuelo_alto, self.flanco = zb(), zb()
        self.tvx, self.tvy, self.esc_vx, self.esc_vy = z(), z(), z(), z()       # velocidad estimada del objetivo y de escape
        self.pred_x0, self.pred_y0, self.pred_vx, self.pred_vy = z(), z(), z(), z()
        self.aso_gira = zb()
        self.lat_esq, self.reflejo, self.guarda = z(), zb(), zb()
        self.u_prev, self.mando_prev = z(3), zb()
        self.u_prev2 = z(3)                              # V16 · A4: comandos de hace dos pasos (sacudida)
        self.phi_cob, self.phi_esc = z(), z()            # V16 · A4: potenciales de coberturas y de abordaje
        self.cob_frac = z()                              # V16 · A4: fracción del área alcanzable que el dron ve
        self.l_cub = z(2)                                # cubierta más cercana del ladrón (su ruta de escape)
        self.acc_x, self.acc_y = z(), z()                # aceleración horizontal real (limitada en jerk)
        self.salto_t, self.salto_cd, self.salto_alc, self.salto_h = z(), z(), z(), z()   # salto del ladrón
        self.v_ia_f, self.v_ia_l, self.z_ia, self.g_ia = z(), z(), z(), z()     # consignas de la búsqueda por IA
        self.arm_desc, self.descubre = zb(), zb()                               # bono de re-adquisición armado / cobrado
        # V12: tiempo oculto (discovery), tiempo desde la pérdida (90 s), duración de la PÉRDIDA, reflejo de punto ciego,
        # mínimo del gimbal en la partida y comandos completos del paso anterior (jitter físico por eje)
        self.t_oculto, self.t_perdida, self.t_pred_dur = z(), z(), np.full(n, T_PREDICCION)
        self.ciego, self.d_ciego, self.gmb_min_ep, self.u_prev_fis = zb(), z(), np.full(n, -10.0), z(3)
        self.un_muro = zb()                              # V13: partida del currículo "Un Solo Muro"
        # V14 · currículo: nivel del entrenamiento, nivel de cada partida, repaso y guiones del ladrón y del civil
        self.current_level = int(EntornoDronPersona.nivel_inicial if nivel is None else nivel)
        self.p_repaso = float(EntornoDronPersona.p_repaso_inicial)
        self.p_cenit = P_CENIT_N0
        self.lvl_ep = np.full(n, self.current_level)
        self.l_guion, self.l_ang, self.l_tg = zi(), z(), z()
        # V15 · fase A: cuerpo de cada persona, cansancio del ladrón, 360° de entrada y rumbo del rayo anterior
        self.estatura = np.full((n, N_PERS), ESTATURA_MEDIA)
        self.alc_pie = np.full(n, K_ALCANCE_PIE * ESTATURA_MEDIA)
        self.reserva, self.pulso = np.ones(n), np.full(n, PULSO_REPOSO)
        self.v_corr_ef = np.full(n, VEL_CORRER)
        self.entrada, self.entrada_alta = zb(), zb()
        self.lid_psi_prev = z()
        # V15 · fase B: Kalman (por eje: posición, velocidad, aceleración) y filtro de partículas
        self.kf_x, self.kf_P, self.kf_ok = np.zeros((n, 2, 3)), np.tile(np.eye(3), (n, 2, 1, 1)), zb()
        self.pf_x, self.pf_y, self.pf_vx, self.pf_vy = z(NP_PF), z(NP_PF), z(NP_PF), z(NP_PF)
        self.pf_w, self.pf_on = np.full((n, NP_PF), 1.0 / NP_PF), zb()
        self.kf_fuera = zi()                           # mediciones seguidas rechazadas por la compuerta del Kalman
        # V15 · fase C: persona seguida por el tracker (0 = el ladrón de verdad), apariencias, ReID y cruces
        self.trk = zi()
        self.apariencia = np.zeros((n, N_PERS, DIM_APARIENCIA))
        self.apariencia[..., 0] = 1.0
        self.sim_med, self.t_cruce, self.sim_cruce = np.ones(n), np.full(n, 99.0), z()
        self.cruce_x, self.cruce_y = z(), z()
        self.mal, self.mal_det = zb(), zb()
        self.duda_pend = zb()                          # cruce que no se pudo verificar: reconfirmar al volver a fijarlo
        self.t_mal = z()                               # s persiguiendo a la persona equivocada sin dudar (métrica)
        # V15 · fase D: muro de la secuencia, paso (0 ninguno, 1 lado proyectado, 2 otro extremo, 3 de canto) y canto
        self.muro_a, self.muro_b, self.paso_muro = z(2), z(2), zi()
        self.canto_t, self.canto_psi0, self.canto_gmb = np.full(n, -1.0), z(), z()
        self.canto_lado = np.ones(n)                 # V15: primer lado del desplazamiento (+1 izquierda del muro, -1 derecha)
        # V15 · fase E: contador continuo de seguimiento y rendición
        self.t_cont, self.rendido = z(), zb()
        # C1 y C3: tiempo desde la última vez a la vista, mejor racha del contador, vista acumulada, tiempo por estado de
        # búsqueda y en qué estado se re-adquirió
        self.t_desde_vista, self.racha_max, self.t_vista_ac = z(), z(), z()
        self.t_readq_sum, self.n_readq = z(), z()
        self.n_perd, self.n_readq10 = z(), z()           # V17 · M2: pérdidas > 1 s y re-adquisiciones en <= 10 s
        self.t_busq_est = np.zeros((n, len(NOMBRE_ESTADO)))
        self.readq_est = np.zeros((n, len(NOMBRE_ESTADO)))
        self.ult_busq = np.full(n, PREDECIR)
        self.moral = np.ones(n)
        self.pm_x, self.pm_y, self.pm_t = z(N_PERS), z(N_PERS), np.full((n, N_PERS), 99.0)   # última vez que vio a cada uno
        self.ev_cambio, self.ev_nodet = zb(), zb()
        self.pf_mx, self.pf_my = z(), z()
        self.anticenit, self.d_sep = zb(), z()
        self.g_lado = np.ones((n, N_PERS))
        self.g_pausa = np.zeros((n, N_PERS))                # D-041: descanso del civil distractor entre cruces
        self.conocido = np.zeros((n, N_PERS), bool)         # D-041: civiles que el operador ya distinguió del ladrón
        self.cruce_con = np.zeros((n, N_PERS), bool)        # con quién fue el último cruce
        self.c_est, self.c_t = zi(N_PERS), z(N_PERS)     # V16: estado del civil y su temporizador
        self.c_noto = zb(N_PERS)                         # V16: ya reaccionó al dron en este cruce
        # V16 · A2: postura de cada persona (actual = destino de la transición, la previa y el avance 0-1), hacia dónde mira
        # y el alto efectivo del cuerpo (lo que usan la cámara, el LiDAR y la oclusión)
        self.pos, self.pos0, self.pt = zi(N_PERS), zi(N_PERS), np.ones((n, N_PERS))
        self.mira_p = z(N_PERS)
        self.alto_ef = np.full((n, N_PERS), ESTATURA_MEDIA)
        self.l_pos_esc, self.l_pos_aso, self.l_off = zi(), zi(), z()   # postura del escondite y del asomo; corrimiento
        self.salto_f, self.salto_tf, self.salto_v0 = zi(), z(), z()   # fase del salto (0 no, 1 impulso, 2 vuelo, 3 aterriza)
        self.salto_vx, self.salto_vy = z(), z()
        self.mano = np.zeros((n, 3))                     # mano del ladrón (x, y, z)
        # V16 · A3: sensores nuevos y ruido de navegación
        self.luna_max = np.full(n, LUNA_MAX[1])          # alcance del TF-Luna en la partida
        self.luna_hit = np.zeros((n, 3))                 # punto que mide el TF-Luna (visor)
        self.piso_vis = zb(N_PERS)                       # la cámara al piso detecta a cada persona
        self.piso_x, self.piso_y = z(N_PERS), z(N_PERS)  # posición medida por la cámara al piso
        self.piso_obj = zb()                             # la cámara al piso ve a la persona seguida (designada)
        self.cam_pitch_prev, self.chasis_prev = np.full(n, -10.0), z()
        self.e_gps, self.gps_amp = np.zeros((n, 2)), z()   # deriva del GPS/EKF (m) y su amplitud en la partida
        self.e_baro, self.baro_amp = z(), z()            # error del barómetro (m) y su amplitud
        self.dz_est = z()                                # altura que cree la Pixhawk
        self.t_clic = np.full(n, 99.0)                   # V16: s desde el último clic del operador (tracker amarrado)
        self.n_ruleta, self.n_escudo = z(), z()          # V17 · L3 y L4: cuántas veces lo hizo el ladrón en la partida
        self.cmd_reg, self.quien, self.arb = z(5), zi(), zi()
        self.pan, self.pan_meta = z(), z()               # D-075: ángulo del pan y el que pide la regla (°, + = izquierda)
        self.pan_red, self.dir_z17 = z(), z()            # V17.8: corrimiento del pan que pide la red; sentido de su altura
        self.phi_racha = z()                             # V17.1: potencial de la racha en curso
        self.b4_meta = np.full(n, Z_SEGURA)              # D-067 · B4: altura meta de la regla   # V17 · visor: consignas, quién manda y motivo del árbitro
        self.z_v17 = np.full(n, Z_SEGURA)                # V17 · E2: altura que piden SUBIR y BAJAR (con el objetivo fijado)
        self.blur = z(N_PERS)                            # desenfoque de cada persona en la cámara principal (px)
        self.alt_obj = np.full(n, Z_V16_ENTRADA)         # V16 · A1: altura objetivo en rampa (lo que se le pide a la Pixhawk)
        self.gente8 = zb()                               # V16 · A1: hay una persona conocida a menos de R_GENTE
        self.vz_cmd = z()                                # V16: consigna vertical que se manda a la Pixhawk
        self.frac_vis = z(N_PERS)                        # V13: fracción del bounding box visible (detección parcial)
        self.p_rumbo = z(N_PERS)                         # hacia dónde mira y camina cada persona
        self.chasis_pitch, self.chasis_roll, self.err_gmb = z(), z(), z()
        self.cam_pitch = np.full(n, -10.0)               # pitch real de la cámara (gimbal + error de estabilización)
        self.lid_t, self.lid_hx, self.lid_hy, self.lid_hz, self.lid_tipo = np.full(n, LIDAR_MAX), z(), z(), z(), zi()
        # mapa de obstáculos con el LiDAR: impactos guardados (en el plano) y segmentos detectados
        self.lid_px, self.lid_py, self.lid_ok, self.lid_i = z(N_LIDAR), z(N_LIDAR), zb(N_LIDAR), zi()
        self.lid_ult_psi, self.lid_ult_x, self.lid_ult_y = z(), np.full(n, 1e9), np.full(n, 1e9)
        self.det_a, self.det_b, self.det_n = z(K_DET, 2), z(K_DET, 2), zi()
        self.cand, self.t_resp, self.cand_sin_ver = np.full(n, -1), z(), z()
        self.cand_visto, self.cand_rumbo = z(), z()      # s que el operador lo ha visto y último rumbo donde se vio
        self.ignorado = zb(N_PERS)                       # IDs que el operador descartó ("NO ES")
        self.evento_op = zi()                            # 1 = el operador dijo SÍ, 2 = dijo NO (en ese paso)
        self.zona = np.tile([-18.0, 18.0, -18.0, 18.0], (n, 1))     # x0, x1, y0, y1 de la zona de búsqueda
        # objetivo
        self.lock, self.n_conf = zb(), zi()
        self.t_sin_ver, self.ult_rumbo, self.ult_dist = z(), z(), z()
        self.ult_x, self.ult_y = z(), z()                # última posición (X, Y) conocida del objetivo
        self.visto_alguna = zb()
        # personas
        self.px, self.py, self.pvx, self.pvy = z(N_PERS), z(N_PERS), z(N_PERS), z(N_PERS)
        self.activa = zb(N_PERS)
        self.guion = zi(N_PERS)
        self.g_dirx, self.g_diry, self.g_vel, self.g_parar = z(N_PERS), z(N_PERS), z(N_PERS), z(N_PERS)
        self.g_wx, self.g_wy = z(N_PERS), z(N_PERS)
        self.g_lim = np.tile([-15.0, 15.0, -15.0, 15.0], (n, N_PERS, 1))   # dónde deambula cada persona
        self.v_forzada = np.full((n, N_PERS, 2), np.nan)                  # velocidad impuesta (misión, fase 1)
        self.ids = zi(N_PERS)
        self.stamina = z()
        self.corriendo = zb()
        # ladrón táctico
        self.tactico = zb()
        self.l_modo, self.l_t, self.l_panel, self.l_alerta_t, self.l_expuesto = zi(), z(), zi(), z(), z()
        # paneles: extremos A y B y su altura (en la misión se agregan como segmentos los obstáculos del camino)
        self.pa, self.pb = z(N_PANELES, 2), z(N_PANELES, 2)
        self.ph = np.full((n, N_PANELES), ALTO_PANEL)
        self.man_t = np.zeros(n)                          # s que le quedan al mando manual
        self.man = np.zeros((n, 5))                       # vx, vy (cuerpo), wz, pan, tilt en [-1, 1]
        self.clic_op = np.full(n, -1)                     # clic del operador humano sobre la persona j (-1 = ninguno)
        self.z_op = np.full(n, np.nan)                    # altura que pide el operador (nan = la llevan las reglas)
        self.cam_modo = np.zeros(n, int)                  # cámara: 0 reglas, 1 asistida (sigue al ladrón), 2 manual (pan y tilt pedidos)
        self.cam_pan_obj, self.cam_tilt_obj = np.zeros(n), np.zeros(n)
        self.ruta_op = [[] for _ in range(n)]             # 'Enseñar por ruta': puntos (x, y, yaw, pan, tilt) por recorrer
        self.ruta_op_i = np.zeros(n, int)
        self.obj_on = np.zeros(n, bool)                   # ¿va a un punto?
        self.obj = np.full((n, 5), np.nan)                # x, y, yaw (°), pan (°), tilt (°); nan = sin meta
        self.alto17 = np.zeros(n, bool)                   # V17.9: ¿volando a la altura segura por una persona cerca?
        self.grosor = np.full(n, GROSOR_MURO)             # V17.9: grosor de los paneles de cada partida
        # sensores
        self.vis_prev = zb(N_PERS)
        self.dist_prev, self.ang_prev, self.vac, self.vlat = z(N_PERS), z(N_PERS), z(N_PERS), z(N_PERS)
        self.obs_retraso = np.zeros((n, OBS_DRON))
        self.info_sensor = {}
        self.lidar = np.full(n, 20.0)
        self.t = zi()
        self.phi = z()
        # controladores de bajo nivel del hardware (control.py): la política solo da consignas
        self.ap = AutopilotoArduPilot(n, self.rng)
        self.ap.RAFAGAS, self.ap.VIENTO_MEDIO, self.ap.FACTOR_ARRASTRE = FISICA_RAFAGAS, FISICA_VIENTO_MEDIO, FISICA_ARRASTRE
        self.ap.MOTOR_TAU, self.ap.BAT_CAIDA = FISICA_MOTOR_TAU, FISICA_BAT_CAIDA
        self.gb = GimbalMixto(n, rng=self.rng)          # V16: BaseCam o servo por partida (GIMBAL_TIPO)
        if FACTOR_SERVO_H != 1.0:                        # robustez: tilt más lento y con más retardo
            self.gb.RETARDO = tuple(x * FACTOR_SERVO_H for x in GimbalMixto.RETARDO)
            self.gb.SERVO_VEL = GimbalMixto.SERVO_VEL / FACTOR_SERVO_H
        # CURRÍCULO: 0 = condiciones suaves, 1 = las más exigentes (lo sube el entrenamiento según el desempeño)
        self.nivel = 0.0
        self.v_sprint = np.full(n, V_SPRINT[0])           # D-041: rapidez de esprint del ladrón (por partida)
        self.v_correr = np.full(n, VEL_CORRER)            # rapidez de carrera del ladrón (aleatoria por partida)
        self.k_ataque = np.ones(n)                        # agresividad del ladrón (aleatoria por partida)
        self.lm_i = np.zeros(n, int)                      # SLAM: hasta dónde se exportó la nube de puntos al visor
        self.reset(np.ones(n, bool))
        self._sensores()
        self.vis_prev[:] = False
        self.obs_retraso[:] = 0.0

    # ------------------------------------------------------------------ reinicio
    def reiniciar_mision(self, m):
        """Arranca la fase 2 (IA activada) en modo BUSCAR."""
        k = int(m.sum())
        if k == 0:
            return
        self.modo[m] = BUSCAR
        self.t_modo[m] = self.t_fase2[m] = self.t_fijado[m] = 0.0
        self.busca_dir[m] = self.rng.choice([-1.0, 1.0], k)
        self.giro_acum[m] = 0.0
        self.bfase[m] = B_GIRO
        self.panel_obj[m] = 0
        self.insp_n[m] = 0
        self.nadir[m] = False
        self.ruta_n[m] = self.ruta_i[m] = 0
        self.vuelo_alto[m] = self.flanco[m] = False
        self.tvx[m] = self.tvy[m] = self.esc_vx[m] = self.esc_vy[m] = 0.0
        self.v_ia_f[m] = self.v_ia_l[m] = 0.0
        self.arm_desc[m] = self.descubre[m] = False
        self.t_oculto[m] = self.t_perdida[m] = 0.0
        self.ciego[m] = False
        if hasattr(self, "entrada"):
            self.entrada[m], self.entrada_alta[m] = True, False      # V15: el primer 360° de la zona es el de entrada
        self.aso_gira[m] = False
        self.lat_esq[m] = 0.0
        self.reflejo[m] = False
        self.t_vuelo[m] = self.t_bloqueo[m] = 0.0
        self.yaw_corrige[m] = self.gmb_corrige[m] = self.gmb_sat_arriba[m] = False
        self.ult_x[m] = self.ult_y[m] = 0.0
        self.cand[m] = -1
        self.t_resp[m] = self.cand_sin_ver[m] = self.cand_visto[m] = 0.0
        self.ignorado[m] = False
        self.evento_op[m] = 0
        self.lock[m] = False
        self.n_conf[m] = 0
        self.t_sin_ver[m] = 0.0
        self.giro_mem[m] = self.giro_t[m] = 0.0
        self.estado[m] = VIGILANDO
        self.t_estado[m] = 0.0
        self.ev_cand[m] = self.ev_cand_n[m] = 0
        self.t[m] = 0
        if hasattr(self, "ap"):
            self.ap.sincronizar(self, m)          # la referencia del autopiloto arranca desde la velocidad actual

    def reset(self, m):
        k = int(m.sum())
        if k == 0:
            return
        r = self.rng
        idx = np.where(m)[0]
        self.dx[m], self.dy[m] = r.uniform(-12, 12, k), r.uniform(-12, 12, k)
        self.dz[m] = r.uniform(2.0, 2.6, k)
        self.dvx[m] = self.dvy[m] = self.dvz[m] = 0.0
        self.psi[m] = r.uniform(-np.pi, np.pi, k)
        self.yaw_dps[m] = 0.0
        self.chasis_pitch[m] = self.chasis_roll[m] = self.err_gmb[m] = 0.0
        self.acc_x[m] = self.acc_y[m] = 0.0
        self.salto_t[m] = self.salto_cd[m] = self.salto_h[m] = 0.0
        self.u_prev[m], self.mando_prev[m] = 0.0, False
        self.u_prev2[m] = 0.0
        self.v_ia_f[m] = self.v_ia_l[m] = 0.0
        self.arm_desc[m] = self.descubre[m] = False
        self.cam_pitch[m] = -10.0
        self.gmb_min_ep[m] = -10.0
        self.u_prev_fis[m] = 0.0
        self.gimbal[m] = -10.0
        self.gimbal_cmd[m] = -10.0
        if hasattr(self, "ap"):
            self.ap.reset(m, self.nivel)
            self.gb.reset(m, -10.0)
            # ALEATORIZACIÓN DEL DOMINIO (generalización): cada partida un ladrón distinto, más rápido y agresivo a
            # medida que sube el nivel del currículo
            self.v_correr[m] = r.uniform(3.0, 3.4, k) + 0.4 * self.nivel
            self.v_sprint[m] = r.uniform(V_SPRINT[0], V_SPRINT[1], k)
            self.k_ataque[m] = r.uniform(0.5, 1.0, k) + 0.5 * self.nivel
            self.lm_i[m] = 0
        self.clase[m] = 0
        self.amenaza[m] = self.perimetro[m] = False
        self.zona[m] = [-18.0, 18.0, -18.0, 18.0]
        self.reiniciar_mision(m)
        self.ult_rumbo[m] = self.ult_dist[m] = 0.0
        self.lid_ok[m] = False
        self.lid_i[m] = 0
        self.lid_ult_x[m] = self.lid_ult_y[m] = 1e9
        self.det_n[m] = 0
        self.visto_alguna[m] = False
        # paneles: lejos del dron, en cualquier orientación
        for i in idx:
            for j in range(N_PANELES):
                c = r.uniform(-17, 17, 2)
                for _ in range(20):
                    if np.hypot(c[0] - self.dx[i], c[1] - self.dy[i]) > 5:
                        break
                    c = r.uniform(-17, 17, 2)
                ang = r.uniform(0, np.pi)
                L = r.uniform(4.0, 6.5)
                u = np.array([np.cos(ang), np.sin(ang)]) * L / 2
                self.pa[i, j], self.pb[i, j] = c - u, c + u
        # V14 · NIVEL DE CADA PARTIDA: el actual del currículo o, con probabilidad p_repaso, uno ya superado (repaso)
        cl = int(np.clip(getattr(self, "current_level", N_NIVELES - 1), 0, NIVEL_V17))
        lv = np.full(k, cl)
        if 0 < cl < NIVEL_V16 and getattr(self, "p_repaso", 0.0) > 0:      # V16: partida única, sin repaso
            rep = r.random(k) < self.p_repaso
            lv = np.where(rep, r.integers(0, cl, k), lv)
        self.lvl_ep[m] = lv
        # niveles 1 y 2: UN muro (los demás paneles se superponen al primero; el ladrón no tiene otra cubierta), cerca
        # del centro de la zona; nivel 0: sin muros (fuera de la arena, donde el LiDAR no llega)
        self.ph[m] = ALTO_PANEL
        self.grosor[m] = np.where(lv == NIVEL_V17, GROSOR_PANEL_V17, GROSOR_MURO)
        self.alto17[m] = False
        self.man_t[m], self.obj_on[m] = 0.0, False
        self.cam_modo[m] = 0
        self.clic_op[m] = -1
        self.z_op[m] = np.nan
        for q in np.where(m)[0]:
            self.ruta_op[q], self.ruta_op_i[q] = [], 0
        for a, i in enumerate(idx):
            if lv[a] == NIVEL_V17:
                # V17 · E5: la partida empieza en la activación, con el dron en el borde sur de la zona mirando a las V
                self.dx[i], self.dy[i] = r.uniform(-4.0, 4.0), Y_ACTIVA_V17 + r.uniform(-1.0, 1.0)
                self.psi[i] = np.pi / 2 + np.radians(r.uniform(-20.0, 20.0))
                # V17 · E6: dos V de 90° (paneles 0-1 la del sur, abierta al sur; 2-3 la del norte, abierta al norte)
                gc = r.uniform(0, 2 * np.pi) if GIRO_CANCHA_V17 else 0.0
                Rg = np.array([[np.cos(gc), -np.sin(gc)], [np.sin(gc), np.cos(gc)]])
                for v, (y_v, boca) in enumerate(((-SEP_V17 / 2, -np.pi / 2), (SEP_V17 / 2, np.pi / 2))):
                    vert = Rg @ (np.array([0.0, y_v]) + r.uniform(-AZAR_POS_V17, AZAR_POS_V17, 2))
                    b = boca + gc + np.radians(r.uniform(-AZAR_ANG_V17, AZAR_ANG_V17))
                    alto = r.uniform(*ALTO_PANEL_V17)
                    abre = np.radians(r.uniform(*ANG_V_V17)) / 2
                    for w, s_ in enumerate((-1.0, 1.0)):
                        ala = b + s_ * abre
                        self.pa[i, 2 * v + w] = vert
                        self.pb[i, 2 * v + w] = vert + ANCHO_PANEL_V17 * np.array([np.cos(ala), np.sin(ala)])
                        self.ph[i, 2 * v + w] = alto
            elif lv[a] == NIVEL_V16:
                # V16 · A1: 2 paneles de 4 a 6.5 m (2.6 m de alto) separados entre sí y lejos del dron (los que sobran se
                # superponen al último, como en el nivel 4)
                cs = []
                for j in range(MUROS_V16):
                    for _ in range(40):
                        c = r.uniform(-C_MURO_V16, C_MURO_V16, 2)
                        if (np.hypot(c[0] - self.dx[i], c[1] - self.dy[i]) > 5
                                and all(np.hypot(*(c - c2)) > 7.0 for c2 in cs)):
                            break
                    cs.append(c)
                    ang = r.uniform(0, np.pi)
                    u = np.array([np.cos(ang), np.sin(ang)]) * r.uniform(*LARGO_MURO_V16) / 2
                    self.pa[i, j], self.pb[i, j] = c - u, c + u
                self.pa[i, MUROS_V16:], self.pb[i, MUROS_V16:] = self.pa[i, MUROS_V16 - 1], self.pb[i, MUROS_V16 - 1]
            elif lv[a] == N_NIVELES - 1:
                # V15 · nivel 4: 3 o 4 muros separados entre sí (los que sobran se superponen al último)
                nm = int(r.integers(MUROS_N4[0], MUROS_N4[1] + 1))
                cs = []
                for j in range(nm):
                    for _ in range(40):
                        c = r.uniform(-17, 17, 2)
                        if (np.hypot(c[0] - self.dx[i], c[1] - self.dy[i]) > 5
                                and all(np.hypot(*(c - c2)) > 6.0 for c2 in cs)):
                            break
                    cs.append(c)
                    ang = r.uniform(0, np.pi)
                    u = np.array([np.cos(ang), np.sin(ang)]) * r.uniform(4.0, 6.5) / 2
                    self.pa[i, j], self.pb[i, j] = c - u, c + u
                self.pa[i, nm:], self.pb[i, nm:] = self.pa[i, nm - 1], self.pb[i, nm - 1]
            elif lv[a] in (2, 3):
                c = r.uniform(-6, 6, 2)
                for _ in range(20):
                    if np.hypot(c[0] - self.dx[i], c[1] - self.dy[i]) > 5:
                        break
                    c = r.uniform(-6, 6, 2)
                ang = r.uniform(0, np.pi)
                u = np.array([np.cos(ang), np.sin(ang)]) * r.uniform(4.0, 6.5) / 2
                self.pa[i, :], self.pb[i, :] = c - u, c + u
            elif lv[a] in (0, 1):
                for j in range(N_PANELES):
                    self.pa[i, j] = (LEJOS_PANEL + 3 * j, LEJOS_PANEL)
                    self.pb[i, j] = (LEJOS_PANEL + 3 * j + 1, LEJOS_PANEL)
        self.un_muro[m] = (lv == 2) | (lv == 3)
        # ladrón: a 8-20 m (30% dentro del campo de visión); al principio no ha notado al dron
        u = r.random(k)
        rel = np.where(u < 0.3, r.uniform(-0.26, 0.26, k), r.uniform(-np.pi, np.pi, k))
        d0 = r.uniform(8, 20, k)
        b = self.psi[m] - rel
        self.px[m, 0] = np.clip(self.dx[m] + d0 * np.cos(b), -self.A + 1, self.A - 1)
        self.py[m, 0] = np.clip(self.dy[m] + d0 * np.sin(b), -self.A + 1, self.A - 1)
        for a, i in enumerate(idx):
            if lv[a] == NIVEL_V17:
                # V17: el ladrón en cualquier lugar de la zona, a 8 m o más del dron y fuera de los paneles
                self.zona[i] = [-self.A + 1, self.A - 1, -self.A + 1, self.A - 1]
                for _ in range(50):
                    q = r.uniform(-self.A + 3, self.A - 3, 2)
                    lejos = np.hypot(q[0] - self.dx[i], q[1] - self.dy[i]) >= 8.0
                    if lejos and all(dist_punto_segmento(q, self.pa[i, j], self.pb[i, j])[0] > 0.6 for j in range(N_PANELES)):
                        break
                self.px[i, 0], self.py[i, 0] = q
        self.activa[m, 0] = True
        self.stamina[m] = STAMINA_MAX
        # V15: cuerpo (estatura de cada persona), alcance del ladrón, reserva casi llena y pulso alto por la tensión
        self.estatura[m] = np.clip(r.normal(ESTATURA_MEDIA, ESTATURA_SD, (k, N_PERS)), ESTATURA_MIN, ESTATURA_MAX)
        self.alc_pie[m] = K_ALCANCE_PIE * self.estatura[m, 0]
        self.reserva[m] = r.uniform(0.9, 1.0, k)
        self.moral[m] = 1.0
        self.pulso[m] = r.uniform(100.0, 110.0, k)
        self.lid_psi_prev[m] = self.psi[m]
        self.kf_ok[m] = self.pf_on[m] = self.anticenit[m] = False
        self.kf_fuera[m] = 0
        # apariencias: la del ladrón al azar; cada civil se le parece con coseno entre SIM_CIVIL[0] y SIM_CIVIL[1]
        u = r.normal(0, 1, (k, DIM_APARIENCIA))
        u /= np.linalg.norm(u, axis=1, keepdims=True)
        ap_ = np.zeros((k, N_PERS, DIM_APARIENCIA))
        ap_[:, 0] = u
        for j in range(1, N_PERS):
            w_ = r.normal(0, 1, (k, DIM_APARIENCIA))
            w_ -= (w_ * u).sum(1, keepdims=True) * u
            w_ /= np.linalg.norm(w_, axis=1, keepdims=True)
            c_ = r.uniform(SIM_CIVIL[0], SIM_CIVIL[1], k)[:, None]
            ap_[:, j] = c_ * u + np.sqrt(1 - c_ ** 2) * w_
        self.apariencia[m] = ap_
        self.trk[m] = 0
        self.sim_med[m], self.t_cruce[m], self.sim_cruce[m] = 1.0, 99.0, 0.0
        self.mal[m] = self.mal_det[m] = False
        self.duda_pend[m] = False
        self.paso_muro[m] = 0
        self.canto_t[m] = -1.0
        self.t_cont[m] = 0.0
        self.rendido[m] = False
        self.t_desde_vista[m] = self.racha_max[m] = self.t_vista_ac[m] = 0.0
        self.t_readq_sum[m] = self.n_readq[m] = 0.0
        self.n_perd[m] = self.n_readq10[m] = 0.0
        self.t_busq_est[m] = 0.0
        self.readq_est[m] = 0.0
        self.ult_busq[m] = PREDECIR
        self.pm_t[m] = 99.0

        self.corriendo[m] = False
        # niveles 0-2: ladrón táctico con guion (el aprendido solo en la misión completa)
        # V16: siempre el táctico (es el que tiene posturas, salto con el brazo y cansancio; la red del ladrón no)
        self.tactico[m] = (r.random(k) >= FRAC_LADRON_RL) | (lv < N_NIVELES - 1) | (lv >= NIVEL_V16)
        self.l_guion[m] = np.where(lv <= 1, np.where(r.random(k) < self.p_cenit, L_GUION_CENIT, L_GUION_HUIDA), L_GUION_TACTICO)
        self.l_ang[m] = 0.0
        self.l_tg[m] = 0.0
        self.l_modo[m] = L_DEAMBULAR
        self.l_alerta_t[m] = r.uniform(2.0, 8.0, k)
        self.l_t[m] = self.l_expuesto[m] = 0.0
        self.l_panel[m] = 0
        self.g_lim[m] = [-18.0, 18.0, -18.0, 18.0]
        self.g_wx[m, 0], self.g_wy[m, 0] = r.uniform(-15, 15, k), r.uniform(-15, 15, k)
        i17 = idx[lv == NIVEL_V17]
        if len(i17):                                     # V17: el ladrón deambula dentro de la zona de 30 x 30 m
            lim17 = self.A - 2.0
            self.g_lim[i17, 0] = [-lim17, lim17, -lim17, lim17]
            self.g_wx[i17, 0], self.g_wy[i17, 0] = r.uniform(-lim17, lim17, (2, len(i17)))
        self.v_forzada[m] = np.nan
        # peatones de la zona: 0, 1 o 2 (el 3 es el transeúnte de la ruta, solo en la misión)
        self.conocido[m] = False
        self.cruce_con[m] = False
        self.g_pausa[m] = 0.0
        npea = r.choice([0, 1, 2], size=k, p=[0.3, 0.4, 0.3])
        npea = np.where((lv == 1) | (lv == 3), 1, np.where(lv <= 2, 0, npea))     # V15: civiles según el nivel
        v16c = lv >= NIVEL_V16
        if v16c.any():                                                           # V16: 0, 1 o 2 civiles realistas
            npea = np.where(v16c, r.choice([0, 1, 2], size=k, p=list(P_CIVILES_V16)), npea)
        npea = np.where(lv == NIVEL_V17, min(N_CIVILES_V17, N_PERS - 2), npea)    # V17: 1 ladrón y 1 civil (D-051)
        for a, i in enumerate(idx):
            for j in range(1, N_PERS):
                act = j <= npea[a]
                self.activa[i, j] = act
                if act:
                    self._preparar_peaton(i, j)
                    if lv[a] >= NIVEL_V16:
                        self._preparar_civil_v16(i, j)
                    # D-041: ningún civil nace a menos de D_NACE_CIVIL del dron (el 360° de entrada es bajo; V16: D_NACE_V16)
                    d_nace = D_NACE_V16 if lv[a] >= NIVEL_V16 else D_NACE_CIVIL
                    ex_, ey_ = self.px[i, j] - self.dx[i], self.py[i, j] - self.dy[i]
                    de0 = max(np.hypot(ex_, ey_), 1e-6)
                    if de0 < d_nace:
                        self.px[i, j] = np.clip(self.dx[i] + ex_ / de0 * d_nace, -self.A + 1, self.A - 1)
                        self.py[i, j] = np.clip(self.dy[i] + ey_ / de0 * d_nace, -self.A + 1, self.A - 1)
                    if lv[a] in (1, 3):                  # V15 niveles 1 y 3: el civil es un distractor en la línea de vista
                        self.guion[i, j] = G_DISTRACTOR
                        self.g_vel[i, j] = r.uniform(1.0, 1.5)
                        self.g_lado[i, j] = r.choice([-1.0, 1.0])
                        self.g_pausa[i, j] = r.uniform(0.0, 10.0)
                else:
                    self.px[i, j] = self.py[i, j] = 999.0
            self.ids[i] = r.choice(np.arange(1, 60), N_PERS, replace=False)
        self.pvx[m] = self.pvy[m] = 0.0
        self.p_rumbo[m] = r.uniform(-np.pi, np.pi, (k, N_PERS))
        self.vis_prev[m] = False
        self.vac[m] = self.vlat[m] = 0.0
        self.obs_retraso[m] = 0.0
        # V15 · niveles 0 y 1: "dron en el aire con el objetivo ya fijado": el ladrón aparece en cuadro a 6-12 m, ya
        # alerta, y el operador ya lo confirmó
        fij0 = np.where(m)[0][lv <= 1]
        if len(fij0):
            kk = len(fij0)
            rel0 = r.uniform(-0.2, 0.2, kk)
            d00 = r.uniform(6.0, 12.0, kk)
            b0 = self.psi[fij0] - rel0
            self.px[fij0, 0] = np.clip(self.dx[fij0] + d00 * np.cos(b0), -self.A + 1, self.A - 1)
            self.py[fij0, 0] = np.clip(self.dy[fij0] + d00 * np.sin(b0), -self.A + 1, self.A - 1)
            self.modo[fij0] = FIJADO
            self.visto_alguna[fij0] = True
            self.lock[fij0] = True
            self.trk[fij0] = 0
            self.l_alerta_t[fij0] = 0.0
            self.dz[fij0] = Z_NOMINAL                    # V15: ya en el aire a la altura segura
            a0 = -np.degrees(np.arctan2(self.dz[fij0] - 0.9, d00))
            self.cam_pitch[fij0] = self.gimbal[fij0] = self.gimbal_cmd[fij0] = a0
            if hasattr(self, "gb"):
                self.gb.ang[fij0] = self.gb.sp[fij0] = a0
        # V16 · A2: todos de pie, sin transición, mirando hacia donde caminan; sin salto en curso
        self.pos[m] = self.pos0[m] = 0
        self.pt[m] = 1.0
        self.mira_p[m] = self.p_rumbo[m]
        self.alto_ef[m] = self.estatura[m]
        self.l_pos_esc[m] = self.l_pos_aso[m] = 0
        self.l_off[m] = 0.0
        self.salto_f[m] = 0
        self.salto_tf[m] = self.salto_v0[m] = self.salto_vx[m] = self.salto_vy[m] = 0.0
        self.mano[m] = 0.0
        self.c_noto[m] = False
        self.t_clic[m] = 99.0
        self.n_ruleta[m] = self.n_escudo[m] = 0.0
        self.phi_racha[m] = 0.0
        self.b4_meta[m] = Z_SEGURA
        self.pan[m] = self.pan_meta[m] = 0.0
        self.pan_red[m] = self.dir_z17[m] = 0.0
        self.z_v17[m] = Z_SEGURA
        # V16 · A3: tipo de gimbal, alcance del TF-Luna y ruido de navegación de la partida (solo en la V16)
        iv = np.where(m)[0][lv >= NIVEL_V16]
        inv_ = np.where(m)[0][lv < NIVEL_V16]
        mv = np.zeros(self.n, bool)
        mv[iv] = True
        mo = np.zeros(self.n, bool)
        mo[inv_] = True
        self.gb.elegir(mo, 0.0)
        self.gb.elegir(mv, {"basecam": 0.0, "servo": 1.0}.get(GIMBAL_TIPO, 0.5))
        self.luna_max[m] = LUNA_MAX[1]
        self.gps_amp[m] = self.baro_amp[m] = 0.0
        self.e_gps[m] = 0.0
        self.e_baro[m] = 0.0
        if len(iv) and RUIDO_NAV:
            kv = len(iv)
            self.gps_amp[iv] = r.uniform(GPS_DERIVA[0], GPS_DERIVA[1], kv) * RUIDO_GPS
            self.baro_amp[iv] = (r.uniform(BARO_ERROR[0], BARO_ERROR[1], kv) if ALTIMETRO == "baro"
                                 else np.full(kv, ERROR_LUNA_ALT)) * RUIDO_BARO
            self.e_gps[iv] = r.normal(0, 1, (kv, 2)) * (self.gps_amp[iv] / 2)[:, None]
            self.e_baro[iv] = r.normal(0, 1, kv) * self.baro_amp[iv] / 2
        if len(iv):
            self.luna_max[iv] = r.uniform(LUNA_MAX[0], LUNA_MAX[1], len(iv))
        self.piso_vis[m] = False
        self.piso_obj[m] = False
        # V16 · A1: el dron entra a la zona a la altura del 360° de entrada; la rampa de altura arranca donde está
        v16_ = np.where(m)[0][lv >= NIVEL_V16]
        self.dz[v16_] = Z_V16_ENTRADA
        # (llega a la altura de entrada según SU barómetro: la real es la que corresponda con el error)
        z_e17 = Z_BASE_V17 if ALTURA_FIJA_V17 else Z_V17_ENTRADA
        self.dz[v16_] = np.clip(np.where(lv[lv >= NIVEL_V16] == NIVEL_V17, z_e17, Z_V16_ENTRADA) - self.e_baro[v16_],
                                Z_MIN, Z_MAX)
        self.dz_est[m] = self.dz[m] + self.e_baro[m]
        self.alt_obj[m] = self.dz_est[m]
        self.gente8[m] = False
        self.phi[m] = self._potencial()[m]
        pc, pe = self._potencial_v16()
        self.phi_cob[m], self.phi_esc[m] = pc[m], pe[m]

    def _potencial_v16(self):
        """V16 · A4. (1) COBERTURAS: fracción de los puntos a los que el ladrón llega en T_COB s (sin atravesar muros, dentro
        de la arena) que el dron ve sin un muro en medio (a 1 m de altura, a menos de 20 m): desde donde está, ¿le queda al
        ladrón dónde esconderse? (2) ABORDAJE: el dron del lado contrario a su ruta de escape (hacia su cubierta más
        cercana): coseno entre dron -> ladrón y ladrón -> cubierta. Usa la verdad del simulador SOLO para calificar (como la
        guía de la V12). Solo con el objetivo designado en la misión V16."""
        n = self.n
        act = (self.lvl_ep >= NIVEL_V16) & (self.modo >= FIJADO)
        if not act.any() or (K_COB == 0 and K_ESC == 0):
            return np.zeros(n), np.zeros(n)
        P = np.stack([self.px[:, 0], self.py[:, 0]], -1)
        frac = self._cobertura(P, self.dx, self.dy, self.dz)
        self.cob_frac = np.where(act, frac, 0.0)
        dl = P - np.stack([self.dx, self.dy], -1)
        es = self.l_cub - P
        nl, ne = np.maximum(np.hypot(*dl.T), 1e-6), np.hypot(*es.T)
        cos_e = np.where(ne > 0.5, (dl * es).sum(1) / (nl * np.maximum(ne, 1e-6)), 0.0)
        return np.where(act, K_COB * frac, 0.0), np.where(act, K_ESC * np.maximum(cos_e, 0.0), 0.0)

    def _cobertura(self, P, dx, dy, dz):
        """Fracción de los puntos a los que llega en T_COB s alguien que está en P (sin atravesar muros, dentro de la arena)
        que un dron en (dx, dy, dz) ve sin un muro en medio (a 1 m de altura, a menos de 20 m)."""
        R_ = V_ALCANCE_OBJ * T_COB
        ang = np.linspace(-np.pi, np.pi, N_COB_ANG, endpoint=False)
        off = np.concatenate([f * R_ * np.stack([np.cos(ang), np.sin(ang)], -1) for f in F_COB_RADIO])     # (K, 2)
        Q = P[:, None, :] + off[None]                                                               # (n, K, 2)
        alc = (np.abs(Q) < self.A - 0.5).all(-1)
        for j in range(self.pa.shape[1]):
            alc &= ~cruce_segmentos(np.broadcast_to(P[:, None, :], Q.shape), Q,
                                    self.pa[:, j][:, None, :], self.pb[:, j][:, None, :])[0]
        d0 = (self.dx, self.dy, self.dz)
        self.dx, self.dy, self.dz = dx, dy, dz             # (_vista_bloqueada mira desde el dron)
        try:
            ve = ~self._vista_bloqueada(Q[..., 0], Q[..., 1], np.ones(Q.shape[:2]))
        finally:
            self.dx, self.dy, self.dz = d0
        ve &= np.hypot(Q[..., 0] - dx[:, None], Q[..., 1] - dy[:, None]) < 20.0
        return (alc & ve).sum(1) / np.maximum(alc.sum(1), 1)

    def regla_b2(self, horizonte=1.0):
        """V17 · E8 · B2, la REGLA DE POSICIONAMIENTO (plan, sección 2): de los botones permitidos, el que deja al dron,
        dentro de `horizonte` s, donde más sube la cobertura (_cobertura) del lugar donde el dron cree que está el ladrón
        (su última medición, no la verdad del simulador). Empate: QUEDARSE. Es la mejor regla que un ingeniero escribiría a
        mano: la IA tiene que ganarle para "aportar más que una regla diseñada"."""
        mk = self.action_masks()
        P = np.stack([self.ult_x, self.ult_y], -1)
        d_h = self._d_obj()
        ux, uy = np.cos(self.psi), np.sin(self.psi)                 # adelante (la nariz mira al ladrón)
        rx, ry = np.sin(self.psi), -np.cos(self.psi)                # a la derecha
        mejor, b = np.full(self.n, -1.0), np.zeros(self.n, int)
        for k in range(len(CLASES_V17)):
            if not mk[:, k].any():
                continue
            vf = {ACERCARSE: np.minimum(VEL_RADIAL_V17, np.maximum(d_h - D_ACERCA_V17, 0.0) / horizonte),
                  ALEJARSE: -np.minimum(VEL_RADIAL_V17, np.maximum(D_ALEJA_V17 - d_h, 0.0) / horizonte)}.get(k, 0.0)
            vl = {RODEAR_IZQ: -VEL_ORBITA, RODEAR_DER: VEL_ORBITA}.get(k, 0.0)
            dz = {SUBIR: PASO_Z_V17, BAJAR: -PASO_Z_V17}.get(k, 0.0)
            c = self._cobertura(P, self.dx + (vf * ux + vl * rx) * horizonte, self.dy + (vf * uy + vl * ry) * horizonte,
                                self.dz + dz)
            gana = mk[:, k] & (c > mejor + 1e-9)
            mejor, b = np.where(gana, c, mejor), np.where(gana, k, b)
        return b

    def regla_b4(self, oraculo=False):
        """V17 · D-067 · B4, REGLA DE ALTURA POR COBERTURA: con la posición donde el dron cree que está el ladrón (B4*,
        `oraculo`: la verdadera, solo para medir el techo) y desde donde está, compara la cobertura a 3.30 m y a 5.5 m. Altura
        meta: arriba si desde arriba ve B4_SUBE más, abajo si ve B4_BAJA o menos; entre los dos conserva la meta anterior
        (histéresis contra el vaivén). Botón: SUBIR o BAJAR si z_v17 está a más de 0.25 m de la meta, QUEDARSE si no."""
        mk = self.action_masks()
        d = self.mascara_decision() & (self.lvl_ep == NIVEL_V17)
        P = (np.stack([self.px[:, 0], self.py[:, 0]], -1) if oraculo else np.stack([self.ult_x, self.ult_y], -1))
        c_bajo = self._cobertura(P, self.dx, self.dy, np.full(self.n, Z_SEGURA))
        c_alto = self._cobertura(P, self.dx, self.dy, np.full(self.n, Z_MAX_V17))
        dif = c_alto - c_bajo
        meta = np.where(dif >= B4_SUBE, Z_MAX_V17, np.where(dif <= B4_BAJA, Z_SEGURA, self.b4_meta))
        self.b4_meta = np.where(d, meta, self.b4_meta)
        b = np.where(self.z_v17 < self.b4_meta - 0.25, SUBIR, np.where(self.z_v17 > self.b4_meta + 0.25, BAJAR, QUEDARSE))
        return np.where(mk[np.arange(self.n), b], b, QUEDARSE)

    def _preparar_civil_v16(self, i, j):
        """V16 · civil realista: atraviesa la zona caminando tranquilo, de un borde al opuesto; nace en algún punto de ese
        cruce (ya viene caminando)."""
        r = self.rng
        self.guion[i, j] = G_CIVIL
        self.g_vel[i, j] = r.uniform(*VEL_CIVIL_V16)
        self.c_est[i, j], self.c_t[i, j] = 0, 0.0
        a = r.uniform(-np.pi, np.pi)
        lim = self.A - 2.0
        ini = np.array([np.cos(a), np.sin(a)]) * lim * 1.4
        fin = -ini + r.uniform(-8, 8, 2)
        ini, fin = np.clip(ini, -lim, lim), np.clip(fin, -lim, lim)
        f = r.uniform(0.0, 0.6)
        self.px[i, j], self.py[i, j] = ini + f * (fin - ini)
        self.g_wx[i, j], self.g_wy[i, j] = fin

    def _f_postura(self, tabla):
        """V16 · A2: valor de una tabla por postura para cada persona, interpolado durante la transición. (n, N_PERS)"""
        return tabla[self.pos0] + (tabla[self.pos] - tabla[self.pos0]) * self.pt

    def _pedir_postura(self, quien, nueva):
        """V16 · A2: las personas `quien` (n, N_PERS) pasan a la postura `nueva` (si no están ya en ella). Una transición
        a medio camino arranca desde la postura destino anterior (no hay saltos de pose: el visor interpola con pt)."""
        cambia = quien & (nueva != self.pos)
        if cambia.any():
            self.pos0 = np.where(cambia, self.pos, self.pos0)
            self.pos = np.where(cambia, nueva, self.pos)
            self.pt = np.where(cambia, 0.0, self.pt)

    def _avanzar_posturas(self):
        """V16 · A2: avance de las transiciones (0.5-1 s según el par de posturas) y alto efectivo del cuerpo."""
        t_tr = np.maximum(T_TRANS_POSTURA[self.pos0, self.pos], 1e-6)
        self.pt = np.minimum(self.pt + DT / t_tr + 1e-9, 1.0)
        self.alto_ef = self.estatura * self._f_postura(F_ALTO_POSTURA)

    def _potencial(self):
        rx, ry = self.px[:, 0] - self.dx, self.py[:, 0] - self.dy
        err = np.abs(envolver(np.arctan2(ry, rx) - self.psi))
        phi = -K_GUIA_ANG * err / np.pi - K_GUIA_DIST * np.maximum(np.hypot(rx, ry) - R_OPT_MAX, 0.0)
        return np.where(self.modo >= FIJADO, phi, 0.0)

    def _preparar_peaton(self, i, j):
        r = self.rng
        g = int(r.choice(len(GUIONES), p=P_GUION))
        self.guion[i, j] = g
        rel = r.uniform(-0.5, 0.5) if g in (1, 5) else r.uniform(-np.pi, np.pi)
        d0 = r.uniform(8, 18)
        b = self.psi[i] - rel
        self.px[i, j], self.py[i, j] = self.dx[i] + d0 * np.cos(b), self.dy[i] + d0 * np.sin(b)
        hx, hy = self.dx[i] - self.px[i, j], self.dy[i] - self.py[i, j]
        dist = max(np.hypot(hx, hy), 1e-6)
        ux, uy = hx / dist, hy / dist
        self.g_vel[i, j] = r.uniform(0.8, 1.6 + 0.6 * self.nivel)       # peatones con rapidez variable (currículo)
        self.g_parar[i, j] = 0.0
        self.g_dirx[i, j], self.g_diry[i, j] = 0.0, 0.0
        self.g_lim[i, j] = self.zona[i]
        if g == 0:
            off = r.uniform(2.0, 10.0) * r.choice([-1, 1])
            cx, cy = self.dx[i] - uy * off, self.dy[i] + ux * off
            s = r.choice([-1, 1])
            L = r.uniform(8, 14)
            self.px[i, j], self.py[i, j] = cx - s * ux * L, cy - s * uy * L
            self.g_dirx[i, j], self.g_diry[i, j] = s * ux, s * uy
        elif g in (1, 5):
            self.g_dirx[i, j], self.g_diry[i, j] = ux, uy
            if g == 5:
                self.g_vel[i, j] = r.uniform(2.3, 3.0)
        elif g == 2:
            self.g_vel[i, j] = 0.0
            d = r.uniform(3.0, 12.0)
            self.px[i, j], self.py[i, j] = self.dx[i] - ux * d, self.dy[i] - uy * d
        elif g == 3:
            d = r.uniform(3.0, 8.0)
            self.px[i, j], self.py[i, j] = self.dx[i] - ux * d, self.dy[i] - uy * d
            self.g_dirx[i, j], self.g_diry[i, j] = -ux, -uy
        elif g == 4:
            self.g_dirx[i, j], self.g_diry[i, j] = ux, uy
            self.g_parar[i, j] = r.uniform(3.0, 6.0)
        else:
            x0, x1, y0, y1 = self.g_lim[i, j]
            self.g_wx[i, j], self.g_wy[i, j] = r.uniform(x0, x1), r.uniform(y0, y1)
            self.g_vel[i, j] = r.uniform(0.8, 1.4)
        self.px[i, j] = np.clip(self.px[i, j], -self.A + 0.5, self.A - 0.5)
        self.py[i, j] = np.clip(self.py[i, j], -self.A + 0.5, self.A - 0.5)

    # ------------------------------------------------------------------ geometría
    def _vista_bloqueada(self, qx, qy, qz):
        """¿Algún panel tapa la línea de vista del dron a (qx,qy,qz)? Formas (n, P)."""
        p = np.broadcast_to(np.stack([self.dx, self.dy], -1)[:, None, :], qx.shape + (2,))
        q = np.stack([qx, qy], -1)
        z = np.broadcast_to(self.dz[:, None], qx.shape)
        bloq = np.zeros(qx.shape, bool)
        for j in range(self.pa.shape[1]):
            a = np.broadcast_to(self.pa[:, j][:, None, :], q.shape)
            b = np.broadcast_to(self.pb[:, j][:, None, :], q.shape)
            corta, t = cruce_segmentos(p, q, a, b)
            h = z + (qz - z) * t
            bloq |= corta & (h < self.ph[:, j][:, None])
        return bloq

    def _caras_muro(self, j):
        """V15: las 4 caras del muro j como segmentos (los dos lados a +-GROSOR_MURO/2 y las dos puntas). (n, 2) cada uno."""
        a, b = self.pa[:, j], self.pb[:, j]
        u = (b - a) / np.maximum(np.hypot(*(b - a).T), 1e-6)[:, None]
        g = np.stack([-u[:, 1], u[:, 0]], -1) * (self.grosor / 2)[:, None]
        return [(a + g, b + g), (a - g, b - g), (a + g, a - g), (b + g, b - g)]

    def _vista_bloqueada_alturas(self, hs, qx=None, qy=None):
        """¿Algún muro tapa la línea de vista del dron a cada punto (qx, qy) de cada persona a cada altura hs? (n, P, K).
        V15: hs puede ser (K,) o (n, P, K) (estatura de cada persona) y los muros tienen grosor (4 caras). El cruce no
        depende de la altura: se calcula una vez por cara y se evalúan todas las alturas juntas."""
        qx = self.px if qx is None else qx
        qy = self.py if qy is None else qy
        hs = np.asarray(hs)
        hs3 = hs[None, None, :] if hs.ndim == 1 else hs
        p = np.broadcast_to(np.stack([self.dx, self.dy], -1)[:, None, :], qx.shape + (2,))
        q = np.stack([qx, qy], -1)
        z = self.dz[:, None, None]
        bloq = np.zeros(qx.shape + (hs3.shape[-1],), bool)
        for j in range(self.pa.shape[1]):
            for a_, b_ in self._caras_muro(j):
                a = np.broadcast_to(a_[:, None, :], q.shape)
                b = np.broadcast_to(b_[:, None, :], q.shape)
                corta, t = cruce_segmentos(p, q, a, b)
                h = z + (hs3 - z) * t[..., None]
                bloq |= corta[..., None] & (h < self.ph[:, j][:, None, None])
        return bloq
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
