brahianorrego/Talos-AI/(commit log)

2026-10-17 Proyecto organizado: mínimo congelado, Jetson, simulación RL y guías
    Primer commit del repositorio Dron-IA-Vigilancia. Es la copia organizada de
    Tesis-IA-Drone (que queda como archivo histórico) en carpetas 01 a 08:
    mínimo indispensable congelado con huellas SHA-256, código de a bordo de la
    Jetson, simulación y entrenamiento PPO (V15), guías, ver_redes.py y los
    diagramas del documento. Sin modelos pesados, documento privado ni fotos con
    personas.
    [barrido_v10-master.csv, minimo_tesis_decisor_ia.csv, minimo_tesis_degradadas.csv, minimo_tesis_protocolo.csv]
2026-10-17 README completo con fotos del montaje, diagramas y resultados
    13 fotos del dron (montaje por etapas, dron armado y pesaje), sin metadatos
    ni GPS. Las del parqueadero quedan fuera de Git (placa y lugar de residencia).
    README con mínimo y plus separados, resultados del protocolo y del decisor
    con su fuente, paso a paso físico, historial de versiones y cómo reproducirlo.
2026-10-17 Portada visual, captura del simulador y guía para colaborar
    Banner 1280x640 (también sirve de vista previa social), insignias, cifras
    clave, captura del visor 3D, sección "¿Quieres ayudar?" con hoja de ruta,
    CONTRIBUTING.md y plantillas de issues. Peso total 2 371 g y paso 3
    programado para el sábado 17 de octubre.
2026-10-17 Equipo de sesiones para el plus y división del trabajo entre cuentas
    Aquí solo simulación y plus; físico, mínimo y documento en la nube de Tania.
    Tablero docs/EQUIPO_Y_SESIONES.md, ideas de Brahian del 16 de octubre y
    agentes con las rutas nuevas.
2026-10-17 Plan V17: diagnóstico medido de la V15 (la IA no aporta), criterio medible y misión de la cancha
    - informes/diagnostico_v17_ia_aporta.md y herramientas/medir_ia_aporta.py: V15 vs solo reglas y azar
    - informes/barrido_v15: escenarios fijos con los checkpoints de modelos_v15
    - docs/PLAN_V17_REFUERZO.md, ENCARGO_SIMULACION_V17.md y dibujo de la zona; D-049 a D-054 abiertas
    [barrido_v15.csv]
2026-10-17 D-055 y D-056 (hardware del plus) abiertas y pedidos a la parte física
2026-10-17 Hardware y variantes: matriz A-F, configs de simulación, piezas OpenSCAD y nota de paneles de 2 m
    [pan_tilt_servos.scad, soporte_camara.scad, soporte_lidar.scad]
2026-10-17 Plan del motor gráfico, medición del visor V16 y boceto de la estación de tierra
2026-10-17 Tablero: entregas de Visor y Hardware; D-057 y D-058 abiertas; visor-v16 en launch.json
2026-10-17 Revisión de licencias del visor V16
2026-10-17 Supervisor nocturno: primer resumen para Brahian
2026-10-17 Cancha V17 (D-051) como vista previa en el visor V16 y generar_texturas.py
2026-10-17 Blender 5.2.2 LTS instalado para los videos (D-057)
2026-10-17 Paquetes CC0 de Quaternius probados en Blender: personajes, 86 animaciones y naturaleza
2026-10-17 V17: cancha (2 V), 7 botones, evasión por regla, MaskablePPO, línea base B0/B1/B2 y reglas del ladrón
    Trae la V16 (rama v16-simulacion del repo viejo) y arregla la regla dura
    "humano en el lazo" (el "sigue igual" del operador también amarra el tracker).
    133 pruebas pasan. Hallazgo: B0, B1 y B2 empatan y la red colapsa a QUEDARSE
    en el humo; las corridas de 10 M quedan listas sin lanzar (docs/PROGRESO_V17.md).
    [control.py, entorno.py, entrenar_master.py]
2026-10-17 V17: medición de los 7 botones fijos, tabla de equivalencias de las variantes y LANZAR_V17.bat
2026-10-17 D-059 abierta: métrica principal y recompensa de la V17
2026-10-17 V17: corrida todo 10M en marcha, análisis de botones fijos y opciones para Brahian
2026-10-17 Personas vestidas de Quaternius con 41 animaciones redirigidas en Blender
2026-10-17 Limpieza de prueba_vestidos.py
2026-10-17 V17: cmd y arb en foto() para la vista del dron del visor, con prueba
2026-10-17 CLAUDE.md: decisiones del plus sin cuadros de pregunta e instalación de programas oficiales (D-060)
2026-10-17 Hardware y variantes: guía para Brahian, dibujo C/D, STL compilados, TF03 a −3°
    [pan_tilt_base.stl, pan_tilt_cuna.stl, pan_tilt_plataforma.stl, pan_tilt_servos.scad, soporte_camara.scad, soporte_camara_abajo.stl, soporte_camara_frente.stl, soporte_lidar.scad]
2026-10-17 Supervisor: entrega de Hardware en el resumen
2026-10-17 V2: personas vestidas con animaciones en el visor y V6: video de la cancha V17 en Blender
2026-10-17 V4: interfaz de 3 modos (dron, tierra, ingeniería) con mapa de puntos del LiDAR y órdenes de la Jetson
2026-10-17 Pestaña 1 Dron: usa cmd y arb de foto() (V17, commit af10c30)
2026-10-17 V17.1 (D-059 A, D-064): M1 = racha de 30 s, bono y potencial de racha, R6 apagada en la cancha, TF03 a -3°, B3
    Con la recompensa nueva, siempre SUBIR cobra más que siempre QUEDARSE (24.1 contra 20.4).
    134 pruebas pasan.
2026-10-17 unir_video.py: corrige strips de Blender 5 (el video de la cancha V17 quedó armado)
2026-10-17 V3: árboles y pasto de Quaternius en el visor (134 cps en alta con la RTX)
2026-10-17 V5: simulación en vivo en el visor (en_vivo.py + ABRIR_EN_VIVO.bat)
2026-10-17 Revisión de las entregas del Visor y de Hardware (17-oct)
2026-10-17 Hardware y variantes: prueba de banco del tilt en la guía
2026-10-17 Regla dura 4 visible: la caja del candidato dice que confirma el operador
2026-10-18 D-065: el visor vuelve al aspecto de la V16; Quaternius queda como opción apagada
2026-10-18 V17: resultado de la V17.0 (colapso a QUEDARSE), V17.1 en marcha y D-063 (margen de 0.5 m sobre la altura segura)
2026-10-18 D-065: estación de tierra con paneles movibles, vistas Solo 3D / Solo lo que ve el dron / Todo y simulación en vivo
2026-10-18 PLAN_UNREAL.md: pasos para instalar Unreal 5.8 y cómo se conecta con foto() y la estación (D-065)
2026-10-18 Estación: solo misión V17, custodia del ladrón en vez del duelo, vista principal intercambiable (dron, mapa, 3D) y SLAM sobre la cámara
2026-10-18 D-066: paneles de 1.5 x 2.25 m según Brahian; dibujo y plan actualizados
2026-10-18 Pedidos: medidas de paneles según D-066
2026-10-18 V17.2: suavidad x0.1 en la cancha y entropía 0.01 (la V17.1 colapsó a QUEDARSE); V17.2 de 10 M en marcha
2026-10-18 LEEME: capturas de la estación
2026-10-18 D-066: paneles de 1.5 m y 2.2-2.3 m (medidas de Brahian)
2026-10-18 D-066: queda solo la fila del Supervisor (era doble)
2026-10-18 D-066: paneles de 1.5 x 2.25 m en la vista previa de la cancha y en el video de Blender
2026-10-18 V17.2: resultado a 10 M (ya no colapsa; empata con B0-B3), sigue hasta 50 M; --gamma para la V17.3
2026-10-18 V17.2 a 50 M (supera a B0, no a B3; vaivén de altura) y V17.3: paneles reales D-066 y suavidad vertical
2026-10-18 PROGRESO_V17: hora real de inicio de la V17.3
2026-10-18 Encargos del 18-oct: Hardware (variante C), repeticiones para Unreal y medición de la V17.3
2026-10-18 Hardware y variantes: soporte del TF-Luna para el pod, calibración del servo D, validador contra la simulación, peso/CG y alcance del Luna
    [soporte_luna_pod.scad, soporte_luna_pod.stl]
2026-10-18 Pedidos: color de los paneles (alcance del TF-Luna)
2026-10-18 D-067: plan tras la V17.2 a 50 M (B4, compuerta y V17.4); diagnóstico de supervisor-rl
2026-10-18 Fotos de referencia: dron actual, gimbal con TF03 y cámara USB (para el modelo 3D del motor gráfico y las piezas)
2026-10-18 Unreal 5.8: proyecto DronIA_Cancha, cancha V17 con paneles D-066, importar repetición, render y guía para Brahian
2026-10-18 Hardware y variantes: soportes según las fotos reales, vistas PNG y VISTA_3D.html
    [soporte_luna_pod.scad, soporte_luna_pod.stl, soporte_tf03_colgante.scad, soporte_tf03_colgante.stl]
2026-10-18 Modelo 3D del dron real (fotos de Brahian) en Unreal, Blender y el visor V16, con la lista de medidas que faltan
2026-10-18 Fichas técnicas de dimensiones del TF03 y del TF-Luna
2026-10-18 El dron real en la estación de tierra, con pruebas del modelo
2026-10-18 D-067: regla B4 y B4* (altura por cobertura), vaivén de la red y altura pedida cerca de la V; ajuste de umbrales con la semilla 7
2026-10-18 Hardware y variantes: soportes del TF-Luna y del TF03 con las medidas de las fichas oficiales, vistas y visor regenerados
    [soporte_lidar.scad, soporte_lidar_luna_pantilt.stl, soporte_lidar_tf03_chasis.stl, soporte_luna_pod.scad, soporte_luna_pod.stl, soporte_tf03_colgante.scad, soporte_tf03_colgante.stl]
2026-10-18 Entorno de la universidad: especificación con medidas de Google Earth, campus en la estación web y tecla T para volar entre las canchas
2026-10-18 Pruebas del entorno sin avisos de sintaxis
2026-10-18 D-067: compuerta B4/B4* cerrada (ni el oráculo le gana a siempre SUBIR); V17.3 colapsó
2026-10-18 Hardware y variantes: rediseño estético del pan-tilt y visor 3D del montaje completo
    [asm_base.stl, asm_cuna.stl, asm_plataforma.stl, pan_tilt_base.stl, pan_tilt_cuna.stl, pan_tilt_plataforma.stl, pan_tilt_servos.scad, pan_tilt_servos_v1.scad]
2026-10-18 Campus de la universidad en Unreal desde la misma especificación, con el vuelo entre canchas
2026-10-19 D-068: cierre de la V17 en altura y afinado en la cancha real
2026-10-19 Plan de la noche del 19-oct con el número que decide cada paso
2026-10-19 Borrador de la sección del plus para el documento del proyecto de grado
2026-10-19 D-069 registrada (D-059 C reversible con PERDIDA_IA) y plan de la noche ajustado
2026-10-19 Hardware y variantes: módulo colgado bajo el chasis, rango ancho solo como capacidad mecánica, visor actualizado
    [asm_plataforma.stl, asm_plataforma_ancho.stl, pan_tilt_plataforma.stl, pan_tilt_plataforma_ancho_NO_APROBADA.stl, pan_tilt_servos.scad, pan_tilt_servos_v2_recto.scad]
2026-10-19 Capturas de la partida V17 renderizada en Unreal (video fuera de Git)
2026-10-19 V17.3 a 10 M (= B0, colapsó), vaivén de la V17.2 separado y herramienta de repeticiones escogidas (D-065)
2026-10-19 Maniquies Manny y Quinn de Unreal en lugar de cilindros: posturas de foto() con animaciones de la plantilla y poses a mano
2026-10-19 grabar_repeticiones_v17: --tipos y LEEME armado con lo que hay en la carpeta
2026-10-19 D-069/D-070: la red decide en la PÉRDIDA (PERDIDA_RED_V17, reversible); V17.2 en la cancha real; V17.4 en marcha
2026-10-19 D-071: ruta de búsqueda de Brahian como consejos, con diagrama y criterio de aporte
2026-10-19 Hardware y variantes: análisis geométrico de cobertura por variante
2026-10-19 README: sección del plus con la V17, capturas y ruta de búsqueda (solo local); sección para el documento; plan de GitHub con lo que Brahian aprueba
2026-10-19 D-071: ruta de búsqueda de Brahian (B5) como búsqueda determinista alternativa, apagada por defecto, con prueba
2026-10-19 Hardware y variantes: soporte de dos cámaras CSI con medidas oficiales del IMX219, presupuesto de potencia y lista para Brahian
    [soporte_camara.scad, soporte_camara_abajo.stl, soporte_camara_frente.stl, soporte_camara_v1.scad, soporte_csi_doble.stl]
2026-10-19 Hardware y variantes: soporte CSI doble en el visor y nota de fuentes
2026-10-19 Mision completa de punta a punta: despegue, transito con el minimo (panel, arbol, persona), activacion CH7 y zona de IA, en la estacion web y en la secuencia de Unreal
2026-10-19 V17.4 a 8 M: D-069 sube +2.9 (no se queda); B5 ruta de Brahian no le gana a B3; V17.5 en marcha desacoplada
2026-10-19 Estacion: vista del dron con tres camaras (USB, CSI frontal, CSI piso) y LiDAR 360; ruta de busqueda de Brahian dibujada en la estacion y en Unreal
2026-10-19 D-071 cerrada: la ruta de Brahian (B5, 3.0 m) no supera a siempre SUBIR (22.7 contra 24.6 %)
2026-10-20 Estado físico: lista de cambios del simulador para parecerse a la variante G
2026-10-20 README: mínimo (G) y plus (H) separados; D-074 y D-073 ajustadas (pan libre, tope de pan por fijar)
2026-10-20 Fotos del dron como quedó el 20 oct (sin gimbal, CSI y TF03 fijos, batería abajo)
2026-10-20 D-075: TF03 fijo y TF-Luna en el pan-tilt en el plus; estado físico y sección del documento actualizados
2026-10-20 D-073: dos drones seleccionables, minimo (CSI fija) y plus (pan-tilt de 2 servos animado con CSI, TF-Luna y CSI al piso), en el modelo 3D, la estacion y Unreal
2026-10-20 Hardware y variantes: pan-tilt rediseñado para CSI + TF-Luna, opciones de montaje y visor 3D de la variante H
    [asm_base.stl, asm_cuna.stl, asm_plataforma.stl, asm_plataforma_ancho.stl, pan_tilt_base.stl, pan_tilt_cuna.stl, pan_tilt_plataforma.stl, pan_tilt_plataforma_ancho_NO_APROBADA.stl]
2026-10-20 Plus por omision en la estacion y Unreal: pan-tilt parqueado en 0/-5 en el transito y moviendose en la zona; TF03 al lado derecho; posicion del pan-tilt provisional
2026-10-20 Hardware y variantes: lista para Brahian actualizada para las variantes G y H
2026-10-20 D-072: línea base con la cámara fija (B0 3.7 %, B3 0.8 %, B5 1.8 %), V17.6 en marcha vía WMI
2026-10-20 Hardware y variantes: pan-tilt H con giro y cabeceo (topes, flex, montaje), JSON con pan libre, cobertura, par y lista
    [asm_base.stl, asm_cuna.stl, asm_plataforma_ancho.stl, asm_plataforma_arriba.stl, asm_plataforma_colgado.stl, pan_tilt_base.stl, pan_tilt_cuna.stl, pan_tilt_plataforma_ARRIBA.stl]
2026-10-20 Modelo plus: posiciones del pan-tilt, CSI del piso, TF03 y bateria leidas de variante_H.json (Hardware)
2026-10-20 Plus: pan-tilt ARRIBA por omision (opcion 1 de Hardware) y colgado como interruptor (DRONIA_PAN_TILT=abajo, ?pantilt=abajo)
2026-10-20 D-075: variante H del plus (--hw H): pan-tilt de servos con CSI 62.2x48.8 y TF-Luna, pan por regla, TF03 a -5, CSI al piso; G queda para el mínimo
2026-10-20 D-075: medición en H (pan-tilt): B0 62.3, B3 78.3, B5 92.0, V17.2 72.7 %; V17.7 en H con la ruta de Brahian
2026-10-20 H: ruta de Brahian + QUEDARSE (B5s) 87.3 %
2026-10-20 V17.7 (H + ruta de Brahian): M1 91.0 %, empata con B5 (92.0) y supera a B3 (78.3); repeticiones con --hw
2026-10-20 Clip del plus con pan-tilt en Unreal, repeticion H en la estacion, nota con capturas y camara cercana opcional
2026-10-20 PROGRESO_V17: repeticiones de la V17.7 en H (4 de 5; el salto no sale en 80 partidas)
2026-10-20 foto(): pan y pan_meta del pan-tilt (D-075) para la estación y Unreal, con prueba
2026-10-20 V17.8: la red apunta el pan en la búsqueda (PAN_RED_V17), multa al vaivén de altura; perillas de robustez
2026-10-20 Robustez de B5 y V17.7 en H (83-94 %), desglose del pan (+37 / +32), V17.8 en marcha
    [rob_d_servos.json]
2026-10-20 Hardware y variantes: recomendación de inclinación de la CSI#2 al piso
2026-10-20 Estacion: sin LiDAR 360; mapa de los dos LiDAR de 1 haz (TF03 fijo y TF-Luna del pan-tilt) con puntos acumulados
2026-10-20 Estacion: camara del piso nitida (el panel desenfocaba la imagen 3D); lineas de la cancha como geometria y detalle fino del pasto
2026-10-20 Paneles delgados de 5 cm (2.30 x 1.50 m) en la estacion y Unreal; la ruta de Brahian usa la boca real de cada V (90 a ~170 grados)
2026-10-20 D-076: órdenes de Brahian del 20-oct (una línea)
2026-10-20 Hardware y variantes: combinación de sensores a 1.7-2.6 m; CSI#2 pasa a mirar atrás en variante_H
2026-10-20 Estacion: sin vuelo entre canchas ni tecla T; selector de lugar (cancha de futbol o de tenis); tenis con malla de 10 m, malla divisoria, pisos de colores y hangar fuera de la malla
2026-10-20 Arboles con Sapling Tree Gen de Blender (hojas y corteza, 6 especies) en la estacion web
2026-10-20 Arboles de Sapling en Unreal: importador, texturas y uso en el campus y la mision
2026-10-20 Edificios: hiladas de ladrillo con mortero, dinteles, marcos, divisiones, alfeizares, zocalo y cornisa (estacion y texturas de Unreal)
2026-10-20 Estacion: sin rastro de LiDAR 360 en textos (dos LiDAR de 1 haz)
2026-10-20 Modo Ensenar (tecla E): mapa con puntos de paso y rumbo, manual con teclado/gamepad, grabar demostracion (en_vivo.py POST); Vuelo real reordenado; mision agrupada; sin boton Dron ni Cine/Cenital/Inge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
2026-10-20 en_vivo: el dron del Modo Ensenar lo lleva el control del operador de entorno.py (set_manual/set_objetivo) y se guarda tambien el .npz de la Simulacion
2026-10-20 Unreal en vivo: puente_unreal.py (SSE->UDP) y unreal/vivo_unreal.py (dron, pan-tilt, personas y paneles interpolados); medir_fps.py; VIVO_UNREAL.bat. Medido 60 fps con la partida en vivo
2026-10-20 Enseñar: camara asistida (/camara -> env.set_camara) y gamepad (palancas, LB/RB y cruceta para el pan)
2026-10-21 Medicion de fps (720p y 1080p), capturas reales de Unreal en vivo y del mapa de Ensenar, endpoint de captura de la estacion, camara por archivo en vivo_unreal
2026-10-21 vivo_unreal: todo (paneles, personas, animaciones) se crea una vez y solo se mueven transformaciones (evita el assert VertexFactory); prueba de Ensenar con punto cercano; vz manual
2026-10-21 Material para el documento: cronología, errores y lecciones, métodos, índice de imágenes, motor gráfico y juego, anexos
2026-10-21 Material para el documento: el script del driver pl2303 no está en el repositorio
2026-10-21 Material para el documento: línea de tiempo de lo que pidió y corrigió Brahian, caída de Unreal, D-081 y fotos de la universidad
2026-10-21 Unreal: suelos con textura (adoquin, losas con pasto, rejilla), cancha de tenis de colores, luminarias, setos, canecas, base azul del motor, modo noche (DRONIA_NOCHE=1), rehacer nivel con respaldo, c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
2026-10-21 Unreal: campus con texturas (adoquin, losas con pasto, rejilla), plaza y camino reubicados, personas creadas de a una (evita el crash), -unattended y vigilante del Crash Reporter, fotos de verificaci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
2026-10-21 Fotos del campus de dia y de noche en Unreal; nivel de dia reconstruido
2026-10-21 Pendientes de Brahian de la noche (MetaHuman, fotos, gamepad)
2026-10-21 Una sola pantalla: VIVO_UNREAL.bat pone Unreal (60 %) y la estacion en modo Ensenar (40 %) lado a lado; acomodar_ventanas.ps1 (verificado: Unreal 0-922 px y Edge 922-1536 px en 1536x864)
2026-10-21 Fachada de vidrio en bandas con franja naranja (laboratorio)
2026-10-21 Unreal: fachadas nuevas aplicadas al reconstruir (vidrio con franja naranja y ladrillo con mortero y marcos); fotos de comprobacion
2026-10-21 Enseñar: boton central arrastrado = pan/tilt, clic derecho = soltar_sospechoso, prueba real de fijar y soltar a una persona a la vista (PERSECUCION -> VERIFICAR)
2026-10-21 V17.9: paneles de 5 cm y 2.30 m, V de 120-175 con la cancha girada, altura base 2.0 m con despeje, ruta B5', CSI 68.3x54.0 y TF03 -6.7; control del operador (manual, punto, ruta, camara, altura, fija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
2026-10-21 Unreal: turbina con anillos azul/gris, tobera y marco amarillo; halos de luminarias en el modo noche; nivel de dia reconstruido
2026-10-21 Maniquies en vivo: agacharse, caminar agachado, recostarse, gatear y saltar (tramos de la animacion de la galeria recorridos por tiempo; salto con altura real); prueba de la logica; candidatos de fij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
2026-10-21 Estacion web: fachada de vidrio con franja naranja en el laboratorio
2026-10-21 Material para el documento (motor grafico y juego: fps, teclas, pruebas, capturas), manual corto del juego, G reinicia con Puntos/Manual, capturas del juego en vivo
2026-10-21 REANUDAR_ENTRENAMIENTO: baja tambien la prioridad del proceso hijo de python
2026-10-21 Vista del dron: imagen real de Unreal (SceneCapture CSI#1 68.3x54 con -2.4 y pan/tilt, CSI#2 al piso), telemetria de operacion superpuesta, CSI#2 en cuadro pequeno, atajo Tab centinela/dron, una sola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
2026-10-21 Ordenes de Brahian: seccion G (juego, controles teclado y mouse, vista del dron)
2026-10-21 Ambiente realista: texturas PBR CC0 de Poly Haven bajadas, causa de la cola atascada del Launcher y pasos de Brahian para MetaHuman/Fab (PENDIENTES)
2026-10-21 Interfaz de operacion unica (operacion.html): camara principal con HUD discreto, 3 casillas fijas (CSI#2, mapa LiDAR, telemetria con actitud y minimapa), barra minima, menu de ajustes (Esc), mapa tac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
2026-10-21 Marca: el dron se llama TALOS-AI (constante NOMBRE_DRON)
2026-10-21 Interfaz TALOS-AI rediseñada: HUD tipo PFD, tarjetas de telemetría con tendencias, registro de eventos, barra superior y pie de estado; sin scroll en 1920x1080 y 1366x768
2026-10-21 CSI#2 en 4:3 y tamano real (~450x340 en 1920x1080), cuadricula de distancia (K) y modo pantalla grande (X)
2026-10-21 Visor: interfaz en negro, PFD sobrio, mapa satelital georreferenciado, pestana Entrenamiento, campus medido sobre vista satelital, paneles con marco negro, materiales y arboles de Fab; nota de cierre
2026-10-21 Rendimiento: Unreal minimizado y una sola ventana (49 fps medio con 2 camaras), arboles Megaplant sin animar, consola de pruebas; plaza del avion; sondas de MetaHuman
2026-10-21 Estacion: ayuda de cada dato (tooltips y menu), vista Mundo 3D dentro de la estacion con tercera camara de Unreal bajo demanda
2026-10-21 Personas realistas (Survival: ladron de chaqueta oscura y mochila; Quantum: civiles de camisa clara) fusionadas en una malla, brillo corregido en Unreal (gamma 2.0), capturas a 8/2.5 Hz y estacion a 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
2026-10-21 Personas realistas conectadas y medidas (47.5 fps medios, 2 camaras), lanzador que cierra copias viejas, documentacion del rendimiento y creditos
2026-10-21 Cesped PBR unico (campo con franjas, terreno con variacion), paredes de edificios con ladrillo (se borraba la instancia de la primera pared al rehacer), techos de concreto; auditoria por script: 0 ac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
2026-10-21 Historial del motor de Unreal (pausado): que se construyo, pendientes y como reanudarlo
2026-10-22 Mínimo: campo del 21-oct, estación del mínimo, calibración respecto al chasis y re-simulación
    - Primeras tomas reales (E1, E2, E3, E4): LiDAR contra la cinta +0.02 a +0.16 m; YOLO 82 % a 15 m, 94 % a 12 m. Informe y procedimiento replicable en docs/.
    - Hallazgo (D-082): los ángulos del montaje estaban medidos respecto al horizonte; respecto al chasis el LiDAR es ~-9.0° y la cámara ~-5.6°.
    - Estación de tierra del mínimo (04_VISOR_Y_MOTOR_GRAFICO/estacion/minimo.*): video 1280x960, LiDAR sobre la imagen, inclinación, GPS y mapa, control de tomas, calibración dentro de la estación.
    - Código actual de la Jetson sin gimbal en 02_JETSON_A_BORDO/minimo_sin_gimbal/ (sin seriales ni r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
    [minimo_tesis_decisor_ia.csv, minimo_tesis_degradadas.csv, minimo_tesis_protocolo.csv]
2026-10-22 Repositorio renombrado a Talos-AI: README, CLAUDE.md y plan de GitHub
